ahmet6141/Drone-controller/config/px4/README.md

# PX4 v1.17 parametreleri

Tüm adlar, tipler, aralıklar ve enum değerleri resmi PX4 v1.17 parametre referansına göre
doğrulanır (`python3 tools/validate_params.py`; referans: `tools/data/px4_v1.17_params.json`).

## Yükleme sırası
1. QGroundControl → **Airframe**: *Generic Quadcopter* (`SYS_AUTOSTART=4001`) → yeniden başlat.
2. **Actuators** ekranı: çıkış protokolü **DShot600**, motor sırası ve yönleri (motor testi ile).
3. Parameters → Tools → *Load from file* — sırayla:
   1. `base/10-airframe-dc7.params` — geometri, DShot/RPM, filtreler, hover itkisi
   2. `base/20-position-control.params` — konum/hız kazançları, sınırlar, iniş
   3. `base/30-failsafe.params` — RC/link kaybı, batarya, geofence, RTL
   4. `base/40-companion-io.params` — uXRCE-DDS (TELEM2), MAVLink (TELEM1), DroneCAN akış
   5. **Bir** profil: `profiles/outdoor-gnss.params` **veya** `profiles/indoor-vio.params`
4. Kalibrasyonlar: ivmeölçer, pusula (+ akım tabanlı kompanzasyon `CAL_MAG_COMP_TYP`), ESC,
   RC; IMU sıcaklık kalibrasyonu önerilir.
5. Ölçülen montaj ofsetlerini girin: `EKF2_IMU_POS_*`, `EKF2_GPS_POS_*`, `EKF2_OF_POS_*`,
   `EKF2_RNG_POS_*`, `EKF2_EV_POS_*` (ağırlık merkezine göre, metre).

## Seviye farkları
| Konu | Seviye A — Ekonomik (Raspberry Pi) | Seviye B — Pro (bu dosyalar) | Seviye C |
|---|---|---|---|
| FC | ARK FPV (ayrı, 30×30) | ARKV6X (ARK Jetson PAB V3 yuvasında) | ARKV6X (PAB) |
| Çoklu IMU | tek IMU | `EKF2_MULTI_IMU=3`, `SENS_IMU_MODE=0` ekleyin | aynı |
| Companion bağlantısı | Pi 5 UART0 (TELEM2, DDS) + UART3 (TELEM1, MAVLink) | PAB V3 iç UART veya Ethernet (`UXRCE_DDS_CFG=1000`) | aynı |
| Akış/lazer | MicoAir MTF-01 (UART, MAVLink): `UAVCAN_SUB_FLOW/RNG` gerekmez, akış için bir MAVLink örneği (`MAV_1_CONFIG`) | H-Flow (DroneCAN) | ARK Flow MR (DroneCAN) |
| GNSS | M10 (`EKF2_GPS_CTRL=7`) | F9P RTK | X20 RTK |
| İç mekân profili | VIO yok → `indoor-vio` yerine `EKF2_EV_CTRL=0`, `EKF2_HGT_REF=0` (baro) | `indoor-vio` | `indoor-vio` |
| Hover itkisi | `MPC_THR_HOVER` ≈ 0.17 | 0.20 | 0.20 |
| Gimbal | Pi'den STorM32 (UART) — PX4'e bağlı değil (`MNT_MODE_IN=-1`) | Jetson'dan (USB-UART) | aynı |

## Seviye A seri port planı (ARK FPV)

ARK FPV'de dört çift yönlü UART vardır (GPS1, RC, TELEM1, TELEM2). TELEM3 ve TELEM4 **yalnızca veri alır**
(TX pini dışarı çıkmaz). Kaynak: PX4 v1.17 kart tanımı (`boards/ark/fpv/default.px4board`) ve ArduPilot ARK FPV
sayfası.

| PX4 portu | Soket (UART) | Bağlı | Parametre |
|---|---|---|---|
| GPS1 | GPS (USART1) + I2C | M10 GNSS + pusula | `GPS_1_CONFIG=201` |
| RC | RC (USART6) | ELRS XR4 (CRSF) | `RC_CRSF_PRT_CFG=300` |
| TELEM1 | TELEM (UART7, akış kontrollü) | Pi 5 UART3 — MAVLink | `MAV_0_CONFIG=101` |
| TELEM2 | HD VTX (UART5) | Pi 5 UART0 — uXRCE-DDS | `UXRCE_DDS_CFG=102` |
| TELEM4 | ESC soketindeki telemetri pini (UART4, yalnız RX) | MTF-01 (yalnızca gönderir). ESC'nin telemetri teli bağlanmaz; RPM çift yönlü DShot'tan gelir | `MAV_1_CONFIG=104`, `SER_TEL4_BAUD=115200` |
| TELEM3 | HD VTX soketindeki SBUS pini (USART2, yalnız RX) | boş | — |
| CAN1 | CAN | Remote ID (DroneCAN: Holybro Remote ID veya Cube ID) | `UAVCAN_ENABLE=2` |
| Motor 1–4 | ESC | Tekko32 F4 (AM32) | DShot600, `DSHOT_BIDIR_EN=1` |

Gimbal kontrolcüsü (STorM32), 8×8 ToF ve kameralar Pi'ye bağlanır; FC'den port istemez.

## Remote ID
`base/30-failsafe.params` içinde `COM_ARM_ODID=1`: Ar-Ge aşamasında Remote ID modülü yoksa yalnızca
uyarı verir. Operasyonda `2` (modülsüz kalkış yok) yapılır. PX4 belgesindeki modüller: Holybro Remote
ID ve Cube ID (seri veya CAN), BlueMark Db201/Db202mav (seri). TELEM2 DDS'e ayrıldığından seri modül
başka bir porta (`MAV_2_CONFIG`) bağlanır. **Seviye A'da (ARK FPV) boş çift yönlü seri port kalmaz** (yukarıdaki
plan): modül CAN'e bağlanır (DroneCAN, `UAVCAN_ENABLE=2`) (`config/sensors/catalog.yaml`).

## Sürüm notları (PX4 v1.18'e geçerken)
v1.18.0-rc1 (10.09.2026) kararlı değildir. v1.18'de değişecekler (kaynak: PX4 v1.18 sürüm notları):
- `DSHOT_BIDIR_EN`, `MOT_POLE_COUNT` → çıkış başına protokol ve `DSHOT_MOT_POL1..12`
- `COM_RC_OVERRIDE` / `COM_RC_STICK_OV` → `MAN_OVERRIDE_SPD`
- `EKF2_GPS_POS_*` / `EKF2_GPS_DELAY` → alıcı başına parametreler
- Yeni: `EKF2_SENS_EN`, Vision Target Estimator (`VTE_*`)

Geçişte `tools/data/` altına v1.18 referansı eklenip dosyalar yeniden doğrulanmalıdır.
