ahmet6141/Drone-controller/docs/02-donanim-analizi.md

# 02 — Donanım Analizi ve Seçim

Durum tarihi: **2 Ekim 2026**. Fiyatlar yaklaşık (USD) ve değişkendir; NVIDIA Temmuz 2026'da
Jetson fiyatlarını %101'e varan oranda artırdı. Seviyelerin tam bileşen listeleri ve kütle/güç
değerleri [`config/hardware/`](../config/hardware/) altındadır; bütçe tablosu
`tools/budget_calc.py` ile bu dosyalardan üretilir.

## 1. Özet: üç donanım seviyesi

| Bileşen | **Seviye A — Ekonomik (Raspberry Pi)** | Seviye B — Pro (Jetson) | Seviye C — Üst Seviye |
|---|---|---|---|
| Gövde | GEPRC MOZ7 V2 (336 mm) + tam koruma/ağ + avuç tutamağı | ← aynı | ← aynı |
| Motor / pervane | EMAX ECO II 2807 1300KV / HQ 7×4×3 | T-Motor F90 2806.5 1300KV / HQ 7×4×3 | ← B |
| ESC | Tekko32 F4 50A (AM32) | Tekko32 F4 Metal 65A (AM32) | ARK 4IN1 50/75 A |
| Batarya | 6S1P Molicel P50B (5 Ah, 451 g) | ← aynı | ← aynı (dayanım: 6S2P) |
| Uçuş kontrolcüsü | ARK FPV (H743, endüstriyel IMU + ısıtıcı) | ARKV6X (3 IMU, PAB yuvasında) | ← B |
| Companion | **Raspberry Pi 5 8GB + AI HAT+ 2 (Hailo-10H)** | Jetson Orin NX 16GB + ARK Jetson PAB V3 | Orin NX 16GB (MAXN SUPER) + PAB V3 |
| Gimbal | **Kendi tasarımımız 2 eksen** (STorM32) — docs/10 | ← aynı | ← aynı |
| Gimbal kamerası | **Pi Camera Module 3** (66°) | IMX219 (Pi Camera Module 2 / eşdeğeri) | ← B |
| Aşağı kamera / ToF | **Camera Module 3 Wide** / VL53L8CX 8×8 | OV9281 global shutter / VL53L8CX | ← B |
| Baş üstü ToF | VL53L1X | VL53L1X | VL53L1X |
| Stereo (VIO + engel) | — | OAK-D Lite | OAK-D Pro W (150°) |
| Akış + lazer | MicoAir MTF-01 (akış + 8 m lazer, UART) | Holybro H-Flow (DroneCAN) | ARK Flow MR (DroneCAN) |
| GNSS / pusula | Holybro M10 | H-RTK F9P Ultralight + RM3100 | ARK X20 RTK + ARK MAG |
| RC | TX15 + XR4 (ELRS 4.1) | TX16S MK3 + XR4 | ← B |
| Video/veri linki | WFB-ng (açık kaynak) | SIYI HM30 | Doodle Labs mini-OEM (mesh) |
| Uçuş yığını | PX4 v1.17 | PX4 v1.17 | PX4 v1.17 |

Kameralar artık hazır gimbal kamera (SIYI A8 mini) yerine **Raspberry Pi kameraları + kendi
tasarımımız gimbal** (ayrıntılar ve gerekçeler: [10](10-kamera-gimbal-ve-sensorler.md)). Pi
kameralarıyla en uyumlu ve en ucuz yol Raspberry Pi 5'tir; Jetson'da NVIDIA'nın belgelediği Pi
kamerası IMX219'dur ve 22 pin FFC girişli taşıyıcı (ARK Jetson PAB V3) gerekir.
**Önerilen başlangıç: Seviye A.**

## 2. Ağırlık, güç ve uçuş süresi bütçesi

`python3 tools/budget_calc.py --all --markdown` çıktısı (F90 itki verisi, log-log enterpolasyon,
koruma/gövde kaybı %10, kullanılabilir enerji %85, yük altında gerilim %90):

| Metrik | tier-a-ekonomik | tier-b-pro | tier-c-ust |
|---|---:|---:|---:|
| AUW (g) | 1456 | 1683 | 1659 |
| Batarya (g) | 451 | 451 | 451 |
| Maks itki (g) | 8500 | 8500 | 8500 |
| T/W (motor) | 5.84 | 5.05 | 5.12 |
| T/W (batarya sınırlı) | 2.77 | 2.37 | 2.40 |
| Hover itkisi/motor (g) | 364 | 421 | 415 |
| Hover verimi (g/W) | 5.76 | 5.42 | 5.45 |
| Hover gazı (MPC_THR_HOVER) | 0.17 | 0.20 | 0.20 |
| Hover gücü (W) | 275 | 354 | 355 |
| Hover akımı (A) | 12.7 | 16.4 | 16.4 |
| Hover süresi (dk) | 20.1 | 15.6 | 15.5 |
| Karma uçuş (dk) | 17.0 | 13.2 | 13.2 |
| Ek yük payı (g) | 379 | 132 | 149 |
| THR_MDL_FAC (tahmini) | 0.53 | 0.53 | 0.53 |
| Maliyet: hava aracı (USD, ≈) | 1,488 | 4,906 | 6,720 |
| Maliyet: yer ekipmanı (USD, ≈) | 240 | 200 | 1,505 |
| Limit kontrolleri | ✅ | ✅ | ✅ |

- **Korumanın bedeli**: koruma ve ağ olmadan Seviye A 1346 g / 23,8 dk, Seviye B 1573 g / 18,1 dk
  → koruma ≈ 2,5–3,5 dk.
- **Dayanım seçeneği** (Seviye C, 6S2P P50B, 902 g): AUW 2110 g, hover **23,0 dk**, batarya
  sınırlı T/W 2,83. Ağırlık nedeniyle bu yapılandırmada avuca iniş yalnızca işaretli pedle önerilir.
- Seviye B'nin maliyeti, Pi kameraları için gereken 22 pin FFC'li taşıyıcı (ARK Jetson PAB V3 +
  ARKV6X) nedeniyle arttı; daha ucuz alternatif Holybro Pixhawk Jetson Baseboard + Pixhawk 6X
  (≈ $535 daha ucuz, ≈ 43 g daha ağır).
- T/W (motor) ≈ 5 → bol kontrol otoritesi; asıl sınır bataryanın sürekli akımıdır (60 A).
- Maliyetler yaklaşık, vergi/kargo hariç; Jetson (Temmuz 2026) ve Raspberry Pi (Şubat 2026) fiyat
  artışları sonrası.

## 3. Gövde (frame)

| Gövde | Dingil / kol | Kütle | Stack | Fiyat | Not |
|---|---|---|---|---|---|
| **GEPRC MOZ7 V2** | 336 mm / 6 mm | 270 g | 30,5 / 25,5 / 20 | ~$110 | 8 inç pervane alır → 7 inç etrafında koruma halkasına radyal yer kalır. **Tüm seviyelerde seçildi** |
| iFlight Chimera7 Pro V2 | 327 mm / 6 mm | 175 g (TPU hariç) | 21 mm yükseklik | €137 | Bazı satıcılarda tükendi; yeni Chimera7 O4 355 g |
| TBS Source One V5 7 DC | 320 mm / 6 mm | ~145 g | 30,5 / 20 | $45 | Deadcat, açık kaynak; stok sorunu |
| Foxeer MEGA 7 DC | 305 mm / 5,5 mm | 221 g | 30,5 (+ arka) | — | Deadcat |
| iFlight CineLR 7 (hazır referans) | 334 mm, H | 777 g kuru; 8 Ah Li-ion ile 1628 g | — | $740 | 800 g önerilen yük, ~25 dk hover iddiası |

- Hiçbir FPV 7 inç gövde Jetson için tasarlanmamış → **özel üst plaka** (karbon/PA12-CF) gerekli.
- **Gerçek-X (true-X)** seçildi: simetrik tam koruma, yönetilebilir ağırlık merkezi; gimbal ön
  burunda alçakta (Camera Module 3: 66° yatay FOV). `cad/layout.py` görüş kontrolüne göre pitch
  −90°…+15° arası korumalar/pervaneler kadraja girmez → yazılım sınırı +15°. Deadcat temiz görüş
  sağlar ama asimetriktir ve korumalanması zordur.

## 4. İtki

### 4.1 Motorlar (6S, 7 inç)
| Motor | KV | Kütle | Azami | Fiyat | Not |
|---|---|---|---|---|---|
| **T-Motor F90 2806.5** | 1300 | 46,6 g | 2361 g @ 45 A (HQ 7×4×3) | $30 | Ölçülmüş itki verisi var; bazı satıcılarda üretimden kalktı |
| EMAX ECO II 2807 | 1300 | 47,6 g | 2640 g (6S) | ~$22 | Ekonomik seçim |
| EMAX ECO III 2807 | 1300 | 49,6 g | 1390 W, 55 A | — | F90 alternatifi |
| Axisflying C287 2807.5 | 1350 | 47 g | 2303 g, 48,6 A | $29 | F90 alternatifi |
| iFlight XING2 2809 | 1250 | 60,7 g | 1145 W, 50 A | $40 | 7,5 inç / ağır yük |
| T-Motor 2807 (2026) | 1250 | 52,6 g | 2178 g @ 44 A (7,5 inç) | — | Yeni liste |

### 4.2 Ölçülmüş itki verisi (bütçe hesabının temeli)
T-Motor F90 1300KV + HQProp 7×4×3, 24,2 V (güç = V×I, ESC girişi):

| Gaz | İtki | Akım | Güç | g/W |
|---|---|---|---|---|
| %30 | 353 g | 2,14 A | 52 W | **6,80** |
| %50 | 948 g | 8,83 A | 213 W | 4,45 |
| %100 | 2361 g | 45,1 A | 1059 W | 2,23 |

İki kanatlı GF 7040 %30'da 320 g / 43 W (**7,39 g/W**) ile hover'da daha verimlidir; HQ 7×4×3
daha fazla kontrol otoritesi verir. Ara noktalar log-log (güç yasası) enterpolasyonla hesaplanır.
Seviye A'da ECO II için de bu eğri **vekil** olarak kullanılmıştır; itki standında doğrulanacak.

### 4.3 ESC
| ESC | Sürekli / tepe | Hücre | Firmware | Telemetri | Kütle | Fiyat | Seviye |
|---|---|---|---|---|---|---|---|
| Holybro Tekko32 F4 50A | 50 / 60 A | 4–6S | AM32 | Bidirectional DShot, ESC telemetrisi, akım sensörü | 13,8 g | $63 | A |
| **Holybro Tekko32 F4 Metal 65A** | 65 / 75 A | 4–6S | AM32 | aynı | 15,8 g | $95 | **B** |
| ARK 4IN1 | 50 / 75 A | 3–8S | ARK32 (açık kaynak) | DShot300/600 + bidir, KISS seri telemetri | 14,5 g | $218,50 | C |
| T-Motor F55A Pro III (AM32) | 55 / 65 A | 3–8S | AM32 | telemetri | 17,8 g | $150 | — |

Firmware durumu: **BLHeli_32 Haziran 2024'te sona erdi**; **AM32** aktif (v2.20–2.21, Tem–Eyl 2026:
fren modları, DroneCAN parametre kaydı); Bluejay'in son kararlı sürümü v0.21.0 (Temmuz 2024).
→ AM32 seçildi; avuca iniş için "durunca fren" açık. DroneCAN ESC bu boyutta gereksiz:
bidirectional DShot notch filtresi için en düşük gecikmeli RPM geri bildirimini verir.

## 5. Batarya

| Hücre | Kapasite | Sürekli akım | Kütle | Not |
|---|---|---|---|---|
| Molicel P45B | 4,5 Ah | 45 A | ≤ 70 g | |
| **Molicel P50B** | 5,0 Ah | 60 A | 71 g | **Seçildi (6S1P ≈ 451 g)** |
| Molicel P60B (06/2025) | 6,0 Ah | "90 A" (basın bülteni) | — | Gelecek yükseltme adayı |
| Samsung 50S | 5,0 Ah | 25 A | ≤ 72 g | Akım sınırı düşük |
| Amprius SA112 | 6,5 Ah | 13 A | 72 g | 6S1P için akım yetersiz |

- 6S1P P50B: 108 Wh nominal, hover akımı ≈ 14–17 A (hesap) → hücrenin 60 A sınırına göre rahat.
- Yedek LiPo (ör. 6S 2000 mAh, 339 g) ≈ yarı uçuş süresi; yalnızca agresif test uçuşları için.
- Uçuş kontrolcüsünde batarya akımı **45–60 A** ile sınırlanır (dört motor tam gazda ≈ 180 A çekebilir).

## 6. Companion bilgisayar

### 6.1 Platformlar
| Platform | YZ (seyrek INT8) | RAM | Güç | Fiyat (1k adet) | Değerlendirme |
|---|---|---|---|---|---|
| **Raspberry Pi 5 8GB + AI HAT+ 2** | Hailo-10H: 40 TOPS (INT4) | 8 GB + 8 GB (HAT) | ≈ 10 W (tahmini) | $175 + $200 | **Seviye A**. Pi kameraları yerel; donanım video kodlayıcı yok; 0–70 °C; üretim ≥ 2036 |
| Raspberry Pi Zero 2 W (+ AI Camera) | Hızlandırıcı yok: CPU'da YOLO11n ≈ 0,3 FPS (NCNN, 640). AI Camera (IMX500, çip üstü) ile YOLO11n ≈ 17 FPS | 512 MB | ≈ 2–3 W (tahmini) | $15 + $70 | **Elendi.** Tek kamera girişi (tasarım iki kamera ister), PCIe yok (AI HAT takılamaz), 2 UART, tek USB. AI Camera'da aynı anda tek model çalışır; el iskeleti, SOT ve ReID CPU'ya kalır. Tek kameralı küçük demolar ve video vericisi (donanım H.264) için uygun |
| Jetson Orin Nano 8GB (Super) | 67 TOPS | 8 GB | 7–25 W + MAXN SUPER | $399 (önce $299) | Geliştirme kiti / alternatif. DLA yok, **donanım video kodlayıcı yok** (NVENC) |
| Jetson Orin NX 8GB | 117 TOPS | 8 GB | 10–40 W | $649 | — |
| **Jetson Orin NX 16GB** | 157 TOPS | 16 GB | 10–40 W + MAXN SUPER | $999 (önce $599) | **Seviye B/C**. Donanım H.265 kodlama; algı + VIO + küçük VLM birlikte sığar |
| Jetson T4000 / T5000 (Thor) | 1200 / 2070 FP4 TFLOPS | 64 / 128 GB | 40–130 W | $2999+ | 100×87 mm, güç → 7 inç için uygun değil |
| Jetson T2000 (duyuru 15.07.2026) | 400 FP4 TFLOPS | 16 GB | ~40 W | — | **Q1 2027**; ~50×87 mm, yeni taşıyıcı gerekir → gelecek yükseltme yolu |
| ModalAI VOXL 2 Mini | 15 TOPS | 8 GB | 0,5–8 W | $1350 | 11 g, PX4 + VIO dahili; Ubuntu 18.04, TFLite; YOLO çoğu zaman CPU'ya düşüyor |
| ModalAI VOXL 3 (QCS6490) | 12 TOPS | 8 GB | 0,1–6 W | — | 16 g, 2S–6S doğrudan; belgeli ama mağaza sayfası yok |
| Luxonis OAK 4 D / S | 48 TOPS | 8 GB | 10–25 W | $849 / $749 | 674 / 325 g → çok ağır |

### 6.2 Taşıyıcı kartlar (Orin Nano / NX)
| Kart | Kütle | Giriş | Öne çıkan | Fiyat |
|---|---|---|---|---|
| Auvidea JNX120X (01/2026) | 47,2 g | 12–24 V (6S tam şarjda 25,2 V → 12 V BEC) | 5 portlu GbE switch (3 harici), 3 UART, CAN, PAB yuvası; kamera girişi **micro-coax** → Pi kameraları doğrudan takılamaz | €349 |
| **ARK Jetson PAB V3** (06/2026) | 66 g | 5 V, ≥ 4 A (çok girişli) | **2× 22 pin FFC kamera** (Pi kameraları), PAB yuvası (ARKV6X), Ethernet switch | $800 → **Seviye B/C** |
| Connect Tech Hadron-DM | 56 g | 9–60 V (6S doğrudan) | −25…+85 °C | — |
| WeAct N006 (06/2026) | 57,8 g | 16–28 V (6S) | Yalnızca Orin NX; 0–40 °C | $110 |
| Holybro Pixhawk Jetson Baseboard | 85 g (+Jetson 110, +soğutucu 175 g) | 7–21 V | Pixhawk 6X ile birleşik | $396 |

Orin modülü ≈ 25–28 g, soğutucu ≈ 50–65 g (taşıyıcı tablolarından türetilmiştir).

### 6.3 Yazılım yığını (Ekim 2026)
| Bileşen | Sürüm | Not |
|---|---|---|
| **JetPack 7.2.1** (11.08.2026) | Ubuntu 24.04, CUDA 13.2.2, TensorRT 10.16.2, DeepStream 9.1 | 7.2 (02.06.2026) ile **Orin desteği geldi** — seçildi |
| JetPack 6.2.3 (12.08.2026) | Ubuntu 22.04, TensorRT 10.3 | NMS'siz YOLO26 INT8 motoru derlenemiyor → yalnızca yedek |
| ROS 2 **Jazzy** | LTS, ömür sonu 05/2029 | JetPack 7.2 ile eşleşir. **Not**: PX4 v1.17 belgesi resmi platform olarak Humble/Ubuntu 22.04'ü önerir; PX4 main (v1.18) belgesi Jazzy/24.04'ü önerir → Jazzy seçildi, sorun çıkarsa Humble Docker kapsayıcısı yedek |
| ROS 2 Lyrical (22.05.2026) | Ana platform Ubuntu 26.04 | Isaac ROS 5.0 ile geldi; Faz 5'te değerlendirilecek |
| **Isaac ROS 4.6** (18.08.2026) | Orin + JetPack 7.2 + Jazzy | Seçildi (cuVSLAM, NITROS) |
| Isaac ROS 5.0 (21.09.2026) | ROS 2 Lyrical | Sonraki yükseltme |
| Micro XRCE-DDS Agent | v2.4.3 | PX4 v1.17 belgesinin kurduğu sürüm (v3.x uyumsuz) |

> **DLA riski**: TensorRT belgeleri DLA desteğinin 10.7'de bittiğini belirtiyor; Orin'de
> JetPack 7.2 ile DLA'nın çalışıp çalışmadığı doğrulanmadı. Bütçe hesabında DLA TOPS'u sayılmaz.

## 7. Uçuş kontrol yığını ve hassas hover sensörleri

### 7.1 Yığın: PX4 v1.17 (birincil) — ArduPilot 4.7.1 (yedek)
| Konu | **PX4 v1.17.0** (13.05.2026) | ArduPilot Copter 4.7.1 (31.08.2026) |
|---|---|---|
| ROS 2 özel modlar | `px4-ros2-interface-lib`: ROS 2'den kaydedilen **gerçek uçuş modları**, failsafe entegrasyonu, yanıt vermezse yedek mod (hâlâ "deneysel") | Lua `register_custom_mode` + DDS `cmd_vel` (yalnızca guided tipi modlar, arm'lıyken) |
| Hover araçları | RPM notch, hover itki tahmincisi, autotune | Zengin notch seçenekleri, QuikTune → AutoTune, Filter/PID Review |
| Gimbal (kendi tasarımımız, STorM32) | PX4'e bağlı değil → companion UART ile sürer | Yerel STorM32 sürücüsü (`MNT1_TYPE`=4 MAVLink / 5 seri) |
| Takip | Follow-Me yalnızca `FOLLOW_TARGET`, `FLW_TGT_HT` ≥ 8 m, görüntü yok → **özel mod şart** | Follow modu, görüntü yok |
| Lisans | **BSD-3** (kapalı ürün dostu) | GPLv3 (dağıtılan firmware kaynağı açılır; companion kodu kapalı kalabilir) |
| Not | v1.18.0-rc1 (10.09.2026) kararlı değil; v1.18'de bazı adlar değişiyor | 4.7'de birçok parametre SI birime geçti ve yeniden adlandırıldı |

Karar: **PX4 v1.17** birincil; FC'ler her iki yığını da çalıştırabilen kartlardan seçildi.

### 7.2 Uçuş kontrolcüleri
| FC | MCU | IMU | Baro | Yığın | Montaj | Kütle | Fiyat | Not |
|---|---|---|---|---|---|---|---|---|
| **ARK FPV** | H743 | IIM-42653 (endüstriyel) + 1 W ısıtıcı | BMP390 | PX4 (varsayılan), AP 4.7 | 30,5 | 7,5 g | $195 | 1 CAN, 9 PWM (1–4 çift yönlü DShot), 12 V/2 A BEC, 5,5–54 V; 4 çift yönlü UART + 2 yalnız RX → Remote ID CAN'de ([port planı](../config/px4/README.md)) → **A** |
| **ARKV6X** | H743 | 2× ICM-42688-P + IIM-42652, ısıtıcı | BMP390 | PX4, AP | PAB modül | 5 g | $400 | PAB taşıyıcıda (ARK Jetson PAB V3) → **B, C** |
| Pixhawk 6C Mini | H743 + IO | ICM-42688-P + BMI088 (ısıtmalı, izoleli) | MS5611 | PX4, AP | 54×39 | 42,4 g | $131 | 2 CAN; A alternatifi |
| Pixhawk 6X Rev8 | H753 + IO | 3× ICM-45686 (ısıtmalı, izoleli) | ICP20100 + BMP388 | PX4, AP | modül | 31,3 g + 26,5 g taban | $269 / $389 | Ethernet (DDS) — C alternatifi |
| Matek H743-SLIM V4 | H743 | 2× ICM42688P | DPS368 | AP birinci sınıf; PX4 yalnızca derleme hedefi | 30,5 | 7 g | £85 | ArduPilot yolu |
| Holybro Kakute H7 v2 | H743 | BMI270 | BMP280 | PX4, AP | 30,5 | 8 g | $52 | PX4'te bidirectional DShot **yok** → elendi |
| ModalAI VOXL 2 Mini | QRB5165 | 2× ICM-42688-P | ICP-10100 | PX4 (üretici), AP | 30,5 | 11 g | $1350 | Jetson'ın yerini alan alternatif mimari |

### 7.3 Optik akış ve mesafe sensörleri
| Modül | Özellik | Arayüz | Kütle | Fiyat | Seviye |
|---|---|---|---|---|---|
| MicoAir MTF-01 | Akış (> 8 cm) + ToF 8 m, 2 cm ölü bölge, 100 Hz | UART (MAVLink/MSP) | 4,5 g | doğrulanmadı | A |
| **Holybro H-Flow** | PAA3905E1 + AFBR-S50LV85D + ICM-42688-P | DroneCAN | 15,2 g (çıplak 3,5 g) | $145 | **B** |
| **ARK Flow MR** | PAA3905 + IR LED, AFBR-S50LX85D (50 m, 2°) + IIM-42653 | DroneCAN | 5 g | $350 | C |
| Benewake TFmini-S | 0,1–12 m, 70 klux | UART/I2C | 5 g | $73 | — |

TF-Luna (0,2 m) ve TFmini-S (0,1 m) kör bölgeleri avuca inişin son santimleri için uygun değil →
son yaklaşma tutamaktaki kendi ToF sensörümüzle (VL53L8CX / VL53L1X) yapılır.

### 7.4 GNSS ve pusula
| Modül | Özellik | Kütle | Fiyat | Seviye |
|---|---|---|---|---|
| Holybro M10 | u-blox M10 + IST8310 | 32 g | $44 | A |
| ARK SAM GPS | SAM-M10Q + IIS2MDC | 11 g | $75 | — |
| **Holybro H-RTK F9P Ultralight** | ZED-F9P RTK | < 25 g | $279 | **B** |
| **ARK X20 RTK** | ZED-X20P, L1/L2/L5/E6, 25 Hz, RTK/PPP-RTK | 13 g (antenle 43,5 g) | $695–780 | C |
| Holybro H-RTK UM982 | Çift antenli yön (heading) | 40,3 g (antensiz) | $250 | ≥ 30 cm anten aralığı → 7 inçte sınırda |
| ARK G5 | Septentrio mosaic-G5 | 13 / 43,5 g | $745–835 | — |
| Pusula | Holybro DroneCAN RM3100 ($66) · ARK MAG RM3100 (3 g, $175) | | | B · C |

GNSS, pusula ve akış/lidar **DroneCAN** üzerinde (tek veri yolu yeterli); UART'lar Jetson
(uXRCE-DDS + MAVLink) ve RC alıcısı için ayrılır.

## 8. Kameralar ve mesafe sensörleri

### 8.1 Gimbal ve gimbal kamerası
| Seçenek | Özellik | Kütle | Fiyat | Not |
|---|---|---|---|---|
| **Kendi gimbalımız (2 eksen) + Pi Camera Module 3** | 66° yatay, 12 MP, PDAF; pitch + roll fırçasız, yaw gövdeyle | ≈ 89 g | ≈ $120 | **Seçildi (A)**; Jetson'da IMX219 ile (B/C) — tasarım: [10 §3](10-kamera-gimbal-ve-sensorler.md) |
| SIYI A8 mini (hazır) | 3 eksen; 4K/2K/1080p @ 25 fps; 81° yatay; Ethernet RTSP + SDK | 95 g | $257 | Hazır alternatif: 4K SD kayıt ve optik kalite daha iyi, ama RTSP gecikmesi ve maliyet |
| XF Z-1 Mini | 3 eksen; 4K30 akış, 1080p kayıt | 69 g | €395 | Hazır, hafif alternatif |
| Tek eksen servo + EIS | Yalnızca tilt | ≈ 25 g | ≈ $15 | İlk prototip uçuşları için |

### 8.2 Aşağı kamera (avuç)
| Kamera | Özellik | Not |
|---|---|---|
| **Raspberry Pi Camera Module 3 Wide** | 102° yatay, 720p120, 4 g | **Seviye A** (Pi 5) |
| **Arducam OV9281** | **Global shutter**, 1280×800, mono | **Seviye B/C** (Jetson sürücülü) |
| Raspberry Pi Global Shutter (IMX296) | 60 fps, global, 34 g + C/CS lens | Bulanıklık yok ama tutamak için ağır |
| IMX219-160° | Rolling shutter, renkli | Ucuz alternatif |

### 8.3 ToF (avuç mesafesi + baş üstü boşluk)
| Sensör | Bölge | Menzil | FOV | Not |
|---|---|---|---|---|
| VL53L1X | Tek | ~4 m | ~27° | Yukarı bakan boşluk sensörü; PX4 yerel sürücü |
| VL53L7CX | 8×8 | 3,5 m | 90° D (60°×60°) | Geniş açı |
| **VL53L8CX** | 8×8 / 4×4 | 4 m | 65° D (45°×45°) | 5 klux'ta 2,8 m; I2C/SPI; Pololu kartı 0,7 g, $24,95 → **tüm seviyeler, aşağı** |
| VL53L9 (26.06.2026) | 54×42 | 5 cm–9 m | 54°×42° | 100 fps, MIPI; seri üretim 07/2026, kart erişimi doğrulanmadı → gelecek |

### 8.4 Stereo / derinlik (VIO + engel)
| Kamera | Derinlik FOV | Menzil | Kütle | Fiyat | Not |
|---|---|---|---|---|---|
| **OAK-D Lite** | 73° yatay | 0,4–8 m | 61 g | $269 | Global shutter stereo + IMU → **Seviye B** |
| **OAK-D Pro W** | 150° D | — | 91 g | $529 | Geniş açı + IR aydınlatma → **Seviye C** |
| Orbbec Gemini 336 | 90°×65° | 0,1–20 m | 99 g | $392 | IMU, IR geçiren filtre (dış mekân); B alternatifi |
| RealSense D435i | 87°×58° | 0,3–3 m | ~72 g | ~£434 | Cognex 22.09.2026'da satın alma anlaşması → **tedarik riski** |
| ZED X Mini | 110°×80° | 0,1–8 m | 150 g + GMSL2 kartı | $549 + $379 | Ağır |

## 9. Haberleşme

### 9.1 RC
- **ExpressLRS 4.1.0** (17.07.2026): Gemini/çift bant LR1121, otomatik anten çeşitliliği;
  MAVLink modu 3.5'ten beri var (RC linkinden yedek telemetri).
- Verici: RadioMaster TX16S MK3 ($200; dahili 2,4 GHz + 900 MHz Gemini) veya TX15 (~$140–182).
- Alıcı: RadioMaster XR4 (1,7 g, çift LR1121).
- Türkiye'de 900 MHz bandında **868 MHz (EU) düzenleme alanı** kullanılmalıdır (bkz. [08](08-guvenlik-ve-mevzuat.md)).

### 9.2 IP video + telemetri linki
| Link | Menzil | Gecikme | Hava ünitesi | Fiyat | Not |
|---|---|---|---|---|---|
| **SIYI HM30** | 20 km | 180–250 ms | 74 g | — | LAN girişi + UART telemetri; companion video akışının taşınması **doğrulanacak** → Seviye B |
| Herelink 1.1 | 20 km | ~110 ms | 68 g | — | v1.1'de Ethernet |
| **Doodle Labs mini-OEM** | 80+ km (üretici) | — | 25 g | $1305 | Şeffaf IP radyo, 80 Mbps, mesh → Seviye C |
| WFB-ng (companion + RTL8812AU/EU) | ~20 km (yönlü antenle) | düşük | ~20 g | düşük | Açık kaynak, çift yönlü MAVLink + IP tüneli; **BTK güç sınırları** → Seviye A |
| OpenIPC | — | 80–100 ms @ 60 fps | — | — | Kendi kamerası; YZ katmanı zor |

## 10. Uzaktan tanımlama (Remote ID)
SHT-İHA Md. 23(7) gereği zorunlu. PX4'ün Open Drone ID desteğiyle uyumlu bir yayın modülü
(MAVLink veya DroneCAN) BOM'a eklenmiştir (≈ 10 g). İHATTYS'in ağ tabanlı tanımlama arayüzü
yayımlandığında entegrasyon güncellenecektir.

## 11. Tedarik ve fiyat riskleri
| Risk | Etki | Önlem |
|---|---|---|
| Jetson fiyat artışı (07/2026) | Seviye B/C maliyeti | Geliştirme Seviye A (Raspberry Pi) ile; Jetson yalnızca B/C |
| Raspberry Pi bellek kaynaklı fiyat artışı (02/2026; 8GB +$30) | Seviye A maliyeti | 4GB Pi 5 de yeterli olabilir (ölçülecek) |
| Pi kameralarının Jetson desteği sınırlı (resmî: IMX219) | B/C kamera seçimi | B/C'de IMX219 + OV9281; 22 pin FFC'li taşıyıcı |
| T-Motor F90 bazı satıcılarda üretimden kalktı | Motor tedariki | ECO III 2807 / Axisflying C287 eşdeğerleri; itki standında doğrulama |
| RealSense'in Cognex'e satışı | Yol haritası belirsiz | OAK-D / Orbbec tercih edildi |
| VOXL 3 mağazada yok | — | Yalnızca alternatif mimari olarak not edildi |
| Jetson T2000 Q1 2027 | — | Gelecek yükseltme; yeni taşıyıcı gerekir |

## 12. Kaynaklar (seçme)
- Jetson: https://developer.nvidia.com/embedded/jetpack/downloads · https://developer.nvidia.com/embedded/faq · https://www.cnx-software.com/2026/07/16/nvidia-jetson-t2000-and-t3000-modules-for-edge-ai-and-robotics-applications/
- Isaac ROS: https://nvidia-isaac-ros.github.io/releases/index.html · PX4 ROS 2: https://docs.px4.io/main/en/ros2/user_guide
- Taşıyıcılar: https://auvidea.eu/product/jnx120x-drone-carrier-board/ · https://arkelectron.com/product/ark-jetson-pab-v3/ · https://connecttech.com/ftp/pdf/NGX024_Hadron_DM.pdf · https://www.cnx-software.com/2026/06/30/weact-n006-a-compact-nvidia-jetson-orin-nx-carrier-board-designed-for-robots-and-uavs/
- Gövde/motor: https://rotorvillage.ca/geprc-moz7-v2-frame-kit/ · https://www.ligpower.com/product/f90-fpv-motor.html · https://shop.iflight.com/CineLR-7-6S-HD-Pro2265
- Batarya: https://akkuteile.de/en/lithium-ionen-battery/size-21700/molicel/molicel-inr21700-p50b-5000mah-60a-3-6-3-7v-li-ion-battery_100638_3507 · https://amprius.com/documents/Amprius_Product_Catalog.pdf
- Kameralar: https://res.siyi.biz/oss/other/2026/06/15/A8_mini_User_Manual_v1_10_563cde30.pdf · https://docs.arducam.com/Nvidia-Jetson-Camera/Jetvariety-Camera/OV9281/ · https://www.pololu.com/product/3419 · https://checkout.luxonis.com/products/oak-d-lite-1 · https://www.orbbec.com/products/stereo-vision-camera/gemini-336/
- Uçuş yığını: https://docs.px4.io/main/en/releases/1.17.html · https://docs.px4.io/main/en/ros2/px4_ros2_control_interface.html · https://github.com/ArduPilot/ardupilot/blob/master/ArduCopter/ReleaseNotes.txt · https://ardupilot.org/copter/docs/parameters-Copter-stable-V4.7.1.html
- FC/ESC/sensör: https://arkelectron.com/product/ark-fpv-flight-controller/ · https://arkelectron.com/product/arkv6x/ · https://holybro.com/products/tekko32-f4-metal-4in1-65a-esc-65a · https://arkelectron.com/product/ark-4in1-esc/ · https://github.com/am32-firmware/AM32/releases · https://holybro.com/products/h-flow · https://arkelectron.com/product/ark-flow-mr/ · https://arkelectron.com/product/ark-x20-rtk-gps/ · https://holybro.com/products/h-rtk-f9p-ultralight
- Linkler: https://github.com/ExpressLRS/ExpressLRS/releases · https://www.siyi.biz/en/product/image-digital-link/hm30/spec/ · https://docs.px4.io/main/en/companion_computer/video_streaming_wfb_ng_wifi
- RealSense/Cognex: https://www.sec.gov/Archives/edgar/data/0000851205/000085120526000071/exhibit991-pressrelease.htm
- Zero 2 W ve AI Camera: https://www.raspberrypi.com/products/raspberry-pi-zero-2-w/ · https://www.raspberrypi.com/documentation/accessories/ai-camera.html · https://docs.ultralytics.com/integrations/sony-imx500/ · https://mjrovai.github.io/EdgeML_Made_Ease_ebook/raspi/object_detection/cv_yolo.html
- ARK FPV portları ve Remote ID: https://docs.px4.io/v1.17/en/flight_controller/ark_fpv · https://ardupilot.org/copter/docs/common-ark-fpv.html · https://github.com/PX4/PX4-Autopilot/blob/v1.17.0/boards/ark/fpv/default.px4board · https://docs.px4.io/v1.17/en/peripherals/remote_id
