ahmet6141/Drone-controller/docs/04-sistem-mimarisi.md

# 04 — Sistem Mimarisi

## 1. Tasarım ilkeleri

1. **"YZ önerir, uçuş kontrolcüsü karar verir."** Motorlara yalnızca uçuş kontrolcüsü (FC, PX4)
   komut verir. Companion bilgisayar (Raspberry Pi 5 veya Jetson) yalnızca *setpoint* (hız/konum/yaw) üretir; PX4'ün
   failsafe'leri, iniş algılayıcısı ve RC önceliği hiçbir durumda devre dışı bırakılmaz.
2. **RC her zaman kazanır.** Mod anahtarı ve kill switch, companion'dan bağımsız olarak çalışır.
3. **Katmanlı güvenlik.** Her riskli davranış (avuca iniş, takip) en az iki bağımsız sensörle
   doğrulanır ve kendi iptal (abort) mantığına sahiptir.
4. **Gerçek zamanlılık ayrımı.** Sert gerçek zamanlı işler (kestirim, stabilizasyon, motor) FC'de;
   yumuşak gerçek zamanlı işler (algı, davranış, 10–50 Hz) companion'da.
5. **Simülasyon önce.** Her davranış önce PX4 SITL + Gazebo'da, sonra pervanesiz tezgâhta,
   sonra bağlı (tether) uçuşta test edilir.

## 2. Katmanlar

```mermaid
flowchart TB
  subgraph G["Yer katmanı"]
    QGC["QGroundControl<br/>telemetri, mod, parametre, video"]
    UI["Hedef seçim arayüzü<br/>(tıkla-takip et)"]
    TX["RC verici (ELRS)<br/>mod anahtarı + kill switch"]
  end
  subgraph C["Otonomi ve algı katmanı — Companion (Raspberry Pi 5 veya Jetson, ROS 2)"]
    PER["Algı<br/>tespit, takip, jest, avuç"]
    NAV["VIO / görsel odometri"]
    BEH["Davranış yöneticisi<br/>(durum makinesi)"]
    MODES["Özel PX4 modları<br/>Avuca İniş, Hedef Takip"]
    SAFE["Güvenlik izleyici"]
  end
  subgraph F["Uçuş kontrol katmanı — FC (PX4)"]
    EKF["EKF2 kestirimci"]
    CTRL["Konum/hız/tutum/oran kontrolcüleri"]
    FS["Failsafe + iniş algılayıcı"]
    OUT["Motor çıkışı (bidirectional DShot)"]
  end
  TX -- "CRSF" --> F
  QGC <-- "MAVLink (IP link)" --> F
  UI <-- "IP link" --> C
  C <-- "uXRCE-DDS (ROS 2)" --> F
  PER --> BEH --> MODES --> F
  NAV --> EKF
  SAFE --> BEH
```

## 3. Donanım blok diyagramı

```mermaid
flowchart LR
  BAT["6S batarya"] --> PM["Güç modülü<br/>(V/I ölçüm)"]
  PM --> ESC["4'ü 1 arada ESC<br/>AM32, bidirectional DShot"]
  PM --> B12["BEC 12 V / 5 A"]
  PM --> B5["BEC 5 V / 3 A (FC)"]
  ESC --> MOT["4× motor + 7 inç pervane<br/>(tam koruma)"]
  B5 --> FC["Uçuş kontrolcüsü<br/>STM32H7, 2–3 IMU, baro"]
  FC -- "DShot600 + RPM telemetri" --> ESC
  RX["ELRS alıcı"] -- "CRSF" --> FC
  GNSS["GNSS (+RTK) + pusula"] -- "CAN / UART" --> FC
  FLOW["Optik akış + lidar"] -- "CAN / UART" --> FC
  B12 --> JET["Companion<br/>A: Raspberry Pi 5 + AI HAT+ 2<br/>B/C: Jetson Orin NX + PAB V3"]
  FC <-- "UART-1: uXRCE-DDS (ROS 2)" --> JET
  FC <-- "UART-2: MAVLink" --> JET
  FCAM["Gimbal kamerası (Pi)<br/>A: Camera Module 3 · B/C: IMX219"] -- "MIPI CSI-2 (FFC)" --> JET
  DCAM["Aşağı kamera (avuç)<br/>A: CM3 Wide · B/C: OV9281 GS"] -- "MIPI CSI-2 (FFC)" --> JET
  GIMC["Kendi gimbalımız<br/>2 eksen, STorM32"] -- "UART" --> JET
  FCAM -.- GIMC
  TOF["ToF 8×8 (VL53L8CX)<br/>+ VL53L1X (yukarı)"] -- "SPI / I2C" --> JET
  VIO["Stereo / VIO kamera<br/>(yalnızca B/C)"] -- "USB3" --> JET
  JET -- "Ethernet / USB" --> AIR["IP veri/video linki<br/>hava ünitesi"]
  B12 --> GIMC
  B12 --> AIR
  AIR -. "RF" .- GND["Yer ünitesi + GCS"]
  RX -. "RF 2,4 GHz / 900 MHz" .- TXR["RC verici"]
```

Notlar:
- FC'de Ethernet varsa (ör. Pixhawk 6X ailesi) uXRCE-DDS ve MAVLink tek Ethernet kablosu
  üzerinden UDP ile taşınabilir; 30×30 FC'lerde iki UART kullanılır.
- ELRS alıcısı "MAVLink" modunda çalıştırılırsa RC linki üzerinden **yedek telemetri** de alınır.
- Companion ve FC farklı BEC'lerden beslenir; companion'ın ani akım çekişi FC'yi resetlememelidir.
- İki Pi kamerası da doğrudan companion'ın MIPI girişlerine bağlıdır (Pi 5'in iki 4 şeritli girişi;
  Jetson'da 22 pin FFC girişli ARK Jetson PAB V3). Gimbal yalnızca kamerayı taşır; komutları companion
  UART üzerinden STorM32 kontrolcüsüne gönderir (docs/10 §3).

### 3.1 Arayüz tablosu

| Bağlantı | Fiziksel | Protokol | Hız / Frekans | Not |
|---|---|---|---|---|
| FC ↔ companion (ROS 2) | UART (TELEM2) | uXRCE-DDS | 921 600 baud (PX4 varsayılanı; gerekirse 3 000 000) | RTS/CTS akış kontrolü önerilir |
| FC ↔ companion (GCS köprüsü) | UART (TELEM1) | MAVLink 2 | 921 600 baud | `mavlink-router` → UDP → link |
| FC → ESC | 4 sinyal + GND | Bidirectional DShot600 | — | RPM → dinamik notch filtresi |
| RX → FC | UART | CRSF | 420 000 baud | RC failsafe |
| GNSS/pusula → FC | CAN veya UART+I2C | DroneCAN / UBX | 5–20 Hz | Pusula motor/ESC kablolarından uzak |
| Optik akış → FC | CAN veya UART | DroneCAN / MAVLink | 50–100 Hz | Lidar aynı modülde |
| Gimbal kamerası → companion | MIPI CSI-2 (FFC) | libcamera (Pi) / Argus (Jetson) | 1080p30 | RTSP yok → düşük gecikme |
| Gimbal kontrolcüsü ↔ companion | UART | STorM32 seri protokolü | 115 200 baud, 30–50 Hz | Açı komutu + açı geri bildirimi |
| Aşağı kamera → companion | MIPI CSI-2 (FFC) | libcamera / Argus | A: 720p120 · B/C: 60 FPS (global shutter) | Avuç tespiti |
| ToF → companion | SPI (VL53L8CX) + I2C (VL53L1X) | ST ULD | 15 Hz (8×8) / 60 Hz (4×4) | Aynı I2C adresi (0x29) → L8CX SPI'da |
| Link ↔ companion | Ethernet / USB | UDP MAVLink, RTP video, ROS 2 (Zenoh köprüsü) | — | A: WFB-ng (USB), B: SIYI HM30, C: Doodle Labs |

## 4. Yazılım mimarisi

### 4.1 ROS 2 düğüm grafiği

```mermaid
flowchart TB
  subgraph PX4["PX4 (FC)"]
    EKF2["EKF2"]
    MC["Kontrolcüler"]
    FSD["Failsafe / iniş algılayıcı"]
  end
  AG["Micro XRCE-DDS Agent"]
  PX4 <--> AG
  subgraph ROS2["ROS 2 — companion (Pi 5 / Jetson)"]
    CF["front_camera<br/>CSI: libcamera / Argus"]
    CD["down_camera<br/>CSI → Argus"]
    TN["tof_node"]
    DET["detector<br/>TensorRT"]
    MOTN["mot_tracker<br/>BoT-SORT + ReID"]
    SOTN["sot_tracker"]
    GES["gesture_node<br/>el tespiti + 21 nokta + sınıflandırıcı"]
    PALM["palm_localizer<br/>aşağı kamera + ToF"]
    VION["vio_node"]
    TE["target_estimator<br/>3B Kalman"]
    GC["gimbal_controller<br/>STorM32 UART"]
    BM["behavior_manager<br/>durum makinesi"]
    MP["mode_palm_land<br/>px4-ros2 özel mod"]
    MF["mode_follow_target<br/>px4-ros2 özel mod"]
    SM["safety_monitor"]
    REC["recorder<br/>MCAP + video"]
  end
  CF --> DET --> MOTN --> TE
  CF --> SOTN --> TE
  CF --> GES --> BM
  CD --> PALM
  TN --> PALM --> MP
  TE --> GC
  TE --> MF
  BM --> MP
  BM --> MF
  VION -- "vehicle_visual_odometry" --> AG
  MP <--> AG
  MF <--> AG
  SM <--> AG
  SM --> BM
```

### 4.2 Planlanan ROS 2 paket yapısı (Faz 1'de oluşturulacak)

| Paket | Dil | Sorumluluk |
|---|---|---|
| `dc7_interfaces` | msg | `GestureEvent`, `PalmTarget`, `TrackedTarget`, `TargetState`, `BehaviorState` |
| `dc7_bringup` | launch/yaml | Seviyeye göre launch dosyaları, `config/` altındaki parametrelerin yüklenmesi |
| `dc7_perception` | C++/Python | Kamera girişi, TensorRT tespit, MOT, SOT |
| `dc7_gesture` | C++/Python | El tespiti, landmark, jest sınıflandırma, zamansal filtre |
| `dc7_palm_landing` | C++ | Avuç konumlandırma + **Avuca İniş** PX4 özel modu |
| `dc7_follow` | C++ | Hedef durum kestirimi + **Hedef Takip** PX4 özel modu |
| `dc7_gimbal` | C++ | STorM32 seri sürücüsü, piksel hatası → gimbal açı/hız kontrolü, EIS |
| `dc7_behavior` | C++ | Davranış yöneticisi (durum makinesi / BehaviorTree.CPP) |
| `dc7_safety` | C++ | Güvenlik izleyici, watchdog, kişi mesafe kısıtları |
| `dc7_vio` | launch | VIO paketinin PX4 `VehicleOdometry` formatına bağlanması |

### 4.3 Konu (topic) isimlendirmesi

| Konu | Tip | Hz |
|---|---|---|
| `/dc7/cam/front/image` | `sensor_msgs/Image` (GPU'da NITROS) | 30 |
| `/dc7/cam/down/image` | `sensor_msgs/Image` | 60 |
| `/dc7/tof/down` | `sensor_msgs/PointCloud2` (8×8) | 15–30 |
| `/dc7/perception/detections` | `vision_msgs/Detection2DArray` | 30 |
| `/dc7/perception/tracks` | `dc7_interfaces/TrackedTargetArray` | 30 |
| `/dc7/perception/target` | `dc7_interfaces/TargetState` (3B konum/hız, kovaryans) | 30 |
| `/dc7/gesture/events` | `dc7_interfaces/GestureEvent` | olay |
| `/dc7/palm/target` | `dc7_interfaces/PalmTarget` (gövde çerçevesinde xyz, güven) | 30 |
| `/dc7/behavior/state` | `dc7_interfaces/BehaviorState` | 10 |
| `/fmu/out/vehicle_odometry`, `/fmu/out/vehicle_status` | `px4_msgs` | 50–100 |
| `/fmu/in/vehicle_visual_odometry` | `px4_msgs/VehicleOdometry` | 30 |

> PX4 v1.16 ile gelen mesaj sürümlemesi nedeniyle bazı PX4 konularının adı `_v1` gibi sürüm eki
> alabilir; `px4_msgs` sürümü FC firmware sürümüyle **aynı** tutulmalıdır.

## 5. Görev dağılımı

| İşlev | FC (PX4) | Companion (Pi 5 / Jetson) | Yer |
|---|---|---|---|
| Durum kestirimi | EKF2: IMU, GNSS, baro, akış, lidar, VIO | VIO odometrisini üretir | — |
| Stabilizasyon / hover | ✔ (Position modu) | — | — |
| Hedef takip | Setpoint takibi, sınırlar | Hedef kestirimi + Hedef Takip modu | Hedef seçimi |
| Avuca iniş | Setpoint takibi, iniş algılayıcı (yedek) | Avuç konumu, Avuca İniş modu, temas algılama | İzleme |
| Failsafe | **Nihai otorite** | Erken uyarı, iptal önerisi | RTL/Land komutu |
| Kill switch | ✔ (RC kanalı) | — | — |

### 5.1 Neden özel PX4 modları?

PX4'ün ROS 2 arayüz kütüphanesi (`px4-ros2-interface-lib`) ile ROS 2'de yazılan modlar FC'ye
**gerçek uçuş modu** olarak kaydedilir:
- QGroundControl ve RC mod anahtarında normal mod gibi görünür.
- PX4 failsafe'leri bu modlarda da geçerlidir; companion çökerse PX4 bunu algılar ve failsafe
  uygular (klasik Offboard moduna göre çok daha güvenli).
- Pilot herhangi bir anda Position moduna geçerek kontrolü geri alır.

ArduPilot alternatifinde aynı davranış GUIDED modu + Lua betikleri + companion MAVLink komutları
ile kurulur (bkz. [`config/ardupilot`](../config/ardupilot/)).

## 6. Davranış durum makinesi

```mermaid
stateDiagram-v2
    [*] --> DISARMED
    DISARMED --> ARMED: arm (RC/GCS) + ön uçuş kontrolleri OK
    ARMED --> TAKEOFF: kalkış komutu
    TAKEOFF --> HOVER: hedef irtifaya ulaşıldı
    HOVER --> FOLLOW: hedef seçildi (GCS tıklama / V jesti)
    FOLLOW --> SEARCH: hedef kayıp > 1 s
    SEARCH --> FOLLOW: ReID ile yeniden yakalandı
    SEARCH --> HOVER: zaman aşımı (10 s)
    FOLLOW --> HOVER: yumruk jesti / GCS dur
    HOVER --> PALM_READY: açık avuç ≥ 1 s (ön kamera)
    PALM_READY --> PALM_ALIGN: avuç aşağı kamerada + ToF geçerli
    PALM_ALIGN --> PALM_DESCEND: avuç merkezde ≥ 0,5 s
    PALM_DESCEND --> CONTACT: ToF ≤ temas eşiği ve dikey hız ≈ 0
    CONTACT --> DISARMED: motorlar durduruldu
    PALM_READY --> HOVER: zaman aşımı (15 s) / yumruk
    PALM_ALIGN --> PALM_ABORT: avuç kayıp / hata > sınır
    PALM_DESCEND --> PALM_ABORT: avuç kayıp / hata > sınır
    PALM_ABORT --> HOVER: güvenli yüksekliğe çıkıldı
    HOVER --> LAND: iniş komutu
    LAND --> DISARMED
```

Her durumdan PX4 failsafe'ine (RC kaybı, batarya, geofence, companion kaybı) geçiş vardır; bu
geçişlerin sahibi PX4'tür ve davranış yöneticisi yalnızca durumunu `HOVER`/`DISARMED`'a eşitler.

## 7. Gecikme bütçesi (hedef: 30 FPS)

| Aşama | Raspberry Pi 5 + Hailo (A) | Jetson Orin NX (B/C) |
|---|---|---|
| Pozlama + okuma (CSI) | 8–16 ms | 8–16 ms |
| ISP / ön işleme | 2–4 ms (PiSP + CPU) | 1–2 ms (GPU / VPI) |
| Çıkarım | YOLO26n, Hailo: ≈ 5–10 ms (Pi 5'te PCIe x1 sınırlı) | YOLO26s, TensorRT: ≈ 5–7 ms |
| Takip / landmark | 4–10 ms (CPU + Hailo) | 2–8 ms |
| Davranış + kontrol | < 2 ms | < 2 ms |
| DDS → PX4 | 2–5 ms | 2–5 ms |
| **Toplam (kamera → setpoint)** | **≈ 25–45 ms** | **≈ 20–40 ms** |

Sonuçlar:
- Gimbal kamerası artık RTSP yerine **CSI** ile bağlı → önceki tasarımdaki 40–90 ms'lik kodlama/ağ/çözme
  gecikmesi ortadan kalktı; avuca iniş ve takip aynı düşük gecikmeli yolu kullanır.
- Takip kontrolcüsü kalan gecikmeyi hedef durum kestiriminde (Kalman tahmini) telafi eder.

## 8. Yer istasyonu ve video

- **QGroundControl 5.x**: telemetri, parametre, özel modların seçimi, video.
- **YZ katmanlı video**: companion tespit kutularını görüntüye işler ve kodlayıp RTP/UDP ile gönderir:
  Orin NX'te donanım (NVENC, H.265); **Raspberry Pi 5 ve Orin Nano'da donanım kodlayıcı yoktur**
  → yazılım kodlaması, 720p önerilir. Alternatif: düşük çözünürlüklü video + kutular metaveri olarak.
- **Tıkla-takip et**: Companion, MAVLink kamera protokolü v2'nin izleme komutlarını
  (`MAV_CMD_CAMERA_TRACK_RECTANGLE` / `MAV_CMD_CAMERA_TRACK_POINT` / `MAV_CMD_CAMERA_STOP_TRACKING`,
  durum: `CAMERA_TRACKING_IMAGE_STATUS`) destekleyen bir "MAVLink kamera" bileşeni sunar ve SOT
  izleyiciyi başlatır. Kullanılan QGroundControl sürümünün bu komutları video penceresinden
  gönderip göndermediği Faz 1'de doğrulanacaktır; desteklemiyorsa companion üzerinde barındırılan
  basit bir web arayüzü (video + tıklama) kullanılır.

## 9. Kayıt ve gözlemlenebilirlik

- PX4 ulog (SD kart); ayar uçuşlarında yüksek frekanslı profil.
- ROS 2 bag (**MCAP**): algı çıktıları, durum, setpoint'ler, seyreltilmiş görüntüler.
- Gimbal kamerası kaydı companion'da (1080p30; Pi 5'te yazılım kodlama). Hazır gimbal kameralardaki
  4K SD kart kaydı yoktur — bilinçli maliyet tercihi (docs/10 §2.3).
- Analiz: PX4 Flight Review / PlotJuggler / Foxglove.

## 10. Dağıtım (deployment)

- **Raspberry Pi 5 (Seviye A)**: Raspberry Pi OS (kamera + Hailo yerel) + ROS 2 Jazzy Docker
  kapsayıcısında; modeller Hailo `.hef` biçiminde.
- **Jetson (Seviye B/C)**: JetPack 7.2.1 + Docker; modeller TensorRT motoru (`.engine`) olarak
  **hedef cihazda** derlenir; güç kipi açılışta sabitlenir (`nvpmodel`, `jetson_clocks`).
- Her iki platformda servisler `systemd` ile açılışta başlar, model dosyaları sürüm etiketlenir,
  sıcaklık izlenir (bkz. [`config/companion`](../config/companion/)).
