ahmet6141/Drone-controller/ucav250/out/structures.md

# YK-250 HANÇER — yapı hesapları: emniyet payı tablosu

Üreten: `python3 -m ucav250.analysis.structures` (el hesapları, `analysis/structlib.py`); yöntem ve açıklamalar: `docs/04_yapi_hesaplari.md`. Uygulanan değer LİMİT yük/gerilme/birim şekil değiştirme (yalnız nihai durumlarda nihai), izin verilen değer NİHAİ tasarım değeridir; **MS = izin verilen / (uygulanan × toplam katsayı) − 1**.

- Satır sayısı: 325 (303 emniyet payı, 22 gereksinim / bilgi satırı)
- En küçük MS: **0,000** (W-CAP-09); negatif MS: 0
- Arayüz kontrolleri (yerleşim ↔ yapı boyutları): 18/18 uygun

## Katsayılar

| Katsayı | Değer | Kaynak |
|---|---|---|
| Emniyet katsayısı (FoS) | 1,5 | CS-LUAS.303, STANAG 4703 UL2.3 |
| Bağlantı (fitting) katsayısı | 1,15 | CS-LUAS.625 |
| Mafsallı / dönen bağlantı ezilme katsayısı | 2 | STANAG 4703 UL2.4 |
| Sık sökülüp takılan bağlantı katsayısı | 1,5 | STANAG 4703 UL2.4 |
| Kompozit özel katsayısı (B-tabanı ETW ile) | 1,2 | AMC LUAS.619 |
| Tek yük yollu kompozit A-tabanı tahmini | 0,85 × B-tabanı | CS-LUAS.613(b) |
| Menteşe ezilmesi toplam | 6,67 | CS-LUAS.657 |
| İtme-çekme bağlantısı toplam | 3,33 | CS-LUAS.693 |
| Birleştirme kuralı | FoS × en büyük özel katsayı | CS-LUAS.619 |
| Hasar toleransı sınırları (nihai yükte) | 3000 µε bası (> 2 mm), 2600 µε bası (sandviç / ≤ 2 mm), 5000 µε çekme, 5200 µε kesme | STANAG 4703 UL13.1.2 |

## Emniyet payı tablosu

Yük durumu kodları (YD-xx) tablonun altında açıklanmıştır. Birimler: N, N m, MPa, N/mm (kesme akışı / doğrusal yük), µε; 'yük çarpanı' satırlarında uygulanan = 1 (katsayılı yük) ve izin verilen = kritik yük çarpanıdır.

### Kanat

| No | Eleman / kontrol | Yük durumu | Uygulanan | İzin verilen | Birim | Katsayılar | MS | Referans |
|---|---|---|---|---|---|---|---|---|
| DT-COND | STANAG UL13.1.2 hasar toleransı birim şekil değiştirme sınırlarının uygulanabilirliği: matrise duyarlı özelliklerin ETW kaybı RTD'nin % 50'sinin altında | YD-01 | 0,472 | 0,5 | fraction | - | gereksinim | largest: PW S_0.2; UD Xc 37 % (b_basis); PW Xc (warp) 31 % (mean); PW Yc (fill) 36 % (mean); PW S_0.2 47 % (b_basis); condition < 0,50 met -> UL13.1.2 strain limits used (fix round 2, VS2-11) |
| W-CAP-01 | ana kiriş başlığı y 0,00-0,05 m (59 kat x 40 mm, belirleyici y 0,00): kaplama yüzü bası birim şekil değiştirmesi (sandviç, hasar toleransı) | YD-02 | 1717,5 | 2600,0 | µε | FoS 1,5 | 0,009 | STANAG 4703 UL13.1.2 (2600 µε sandviç kaplamalar) |
| W-CAP-02 | ana kiriş başlığı y 0,05-0,10 m (56 kat x 40 mm, belirleyici y 0,05): kaplama yüzü bası birim şekil değiştirmesi (sandviç, hasar toleransı) | YD-02 | 1718,2 | 2600,0 | µε | FoS 1,5 | 0,009 | STANAG 4703 UL13.1.2 (2600 µε sandviç kaplamalar) |
| W-CAP-03 | ana kiriş başlığı y 0,10-0,15 m (53 kat x 40 mm, belirleyici y 0,10): kaplama yüzü bası birim şekil değiştirmesi (sandviç, hasar toleransı) | YD-02 | 1721,7 | 2600,0 | µε | FoS 1,5 | 0,007 | STANAG 4703 UL13.1.2 (2600 µε sandviç kaplamalar) |
| W-CAP-04 | ana kiriş başlığı y 0,15-0,20 m (50 kat x 40 mm, belirleyici y 0,15): kaplama yüzü bası birim şekil değiştirmesi (sandviç, hasar toleransı) | YD-02 | 1728,6 | 2600,0 | µε | FoS 1,5 | 0,003 | STANAG 4703 UL13.1.2 (2600 µε sandviç kaplamalar) |
| W-CAP-05 | ana kiriş başlığı y 0,20-0,25 m (48 kat x 40 mm, belirleyici y 0,20): kaplama yüzü bası birim şekil değiştirmesi (sandviç, hasar toleransı) | YD-02 | 1716,3 | 2600,0 | µε | FoS 1,5 | 0,010 | STANAG 4703 UL13.1.2 (2600 µε sandviç kaplamalar) |
| W-CAP-06 | ana kiriş başlığı y 0,25-0,30 m (45 kat x 40 mm, belirleyici y 0,25): kaplama yüzü bası birim şekil değiştirmesi (sandviç, hasar toleransı) | YD-02 | 1729,3 | 2600,0 | µε | FoS 1,5 | 0,002 | STANAG 4703 UL13.1.2 (2600 µε sandviç kaplamalar) |
| W-CAP-07 | ana kiriş başlığı y 0,30-0,35 m (43 kat x 40 mm, belirleyici y 0,30): kaplama yüzü bası birim şekil değiştirmesi (sandviç, hasar toleransı) | YD-02 | 1721,2 | 2600,0 | µε | FoS 1,5 | 0,007 | STANAG 4703 UL13.1.2 (2600 µε sandviç kaplamalar) |
| W-CAP-08 | ana kiriş başlığı y 0,35-0,40 m (41 kat x 40 mm, belirleyici y 0,35): kaplama yüzü bası birim şekil değiştirmesi (sandviç, hasar toleransı) | YD-02 | 1714,9 | 2600,0 | µε | FoS 1,5 | 0,011 | STANAG 4703 UL13.1.2 (2600 µε sandviç kaplamalar) |
| W-CAP-09 | ana kiriş başlığı y 0,40-0,43 m (60 kat x 40 mm, belirleyici y 0,40, eldiven kutusu momenti = toplam - dil momenti): kaplama yüzü bası birim şekil değiştirmesi (sandviç, hasar toleransı) | YD-02 | 1732,6 | 2600,0 | µε | FoS 1,5 | 0,000 | STANAG 4703 UL13.1.2 (2600 µε sandviç kaplamalar) |
| W-CAP-10 | ana kiriş başlığı y 0,43-0,46 m (39 kat x 40 mm, belirleyici y 0,43, eldiven kutusu momenti = toplam - dil momenti): kaplama yüzü bası birim şekil değiştirmesi (sandviç, hasar toleransı) | YD-02 | 1716,3 | 2600,0 | µε | FoS 1,5 | 0,010 | STANAG 4703 UL13.1.2 (2600 µε sandviç kaplamalar) |
| W-CAP-11 | ana kiriş başlığı y 0,46-0,48 m (32 kat x 40 mm, belirleyici y 0,46, eldiven kutusu momenti = toplam - dil momenti): kaplama yüzü bası birim şekil değiştirmesi (sandviç, hasar toleransı) | YD-02 | 1701,0 | 2600,0 | µε | FoS 1,5 | 0,019 | STANAG 4703 UL13.1.2 (2600 µε sandviç kaplamalar) |
| W-CAP-12 | ana kiriş başlığı y 0,48-0,50 m (28 kat x 40 mm, belirleyici y 0,48, eldiven kutusu momenti = toplam - dil momenti): kaplama yüzü bası birim şekil değiştirmesi (sandviç, hasar toleransı) | YD-02 | 1698,1 | 2600,0 | µε | FoS 1,5 | 0,021 | STANAG 4703 UL13.1.2 (2600 µε sandviç kaplamalar) |
| W-CAP-13 | ana kiriş başlığı y 0,50-0,53 m (23 kat x 40 mm, belirleyici y 0,50, eldiven kutusu momenti = toplam - dil momenti): kaplama yüzü bası birim şekil değiştirmesi (sandviç, hasar toleransı) | YD-02 | 1732,3 | 2600,0 | µε | FoS 1,5 | 0,001 | STANAG 4703 UL13.1.2 (2600 µε sandviç kaplamalar) |
| W-CAP-14 | ana kiriş başlığı y 0,53-0,55 m (18 kat x 40 mm, belirleyici y 0,53, eldiven kutusu momenti = toplam - dil momenti): kaplama yüzü bası birim şekil değiştirmesi (sandviç, hasar toleransı) | YD-02 | 1704,4 | 2600,0 | µε | FoS 1,5 | 0,017 | STANAG 4703 UL13.1.2 (2600 µε sandviç kaplamalar) |
| W-CAP-15 | ana kiriş başlığı y 0,55-0,59 m (13 kat x 40 mm, belirleyici y 0,55, eldiven kutusu momenti = toplam - dil momenti): kaplama yüzü bası birim şekil değiştirmesi (sandviç, hasar toleransı) | YD-02 | 1658,3 | 2600,0 | µε | FoS 1,5 | 0,045 | STANAG 4703 UL13.1.2 (2600 µε sandviç kaplamalar) |
| W-CAP-16 | ana kiriş başlığı y 0,59-0,62 m (10 kat x 40 mm, belirleyici y 0,59, eldiven kutusu momenti = toplam - dil momenti): kaplama yüzü bası birim şekil değiştirmesi (sandviç, hasar toleransı) | YD-02 | 1123,5 | 2600,0 | µε | FoS 1,5 | 0,543 | STANAG 4703 UL13.1.2 (2600 µε sandviç kaplamalar) |
| W-CAP-17 | ana kiriş başlığı y 0,62-0,70 m (10 kat x 40 mm, belirleyici y 0,63, eldiven kutusu momenti = toplam - dil momenti): kaplama yüzü bası birim şekil değiştirmesi (sandviç, hasar toleransı) | YD-02 | 413,4 | 2600,0 | µε | FoS 1,5 | 3,193 | STANAG 4703 UL13.1.2 (2600 µε sandviç kaplamalar) |
| W-CAP-18 | ana kiriş başlığı y 0,70-0,75 m (36 kat x 30 mm, belirleyici y 0,70): kaplama yüzü bası birim şekil değiştirmesi (sandviç, hasar toleransı) | YD-02 | 1722,1 | 2600,0 | µε | FoS 1,5 | 0,007 | STANAG 4703 UL13.1.2 (2600 µε sandviç kaplamalar) |
| W-CAP-19 | ana kiriş başlığı y 0,75-0,80 m (36 kat x 30 mm, belirleyici y 0,75): kaplama yüzü bası birim şekil değiştirmesi (sandviç, hasar toleransı) | YD-02 | 1703,6 | 2600,0 | µε | FoS 1,5 | 0,017 | STANAG 4703 UL13.1.2 (2600 µε sandviç kaplamalar) |
| W-CAP-20 | ana kiriş başlığı y 0,80-0,85 m (35 kat x 30 mm, belirleyici y 0,80): kaplama yüzü bası birim şekil değiştirmesi (sandviç, hasar toleransı) | YD-02 | 1710,9 | 2600,0 | µε | FoS 1,5 | 0,013 | STANAG 4703 UL13.1.2 (2600 µε sandviç kaplamalar) |
| W-CAP-21 | ana kiriş başlığı y 0,85-0,90 m (34 kat x 30 mm, belirleyici y 0,85): kaplama yüzü bası birim şekil değiştirmesi (sandviç, hasar toleransı) | YD-02 | 1709,4 | 2600,0 | µε | FoS 1,5 | 0,014 | STANAG 4703 UL13.1.2 (2600 µε sandviç kaplamalar) |
| W-CAP-22 | ana kiriş başlığı y 0,90-0,95 m (33 kat x 30 mm, belirleyici y 0,90): kaplama yüzü bası birim şekil değiştirmesi (sandviç, hasar toleransı) | YD-02 | 1706,9 | 2600,0 | µε | FoS 1,5 | 0,016 | STANAG 4703 UL13.1.2 (2600 µε sandviç kaplamalar) |
| W-CAP-23 | ana kiriş başlığı y 0,95-1,00 m (32 kat x 30 mm, belirleyici y 0,95): kaplama yüzü bası birim şekil değiştirmesi (sandviç, hasar toleransı) | YD-02 | 1705,9 | 2600,0 | µε | FoS 1,5 | 0,016 | STANAG 4703 UL13.1.2 (2600 µε sandviç kaplamalar) |
| W-CAP-24 | ana kiriş başlığı y 1,00-1,05 m (31 kat x 30 mm, belirleyici y 1,00): kaplama yüzü bası birim şekil değiştirmesi (sandviç, hasar toleransı) | YD-02 | 1699,7 | 2600,0 | µε | FoS 1,5 | 0,020 | STANAG 4703 UL13.1.2 (2600 µε sandviç kaplamalar) |
| W-CAP-25 | ana kiriş başlığı y 1,05-1,10 m (29 kat x 30 mm, belirleyici y 1,05): kaplama yüzü bası birim şekil değiştirmesi (sandviç, hasar toleransı) | YD-02 | 1726,7 | 2600,0 | µε | FoS 1,5 | 0,004 | STANAG 4703 UL13.1.2 (2600 µε sandviç kaplamalar) |
| W-CAP-26 | ana kiriş başlığı y 1,10-1,15 m (28 kat x 30 mm, belirleyici y 1,10): kaplama yüzü bası birim şekil değiştirmesi (sandviç, hasar toleransı) | YD-02 | 1710,6 | 2600,0 | µε | FoS 1,5 | 0,013 | STANAG 4703 UL13.1.2 (2600 µε sandviç kaplamalar) |
| W-CAP-27 | ana kiriş başlığı y 1,15-1,20 m (27 kat x 30 mm, belirleyici y 1,15): kaplama yüzü bası birim şekil değiştirmesi (sandviç, hasar toleransı) | YD-02 | 1694,0 | 2600,0 | µε | FoS 1,5 | 0,023 | STANAG 4703 UL13.1.2 (2600 µε sandviç kaplamalar) |
| W-CAP-28 | ana kiriş başlığı y 1,20-1,25 m (25 kat x 30 mm, belirleyici y 1,20): kaplama yüzü bası birim şekil değiştirmesi (sandviç, hasar toleransı) | YD-02 | 1722,9 | 2600,0 | µε | FoS 1,5 | 0,006 | STANAG 4703 UL13.1.2 (2600 µε sandviç kaplamalar) |
| W-CAP-29 | ana kiriş başlığı y 1,25-1,30 m (24 kat x 30 mm, belirleyici y 1,25): kaplama yüzü bası birim şekil değiştirmesi (sandviç, hasar toleransı) | YD-02 | 1705,0 | 2600,0 | µε | FoS 1,5 | 0,017 | STANAG 4703 UL13.1.2 (2600 µε sandviç kaplamalar) |
| W-CAP-30 | ana kiriş başlığı y 1,30-1,35 m (23 kat x 30 mm, belirleyici y 1,30): kaplama yüzü bası birim şekil değiştirmesi (sandviç, hasar toleransı) | YD-02 | 1714,7 | 2600,0 | µε | FoS 1,5 | 0,011 | STANAG 4703 UL13.1.2 (2600 µε sandviç kaplamalar) |
| W-CAP-31 | ana kiriş başlığı y 1,35-1,40 m (22 kat x 30 mm, belirleyici y 1,35): kaplama yüzü bası birim şekil değiştirmesi (sandviç, hasar toleransı) | YD-02 | 1729,7 | 2600,0 | µε | FoS 1,5 | 0,002 | STANAG 4703 UL13.1.2 (2600 µε sandviç kaplamalar) |
| W-CAP-32 | ana kiriş başlığı y 1,40-1,45 m (22 kat x 30 mm, belirleyici y 1,40): kaplama yüzü bası birim şekil değiştirmesi (sandviç, hasar toleransı) | YD-02 | 1683,5 | 2600,0 | µε | FoS 1,5 | 0,030 | STANAG 4703 UL13.1.2 (2600 µε sandviç kaplamalar) |
| W-CAP-33 | ana kiriş başlığı y 1,45-1,50 m (21 kat x 30 mm, belirleyici y 1,45): kaplama yüzü bası birim şekil değiştirmesi (sandviç, hasar toleransı) | YD-02 | 1688,6 | 2600,0 | µε | FoS 1,5 | 0,026 | STANAG 4703 UL13.1.2 (2600 µε sandviç kaplamalar) |
| W-CAP-34 | ana kiriş başlığı y 1,50-1,55 m (20 kat x 30 mm, belirleyici y 1,50): kaplama yüzü bası birim şekil değiştirmesi (sandviç, hasar toleransı) | YD-02 | 1691,3 | 2600,0 | µε | FoS 1,5 | 0,025 | STANAG 4703 UL13.1.2 (2600 µε sandviç kaplamalar) |
| W-CAP-35 | ana kiriş başlığı y 1,55-1,60 m (19 kat x 30 mm, belirleyici y 1,55): kaplama yüzü bası birim şekil değiştirmesi (sandviç, hasar toleransı) | YD-02 | 1686,0 | 2600,0 | µε | FoS 1,5 | 0,028 | STANAG 4703 UL13.1.2 (2600 µε sandviç kaplamalar) |
| W-CAP-36 | ana kiriş başlığı y 1,60-1,65 m (18 kat x 30 mm, belirleyici y 1,60): kaplama yüzü bası birim şekil değiştirmesi (sandviç, hasar toleransı) | YD-02 | 1674,9 | 2600,0 | µε | FoS 1,5 | 0,035 | STANAG 4703 UL13.1.2 (2600 µε sandviç kaplamalar) |
| W-CAP-37 | ana kiriş başlığı y 1,65-1,70 m (16 kat x 30 mm, belirleyici y 1,65): kaplama yüzü bası birim şekil değiştirmesi (sandviç, hasar toleransı) | YD-02 | 1726,1 | 2600,0 | µε | FoS 1,5 | 0,004 | STANAG 4703 UL13.1.2 (2600 µε sandviç kaplamalar) |
| W-CAP-38 | ana kiriş başlığı y 1,70-1,75 m (15 kat x 30 mm, belirleyici y 1,70): kaplama yüzü bası birim şekil değiştirmesi (sandviç, hasar toleransı) | YD-02 | 1717,4 | 2600,0 | µε | FoS 1,5 | 0,009 | STANAG 4703 UL13.1.2 (2600 µε sandviç kaplamalar) |
| W-CAP-39 | ana kiriş başlığı y 1,75-1,80 m (14 kat x 30 mm, belirleyici y 1,75): kaplama yüzü bası birim şekil değiştirmesi (sandviç, hasar toleransı) | YD-02 | 1708,9 | 2600,0 | µε | FoS 1,5 | 0,014 | STANAG 4703 UL13.1.2 (2600 µε sandviç kaplamalar) |
| W-CAP-40 | ana kiriş başlığı y 1,80-1,85 m (13 kat x 30 mm, belirleyici y 1,80): kaplama yüzü bası birim şekil değiştirmesi (sandviç, hasar toleransı) | YD-02 | 1700,5 | 2600,0 | µε | FoS 1,5 | 0,019 | STANAG 4703 UL13.1.2 (2600 µε sandviç kaplamalar) |
| W-CAP-41 | ana kiriş başlığı y 1,85-1,90 m (12 kat x 30 mm, belirleyici y 1,85): kaplama yüzü bası birim şekil değiştirmesi (sandviç, hasar toleransı) | YD-02 | 1707,3 | 2600,0 | µε | FoS 1,5 | 0,015 | STANAG 4703 UL13.1.2 (2600 µε sandviç kaplamalar) |
| W-CAP-42 | ana kiriş başlığı y 1,90-1,95 m (12 kat x 30 mm, belirleyici y 1,90): kaplama yüzü bası birim şekil değiştirmesi (sandviç, hasar toleransı) | YD-02 | 1661,5 | 2600,0 | µε | FoS 1,5 | 0,043 | STANAG 4703 UL13.1.2 (2600 µε sandviç kaplamalar) |
| W-CAP-43 | ana kiriş başlığı y 1,95-2,00 m (11 kat x 30 mm, belirleyici y 1,95): kaplama yüzü bası birim şekil değiştirmesi (sandviç, hasar toleransı) | YD-02 | 1686,6 | 2600,0 | µε | FoS 1,5 | 0,028 | STANAG 4703 UL13.1.2 (2600 µε sandviç kaplamalar) |
| W-CAP-44 | ana kiriş başlığı y 2,00-2,05 m (10 kat x 30 mm, belirleyici y 2,00): kaplama yüzü bası birim şekil değiştirmesi (sandviç, hasar toleransı) | YD-02 | 1709,4 | 2600,0 | µε | FoS 1,5 | 0,014 | STANAG 4703 UL13.1.2 (2600 µε sandviç kaplamalar) |
| W-CAP-45 | ana kiriş başlığı y 2,05-2,10 m (10 kat x 30 mm, belirleyici y 2,05): kaplama yüzü bası birim şekil değiştirmesi (sandviç, hasar toleransı) | YD-02 | 1633,6 | 2600,0 | µε | FoS 1,5 | 0,061 | STANAG 4703 UL13.1.2 (2600 µε sandviç kaplamalar) |
| W-CAP-46 | ana kiriş başlığı y 2,10-2,20 m (10 kat x 30 mm, belirleyici y 2,10): kaplama yüzü bası birim şekil değiştirmesi (sandviç, hasar toleransı) | YD-02 | 1550,0 | 2600,0 | µε | FoS 1,5 | 0,118 | STANAG 4703 UL13.1.2 (2600 µε sandviç kaplamalar) |
| W-CAP-47 | ana kiriş başlığı y 2,20-3,60 m (10 kat x 30 mm, belirleyici y 2,20): kaplama yüzü bası birim şekil değiştirmesi (sandviç, hasar toleransı) | YD-02 | 1377,2 | 2600,0 | µε | FoS 1,5 | 0,259 | STANAG 4703 UL13.1.2 (2600 µε sandviç kaplamalar) |
| W-ROLL | yuvarlanma durumu: daha yüklü tarafın kök eğilme momenti (n_A'da %100) / tasarım durumu | YD-03 | 3732,4 | 5371,3 | N m | - | gereksinim | karşılanıyor: tasarım durumu kök momenti 5371 N m (n 5,47); asimetri yuvarlanma ataletiyle dengelenir (orta kutunun ortasındaki moment iki tarafın ortalamasıdır) |
| W-SEC-CT-1 | kanat kesiti y 0,00 m: başlık bası birim şekil değiştirmesi (hasar toleransı, > 2 mm) | YD-02 | 1492,1 | 3000,0 | µε | FoS 1,5 | 0,340 | STANAG 4703 UL13.1.2 (3000 µε nihai yükte) |
| W-SEC-CT-2 | kanat kesiti y 0,00 m: başlık bası gerilmesi (A-tabanı tahmini 0,85 Fcu) | YD-02 | 190,4 | 656,0 | MPa | FoS 1,5 x kompozit 1,2 | 0,914 | CS-LUAS.613(b), AMC LUAS.619; malzeme Fcu B-tabanı ETW |
| W-SEC-CT-3 | kanat kesiti y 0,00 m: başlık çekme birim şekil değiştirmesi (hasar toleransı) | YD-02 | 1492,1 | 5000,0 | µε | FoS 1,5 | 1,234 | STANAG 4703 UL13.1.2 |
| W-SEC-CT-4 | kanat kesiti y 0,00 m: başlık çekme gerilmesi (A-tabanı tahmini 0,85 Ftu) | YD-02 | 190,4 | 1323,2 | MPa | FoS 1,5 x kompozit 1,2 | 2,860 | CS-LUAS.613(b) |
| W-SEC-CT-5 | kanat kesiti y 0,00 m: kaplama yüzü bası birim şekil değiştirmesi (sandviç, hasar toleransı) | YD-02 | 1717,7 | 2600,0 | µε | FoS 1,5 | 0,009 | STANAG 4703 UL13.1.2 (2600 µε sandviç kaplamalar) |
| W-SEC-CT-6 | kanat kesiti y 0,00 m: kaplama dış yüzü delikli bası (OHC) gerilmesi | YD-02 | 75,78 | 175,4 | MPa | FoS 1,5 x kompozit 1,2 | 0,286 | materials.yaml design_values_for_code OHC (PW-QI ETW2 B-tabanı) |
| W-SEC-CT-7 | kanat kesiti y 0,00 m: kaplama dış yüzü buruşma | YD-02 | 75,78 | 151,5 | MPa | FoS 1,5 x kompozit 1,2 | 0,110 | Zenkert 1995: 0,5 (Ef Ec Gc)^(1/3), ROHACELL 51 WF minimum değerler |
| W-SEC-GLOVE-1 | kanat kesiti y 0,41 m: başlık bası birim şekil değiştirmesi (hasar toleransı, > 2 mm) | YD-02 | 1096,1 | 3000,0 | µε | FoS 1,5 | 0,825 | STANAG 4703 UL13.1.2 (3000 µε nihai yükte) |
| W-SEC-GLOVE-2 | kanat kesiti y 0,41 m: başlık bası gerilmesi (A-tabanı tahmini 0,85 Fcu) | YD-02 | 139,9 | 656,0 | MPa | FoS 1,5 x kompozit 1,2 | 1,605 | CS-LUAS.613(b), AMC LUAS.619; malzeme Fcu B-tabanı ETW |
| W-SEC-GLOVE-3 | kanat kesiti y 0,41 m: başlık çekme birim şekil değiştirmesi (hasar toleransı) | YD-02 | 1094,3 | 5000,0 | µε | FoS 1,5 | 2,046 | STANAG 4703 UL13.1.2 |
| W-SEC-GLOVE-4 | kanat kesiti y 0,41 m: başlık çekme gerilmesi (A-tabanı tahmini 0,85 Ftu) | YD-02 | 139,7 | 1323,2 | MPa | FoS 1,5 x kompozit 1,2 | 4,264 | CS-LUAS.613(b) |
| W-SEC-GLOVE-5 | kanat kesiti y 0,41 m: kaplama yüzü bası birim şekil değiştirmesi (sandviç, hasar toleransı) | YD-02 | 1502,8 | 2600,0 | µε | FoS 1,5 | 0,153 | STANAG 4703 UL13.1.2 (2600 µε sandviç kaplamalar) |
| W-SEC-GLOVE-6 | kanat kesiti y 0,41 m: kaplama dış yüzü delikli bası (OHC) gerilmesi | YD-02 | 52,33 | 175,4 | MPa | FoS 1,5 x kompozit 1,2 | 0,862 | materials.yaml design_values_for_code OHC (PW-QI ETW2 B-tabanı) |
| W-SEC-GLOVE-7 | kanat kesiti y 0,41 m: kaplama dış yüzü buruşma | YD-02 | 52,33 | 140,0 | MPa | FoS 1,5 x kompozit 1,2 | 0,486 | Zenkert 1995: 0,5 (Ef Ec Gc)^(1/3), ROHACELL 51 WF minimum değerler |
| W-SEC-OP-1 | kanat kesiti y 0,71 m: başlık bası birim şekil değiştirmesi (hasar toleransı, > 2 mm) | YD-02 | 1590,1 | 3000,0 | µε | FoS 1,5 | 0,258 | STANAG 4703 UL13.1.2 (3000 µε nihai yükte) |
| W-SEC-OP-2 | kanat kesiti y 0,71 m: başlık bası gerilmesi (A-tabanı tahmini 0,85 Fcu) | YD-02 | 202,9 | 656,0 | MPa | FoS 1,5 x kompozit 1,2 | 0,796 | CS-LUAS.613(b), AMC LUAS.619; malzeme Fcu B-tabanı ETW |
| W-SEC-OP-3 | kanat kesiti y 0,71 m: başlık çekme birim şekil değiştirmesi (hasar toleransı) | YD-02 | 1381,5 | 5000,0 | µε | FoS 1,5 | 1,413 | STANAG 4703 UL13.1.2 |
| W-SEC-OP-4 | kanat kesiti y 0,71 m: başlık çekme gerilmesi (A-tabanı tahmini 0,85 Ftu) | YD-02 | 176,3 | 1323,2 | MPa | FoS 1,5 x kompozit 1,2 | 3,169 | CS-LUAS.613(b) |
| W-SEC-OP-5 | kanat kesiti y 0,71 m: kaplama yüzü bası birim şekil değiştirmesi (sandviç, hasar toleransı) | YD-02 | 1718,0 | 2600,0 | µε | FoS 1,5 | 0,009 | STANAG 4703 UL13.1.2 (2600 µε sandviç kaplamalar) |
| W-SEC-OP-6 | kanat kesiti y 0,71 m: kaplama dış yüzü delikli bası (OHC) gerilmesi | YD-02 | 59,82 | 175,4 | MPa | FoS 1,5 x kompozit 1,2 | 0,629 | materials.yaml design_values_for_code OHC (PW-QI ETW2 B-tabanı) |
| W-SEC-OP-7 | kanat kesiti y 0,71 m: kaplama dış yüzü buruşma | YD-02 | 59,82 | 140,0 | MPa | FoS 1,5 x kompozit 1,2 | 0,300 | Zenkert 1995: 0,5 (Ef Ec Gc)^(1/3), ROHACELL 51 WF minimum değerler |
| W-WEB-01 | ana kiriş gövdesi y 0,70-0,85 m (6 kat ±45 PW, belirleyici y 0,70): gövde kesme burkulması (uzun levha, basit mesnet) | YD-04 | 30,82 | 63,56 | N/mm | FoS 1,5 x kompozit 1,2 | 0,146 | Kollár & Springer uzun levha kesme burkulması, CLT eğilme rijitliği |
| W-WEB-02 | ana kiriş gövdesi y 0,85-1,00 m (6 kat ±45 PW, belirleyici y 0,85): gövde kesme burkulması (uzun levha, basit mesnet) | YD-04 | 30,52 | 72,80 | N/mm | FoS 1,5 x kompozit 1,2 | 0,325 | Kollár & Springer uzun levha kesme burkulması, CLT eğilme rijitliği |
| W-WEB-03 | ana kiriş gövdesi y 1,00-1,15 m (6 kat ±45 PW, belirleyici y 1,00): gövde kesme burkulması (uzun levha, basit mesnet) | YD-04 | 29,89 | 79,34 | N/mm | FoS 1,5 x kompozit 1,2 | 0,475 | Kollár & Springer uzun levha kesme burkulması, CLT eğilme rijitliği |
| W-WEB-04 | ana kiriş gövdesi y 1,15-1,30 m (6 kat ±45 PW, belirleyici y 1,15): gövde kesme burkulması (uzun levha, basit mesnet) | YD-04 | 28,27 | 82,69 | N/mm | FoS 1,5 x kompozit 1,2 | 0,625 | Kollár & Springer uzun levha kesme burkulması, CLT eğilme rijitliği |
| W-WEB-05 | ana kiriş gövdesi y 1,30-1,45 m (5 kat ±45 PW, belirleyici y 1,30): gövde kesme burkulması (uzun levha, basit mesnet) | YD-04 | 26,60 | 50,39 | N/mm | FoS 1,5 x kompozit 1,2 | 0,052 | Kollár & Springer uzun levha kesme burkulması, CLT eğilme rijitliği |
| W-WEB-06 | ana kiriş gövdesi y 1,45-1,70 m (5 kat ±45 PW, belirleyici y 1,45): gövde kesme burkulması (uzun levha, basit mesnet) | YD-04 | 25,98 | 58,23 | N/mm | FoS 1,5 x kompozit 1,2 | 0,245 | Kollár & Springer uzun levha kesme burkulması, CLT eğilme rijitliği |
| W-WEB-07 | ana kiriş gövdesi y 1,70-1,95 m (5 kat ±45 PW, belirleyici y 1,70): gövde kesme burkulması (uzun levha, basit mesnet) | YD-04 | 22,95 | 64,45 | N/mm | FoS 1,5 x kompozit 1,2 | 0,560 | Kollár & Springer uzun levha kesme burkulması, CLT eğilme rijitliği |
| W-WEB-08 | ana kiriş gövdesi y 1,95-2,20 m (4 kat ±45 PW, belirleyici y 1,95): gövde kesme burkulması (uzun levha, basit mesnet) | YD-04 | 20,52 | 39,51 | N/mm | FoS 1,5 x kompozit 1,2 | 0,070 | Kollár & Springer uzun levha kesme burkulması, CLT eğilme rijitliği |
| W-WEB-09 | ana kiriş gövdesi y 2,20-2,45 m (4 kat ±45 PW, belirleyici y 2,20): gövde kesme burkulması (uzun levha, basit mesnet) | YD-04 | 18,59 | 48,20 | N/mm | FoS 1,5 x kompozit 1,2 | 0,440 | Kollár & Springer uzun levha kesme burkulması, CLT eğilme rijitliği |
| W-WEB-10 | ana kiriş gövdesi y 2,45-2,70 m (4 kat ±45 PW, belirleyici y 2,45): gövde kesme burkulması (uzun levha, basit mesnet) | YD-04 | 15,91 | 58,59 | N/mm | FoS 1,5 x kompozit 1,2 | 1,046 | Kollár & Springer uzun levha kesme burkulması, CLT eğilme rijitliği |
| W-WEB-11 | ana kiriş gövdesi y 2,70-2,95 m (3 kat ±45 PW, belirleyici y 2,70): gövde kesme burkulması (uzun levha, basit mesnet) | YD-04 | 13,42 | 34,05 | N/mm | FoS 1,5 x kompozit 1,2 | 0,409 | Kollár & Springer uzun levha kesme burkulması, CLT eğilme rijitliği |
| W-WEB-12 | ana kiriş gövdesi y 2,95-3,60 m (3 kat ±45 PW, belirleyici y 2,95): gövde kesme burkulması (uzun levha, basit mesnet) | YD-04 | 9,41 | 37,37 | N/mm | FoS 1,5 x kompozit 1,2 | 1,207 | Kollár & Springer uzun levha kesme burkulması, CLT eğilme rijitliği |
| W-RWEB | arka kiriş gövdesi dış panel (3 kat ±45, belirleyici y 0,71): gövde kesme burkulması (uzun levha, basit mesnet) | YD-04 | 9,03 | 33,25 | N/mm | FoS 1,5 x kompozit 1,2 | 1,045 | Kollár & Springer uzun levha kesme burkulması, CLT eğilme rijitliği |
| W-GLOVEWEB | iç pimin içinde eldiven ana kiriş gövdeleri (2 x 8 kat ±45 PW, çatal kulakları, başlık yüzleri arasında tam derinlik, SOB'da h 60 mm), kesme: gövde kesme birim şekil değiştirmesi (ince lamine, hasar toleransı) | YD-02 | 510,2 | 5200,0 | µε | FoS 1,5 | 5,795 | STANAG 4703 UL13.1.2 (5200 µε nihai yükte) |
| W-SKINBUCK-CT | orta kutu kapağı paneli 0,40 x 0,28 m (ct_box_cover 0,4/6/0,4 mm) burkulma, bası + kesme (belirleyici y 0,05) | YD-04 | 1 | 1,86 | yük çarpanı | FoS 1,5 x kompozit 1,2 | 0,031 | Rc + Rs^2 = 1; N_c 69 N/mm, N_s 70 N/mm (CLT D*, sandviç kesme düzeltmesi); Nx yüzeyin kesit birim şekil değiştirmesinden |
| W-SKINCRIMP-CT | orta kutu kapağı (ct_box_cover 0,4/6/0,4 mm): kesme kıvrılması (çekirdek kesme kararsızlığı) | YD-04 | 37,31 | 95,61 | N/mm | FoS 1,5 x kompozit 1,2 | 0,424 | Zenkert 1995: N = G_c d^2 / c (çekirdek minimum G); N = hypot(Nx, Nxy) |
| W-SKINBUCK-GLOVE-UP | eldiven üst kutu kaplaması paneli 0,15 x 0,26 m (wing_box_skin_upper 0,6/6/0,4 mm) burkulma, bası + kesme (belirleyici y 0,44) | YD-04 | 1 | 1,95 | yük çarpanı | FoS 1,5 x kompozit 1,2 | 0,081 | Rc + Rs^2 = 1; N_c 80 N/mm, N_s 91 N/mm (CLT D*, sandviç kesme düzeltmesi); Nx yüzeyin kesit birim şekil değiştirmesinden |
| W-SKINCRIMP-GLOVE-UP | eldiven üst kutu kaplaması (wing_box_skin_upper 0,6/6/0,4 mm): kesme kıvrılması (çekirdek kesme kararsızlığı) | YD-04 | 41,20 | 98,63 | N/mm | FoS 1,5 x kompozit 1,2 | 0,330 | Zenkert 1995: N = G_c d^2 / c (çekirdek minimum G); N = hypot(Nx, Nxy) |
| W-SKINBUCK-OP-UP-IN | dış panel üst kutu kaplaması y 0,70-2,20 paneli 0,35 x 0,25 m (wing_box_skin_upper 0,6/6/0,4 mm) burkulma, bası + kesme (belirleyici y 0,71) | YD-04 | 1 | 1,87 | yük çarpanı | FoS 1,5 x kompozit 1,2 | 0,039 | Rc + Rs^2 = 1; N_c 80 N/mm, N_s 81 N/mm (CLT D*, sandviç kesme düzeltmesi); Nx yüzeyin kesit birim şekil değiştirmesinden |
| W-SKINCRIMP-OP-UP-IN | dış panel üst kutu kaplaması y 0,70-2,20 (wing_box_skin_upper 0,6/6/0,4 mm): kesme kıvrılması (çekirdek kesme kararsızlığı) | YD-04 | 42,62 | 98,63 | N/mm | FoS 1,5 x kompozit 1,2 | 0,286 | Zenkert 1995: N = G_c d^2 / c (çekirdek minimum G); N = hypot(Nx, Nxy) |
| W-SKINBUCK-OP-UP-OUT | dış panel üst kutu kaplaması y 2,20-uç paneli 0,35 x 0,16 m (wing_skin_primary 0,6/5/0,4 mm) burkulma, bası + kesme (belirleyici y 2,20) | YD-04 | 1 | 2,18 | yük çarpanı | FoS 1,5 x kompozit 1,2 | 0,211 | Rc + Rs^2 = 1; N_c 75 N/mm, N_s 76 N/mm (CLT D*, sandviç kesme düzeltmesi); Nx yüzeyin kesit birim şekil değiştirmesinden |
| W-SKINCRIMP-OP-UP-OUT | dış panel üst kutu kaplaması y 2,20-uç (wing_skin_primary 0,6/5/0,4 mm): kesme kıvrılması (çekirdek kesme kararsızlığı) | YD-04 | 34,27 | 84,75 | N/mm | FoS 1,5 x kompozit 1,2 | 0,374 | Zenkert 1995: N = G_c d^2 / c (çekirdek minimum G); N = hypot(Nx, Nxy) |
| W-SKINBUCK-GLOVE-LO | eldiven alt kutu kaplaması (negatif durum) paneli 0,15 x 0,26 m (wing_skin_primary 0,6/5/0,4 mm) burkulma, bası + kesme (belirleyici y 0,44) | YD-04 | 1 | 2,46 | yük çarpanı | FoS 1,5 x kompozit 1,2 | 0,366 | Rc + Rs^2 = 1; N_c 66 N/mm, N_s 77 N/mm (CLT D*, sandviç kesme düzeltmesi); Nx yüzeyin kesit birim şekil değiştirmesinden |
| W-SKINCRIMP-GLOVE-LO | eldiven alt kutu kaplaması (negatif durum) (wing_skin_primary 0,6/5/0,4 mm): kesme kıvrılması (çekirdek kesme kararsızlığı) | YD-04 | 26,97 | 84,75 | N/mm | FoS 1,5 x kompozit 1,2 | 0,746 | Zenkert 1995: N = G_c d^2 / c (çekirdek minimum G); N = hypot(Nx, Nxy) |
| W-SKINBUCK-OP-LO | dış panel alt kutu kaplaması (negatif durum) paneli 0,35 x 0,25 m (wing_skin_primary 0,6/5/0,4 mm) burkulma, bası + kesme (belirleyici y 0,71) | YD-04 | 1 | 2,4 | yük çarpanı | FoS 1,5 x kompozit 1,2 | 0,331 | Rc + Rs^2 = 1; N_c 66 N/mm, N_s 67 N/mm (CLT D*, sandviç kesme düzeltmesi); Nx yüzeyin kesit birim şekil değiştirmesinden |
| W-SKINCRIMP-OP-LO | dış panel alt kutu kaplaması (negatif durum) (wing_skin_primary 0,6/5/0,4 mm): kesme kıvrılması (çekirdek kesme kararsızlığı) | YD-04 | 27,48 | 84,75 | N/mm | FoS 1,5 x kompozit 1,2 | 0,713 | Zenkert 1995: N = G_c d^2 / c (çekirdek minimum G); N = hypot(Nx, Nxy) |
| W-RIBCRUSH | kanat kaburgası gövdesi (rib_panel sandviç) ezilme yükü, kolon burkulması (y 0,91, aralık 0,35 m) | YD-02 | 1,83 | 81,88 | N/mm | FoS 1,5 x kompozit 1,2 | 23,862 | Niu ch. 9 / Brazier: w = s kappa^2 sum(E A |z|) / b; kesme düzeltmeli geniş kolon (Euler) |
| W-SOB-KINK-RIB | SOB başlık rampası: gövde yanı kaburgasında kırılma kuvveti 12 katlı dolu banda (2,4 x 40 mm) | YD-07 | 77,02 | 175,4 | MPa | FoS 1,5 x kompozit 1,2 | 0,265 | QI OHC ETW as the in-plane compression limit of the land (as J-TRANS-RIB) - fix round 3, VS3-01 |
| W-SOB-KINK-PRONG | SOB başlık rampası: iç pim istasyonunda kırılma kuvveti iki kulak burç takviyesine (2 x 10 mm, 30 mm boyunca) | YD-07 | 9,14 | 175,4 | MPa | FoS 1,5 x kompozit 1,2 | 9,659 | QI OHC ETW - fix round 3, VS3-01 |
| W-SOB-KINK-ILSS | SOB başlık rampası: büyük kırılma kuvvetinin başlık-gövde / bant ara yüzey kesmesi (başlık genişliği x 30 mm) | YD-07 | 6,18 | 38,27 | MPa | FoS 1,5 x kompozit 1,2 | 2,439 | ILSS ETW B-tabanı (NCAMP PW) - fix round 3, VS3-01 |
| W-SOB-OFFSET | SOB kaburgası gövdesi (rib_panel sandviç + 30 mm kenar bantlarında yüz başına 1 kat ±45): eldiven kaplaması / kutu kapağı kaçıklık çiftinin plaka eğilmesi (kaçıklık 7,4 mm, kaplama yayılı yükü kaburgadaki kesit birim şekil değiştirmesinden) | YD-08 | 316,6 | 697,1 | N m/m | FoS 1,5 x kompozit 1,2 | 0,223 | m = N e per unit chord; M_allow = OHC (QI ETW) x t_face x face distance - fix round 3, VS3-01 |
| W-SKINBUCK-LERX-UP | eldiven LERX üst kaplaması (pozitif durum) paneli 0,15 x 0,14 m (wing_skin_primary 0,6/5/0,4 mm) burkulma, bası + kesme (belirleyici y 0,555) | YD-09 | 1 | 1,99 | yük çarpanı | FoS 1,5 x kompozit 1,2 | 0,105 | Rc + Rs^2 = 1; N_c 77 N/mm, N_s 78 N/mm (CLT D*, sandviç kesme düzeltmesi); Nx 38,6 N/mm from the plane-section strain - fix round 3, VS3-04 |
| W-SKINCRIMP-LERX-UP | eldiven LERX üst kaplaması (pozitif durum) (wing_skin_primary 0,6/5/0,4 mm): kesme kıvrılması | YD-09 | 42,50 | 84,75 | N/mm | FoS 1,5 x kompozit 1,2 | 0,108 | Zenkert 1995: N = G_c d^2 / c; N = hypot(Nx, Nxy) - fix round 3, VS3-04 |
| W-SKINDT-LERX-UP | eldiven LERX üst kaplaması (pozitif durum): yüz bası birim şekil değiştirmesi (hasar toleransı, sandviç), LERX yüzeyinin en derin noktası (belirleyici y 0,502) | YD-09 | 1712,6 | 2600,0 | µε | FoS 1,5 | 0,012 | STANAG 4703 UL13.1.2 (2600 µε sandviç kaplamalar) - fix round 3, VS3-04 |
| W-SKINBUCK-LERX-LO | eldiven LERX alt kaplaması (negatif durum) paneli 0,15 x 0,51 m (wing_skin_primary 0,6/5/0,4 mm) burkulma, bası + kesme (belirleyici y 0,405) | YD-09 | 1 | 2,17 | yük çarpanı | FoS 1,5 x kompozit 1,2 | 0,204 | Rc + Rs^2 = 1; N_c 56 N/mm, N_s 77 N/mm (CLT D*, sandviç kesme düzeltmesi); Nx 25,6 N/mm from the plane-section strain - fix round 3, VS3-04 |
| W-SKINCRIMP-LERX-LO | eldiven LERX alt kaplaması (negatif durum) (wing_skin_primary 0,6/5/0,4 mm): kesme kıvrılması | YD-09 | 26,64 | 84,75 | N/mm | FoS 1,5 x kompozit 1,2 | 0,768 | Zenkert 1995: N = G_c d^2 / c; N = hypot(Nx, Nxy) - fix round 3, VS3-04 |
| W-SKINDT-LERX-LO | eldiven LERX alt kaplaması (negatif durum): yüz bası birim şekil değiştirmesi (hasar toleransı, sandviç), LERX yüzeyinin en derin noktası (belirleyici y 0,437) | YD-09 | 1069,4 | 2600,0 | µε | FoS 1,5 | 0,621 | STANAG 4703 UL13.1.2 (2600 µε sandviç kaplamalar) - fix round 3, VS3-04 |

### Kanat dış panel birleşimi (y 0,70)

| No | Eleman / kontrol | Yük durumu | Uygulanan | İzin verilen | Birim | Katsayılar | MS | Referans |
|---|---|---|---|---|---|---|---|---|
| J-PIN-SHEAR | ana pim Ø16 Ti-6Al-4V (dış pim; düşey çift, burulma çifti ve F_y/2 bileşkesi), çift kesme | YD-05 | 21559 | 241210 | N | FoS 1,5 x sık sökme 1,5 | 3,973 | Fsu Ti-6Al-4V tavlanmış (çubuk için sac değerleri, tahmin); STANAG UL2.4 sık sökme 1,5 |
| J-PIN-BEND | ana pim eğilmesi (Melcon-Hoblit kolu, plastik kazanç yok) | YD-05 | 340,4 | 923,9 | MPa | FoS 1,5 x sık sökme 1,5 | 0,206 | M = P/2 (t_prong 10/2 + gap 0,2 + t_tongue 30/4 mm); Ftu |
| J-PIN-BUSH | ana pimin 4130 kulak burçlarında ezilmesi (2 x 10 mm) | YD-05 | 21559 | 441280 | N | FoS 1,5 x ezilme 2 | 5,823 | MMPDS 4130 Fbru (bush backed by the laminate); ezilme katsayısı 2,0 |
| J-TONGUE-BUSH | dil göbeği: burç dış çapı 22 x 30 mm, [±45/0/90] blokta ezilme | YD-05 | 32,67 | 175,4 | MPa | FoS 1,5 x ezilme 2 | 0,790 | QI open-hole compression ETW B-tabanı as a conservative bearing limit (bore e/D below the 3 of the QI bearing value; element test required); ezilme katsayısı 2,0 |
| J-PRONG-BUSH | çatal kulak takviyeleri (10 mm): burç dış çapı 22 x 10 mm ezilmesi, iki kulak | YD-05 | 49,00 | 175,4 | MPa | FoS 1,5 x ezilme 2 | 0,193 | QI OHC ETW as the bearing limit (as J-TONGUE-BUSH) |
| J-TONGUE-FLANGE-TT | dil UD başlığı: göbek bloğu altında kalınlık yönünde bası (30 x 50 mm) | YD-05 | 14,37 | 90,67 | MPa | FoS 1,5 x sık sökme 1,5 | 1,804 | UD transverse compression F2cu (B-tabanı ETW); sık sökme 1,5 |
| J-TONGUE-FLANGE-DT | dış pimde dil UD başlığı 30 x 10 mm (M = R_iç d, + F_y/2 eksenel), bası birim şekil değiştirmesi | YD-05 | 1780,2 | 3000,0 | µε | FoS 1,5 | 0,123 | STANAG 4703 UL13.1.2 (3000 µε nihai yükte); boss block not credited |
| J-TONGUE-FLANGE | dış pimde dil UD başlığı, bası gerilmesi (tek yük yolu) | YD-05 | 227,2 | 656,0 | MPa | FoS 1,5 x kompozit 1,2 | 0,604 | A-basis estimate 0,85 Fcu (CS-LUAS.613(b)); composite factor 1,2 |
| J-TONGUE-TAPER | pimler arasında dil UD başlığı kat düşürme 10 -> 3 mm: inceltme istasyonlarında bası birim şekil değiştirmesi (en kötü istasyon dış pimden x/s = 0,00, başlık 10,0 mm) | YD-05 | 1780,2 | 3000,0 | µε | FoS 1,5 | 0,123 | M(y) linear from the outer pin to zero at the inner pin (tongue_moment) + F_y/2 axial; STANAG 4703 UL13.1.2 - fix round 2 (kütle closure) |
| J-TONGUE-TAPER-DROP | dil başlığı kat düşürme eğimi (kiriş boyunca kalınlık değişimi / uzunluk), 1:20 kuralı | YD-06 | 0,0381 | 0,05 | - | geometric rule | 0,313 | materials.yaml processes.composite_moulding taper_slope_main_load_direction (1:20 minimum) |
| J-TONGUE-WEB | pimler arasında dil ±45 gövdesi (25 kat), kesme R_iç: gövde kesme birim şekil değiştirmesi (ince lamine, hasar toleransı) | YD-05 | 3027,1 | 5200,0 | µε | FoS 1,5 | 0,145 | STANAG 4703 UL13.1.2 (5200 µε nihai yükte) |
| J-PRONG-WEB | pimler arasında çatal kulakları (eldiven ana kiriş gövdeleri, 2 x 8 kat ±45, başlık yüzleri arasında tam derinlik), kesme R_dış: gövde kesme birim şekil değiştirmesi (ince lamine, hasar toleransı) | YD-05 | 2748,5 | 5200,0 | µε | FoS 1,5 | 0,261 | STANAG 4703 UL13.1.2 (5200 µε nihai yükte) |
| J-TRANS-WEB | başlık rampası (başlık başına 14,3 mm basamak, 100 mm boyunca, 8,1°): dış uçta kırılma kuvveti 25 katlı dil gövdesine, 30 mm üzerinde gövde ezilmesi | YD-05 | 34,94 | 175,4 | MPa | FoS 1,5 x kompozit 1,2 | 1,789 | F_k = F_cap sin(theta); QI OHC ETW as the in-plane compression limit of the web - fix round 2, VS2-04 |
| J-TRANS-ILSS | başlık rampası: kırılma kuvvetinin başlık-gövde ara yüzey kesmesi (başlık genişliği x 30 mm) | YD-05 | 10,43 | 38,27 | MPa | FoS 1,5 x kompozit 1,2 | 1,038 | ILSS ETW B-tabanı (NCAMP PW) - fix round 2, VS2-04 |
| J-TRANS-RIB | başlık rampası: birleşim kaburgasında kırılma kuvveti 20 katlı dolu banda (4,0 x 30 mm) | YD-05 | 77,99 | 175,4 | MPa | FoS 1,5 x kompozit 1,2 | 0,250 | QI OHC ETW - fix round 2, VS2-04 |
| J-TRANS-CAP | başlık rampası: azalan moment kolu boyunca başlık birim şekil değiştirmesi (başlıklar dil hattına kaydırılmış, takviyeli alan; kaplamalar kesitte) | YD-05 | 1407,7 | 3000,0 | µε | FoS 1,5 | 0,421 | plane sections, ramp start / middle / end; damage-tolerance strain - fix round 2, VS2-04 |
| J-TRANS-SKIN | başlık rampası: azalan başlık kolu ile kaplama birim şekil değiştirmesi (kök bölmesi kaplama takviyesi dış yüze +1 kat 0/90, 120 mm) | YD-05 | 1712,4 | 2600,0 | µε | FoS 1,5 | 0,012 | plane sections; sandwich damage-tolerance strain - fix round 2, VS2-04 |
| J-REAR-PIN-SHEAR | arka pim Ø8 Ti-6Al-4V, çift kesme (C ve F_y) | YD-05 | 2410,9 | 60302 | N | FoS 1,5 x sık sökme 1,5 | 10,117 | Ti Fsu; sık sökme 1,5 |
| J-REAR-PIN-BEND | arka pim eğilmesi (Melcon-Hoblit) | YD-05 | 98,32 | 923,9 | MPa | FoS 1,5 x sık sökme 1,5 | 3,176 | Ftu |
| J-REAR-LUG | arka kiriş kulağı 7075 (t 8, w 32, e/D 2,0): eksenel F_y + enine C, eğik etkileşim | YD-05 | 1 | 7,66 | yük çarpanı | FoS 1,5 x sık sökme 1,5 (çarpan içinde) | 6,664 | structlib.lug_axial (Bruhn D1, net section / shear-bearing K_br F_tu D t - fix round 2, VS2-09: F_tu, not F_bru); transverse allowable 0,6 x axial (conservative Bruhn trend); (Ra^1.6 + Rtr^1.6) = 1 |
| J-REAR-BR | arka pim ezilmesi: kulak 8 mm ve yuva levhaları 2 x 4 mm (7075, e/D 2) | YD-05 | 2410,9 | 63983 | N | FoS 1,5 x ezilme 2 | 7,846 | MMPDS Fbru e/D 2; ezilme katsayısı 2,0 |
| J-REAR-PLATE | yuva levhası 4 mm, düşey burulma çifti altında eğilme (kulak yüzü teması, kol 16 mm) | YD-05 | 66,86 | 461,9 | MPa | FoS 1,5 x sık sökme 1,5 | 2,071 | elastic plate strip, Fty |
| J-REAR-BOLTS-RIB | yuva bağlantısı - birleşim kaburgası: 2 x M4 Ti, tek kesme (C, F_T) | YD-05 | 327,2 | 7537,8 | N | FoS 1,5 x bağlantı 1,15 | 12,354 | Ti Fsu gövde (shank) kesitinde |
| J-REAR-BR-RIB | yuva bağlantısı cıvataları M4: birleşim kaburgası bandında ezilme (3,2 mm) | YD-05 | 327,2 | 5341,9 | N | FoS 1,5 x kompozit 1,2 | 8,069 | QI ezilme ETW (pad >= 40 % +-45, e/D >= 3) |
| J-REAR-BOLTS-WEB | yuva bağlantısı - arka kiriş gövdesi: 2 x M5 Ti, tek kesme (F_y, F_T) | YD-05 | 1187,3 | 11778 | N | FoS 1,5 x bağlantı 1,15 | 4,751 | Ti Fsu gövde (shank) kesitinde |
| J-REAR-BR-WEB | yuva bağlantısı cıvataları M5: arka kiriş gövde takviyesinde ezilme (16 kat, 3,2 mm) | YD-05 | 1187,3 | 6677,3 | N | FoS 1,5 x kompozit 1,2 | 2,125 | QI ezilme ETW |
| J-REAR-LUGFIT | arka kulak bağlantısı - dış panel arka kirişi: 4 x M5 Ti, gövde takviyesinde ezilme (3,2 mm) | YD-05 | 609,3 | 6677,3 | N | FoS 1,5 x kompozit 1,2 | 5,089 | QI ezilme ETW; resultant of C, F_y, F_T shared equally |

### Orta kanat kutusu

| No | Eleman / kontrol | Yük durumu | Uygulanan | İzin verilen | Birim | Katsayılar | MS | Referans |
|---|---|---|---|---|---|---|---|---|
| CT-WEB-MS | orta kutu gövdesi = FS-MS çerçevesi (rib_panel + yüz başına 1 kat ±45), yüz kesmesi ilk katman hasarı | YD-10 | 45,47 | 186,0 | N/mm | FoS 1,5 x kompozit 1,2 | 1,273 | CLT, kat izin verilen değerleri B-tabanı ETW |
| CT-WEBDT-MS | orta kutu gövdesi FS-MS: yüz kesme birim şekil değiştirmesi (hasar toleransı) | YD-10 | 1820,8 | 5200,0 | µε | FoS 1,5 | 0,904 | STANAG UL13.1.2 5200 µε |
| CT-WEBCRIMP-MS | orta kutu gövdesi FS-MS: kesme kıvrılması | YD-10 | 45,47 | 101,7 | N/mm | FoS 1,5 x kompozit 1,2 | 0,243 | N = G_c d^2 / c |
| CT-WEB-RS | orta kutu gövdesi = FS-RS çerçevesi (rib_panel + yüz başına 0 kat ±45), yüz kesmesi ilk katman hasarı | YD-10 | 7,56 | 97,04 | N/mm | FoS 1,5 x kompozit 1,2 | 6,132 | CLT, kat izin verilen değerleri B-tabanı ETW |
| CT-WEBDT-RS | orta kutu gövdesi FS-RS: yüz kesme birim şekil değiştirmesi (hasar toleransı) | YD-10 | 581,6 | 5200,0 | µε | FoS 1,5 | 4,961 | STANAG UL13.1.2 5200 µε |
| CT-WEBCRIMP-RS | orta kutu gövdesi FS-RS: kesme kıvrılması | YD-10 | 7,56 | 95,61 | N/mm | FoS 1,5 x kompozit 1,2 | 6,026 | N = G_c d^2 / c |
| CT-ATT-BR-MS | kutu - FS-MS çerçevesi bağlantısı taraf başına 4 x M6 Ti: çerçeve kenar bandında ezilme (3,2 mm dolu lamine) | YD-11 | 725,4 | 8012,8 | N | FoS 1,5 x kompozit 1,2 | 5,137 | QI ezilme (%2 öteleme) ETW (materials.yaml design_values_for_code) |
| CT-ATT-SH-MS | kutu - FS-MS cıvataları M6 Ti, tek kesme | YD-11 | 725,4 | 16960 | N | FoS 1,5 x bağlantı 1,15 | 12,555 | Ti-6Al-4V Fsu |
| CT-ATT-BR-RS | kutu - FS-RS çerçevesi bağlantısı taraf başına 4 x M6 Ti: çerçeve kenar bandında ezilme (3,2 mm dolu lamine) | YD-11 | 348,5 | 8012,8 | N | FoS 1,5 x kompozit 1,2 | 11,774 | QI ezilme (%2 öteleme) ETW (materials.yaml design_values_for_code) |
| CT-ATT-SH-RS | kutu - FS-RS cıvataları M6 Ti, tek kesme | YD-11 | 348,5 | 16960 | N | FoS 1,5 x bağlantı 1,15 | 27,214 | Ti-6Al-4V Fsu |
| CT-KINK | y = 0 orta kırık bağlantısı (7075): ana başlık başına veter yönü kırılma kuvveti | YD-12 | 17475 | – | N | - | gereksinim | F = 2 F_cap sin(kink); kırık bağlantısıyla sandviç kapaklara ve FS-MS gövdesine aktarılır (detay tasarım) |
| CT-KINK-COVER | kutu kapaklarının orta kırığı: kapak başına veter yönü kırılma kuvveti | YD-12 | 2881,0 | – | N | - | gereksinim | F = 2 N_cover w sin(kink), N_cover 36,9 N/mm over w 280 mm; added to CT-KINK-RIB / -BR / -RIBWEB (fix round 3, VS3-03) |
| CT-KINK-BOLTS | kırık bağlantısı kulağı - orta hat kaburgası: 5 x M6 Ti, tek kesme | YD-13 | 3495,0 | 16960 | N | FoS 1,5 x bağlantı 1,15 | 1,813 | Ti-6Al-4V Fsu - fix round 2, VS2-03 |
| CT-KINK-BR | kırık bağlantısı cıvataları: orta hat kaburgasının 16 katlı dolu bandında ezilme (3,2 mm) | YD-13 | 4071,2 | 8012,8 | N | FoS 1,5 x kompozit 1,2 | 0,093 | QI ezilme ETW; cover kink share added (conservative: it enters along the cover flanges) |
| CT-KINK-RIB | orta hat kaburgası dolu bandı: kırılma kuvvetinin bağlantı boyunca (100 mm) düzlem içi kesmesi, ilk katman hasarı | YD-13 | 203,6 | 388,2 | N/mm | FoS 1,5 x kompozit 1,2 | 0,059 | CLT (50 % +-45 land); cap + cover kink force over the fitting length |
| CT-KINK-RIBWEB | orta hat kaburgası gövdesi (rib_panel sandviç + yüz başına 1 kat ±45, uzunluk 280 mm): kırık çiftinin düzlem içi kesmesi, yüz ilk katman hasarı | YD-13 | 72,65 | 186,0 | N/mm | FoS 1,5 x kompozit 1,2 | 0,423 | q = F / L (couple of the upper and lower kink forces between the spar frames, end reactions F h / L); CLT, two faces share - fix round 3, VS3-03 |
| CT-KINK-PLATE | kırık bağlantısı levhası 40 x 2 mm 7075: kırılma kuvveti çekme / bası | YD-13 | 218,4 | 461,9 | MPa | FoS 1,5 x bağlantı 1,15 | 0,226 | Fty |

### Kuyruk

| No | Eleman / kontrol | Yük durumu | Uygulanan | İzin verilen | Birim | Katsayılar | MS | Referans |
|---|---|---|---|---|---|---|---|---|
| T-SPINDLE | stabilatör mili 25 x 1,2 mm (ti_6al_4v_annealed_sheet), dış yatakta eğilme + burulma (von Mises) | YD-14 | 365,3 | 923,9 | MPa | FoS 1,5 x bağlantı 1,15 | 0,466 | M 177 N m, T 66,9 N m; MMPDS Ftu |
| T-SPINDLE-SPL | mil kama kesiti (duvardan 0,5 mm diş derinliği), yalnız burulma (kamada eğilme: T-SPINDLE-SPL-MT) | YD-14 | 115,4 | 599,8 | MPa | FoS 1,5 x sık sökme 1,5 | 1,311 | Fsu; sık sökme 1,5 (stabilatör taşıma için sökülür) |
| T-BRG-IN | mil iç yatağı 61805-ZZ (düğüm göbeği): gerekli statik yük sayısı C0 (nihai radyal yük) | YD-14 | 1516,1 | – | N | - | gereksinim | tedarik gereksinimi: C0 >= bu değer (katalog değeri araştırma verisinde yok) |
| T-BRG-OUT | mil dış yatağı 61805-ZZ: gerekli statik yük sayısı C0 (nihai radyal yük) | YD-14 | 2242,2 | – | N | - | gereksinim | tedarik gereksinimi: C0 >= bu değer |
| T-NODE-STUB-BOLTS | kök parçası arka kiriş kök bağlantısı - dış yanak: 4 x M6 Ti-6Al-4V (y ekseni), kök momentinden çekme + R_dış kesmesi, etkileşim (en yüklü cıvata) | YD-15 | 1 | 7,9 | yük çarpanı | FoS 1,5 x bağlantı 1,15 (çarpan içinde) | 6,903 | elastik cıvata grubu (tension about the pattern centroid, contact not credited); Ti-6Al-4V (spec Ftu, sheet A-basis as bar estimate): çekme Rm A_s, kesme 0,6 Rm A_s; R_s^2 + R_t^2 = 1 |
| T-NODE-STUB-BR | kök parçası cıvataları M6: 7 mm 7075 yanakta ezilme | YD-15 | 373,7 | 41989 | N | FoS 1,5 x bağlantı 1,15 | 64,136 | MMPDS Fbru (e/D >= 2) |
| T-NODE-CHEEK | düğüm dış yanağı 7 x 86 mm: kök parçası kök momentinden burulma (açık kesit b t^3/3) + R_dış düzlem içi eğilmesi, von Mises | YD-15 | 185,5 | 530,9 | MPa | FoS 1,5 x bağlantı 1,15 | 0,659 | arm of R_out to the base 60 mm; MMPDS Ftu |
| T-NODE-INBOARD | düğüm iç kolu (gövde 3 x 42 mm, tabandan 60 mm konsol) iç yatak yükü altında, eğilme | YD-15 | 68,53 | 530,9 | MPa | FoS 1,5 x bağlantı 1,15 | 3,491 | MMPDS Ftu |
| T-NODE-BOSS | iç yatak göbeği halkası (dış Ø42 / delik Ø37 mm, duvar 2,5 x 30 mm), yatak yükü altında halka eğilmesi | YD-15 | 203,3 | 530,9 | MPa | FoS 1,5 x bağlantı 1,15 | 0,514 | thin ring under diametral load M = P R / pi (Roark table 9,2 case 1, conservative: the arm web support not credited); MMPDS Ftu |
| T-NODE-BASE-BOLTS | düğüm taban flanşı - yangın perdesi katmanı: 7 x M5 Ti-6Al-4V (x ekseni), kesme + çekme etkileşimi (en yüklü cıvata) | YD-16 | 1 | 3,66 | yük çarpanı | FoS 1,5 x bağlantı 1,15 (çarpan içinde) | 2,662 | elastik cıvata grubu (structlib.bolt_group_inplane / bolt_group_tension); Ti-6Al-4V (spec Ftu) |
| T-NODE-FW-BR | düğüm taban cıvataları M5: yangın perdesi bandında ezilme (3,2 mm dolu lamine) | YD-16 | 1233,1 | 6677,3 | N | FoS 1,5 x kompozit 1,2 | 2,008 | QI ezilme ETW; stainless spacer tubes not credited |
| T-NODE-FW-CORE | düğüm tabanı altında yangın perdesi sandviçi: taban momentinin düzlem dışı cıvata çekmesi, destek levhası çevresinin çekme yarısında çekirdek kesmesi | YD-16 | 0,459 | 1 | MPa | FoS 1,5 x kompozit 1,2 | 0,210 | tension half-perimeter 198 mm, d 6,4 mm; ROHACELL 71 WF core insert (structures.sizing.firewall.core_insert) |
| T-CROSSBOLT | stabilatör tespit çapraz cıvatası M6 Ti-6Al-4V (çift kesme), menteşe ekseni ataleti 12 g | YD-17 | 202,9 | 22284 | N | FoS 1,5 x sık sökme 1,5 | 47,810 | Ti-6Al-4V (spec Ftu), 0,6 Rm A_s |
| T-SOCKET-BR | stabilatör kök yuvası (7075 kovan) mil üzerinde ezilme, 0,10 m geçme | YD-14 | 4,2 | 999,7 | MPa | FoS 1,5 x ezilme 2 | 78,256 | doğrusal ezilme basıncı p = 6 M/(d L^2) + V/(d L); ezilme katsayısı 2,0 |
| T-SOCKET-TUBE | stabilatör kök yuvası kovanı 29 x 2,0 mm 7075, kökte eğilme | YD-14 | 155,9 | 530,9 | MPa | FoS 1,5 x sık sökme 1,5 | 0,513 | M 167 N m; MMPDS Ftu; sık sökme 1,5 |
| T-SOCKET-OD | kovanın stabilatör kök kaburgası / kiriş laminesi üzerinde ezilmesi (geçme uçları) | YD-14 | 3,62 | 175,4 | MPa | FoS 1,5 x ezilme 2 | 15,130 | p = 6 M/(D L^2) + V/(D L); QI OHC ETW as the bearing limit; ezilme katsayısı 2,0 |
| T-SPINDLE-SPL-MT | kama kökünde mil (mil ucundan 20 mm, 0,5 mm dişlerle incelmiş duvar): eğilme (yuva moment dağılımı) + burulma, von Mises | YD-14 | 208,6 | 923,9 | MPa | FoS 1,5 x sık sökme 1,5 | 0,968 | M_spline = 6 M_s / L^2 (l^2/2 - l^3/(3L)) = 17,4 N m (linear socket pressure, M_s 167 N m at the mouth); fix round 2, VS2-08 |
| T-SPLINE | 25 mm evolvent kama dişleri (0,9 d'de kesme, dişlerin yarısı etkin) | YD-14 | 1,68 | 599,8 | MPa | FoS 1,5 x sık sökme 1,5 | > 100 | basitleştirilmiş kama kesmesi; Fsu |
| T-STABSPAR | stabilatör panel kirişi başlığı (12 kat x 25 mm UD) yuva ucunda, bası birim şekil değiştirmesi | YD-14 | 382,2 | 3000,0 | µε | FoS 1,5 | 4,233 | derinlik 62 mm x/c 0,51; STANAG UL13.1.2 |
| T-STABSKIN | stabilatör kaplaması (tail_skin 0,6/4/0,4 mm) yuva ucunda: açıklık yönü basısında kesme kıvrılması | YD-14 | 19,89 | 70,93 | N/mm | FoS 1,5 x kompozit 1,2 | 0,981 | Zenkert 1995: N = G_c d^2 / c |
| T-FINSPAR | dikey ön kiriş başlığı (12 kat x 25 mm UD) kök bağlantısında, bası birim şekil değiştirmesi | YD-18 | 337,5 | 3000,0 | µε | FoS 1,5 | 4,926 | STANAG UL13.1.2 |
| T-FINSKIN | dikey kaplaması (tail_skin 0,6/4/0,4 mm) kökte: eğilme basısında kesme kıvrılması | YD-18 | 16,92 | 70,93 | N/mm | FoS 1,5 x kompozit 1,2 | 1,328 | Zenkert 1995: N = G_c d^2 / c |
| T-FINROOT-FRONT | dikey ön kiriş kök bağlantısı YK250-CH-096: 2 x M6 Ti-6Al-4V çift kesme (başlık cıvataları 45 mm aralık) | YD-18 | 2930,1 | 22284 | N | FoS 1,5 x bağlantı 1,15 | 3,409 | Ti-6Al-4V (spec Ftu), 0,6 Rm A_s |
| T-FINROOT-BR-FRONT | dikey ön kiriş kök bağlantısı: 7075 köşebent kulak ezilmesi (t 5 mm) | YD-18 | 2930,1 | 29992 | N | FoS 1,5 x bağlantı 1,15 | 4,934 | MMPDS Fbru |
| T-FINFIT-FR-FRONT | dikey bağlantısı YK250-CH-096 - FS3480: 2 x M6, çerçeve kenar bandında ezilme (3,2 mm, en küçük cıvata) | YD-18 | 2930,1 | 8012,8 | N | FoS 1,5 x kompozit 1,2 | 0,519 | QI ezilme ETW |
| T-FINROOT-REAR | dikey arka kiriş kök bağlantısı YK250-CH-086: 2 x M6 Ti-6Al-4V çift kesme (başlık cıvataları 45 mm aralık) | YD-18 | 1968,3 | 22284 | N | FoS 1,5 x bağlantı 1,15 | 5,563 | Ti-6Al-4V (spec Ftu), 0,6 Rm A_s |
| T-FINROOT-BR-REAR | dikey arka kiriş kök bağlantısı: 7075 köşebent kulak ezilmesi (t 5 mm) | YD-18 | 1968,3 | 29992 | N | FoS 1,5 x bağlantı 1,15 | 7,833 | MMPDS Fbru |
| T-FINFIT-FR-REAR | dikey bağlantısı YK250-CH-086 - FS3670: 2 x M5 + 2 x M8, çerçeve kenar bandında ezilme (3,2 mm, en küçük cıvata) | YD-18 | 984,2 | 6677,3 | N | FoS 1,5 x kompozit 1,2 | 2,769 | QI ezilme ETW |
| T-VENTRAL-BOLT | ventral kök bağlantıları: en yüklü kulak cıvatası M6 Ti-6Al-4V çift kesme | YD-19 | 3098,9 | 22284 | N | FoS 1,5 x bağlantı 1,15 | 3,169 | elastik cıvata grubu (omurga hattında 3 kulak); Ti-6Al-4V (spec Ftu), 0,6 Rm A_s |
| T-VENTRAL-LUG | ventral kök kulağı ezilmesi (7075, t 6 mm) | YD-19 | 3098,9 | 35991 | N | FoS 1,5 x bağlantı 1,15 | 5,733 | MMPDS Fbru |
| T-AFTKEEL | arka omurga kirişi M-AFTKEEL (talaşlı 7075-T651 U 24 x 40 x 2,5) FS3738 gerisinde konsol, eğilme | YD-19 | 273,5 | 461,9 | MPa | FoS 1,5 | 0,126 | M = en arka ventral kulak yükü x FS3738'e kol; Fty (akma üstünde yerel flanş buruşması hesaba katılmadı) |
| T-NODE-TEMP | silindir kafası bölgesinde stabilatör düğümü F-SPINDLE-NODE (7075-T651): düğüm tasarım sıcaklığında metal satırlarının gerektirdiği dayanım oranı | YD-14 | 0,661 | – | F_tu(T) / F_tu(RT) | - | gereksinim | belirleyici T-NODE-BOSS (MS 0,51 at room temperature): the 7075 strength at the node temperature must stay >= this fraction of RT; MMPDS elevated-temperature curves are not in the research data and the node temperature is not known (61805-ZZ bearing, stainless baffle between heads and node, layout.heat_protection): open item - measure in the engine run (fix round 2, PK2-09) |

### Kumanda yüzeyleri

| No | Eleman / kontrol | Yük durumu | Uygulanan | İzin verilen | Birim | Katsayılar | MS | Referans |
|---|---|---|---|---|---|---|---|---|
| C-HINGE-AILERON | kanatçık menteşesi: Ø4 paslanmaz pim, 3 mm 7075 dirsek kulağında ezilme (6,67 toplam) | YD-20 | 241,5 | 12907 | N | 6,67 toplam | 7,014 | CS-LUAS.657 menteşe ezilme katsayısı 6,67; MMPDS Fbru |
| C-HPIN-AILERON | kanatçık menteşe pimi Ø4 (304), çift kesme | YD-20 | 241,5 | 8664,3 | N | FoS 1,5 x bağlantı 1,15 | 19,801 | MMPDS 304 Fsu |
| C-HLINE-AILERON | kanatçık menteşe ekseni dayanağı (eksenel ataleti tek menteşe taşır), dirsek kulağı ezilmesi | YD-21 | 53,48 | 12907 | N | 6,67 toplam | 35,184 | CS-LUAS.657 |
| C-RODEND-AILERON | kanatçık itme çubuğu ucu cıvatası M3 Ti-6Al-4V boynuzda (t 3 mm 7075), ezilme (3,33 toplam) | YD-22 | 540,9 | 9680,4 | N | 3,33 toplam | 4,375 | CS-LUAS.693 itme-çekme bağlantı katsayısı 3,33 |
| C-PUSHROD-AILERON | kanatçık itme çubuğu 7075 boru 6 x 1 mm, L 160 mm, kolon | YD-22 | 540,9 | 1397,7 | N | FoS 1,5 | 0,723 | Johnson-Euler (Euler), mafsallı uçlar |
| C-ACTMOUNT-AILERON | kanatçık eyleyici bağlantısı: servo çerçevesinde 4 x M4 gömülü burç (2,0 mm dolu lamine), burç başına yüz ezilmesi (moment payı 1,5) | YD-22 | 202,8 | 7512,0 | N | FoS 1,5 x kompozit 1,2 | 19,575 | burç flanşı çapında (9 mm) QI ezilme |
| C-GGUST-AILERON | kanatçık yer rüzgârı menteşe momenti / eyleyici anma torku x en küçük bağlantı oranı (enerjili tutma) | YD-23 | 1,32 | 5,4 | N m | limit / anma (işlevsel) | 3,091 | CS-VLA 415; pay sağlanırsa rüzgâr kilidi gerekmez |
| C-HINGE-FLAP | flap menteşesi: Ø4 paslanmaz pim, 3 mm 7075 dirsek kulağında ezilme (6,67 toplam) | YD-24 | 307,0 | 12907 | N | 6,67 toplam | 5,304 | CS-LUAS.657 menteşe ezilme katsayısı 6,67; MMPDS Fbru |
| C-HPIN-FLAP | flap menteşe pimi Ø4 (304), çift kesme | YD-24 | 307,0 | 8664,3 | N | FoS 1,5 x bağlantı 1,15 | 15,363 | MMPDS 304 Fsu |
| C-HLINE-FLAP | flap menteşe ekseni dayanağı (eksenel ataleti tek menteşe taşır), dirsek kulağı ezilmesi | YD-21 | 78,94 | 12907 | N | 6,67 toplam | 23,514 | CS-LUAS.657 |
| C-RODEND-FLAP | flap itme çubuğu ucu cıvatası M3 Ti-6Al-4V boynuzda (t 3 mm 7075), ezilme (3,33 toplam) | YD-25 | 1395,7 | 9680,4 | N | 3,33 toplam | 1,083 | CS-LUAS.693 itme-çekme bağlantı katsayısı 3,33 |
| C-PUSHROD-FLAP | flap itme çubuğu 7075 boru 6 x 1 mm, L 100 mm, kolon | YD-25 | 1395,7 | 3578,2 | N | FoS 1,5 | 0,709 | Johnson-Euler (Euler), mafsallı uçlar |
| C-ACTMOUNT-FLAP | flap eyleyici bağlantısı: servo çerçevesinde 4 x M4 gömülü burç (2,0 mm dolu lamine), burç başına yüz ezilmesi (moment payı 1,5) | YD-25 | 523,4 | 7512,0 | N | FoS 1,5 x kompozit 1,2 | 6,974 | burç flanşı çapında (9 mm) QI ezilme |
| C-GGUST-FLAP | flap yer rüzgârı menteşe momenti / eyleyici anma torku x en küçük bağlantı oranı (enerjili tutma) | YD-23 | 3,18 | 16,00 | N m | limit / anma (işlevsel) | 4,024 | CS-VLA 415; pay sağlanırsa rüzgâr kilidi gerekmez |
| C-HINGE-RUDDER | dümen menteşesi: Ø4 paslanmaz pim, 3 mm 7075 dirsek kulağında ezilme (6,67 toplam) | YD-26 | 206,8 | 12907 | N | 6,67 toplam | 8,359 | CS-LUAS.657 menteşe ezilme katsayısı 6,67; MMPDS Fbru |
| C-HPIN-RUDDER | dümen menteşe pimi Ø4 (304), çift kesme | YD-26 | 206,8 | 8664,3 | N | FoS 1,5 x bağlantı 1,15 | 23,291 | MMPDS 304 Fsu |
| C-HLINE-RUDDER | dümen menteşe ekseni dayanağı (eksenel ataleti tek menteşe taşır), dirsek kulağı ezilmesi | YD-27 | 101,5 | 12907 | N | 6,67 toplam | 18,063 | CS-LUAS.657 |
| C-RODEND-RUDDER | dümen itme çubuğu ucu cıvatası M3 Ti-6Al-4V boynuzda (t 3 mm 7075), ezilme (3,33 toplam) | YD-28 | 758,9 | 9680,4 | N | 3,33 toplam | 2,831 | CS-LUAS.693 itme-çekme bağlantı katsayısı 3,33 |
| C-PUSHROD-RUDDER | dümen itme çubuğu 7075 boru 6 x 1 mm, L 80 mm, kolon | YD-28 | 758,9 | 4975,8 | N | FoS 1,5 | 3,371 | Johnson-Euler (Johnson), mafsallı uçlar |
| C-ACTMOUNT-RUDDER | dümen eyleyici bağlantısı: servo çerçevesinde 4 x M4 gömülü burç (2,0 mm dolu lamine), burç başına yüz ezilmesi (moment payı 1,5) | YD-28 | 284,6 | 7512,0 | N | FoS 1,5 x kompozit 1,2 | 13,664 | burç flanşı çapında (9 mm) QI ezilme |
| C-GGUST-RUDDER | dümen yer rüzgârı menteşe momenti / eyleyici anma torku x en küçük bağlantı oranı (enerjili tutma) | YD-23 | 2,41 | 5,4 | N m | limit / anma (işlevsel) | 1,241 | CS-VLA 415; pay sağlanırsa rüzgâr kilidi gerekmez |

### İniş takımı

| No | Eleman / kontrol | Yük durumu | Uygulanan | İzin verilen | Birim | Katsayılar | MS | Referans |
|---|---|---|---|---|---|---|---|---|
| G-LAND-ROT | iki noktalı düz iniş: AM'nin gerisindeki ana takım tepkisinden yunuslama ivmesi (I_yy 113 kg m2, aerodinamik sönüm yok) ve x 3,80'de (motor bölgesi) düşey yük katsayısı | YD-29 | 9,26 | – | - | - | gereksinim | applied in the engine-mount landing case (E-*); the research target n <= 4,0 needs a ~0,2 m stroke (not met with 80 mm + tyre: design n_j / n are the computed values) |
| G-MLEG | ana bacak dış silindiri 42 x 3,5 mm 7075, mafsal çatalında eğilme + eksenel (belirleyici: level_spring_back) | YD-30 | 179,1 | 537,8 | MPa | FoS 1,5 | 1,002 | elastik, Ftu (çubuk için 7075-T6 sac değerleri, tahmin) |
| G-TRUN-BR | mafsal yatak kulağı (7075, Ø20, t 12 mm, e/D 1,09 < 2: kulak istisnası), kesme-ezilme (belirleyici: level_spring_back) | YD-30 | 7778,6 | 67658 | N | FoS 1,5 x ezilme 2 | 1,899 | Bruhn D1.5 lug shear-bearing at the actual e/D: P = K_br F_tu D t, K_br 0,53 (structlib.lug_axial, conservative fit); ezilme katsayısı 2,0 (dönen bağlantı) - fix round 1, S1-09 |
| G-TRUN-NET | mafsal kulağı net kesiti (w 49 mm, D 20 mm) | YD-30 | 7778,6 | 169766 | N | FoS 1,5 x bağlantı 1,15 | 11,652 | Bruhn D1: K_t 0,92 F_tu (w - D) t |
| G-TRUN-PIN | mafsal muylusu Ø20 (4130), tek kesme | YD-30 | 7778,6 | 123465 | N | FoS 1,5 x bağlantı 1,15 | 8,201 | MMPDS 4130 Fsu |
| G-TRUN-AXLE-BEND | mafsal muylusu Ø20 eğilmesi: yatak yükü, çatal kolu yüzünden burç merkezine 13 mm kol (konsol), elastik | YD-30 | 128,8 | 655,0 | MPa | FoS 1,5 x bağlantı 1,15 | 1,949 | M = R_b arm, sigma = 32 M / (pi d^3); MMPDS 4130 Ftu (no plastic bending credit) - fix round 2, PK2-04 stub-axle scheme |
| G-TRUN-SO | mafsal kulağı kesme yırtılması (e 21,8 mm) | YD-30 | 7778,6 | 100607 | N | FoS 1,5 x bağlantı 1,15 | 6,498 | Bruhn D1: 2 t (e - D/2 cos 40) Fsu at the actual edge distance |
| G-DOWNLOCK | ana takım aşağı kilit cıvatası Ø14 (4130), toplama ekseninden r 25 mm, tek kesme (belirleyici: level_max_vertical) | YD-30 | 11151 | 60498 | N | FoS 1,5 x bağlantı 1,15 | 2,145 | mafsal ekseni etrafında moment / kilit yarıçapı |
| G-DOWNLOCK-BEND | ana takım aşağı kilit cıvatası Ø14 eğilmesi, tek kesme (kulak deliğinden ankastre: boşluk 1,0 mm + 11,5 mm kavramanın yarısı), elastik (belirleyici: level_max_vertical) | YD-30 | 279,4 | 655,0 | MPa | FoS 1,5 x bağlantı 1,15 | 0,359 | M = P (gap + engagement / 2), structlib.pin_bending_stress, Ftu (no plastic factor) - gear detail round GD-03 |
| G-FIT-BOLTS | mafsal bağlantısı cıvata grubu (5 x M6 12.9 y ekseni takım kirişine, 4 x M6 12.9 z ekseni kuyu tavanına): esnek cıvatalar üzerinde rijit bağlantı, mafsalda kuvvet + üç moment, kesme / çekme etkileşimi (belirleyici: level_spring_back, bolt B5) | YD-30 | 1 | 3,57 | yük çarpanı | FoS 1,5 x bağlantı 1,15 (çarpan içinde) | 1,071 | structlib.bolt_group_6dof (equal bolt stiffness, estimate); ISO 898-1 12.9; R_s^2 + R_t^2 = 1 - fix round 2, VS2-02 (was: |F| / 10 x 1,5 bearing only) |
| G-FIT-BR | mafsal bağlantısı cıvataları: en yüklü cıvatanın 16 katlı dolu bantta ezilmesi (t 3,2 mm) (belirleyici: level_spring_back, bolt B5) | YD-30 | 2387,6 | 8012,8 | N | FoS 1,5 x kompozit 1,2 | 0,864 | QI ezilme ETW (6-DOF bolt shear) |
| G-FIT-PULL-BEAM | takım kirişi ankrajları: ankraj flanşının (OD 14) 16 katlı banttan sıyrılması, en yüklü cıvata (belirleyici: side_inboard) | YD-30 | 1127,5 | 5403,5 | N | FoS 1,5 x kompozit 1,2 | 1,662 | punching shear pi D t ILSS ETW B-tabanı (estimate until test) |
| G-FIT-PULL-ROOF | kuyu tavanı kubbe somun plakaları: somun plakası tabanının (20 mm) 16 katlı tavan bandından sıyrılması, en yüklü cıvata (belirleyici: level_spring_back) | YD-30 | 1426,0 | 9828,4 | N | FoS 1,5 x kompozit 1,2 | 2,829 | punching shear (square base perimeter) x t x ILSS ETW B-tabanı (estimate until test) |
| G-BEAM-CAP | ana takım kirişi UD başlıkları (12 kat x 20 mm) bacak hizasında eğilme (çentik derinliği 67 mm), düşey yük + sürükleme çifti M_y, bası birim şekil değiştirmesi (belirleyici: level_spring_back) | YD-30 | 1957,3 | 3000,0 | µε | FoS 1,5 | 0,022 | kuyu duvarı ile FS-GEAR arasında basit mesnetli; the lower cap runs up round the notch (fix round 2, VS2-02 / PK2-03) |
| G-BEAM-WEB | ana takım kirişi sandviç duvarı (rib_panel) bağlantı yanında yüz kesmesi (tam derinlik 91 mm), düşey yük + sürükleme çifti, ilk katman hasarı (belirleyici: level_spring_back) | YD-30 | 42,91 | 97,04 | N/mm | FoS 1,5 x kompozit 1,2 | 0,257 | CLT |
| G-BEAM-NOTCH | bacak çentiğinde takım kirişi: kesme F-TRUNNION'ın çentiği köprüleyen 7075 flanşında (43 x 8 mm; çentikli kompozit duvar sayılmadı) (belirleyici: level_spring_back) | YD-30 | 16,20 | 296,5 | MPa | FoS 1,5 x bağlantı 1,15 | 9,608 | parabolic shear 1,5 V / (h t), Fsu - fix round 2, PK2-03 / VS2-02 |
| G-BEAM-END | takım kirişi uç bağlantıları: uç başına 3 x M5 Ti, sürükleme çifti M_y / L dahil uç tepkisinin kesmesi (belirleyici: level_spring_back) | YD-30 | 1244,3 | 11778 | N | FoS 1,5 x bağlantı 1,15 | 4,487 | Ti Fsu, single shear |
| G-BEAM-TORSION | bacak yuvarlanma momenti M_x ve sürükleme çifti F-TRUNNION cıvatalarından: kuyu tavanı ve alt kaplama kenarları arasında takım kirişi duvarı (rib_panel), cıvata kuvvetleri altında levha eğilmesi (6 serbestlik), yüz ilk katman hasarı (belirleyici: side_inboard) | YD-30 | 30,57 | 98,85 | N/mm | FoS 1,5 x kompozit 1,2 | 0,797 | simply supported strip, effective width = bolt-pattern length + 30 mm; face force = m / d; CLT - fix round 2, VS2-02 (defined M_x path: beam wall and well roof as plates, their edges on the roof / skin / keel-web diaphragms) |
| G-ROOF-TORSION | bacak yuvarlanma momenti M_x ve sürükleme çifti F-TRUNNION cıvatalarından: takım kirişi ile omurga perdesi arasında kuyu tavanı (yakıt bölmesi tabanı + bağlantı altında yüz başına 1 kat 0/90), cıvata kuvvetleri altında levha eğilmesi (6 serbestlik), yüz ilk katman hasarı (belirleyici: side_inboard) | YD-30 | 125,9 | 282,7 | N/mm | FoS 1,5 x kompozit 1,2 | 0,248 | simply supported strip, effective width = bolt-pattern length + 30 mm; face force = m / d; CLT - fix round 2, VS2-02 (defined M_x path: beam wall and well roof as plates, their edges on the roof / skin / keel-web diaphragms) |
| G-NLEG | burun bacağı 36 x 3,0 mm 7075, mafsal çatalında eğilme + eksenel (belirleyici: three_point_spin_up) | YD-31 | 83,73 | 537,8 | MPa | FoS 1,5 | 3,282 | elastik, Ftu |
| G-NPIVOT-BR | burun mafsal blokları (7075, 2 x 6 mm, flanşlı burç dış çapı 22, e/D 0,91): burcun bloklarda kesme-ezilmesi (belirleyici: three_point_level) | YD-31 | 1371,8 | 51374 | N | FoS 1,5 x ezilme 2 | 11,483 | Bruhn D1.5 lug at the actual e/D (K_br 0,37, F_tu); ezilme katsayısı 2,0 |
| G-NPIVOT-PIN | burun mafsal muyluları 2 x Ø16 (4130, dolu, flanşlı), her biri tek kesme | YD-31 | 1371,8 | 158035 | N | FoS 1,5 x bağlantı 1,15 | 65,784 | MMPDS 4130 Fsu; the pivot load shared by the two axles |
| G-NPIVOT-AXLE-BEND | burun mafsal muylusu Ø16 eğilmesi: mafsal yükünün yarısı, çatal kolu yüzünden burç merkezine 9 mm kol (konsol), elastik | YD-31 | 15,35 | 655,0 | MPa | FoS 1,5 x bağlantı 1,15 | 23,735 | M = (P/2) arm, sigma = 32 M / (pi d^3); MMPDS 4130 Ftu (no plastic bending credit) - fix round 2, PK2-04 stub-axle scheme |
| G-TOW-NLEG | çekme yükü altında burun bacağı (çatal dingili; belirleyici: +30 deg from the aft drag axis) | YD-32 | 60,61 | 537,8 | MPa | FoS 1,5 | 4,915 | elastik, Ftu - fix round 2, VS2-12 |
| G-TOW-PIVOT | çekme yükü altında burun mafsal blokları (burçların kesme-ezilmesi) | YD-32 | 441,0 | 51374 | N | FoS 1,5 x ezilme 2 | 37,831 | Bruhn D1.5 lug (as G-NPIVOT-BR); ezilme katsayısı 2,0 |
| G-NPIVOT-WALL | burun mafsal bloğu - omurga duvarı: taraf başına 4 x M6 Ti, CFRP bantta ezilme (t 3,2 mm) | YD-31 | 257,2 | 8012,8 | N | FoS 1,5 x kompozit 1,2 | 16,307 | en yüklü cıvata 1,5 x ortalama; QI ezilme ETW |
| G-NLOCK | burun aşağı kilidi (keel duvarlarına ölü nokta bağlantısı): mafsal ekseni etrafında limit moment | YD-31 | 192,6 | – | N m | - | gereksinim | belirleyici three_point_spin_up; kilit bağlantısı (takım ünitesi) bu moment x 1,5 x 1,15 için boyutlandırılır |
| G-KEELWALL | omurga duvarı (rib_panel) burun mafsalı ile FS0600 arasında kesme, yüz ilk katman hasarı | YD-31 | 2,72 | 97,04 | N/mm | FoS 1,5 x kompozit 1,2 | 18,837 | CLT |
| G-EMA-MAIN | ana takım toplama EMA'sı: mafsal ekseninde gerekli çıkış torku (n 2'de ağırlık momenti x 1,25; sürükleme eksene paralel) | YD-33 | 14,03 | – | N m | - | gereksinim | takım ünitesi EMA gereksinimi (CS-LUAS.395 benzeri) |
| G-EMA-NOSE | burun takımı toplama EMA'sı: mafsal ekseninde gerekli çıkış torku (1,25 x (n 2'de ağırlık momenti + teker/bacak sürüklemesi x bacak boyu, akışa karşı açılma)) | YD-33 | 25,71 | – | N m | - | gereksinim | takım ünitesi EMA gereksinimi |
| G-DOOR-HINGE | ana iç kapak menteşeleri (3 x Ø4 pim, 3 mm 7075 kulak), ezilme | YD-34 | 62,55 | 12907 | N | FoS 1,5 x ezilme 2 | 67,785 | ezilme katsayısı 2,0 (dönen bağlantı) |
| G-DOOR-LOCK | ana iç kapak: kapalı konumda tutma momenti (gereksinim: ölü nokta bağlantısı veya kapak kilidi; DA 22 anma torku 1,8 N m için bağlantı oranı >= değer / 1,8) | YD-34 | 17,64 | – | N m | - | gereksinim | nihai tutma momenti; kapalı kapağı tutmak için eyleyiciye güvenilmez |
| G-DOOR-DRIVE | ana iç kapak tahriki Volz DA 30 (EQ-DOORACT, yalnız iç kapak; düzeltme turu 3 PK3-07, entegrasyon turu IR-02): |Cp| 1,0 basınç üst sınırında 95 derecelik kapak işi / DA 30 anma torku 8,0 N m x krank hareketi 131 derece = 18,3 J (DA 22: 4,1 J) | YD-35 | 9,34 | 18,29 | J | FoS 1,5 (işlevsel) | 0,306 | components.yaml volz_da30 anma torku (continuous duty at rated speed); the closed door is held by the over-centre lock (G-DOOR-LOCK) |
| G-TDOOR-LINK | ana mafsal kapağı (kendi mikro dişli motoru, krank + biyel, kapalıyken ölü nokta ötesi; GD-07): kapak menteşe momenti (V_LO'da hava yükü + ağırlık, limit) | YD-35 | 0,257 | – | N m | - | gereksinim | requirement for the gearmotor (estimate class ~0,3 N m output, docs/detail/gear.md) |
| G-NDOOR-DRIVE | burun kapağı tahriki: iki kapak için tek Volz DA 22 (EQ-NDOORACT, kol NDOOR-LINKAGE), gerekli tork / anma torku | YD-36 | 0,632 | 1,8 | N m | FoS 1,5 (işlevsel) | 0,898 | components.yaml volz_da22_28v anma torku; the closed doors are held by the over-centre lock, not by the actuator |
| G-UPLOCK | ana yukarı kilit bağlantısı F-UPLOCK: kuyu tavanının dökme insertlerine 4 x M5 (dökme r 12 mm, çekirdek 5,6 mm), insert sökülmesi (en yüklü, kanca kaçıklığı) | YD-58 | 165,2 | 422,2 | N | FoS 1,5 x kompozit 1,2 | 0,420 | structlib.insert_pullout P = 2 pi b_p c tau_c (core minimum shear, no test correction) |

### Motor bağlantısı

| No | Eleman / kontrol | Yük durumu | Uygulanan | İzin verilen | Birim | Katsayılar | MS | Referans |
|---|---|---|---|---|---|---|---|---|
| E-STRUT_C | motor bağlantı çubuğu 12,7 x 0,89 mm 4130, kolon (Johnson-Euler, K 1) | YD-37 | 1 | 1,95 | yük çarpanı | katsayılı yükte çarpan | 0,951 | doğrudan rijitlik yöntemiyle uzay kafes (structlib.truss3d); MMPDS 4130 N, kaynak yakını Ftu 80 ksi (AC 43.13-1B); crankcase bolts ISO 898-1 12.9, firewall-foot bolts Ti-6Al-4V (spec Ftu); yükler zaten x FoS (limit durumlar) ve x 1,15 (cıvatalar) |
| E-STRUT_T | motor bağlantı çubuğu, kaynak yakını Ftu ile çekme | YD-37 | 1 | 2,13 | yük çarpanı | katsayılı yükte çarpan | 1,132 | doğrudan rijitlik yöntemiyle uzay kafes (structlib.truss3d); MMPDS 4130 N, kaynak yakını Ftu 80 ksi (AC 43.13-1B); crankcase bolts ISO 898-1 12.9, firewall-foot bolts Ti-6Al-4V (spec Ftu); yükler zaten x FoS (limit durumlar) ve x 1,15 (cıvatalar) |
| E-RING_C | sönümleyici halkası 15,9 x 0,89 mm 4130, kolon + yerel eğilme | YD-37 | 1 | 2,99 | yük çarpanı | katsayılı yükte çarpan | 1,994 | doğrudan rijitlik yöntemiyle uzay kafes (structlib.truss3d); MMPDS 4130 N, kaynak yakını Ftu 80 ksi (AC 43.13-1B); crankcase bolts ISO 898-1 12.9, firewall-foot bolts Ti-6Al-4V (spec Ftu); yükler zaten x FoS (limit durumlar) ve x 1,15 (cıvatalar) |
| E-RING_T | sönümleyici halkası, çekme (kaynak yakını Ftu) | YD-37 | 1 | 3,48 | yük çarpanı | katsayılı yükte çarpan | 2,478 | doğrudan rijitlik yöntemiyle uzay kafes (structlib.truss3d); MMPDS 4130 N, kaynak yakını Ftu 80 ksi (AC 43.13-1B); crankcase bolts ISO 898-1 12.9, firewall-foot bolts Ti-6Al-4V (spec Ftu); yükler zaten x FoS (limit durumlar) ve x 1,15 (cıvatalar) |
| E-BOLT | sönümleyicilerdeki karter cıvataları M8 12.9, kesme + çekme etkileşimi (x 1,15 bağlantı) | YD-37 | 1 | 15,54 | yük çarpanı | katsayılı yükte çarpan | 14,542 | doğrudan rijitlik yöntemiyle uzay kafes (structlib.truss3d); MMPDS 4130 N, kaynak yakını Ftu 80 ksi (AC 43.13-1B); crankcase bolts ISO 898-1 12.9, firewall-foot bolts Ti-6Al-4V (spec Ftu); yükler zaten x FoS (limit durumlar) ve x 1,15 (cıvatalar) |
| E-FOOT | yangın perdesi ayakları, her biri 2 x M8 Ti-6Al-4V, kesme + çekme etkileşimi (x 1,15 bağlantı) | YD-37 | 1 | 4,96 | yük çarpanı | katsayılı yükte çarpan | 3,959 | doğrudan rijitlik yöntemiyle uzay kafes (structlib.truss3d); MMPDS 4130 N, kaynak yakını Ftu 80 ksi (AC 43.13-1B); crankcase bolts ISO 898-1 12.9, firewall-foot bolts Ti-6Al-4V (spec Ftu); yükler zaten x FoS (limit durumlar) ve x 1,15 (cıvatalar) |
| E-ISOLATOR | elastomer sönümleyici: gerekli nihai yük kapasitesi (sönümleyici başına en büyük bileşke; emniyet tamponu tutmalı) | YD-37 | 1769,3 | – | N | - | gereksinim | tedarik gereksinimi (Limbach sönümleyici verisi yayımlanmamış) |
| E-FOOT-BR | yangın perdesi ayakları: 2 x M8, yangın perdesi bandında ezilme (3,2 mm dolu lamine), düzlem içi ayak tepkisi | YD-38 | 3519,8 | 10684 | N | yalnız nihai x kompozit 1,2 | 1,529 | QI ezilme ETW; stainless spacer tubes not credited |

### Paraşüt

| No | Eleman / kontrol | Yük durumu | Uygulanan | İzin verilen | Birim | Katsayılar | MS | Referans |
|---|---|---|---|---|---|---|---|---|
| P-SHACKLE | kilit pimi Ø8 (Ti-6Al-4V), çift kesme | YD-39 | 13100 | 60302 | N | yalnız nihai x bağlantı 1,15 | 3,003 | Fsu of the pin material |
| P-SHACKLE-BEND | kilit pimi Ø8 eğilmesi (Melcon-Hoblit: kulaklar 6 mm, kayış makarası 5 mm, boşluklar 0,5 mm), elastik | YD-39 | 619,0 | 923,9 | MPa | yalnız nihai x bağlantı 1,15 | 0,298 | M = P/2 (t_o/2 + g + t_i/4) (structlib.pin_bending_moment), elastic stress against Ftu (no plastic bending factor credited) - fix round 2, VS2-01 |
| P-SPOOL-BR | kayış makarası (OD 12, 5 mm) pim üzerinde ezilme | YD-39 | 13100 | 55160 | N | yalnız nihai x ezilme 2 | 1,105 | Fbru; ezilme katsayısı 2,0 (rotating) |
| P-LUG-BR | U-kulak kulakları 2 x 6 mm 7075 ezilme (dönen kilit, e/D 1,94) | YD-39 | 13100 | 92976 | N | yalnız nihai x ezilme 2 | 2,549 | MMPDS Fbru at e/D 2 x (e/D)/2 below e/D 2 (linear reduction, conservative); ezilme katsayısı 2,0 |
| P-LUG | U-kulak (w 31, e 15,5 = 1,94 D, 2 x 6 mm) net kesit / kesme-ezilme | YD-39 | 13100 | 65938 | N | yalnız nihai x bağlantı 1,15 | 3,377 | structlib.lug_axial (Bruhn D1 eğilimi; shear-bearing K_br F_tu D t - fix round 2, VS2-09: F_tu, not F_bru) |
| P-FRAME-BOLTS | bağlantı - çerçeve: 2 x M5 12.9 (x ekseni), y/z bileşeninin tek kesmesi | YD-39 | 6550,0 | 10394 | N | yalnız nihai x bağlantı 1,15 | 0,380 | ISO 898-1 12.9, 0,6 Rm A_s |
| P-FRAME-BR | 2 çerçeve cıvatası altında çerçeve bandı ezilmesi (dolu lamine 32 kat, 6,4 mm) | YD-39 | 6550,0 | 13355 | N | yalnız nihai x kompozit 1,2 | 0,699 | QI ezilme ETW |
| P-FRAME | FS1810 / FS-RS çerçeve gövdesi (rib_panel): y/z bileşeninin çerçevenin iki yanına kesmesi, yüz ilk katman hasarı | YD-39 | 43,67 | 97,04 | N/mm | yalnız nihai x kompozit 1,2 | 0,852 | gövde derinliği 0,15 m kenar uzun kirişlerine kadar; CLT |
| P-SPINE-BOLTS | bağlantı - omurga tabanı: 4 x M4 12.9 (z ekseni): x bileşeni kesmesi + bağlantı momentinin çekmesi (pim çerçeve yüzünden 26 mm, tabandan 8 mm; topuk çerçeve yüzünde), etkileşim | YD-40 | 1 | 1,91 | yük çarpanı | yalnız nihai x bağlantı 1,15 (çarpan içinde) | 0,909 | ISO 898-1 12.9; R_s^2 + R_t^2 = 1 (fix round 2, VS2-01: Fz x arm now included) |
| P-SPINE-PULL | taban cıvatalarının omurga takviyesinden sıyrılması (16 kat, 3,2 mm): dört taban cıvatasının altındaki 48 x 40 mm pul levhası çevresinde zımbalama kesmesi | YD-40 | 10112 | 21623 | N | yalnız nihai x kompozit 1,2 | 0,782 | ILSS ETW B-tabanı (NCAMP PW) as the through-thickness shear estimate until a pull-through test exists - fix round 2, VS2-01 |
| P-SPINE-BR | omurga taban takviyesi (16 kat, 3,2 mm) 4 taban cıvatası altında ezilme | YD-41 | 2836,2 | 5341,9 | N | yalnız nihai x kompozit 1,2 | 0,570 | QI ezilme ETW (pad >= 40 % +-45, edge 16 mm = 3,2 D) |
| P-SPINE-AX | omurga kanalı M-SPINE (44 x 24 x 0,8 mm, flanşlar 60 mm): tam x bileşeninin eksenel gerilmesi | YD-41 | 66,89 | 175,4 | MPa | yalnız nihai x kompozit 1,2 | 1,185 | QI open-hole compression ETW (screw holes along the flanges) |
| P-SPINE-COL | çerçeveler arasında kolon olarak omurga kanalı (L 0,379 m, mafsallı, kaplama desteği sayılmadı) | YD-41 | 11345 | 49281 | N | yalnız nihai x kompozit 1,2 | 2,620 | Euler, QI modulus |
| P-SPINE-LOCAL | omurga kanalı duvarları (24 mm, iki kenar mesnetli) eksenel gerilme altında yerel burkulma | YD-41 | 66,89 | 174,2 | MPa | yalnız nihai x kompozit 1,2 | 1,170 | SS plate k = 4 (Bruhn C5), QI modulus |
| P-SPINE-SCREWS | omurga flanşları - P-MB-UPPER: 30 x M4 Ti-6Al-4V (25 mm aralık, FS1810 - FS-FUEL), x bileşeninin kesmesi (yuvarlak baş 0,8 x sınıf) | YD-41 | 378,2 | 2950,1 | N | yalnız nihai x bağlantı 1,15 | 5,784 | Ti-6Al-4V screws credited at ISO 3506-1 A2-70 (conservative) |
| P-SPINE-SCREW-BR | omurga flanşı vidaları M4: kaplamanın 1,6 mm dolu kenar bandında ezilme | YD-41 | 378,2 | 2662,1 | N | yalnız nihai x kompozit 1,2 | 4,866 | QI ezilme ETW |
| P-SPINE-SKIN | görev bölmesi üst kaplaması P-MB-UPPER (shell_secondary): net x bileşeninin omurga flanşlarından kenar uzun kirişlerine kesme akışı, yüz ilk katman hasarı | YD-41 | 14,96 | 97,04 | N/mm | yalnız nihai x kompozit 1,2 | 4,407 | CLT |

### Yakıt bölmeleri

| No | Eleman / kontrol | Yük durumu | Uygulanan | İzin verilen | Birim | Katsayılar | MS | Referans |
|---|---|---|---|---|---|---|---|---|
| F-FACE-008 | FS-FUEL perdesi (rib_panel 0,4/6/0,4 mm), açıklık 0,212 m: yüz ilk katman hasarı | YD-42 | 18,43 | 98,85 | N/mm | nihai x kompozit 1,2 | 3,470 | sandviç şerit p b^2/8; CLT B-tabanı ETW |
| F-DT-008 | FS-FUEL perdesi: yüz birim şekil değiştirmesi (sandviç, hasar toleransı) | YD-42 | 1040,9 | 2600,0 | µε | nihai | 1,498 | STANAG UL13.1.2 |
| F-CORE-008 | FS-FUEL perdesi: çekirdek kesmesi (core_rohacell_51wf) | YD-42 | 0,348 | 0,5 | MPa | nihai x kompozit 1,2 | 0,198 | tau = (p b / 2) / d; ROHACELL minimum değerler |
| F-FACE-029 | ön yakıt hücresi tabanı M-FWDDECK yük rayları arasında (rib_panel 0,4/6/0,4 mm), açıklık 0,200 m: yüz ilk katman hasarı | YD-42 | 16,40 | 98,85 | N/mm | nihai x kompozit 1,2 | 4,022 | sandviç şerit p b^2/8; CLT B-tabanı ETW |
| F-DT-029 | ön yakıt hücresi tabanı M-FWDDECK yük rayları arasında: yüz birim şekil değiştirmesi (sandviç, hasar toleransı) | YD-42 | 926,4 | 2600,0 | µε | nihai | 1,806 | STANAG UL13.1.2 |
| F-CORE-029 | ön yakıt hücresi tabanı M-FWDDECK yük rayları arasında: çekirdek kesmesi (core_rohacell_51wf) | YD-42 | 0,328 | 0,5 | MPa | nihai x kompozit 1,2 | 0,270 | tau = (p b / 2) / d; ROHACELL minimum değerler |
| F-FACE-030 | arka hücre tabanı / kuyu tavanı M-WELLROOF (fuel_floor_wellroof 0,6/5,6/0,6 mm), açıklık 0,369 m: yüz ilk katman hasarı | YD-42 | 57,63 | 190,7 | N/mm | nihai x kompozit 1,2 | 1,757 | sandviç şerit p b^2/8; CLT B-tabanı ETW |
| F-DT-030 | arka hücre tabanı / kuyu tavanı M-WELLROOF: yüz birim şekil değiştirmesi (sandviç, hasar toleransı) | YD-42 | 1844,6 | 2600,0 | µε | nihai | 0,410 | STANAG UL13.1.2 |
| F-CORE-030 | arka hücre tabanı / kuyu tavanı M-WELLROOF: çekirdek kesmesi (core_rohacell_71wf) | YD-42 | 0,625 | 1 | MPa | nihai x kompozit 1,2 | 0,334 | tau = (p b / 2) / d; ROHACELL minimum değerler |
| F-PAYRAIL | faydalı yük rayı (6061-T6 T 20 x 20 x 2,5) ön güverte takviyesi olarak, eğilme | YD-42 | 113,6 | 289,6 | MPa | nihai x bağlantı 1,15 | 1,216 | basit mesnetli, açıklık 0,298 m; MMPDS 6061-T6 Ftu |
| F-WELLWEB | kuyu omurga gövdesi M-WELLKEEL (iki gövdeden her biri, dolu PW 1,0 mm, 120 mm yükseklik) kuyu tavanı tepkisiyle eğilme | YD-42 | 10,04 | 175,4 | MPa | nihai x kompozit 1,2 | 13,565 | kiriş, açıklık 0,223 m (kuyu ön duvarından FS-GEAR'e); OHC (menteşe dirseği delikleri) |
| F-WELLWEB-BUCK | kuyu omurga gövdesi: düzlem içi eğilmede levha burkulması (k 23,9, basit mesnet) | YD-42 | 10,04 | 65,06 | MPa | nihai x kompozit 1,2 | 4,402 | Bruhn C5 / Timoshenko: k_b = 23,9 saf eğilmede; QI modülü (materials.yaml) |

### Taret asansörü ve kapakları

| No | Eleman / kontrol | Yük durumu | Uygulanan | İzin verilen | Birim | Katsayılar | MS | Referans |
|---|---|---|---|---|---|---|---|---|
| TU-SCREW | bilyalı vida d 8 x 2 ve somun: gerekli statik eksenel yük sayısı (nihai) | YD-43 | 580,2 | – | N | - | gereksinim | tedarik gereksinimi (katalog değeri araştırma verisinde yok) |
| TU-RAIL | minyatür profil raylar (her birinde 2 taşıyıcı): taşıyıcı başına gerekli statik yük sayısı (ileri + yan, nihai) | YD-43 | 257,0 | – | N | - | gereksinim | tedarik gereksinimi |
| TU-ROOF | tavan yatak bloğu: 4 x M4 Ti-6Al-4V geçme cıvata, 2 mm 7075 karşı plaka, çekme (asılı yük) | YD-43 | 126,1 | 6146,0 | N | yalnız nihai x bağlantı 1,15 | 41,369 | Ti-6Al-4V screws credited at ISO 3506-1 A2-70 Rm A_s (conservative, mass/CG closure round) |
| TU-RAILSCR | ray ucu vidaları ray ucu başına 4 x M3 Ti-6Al-4V (2 ray, 2 uç), kesme | YD-43 | 27,94 | 2112,6 | N | yalnız nihai x bağlantı 1,15 | 64,761 | 0,6 Rm A_s |
| TU-DOORDRIVE | kayar bölme kapağı tahriki: emme altında kapağı yürütme pinyon torku (ray sürtünmesi mu 0,3 tahmin, pinyon r 10 mm) / DA 22 anma torku | YD-44 | 0,133 | 1,8 | N m | FoS 1,5 (işlevsel) | 8,014 | components.yaml volz_da22_28v anma torku |
| TU-DOORRAIL | kayar kapak ray dudağı (6061-T6 ray, 2 ray x 0,12 m), emmede kapak tutma, 1 mm dudak kesmesi | YD-45 | 44,38 | 44678 | N | FoS 1,5 x bağlantı 1,15 | > 100 | 6061-T6 Fsu (ray dudağı, tahmini geometri) |
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
