ahmet6141/Drone-controller/ucav250/docs/03_yerlesim_ve_yapi_konsepti.md

# YK-250 HANÇER — Yerleşim ve yapı konsepti (faz 3, yerleşim evresi ve düzeltme turları 1–3)

**Tarih:** 10 Ekim 2026 · **Durum:** `spec.yaml → layout` ve `spec.yaml → assembly` bölümleri ayrıntılı tasarımın arayüz tanımıdır. Bağımsız doğrulamaların yerleşim bulguları düzeltildi: VPK-01 … VPK-14 (§14), PK2-01 … PK2-13 (§15) ve PK3-01 … PK3-11 (§16). `python3 -m ucav250.analysis.layout_check --check` 99 kontrolün 99'unu geçiyor; `python3 -m ucav250.analysis.sizing --check` 62 gereksinimin 62'sini karşılanmış ve 1231 türetilmiş değerin hepsini tolerans içinde buluyor (R-56
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
