ahmet6141/Drone-controller/cad/v2/out/render/rear.jpg

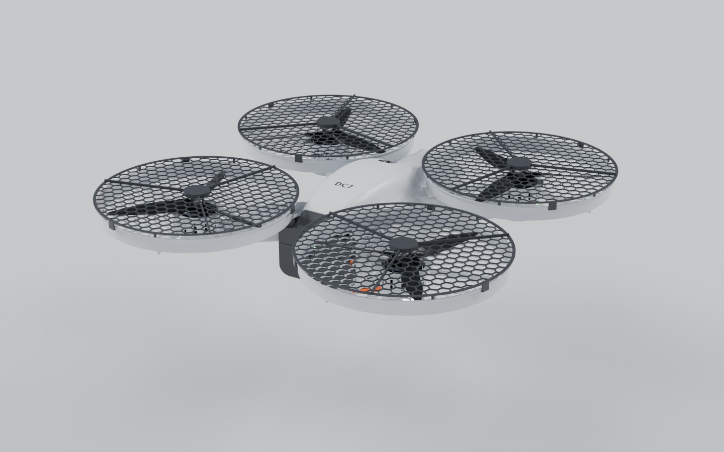
cad/v2/out/render/rear.jpg
