ahmet6141/Drone-controller/ucav250/data/concepts/endurance/constraint.png

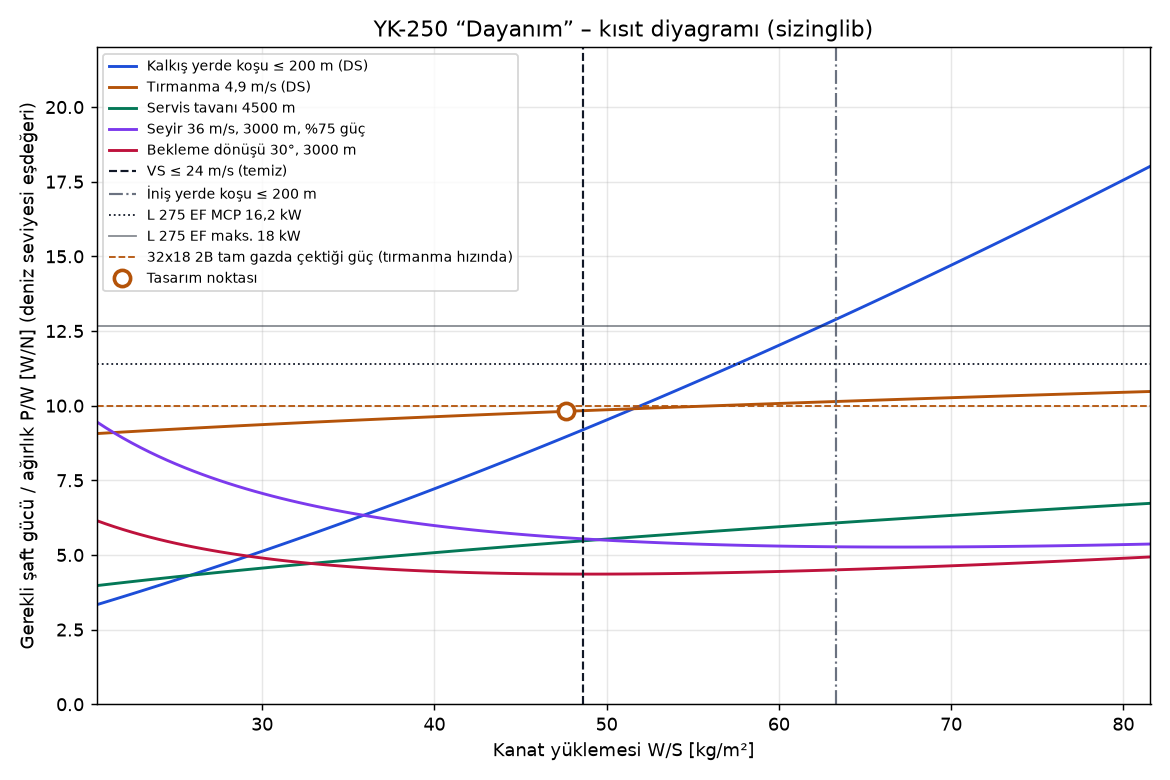
ucav250/data/concepts/endurance/constraint.png
