ahmet6141/Drone-controller/ucav250/data/concepts/endurance/sketch.png

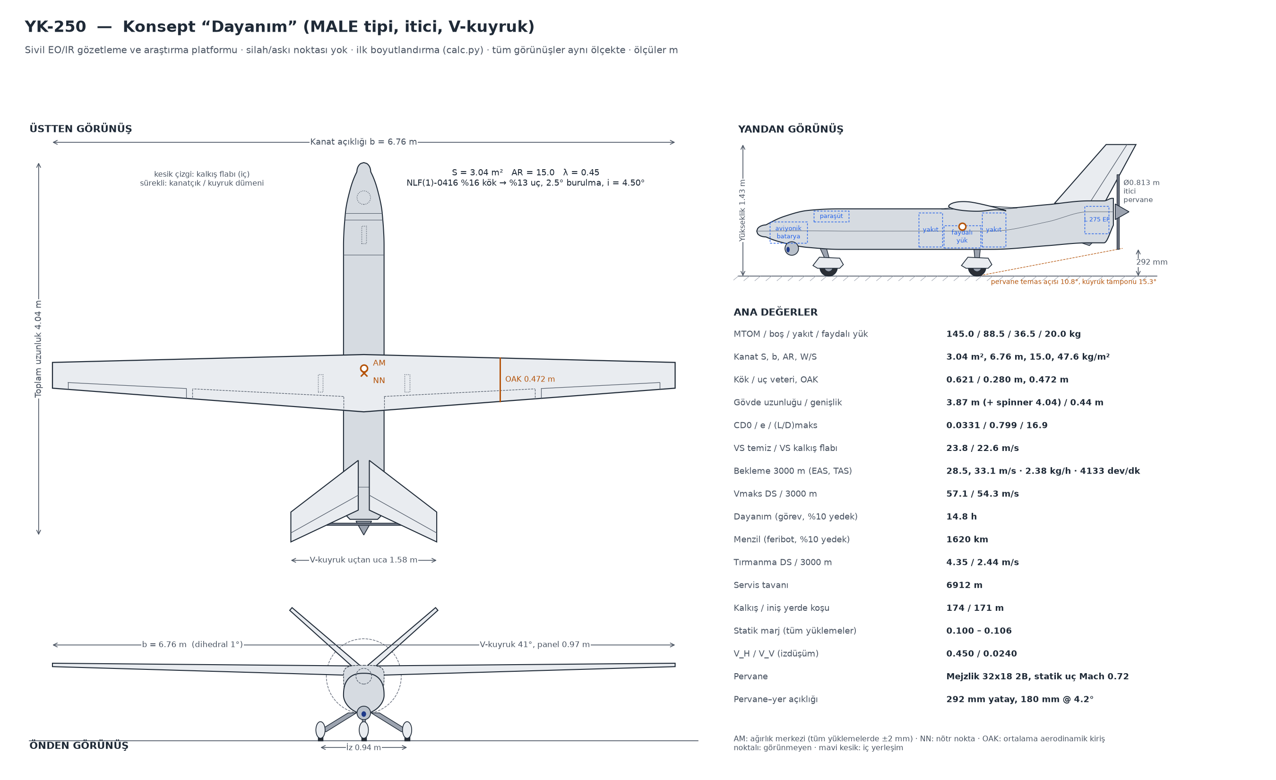
ucav250/data/concepts/endurance/sketch.png
