ahmet6141/Drone-controller/ucav250/data/concepts/identity/constraint.png

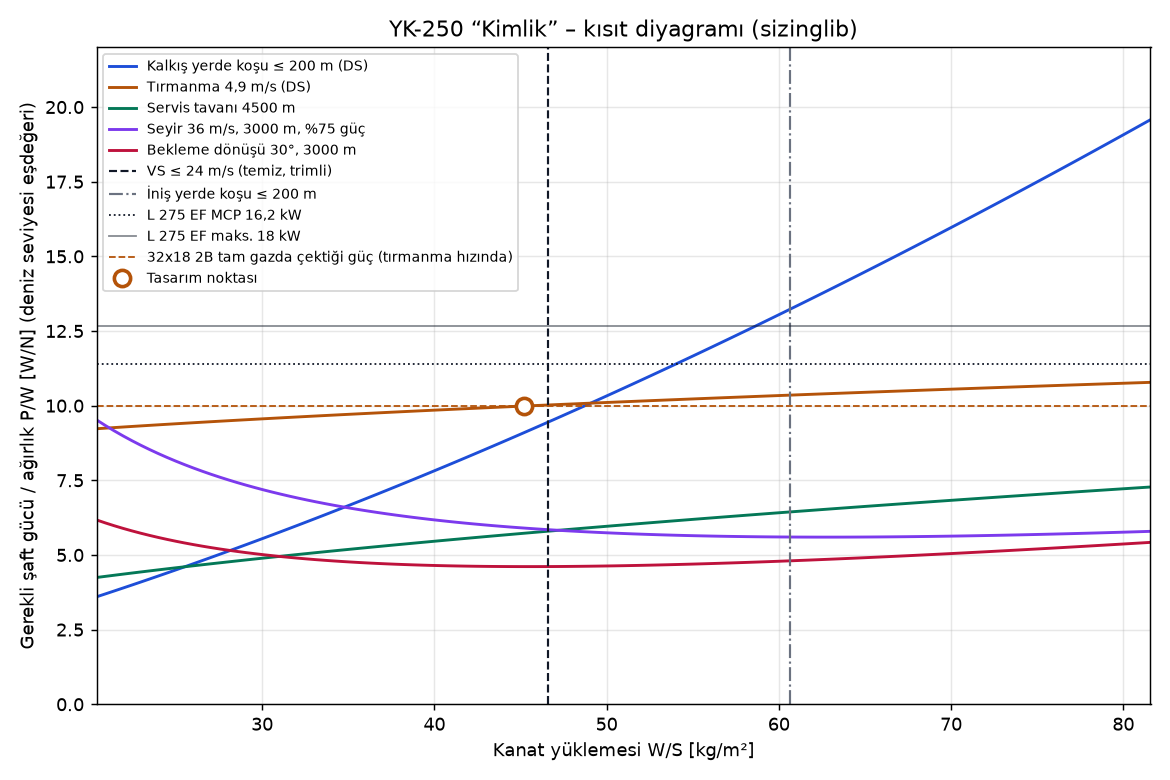
ucav250/data/concepts/identity/constraint.png
