ahmet6141/Drone-controller/ucav250/data/concepts/identity/sketch.png

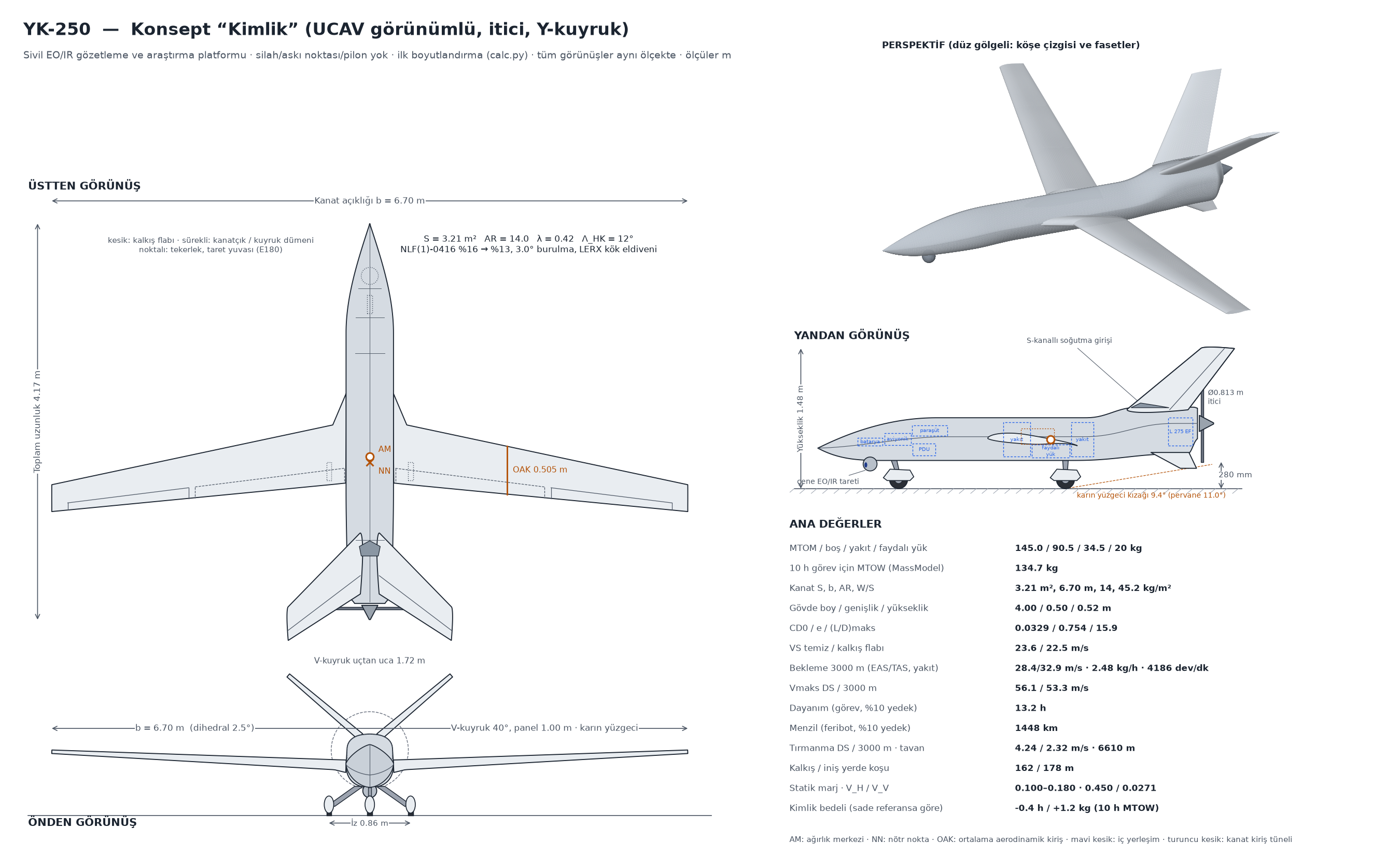
ucav250/data/concepts/identity/sketch.png
