ahmet6141/Drone-controller/ucav250/data/concepts/production/constraint.png

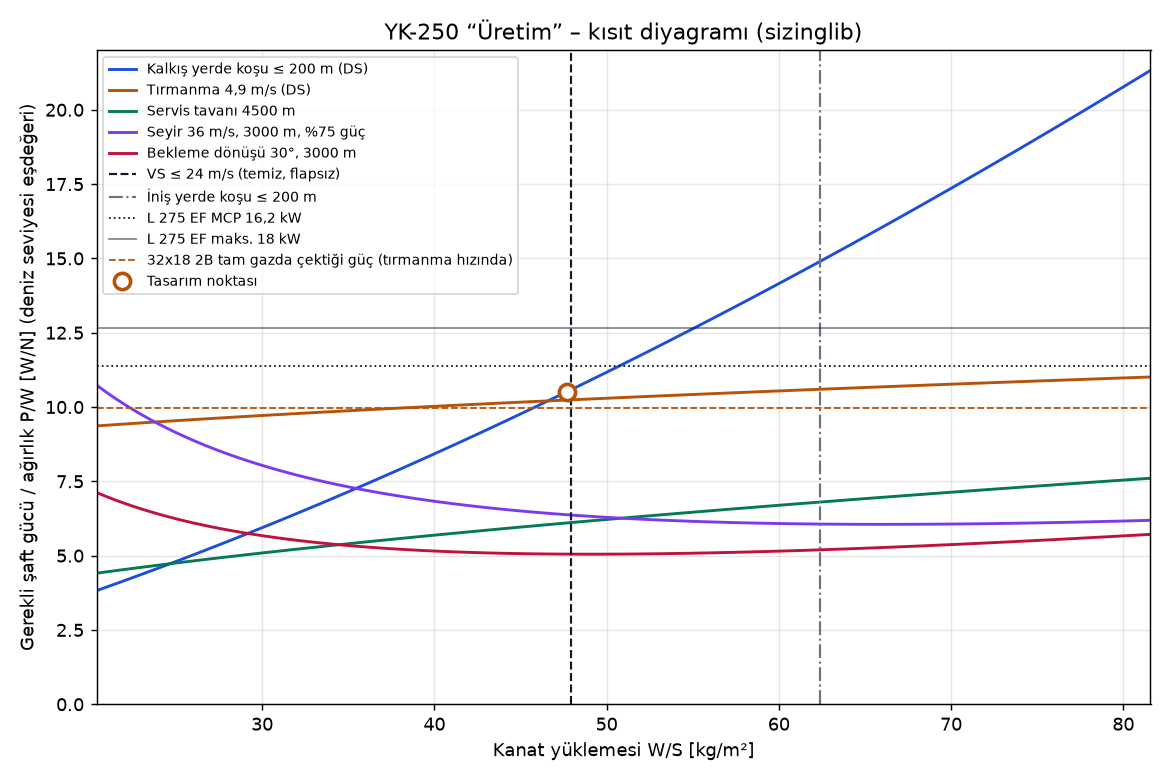
ucav250/data/concepts/production/constraint.png
