ahmet6141/Drone-controller/ucav250/data/concepts/production/sketch.png

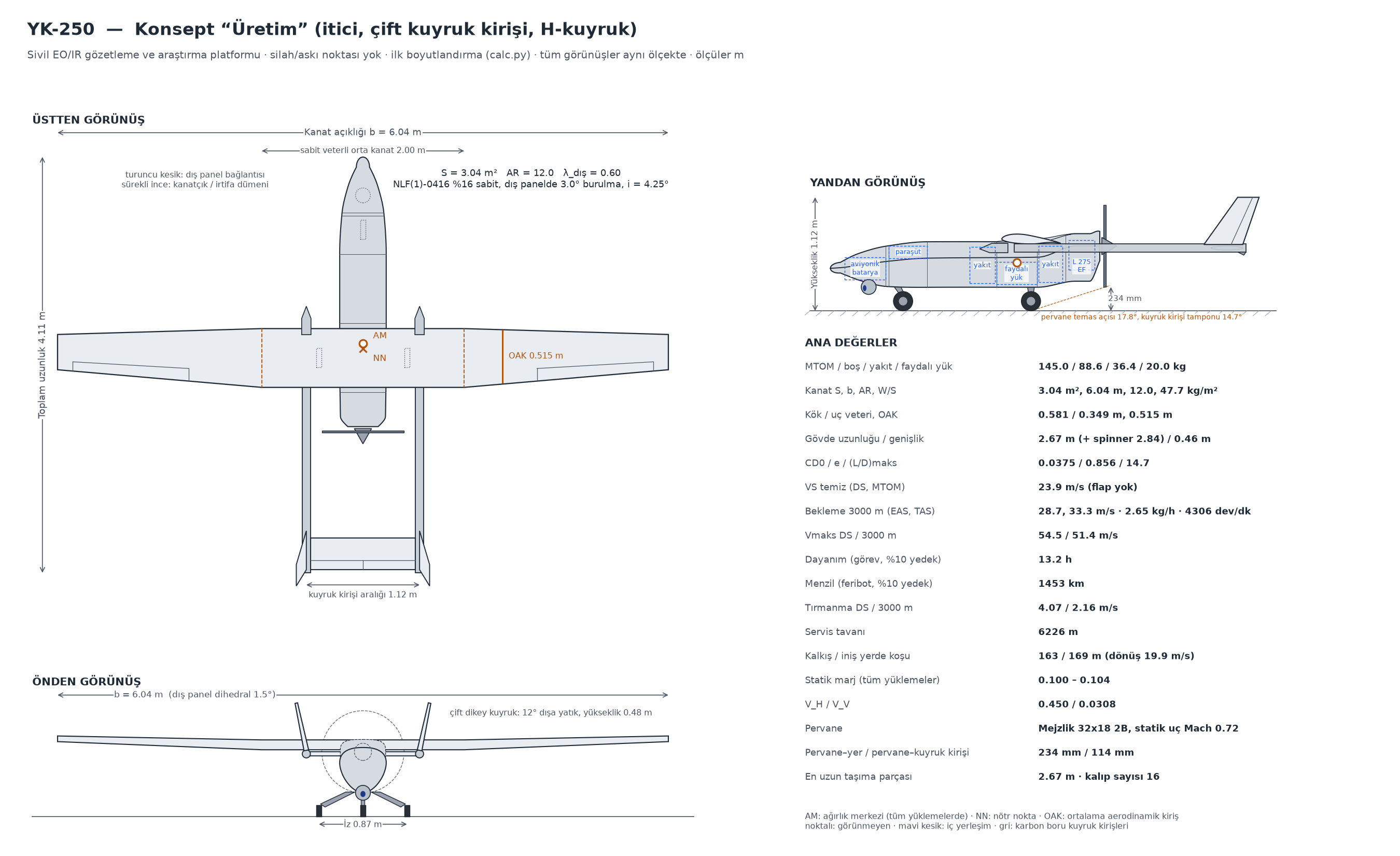
ucav250/data/concepts/production/sketch.png
