ahmet6141/Drone-controller/ucav250/docs/fig/yk250_front.png

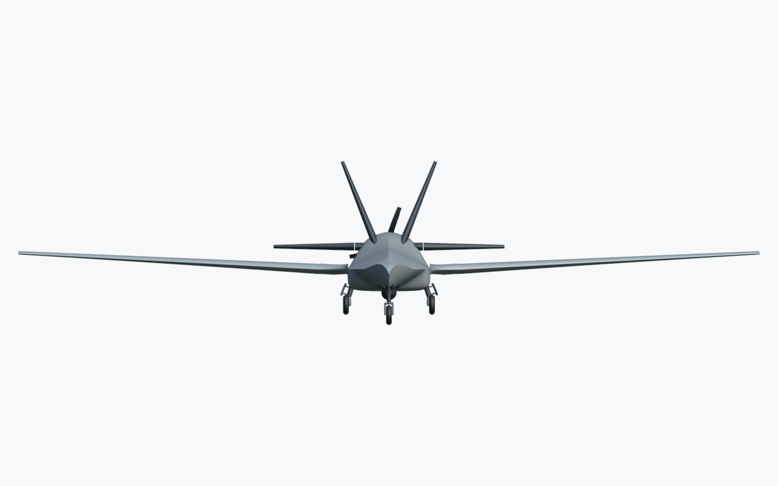
ucav250/docs/fig/yk250_front.png
