ahmet6141/Drone-controller/ucav250/docs/fig/yk250_top.png

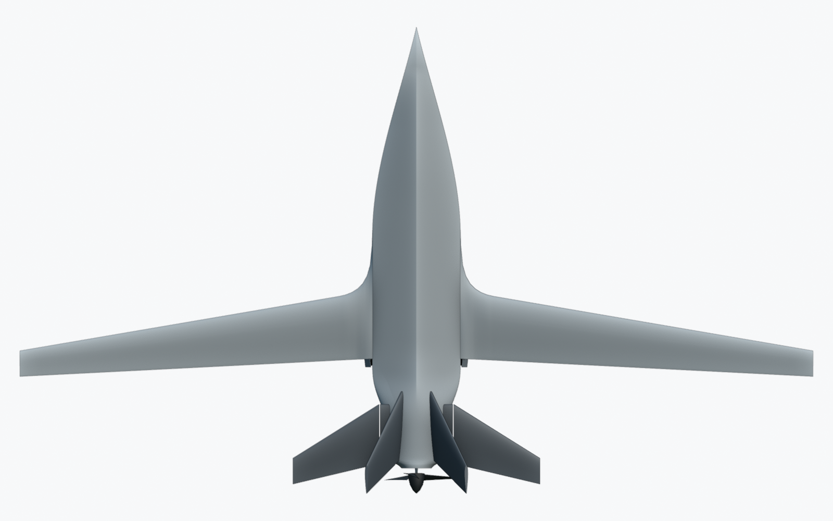
ucav250/docs/fig/yk250_top.png
