ahmet6141/Drone-controller/ucav/out/render/yk38_rear34_taktik.jpg

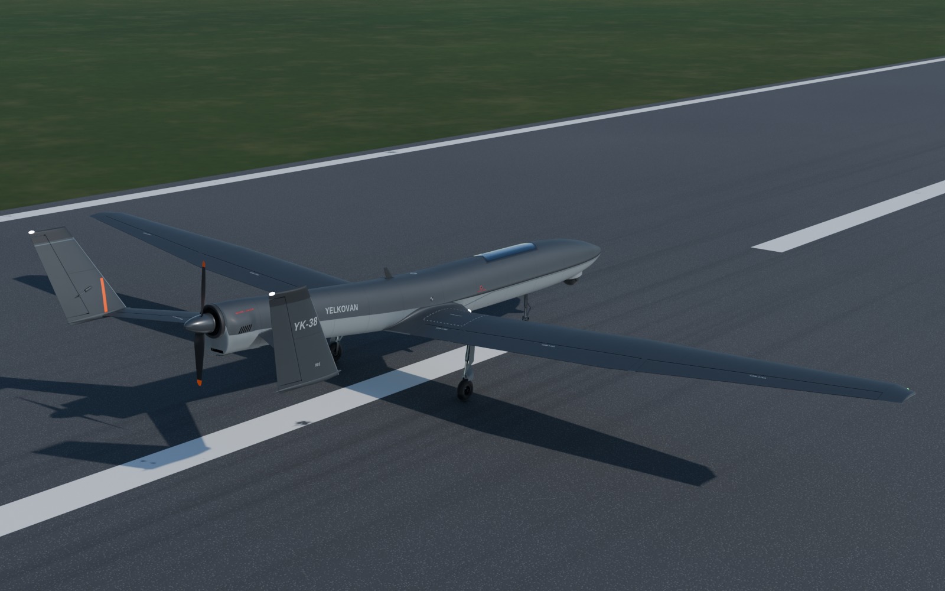
ucav/out/render/yk38_rear34_taktik.jpg
