ahmet6141/Drone-controller/ucav/out/render/yk38_side_studyo.jpg

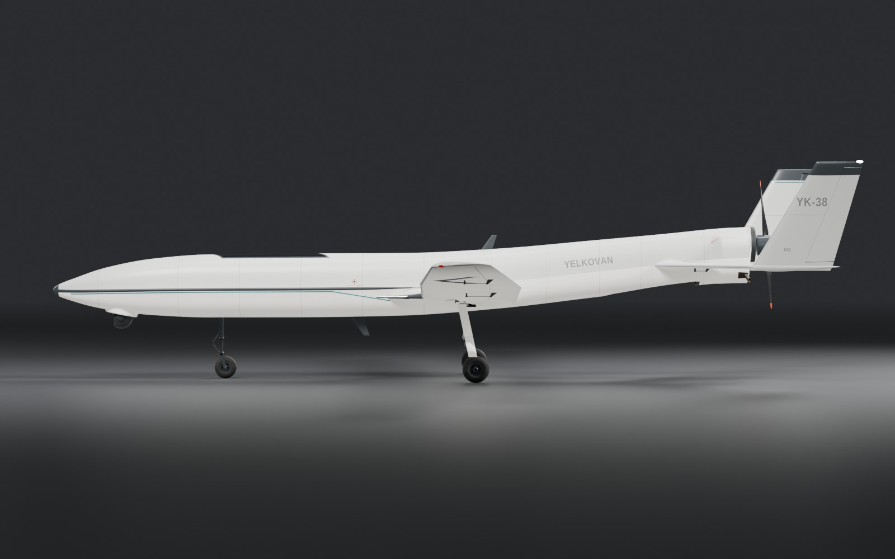
ucav/out/render/yk38_side_studyo.jpg
