ahmet6141/Drone-controller/ucav/out/render/yk38_side_taktik.jpg

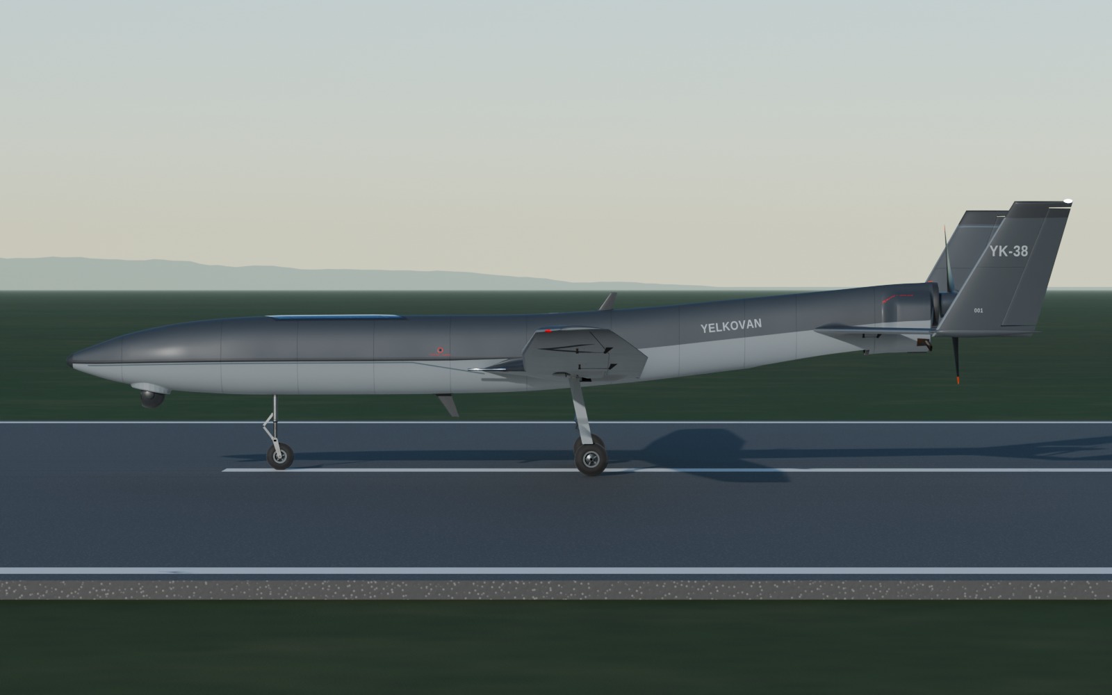
ucav/out/render/yk38_side_taktik.jpg
