ahmet6141/Drone-controller/cad/out/preview_parts.png

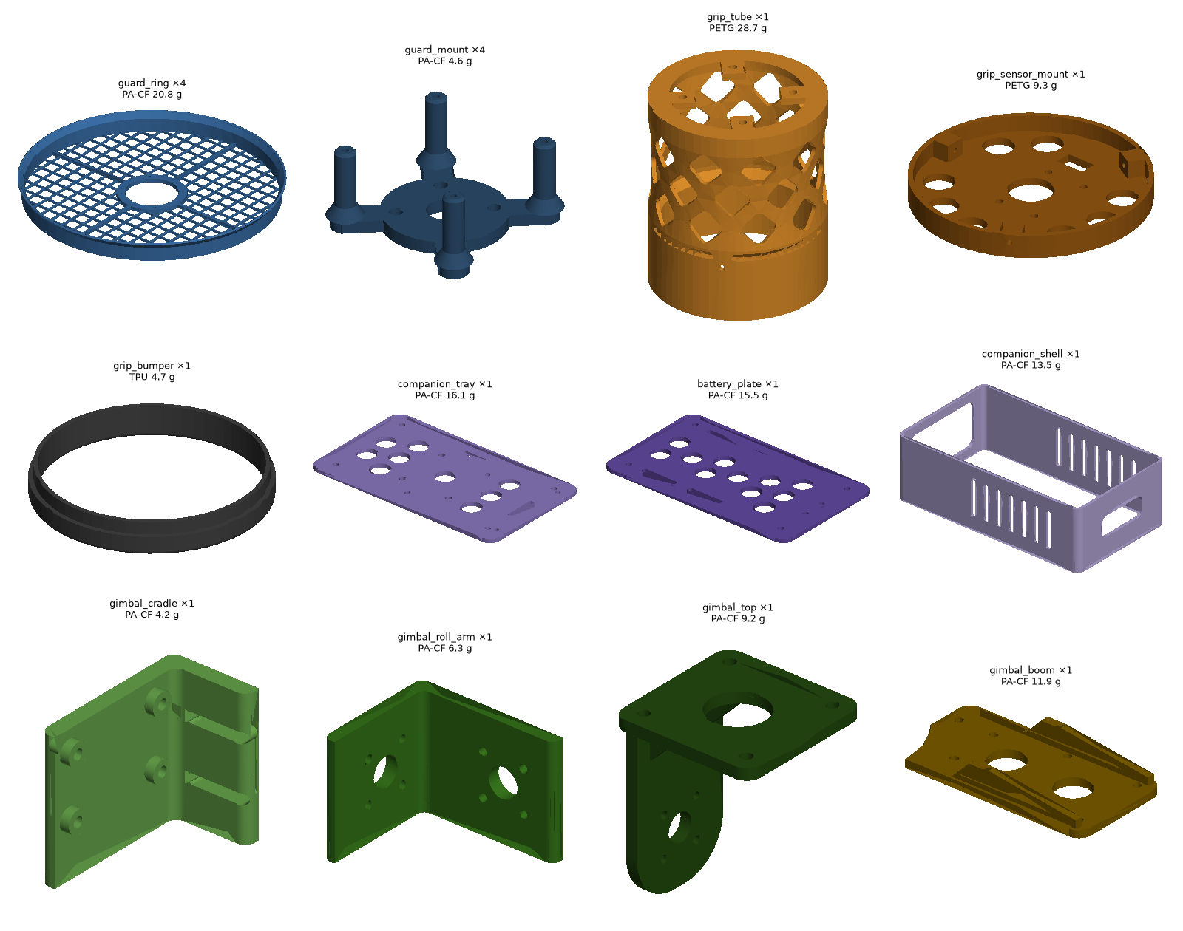
cad/out/preview_parts.png
