ahmet6141/Drone-controller/cad/out/stl/grip_tube.stl

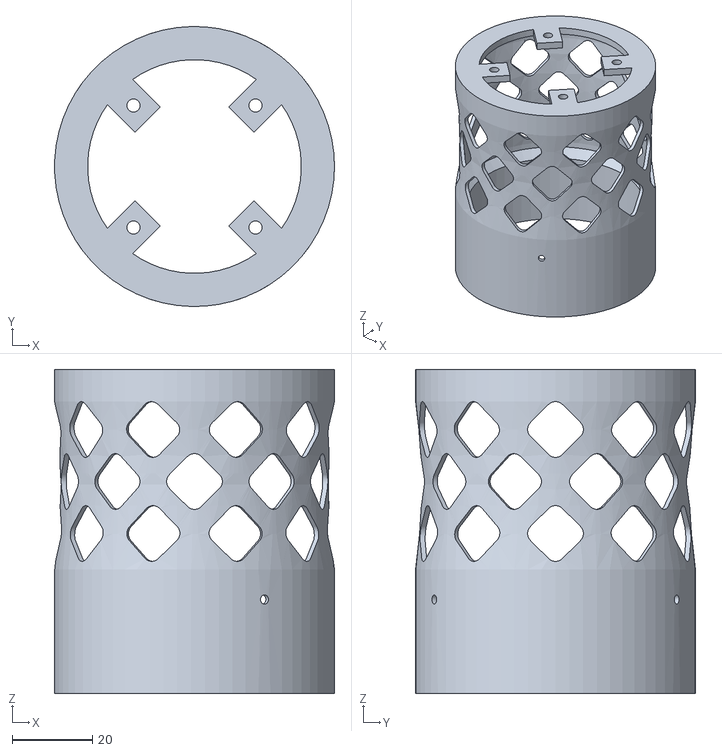
[picture p51: CAD file, 2026-10-02]
cad/out/stl/grip_tube.stl
70.0 x 70.0 x 81.0
