ahmet6141/Drone-controller/cad/v2/out/stl/top_shell.stl

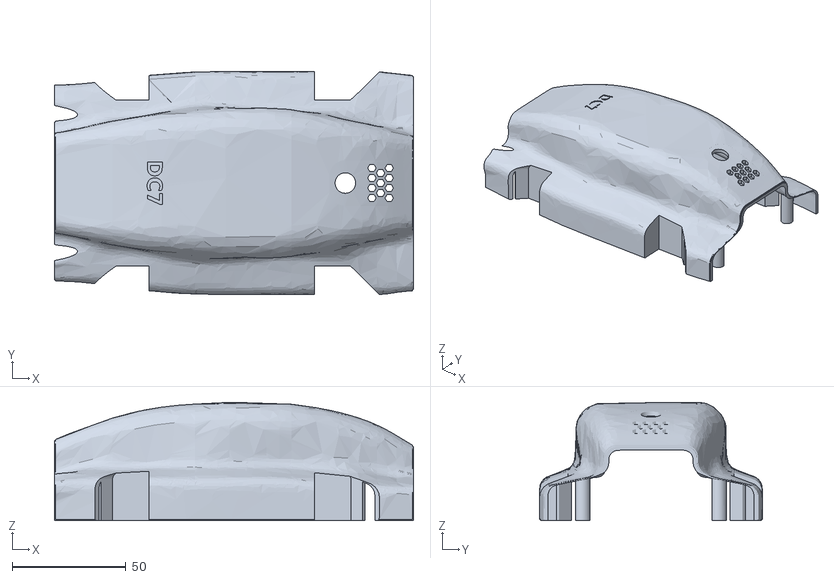
[picture p52: CAD file, 2026-10-03]
cad/v2/out/stl/top_shell.stl
158.0 x 98.1 x 52.0
