ahmet6141/Drone-controller/ucav/out/stl/wing_frame_aft.stl

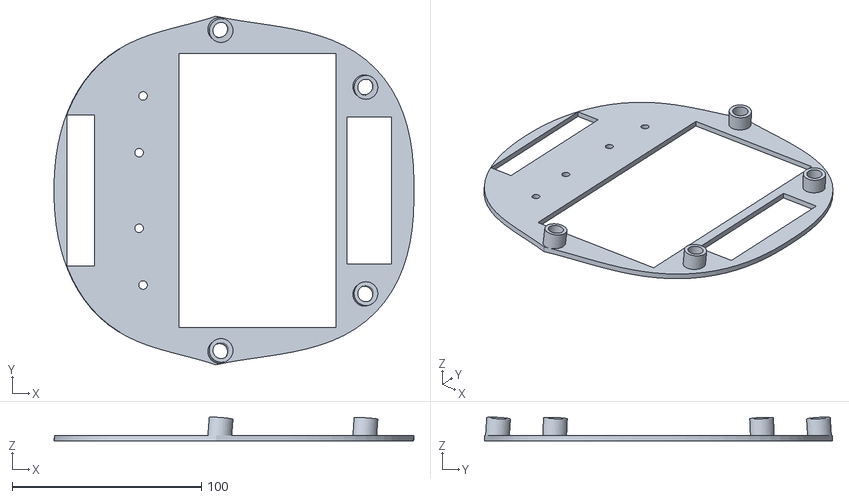
[picture p53: CAD file, 2026-10-04]
ucav/out/stl/wing_frame_aft.stl
190.4 x 184.3 x 12.6
