ahmet6141/Drone-controller/cad/out/stl/gimbal_top.stl

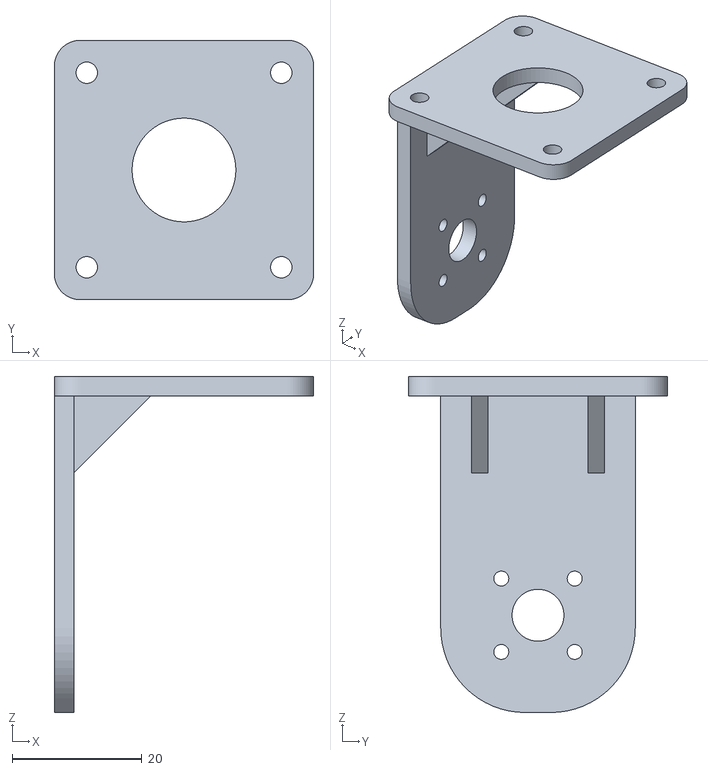
[picture p54: CAD file, 2026-10-02]
cad/out/stl/gimbal_top.stl
40.0 x 40.0 x 51.8
