ahmet6141/Drone-controller/cad/v2/out/stl/battery_shell.stl

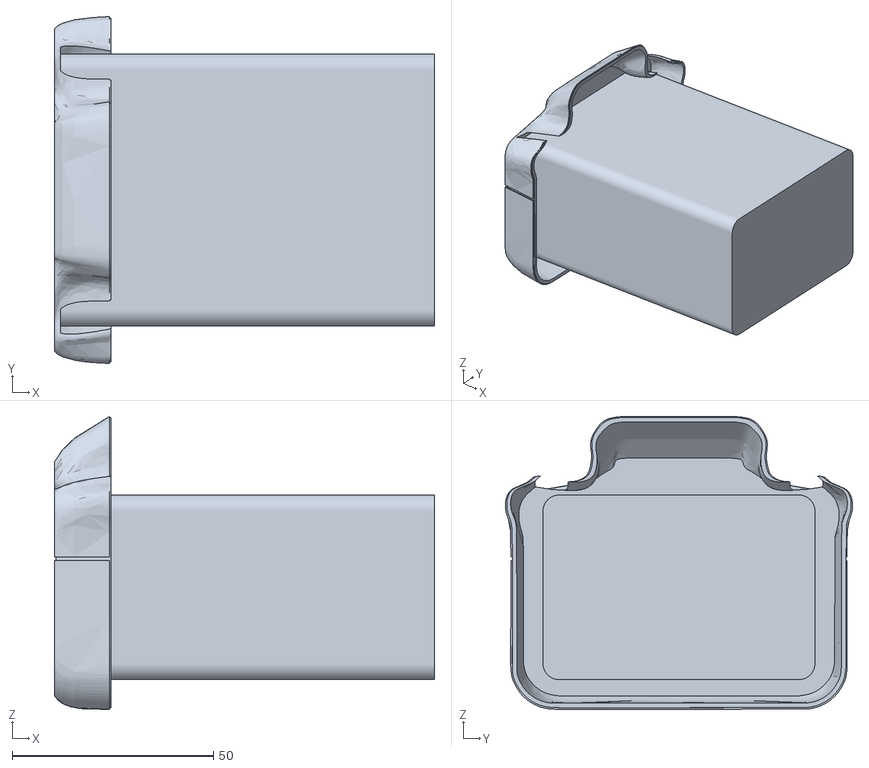
[picture p55: CAD file, 2026-10-03]
cad/v2/out/stl/battery_shell.stl
94.3 x 86.1 x 72.7
