ahmet6141/Drone-controller/ucav/out/stl/gear_blister.stl

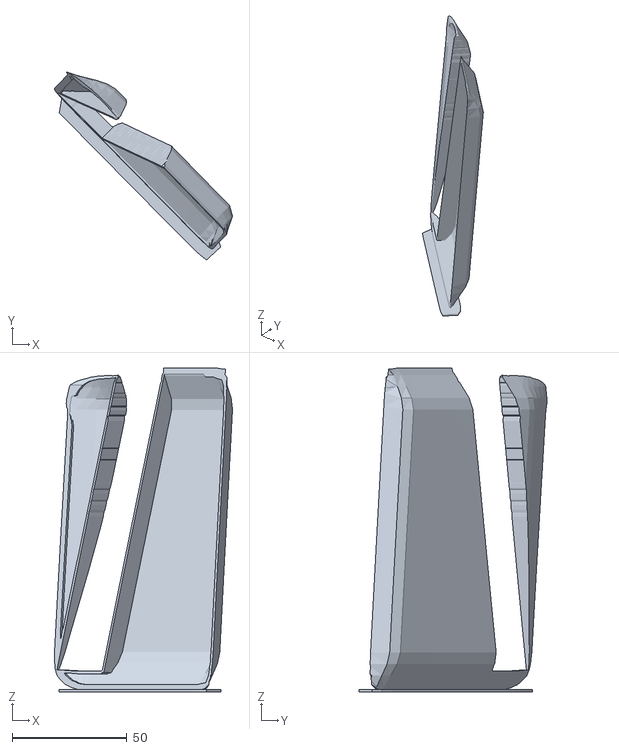
[picture p56: CAD file, 2026-10-04]
ucav/out/stl/gear_blister.stl
77.5 x 81.8 x 141.1
