ahmet6141/Drone-controller/cad/out/stl/gimbal_cradle.stl

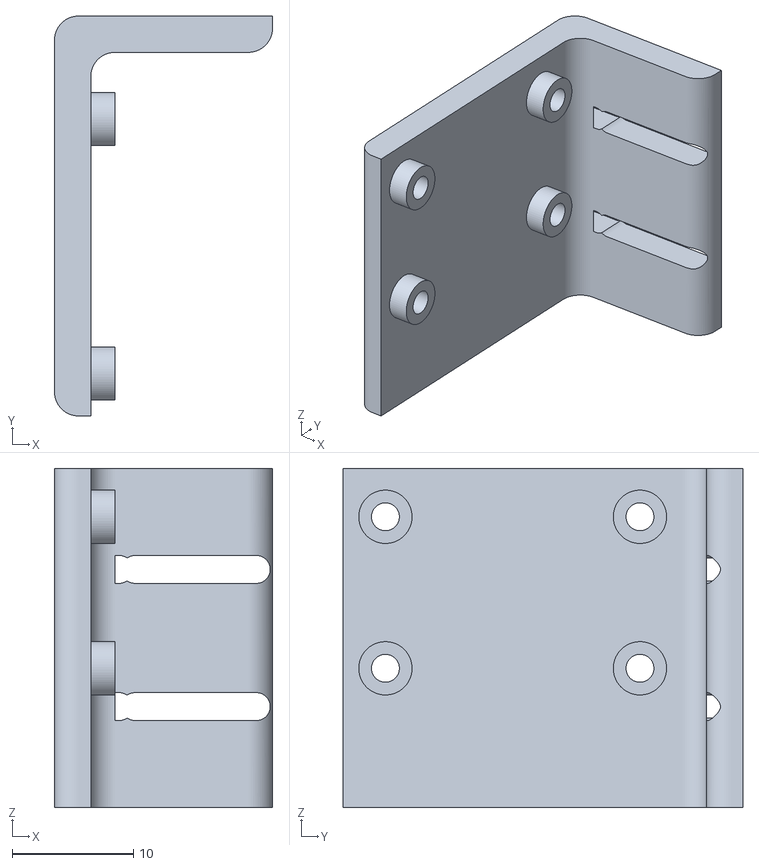
[picture p57: CAD file, 2026-10-02]
cad/out/stl/gimbal_cradle.stl
18.0 x 33.0 x 28.0
