ahmet6141/Drone-controller/cad/v2/out/stl/pod.stl

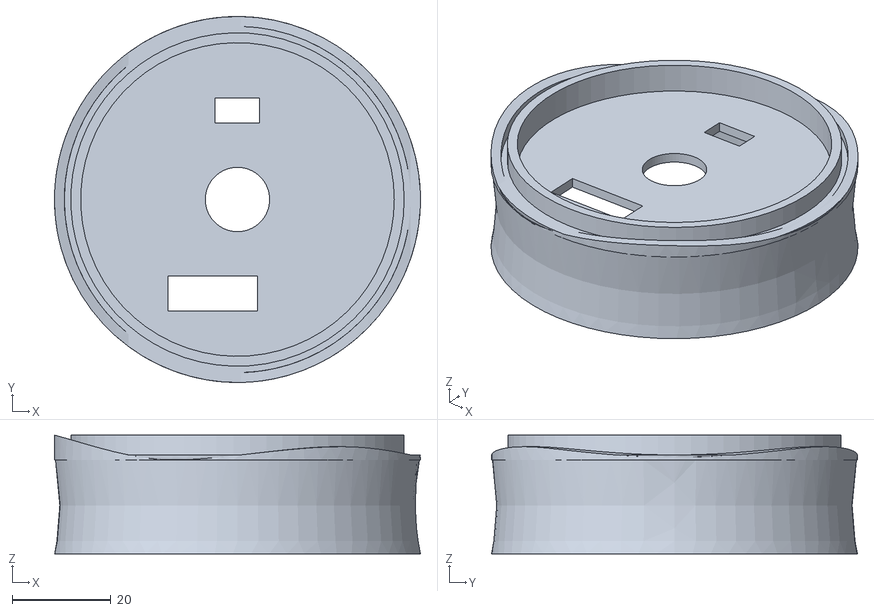
[picture p58: CAD file, 2026-10-03]
cad/v2/out/stl/pod.stl
74.0 x 74.0 x 24.0
