ahmet6141/Drone-controller/ucav/out/stl/elevator_1.stl

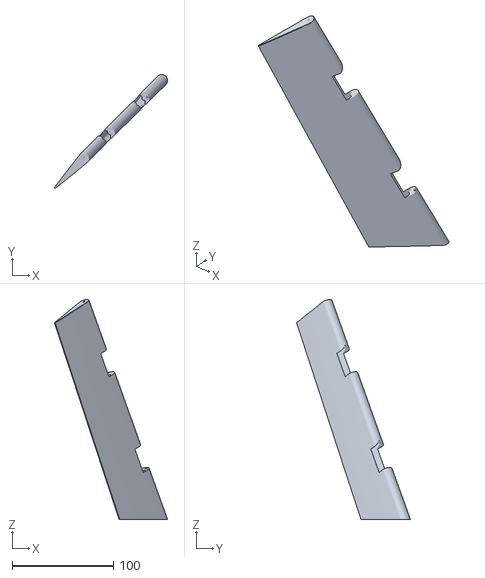
[picture p59: CAD file, 2026-10-04]
ucav/out/stl/elevator_1.stl
111.7 x 112.4 x 217.0
