ahmet6141/Drone-controller/cad/out/stl/companion_shell.stl

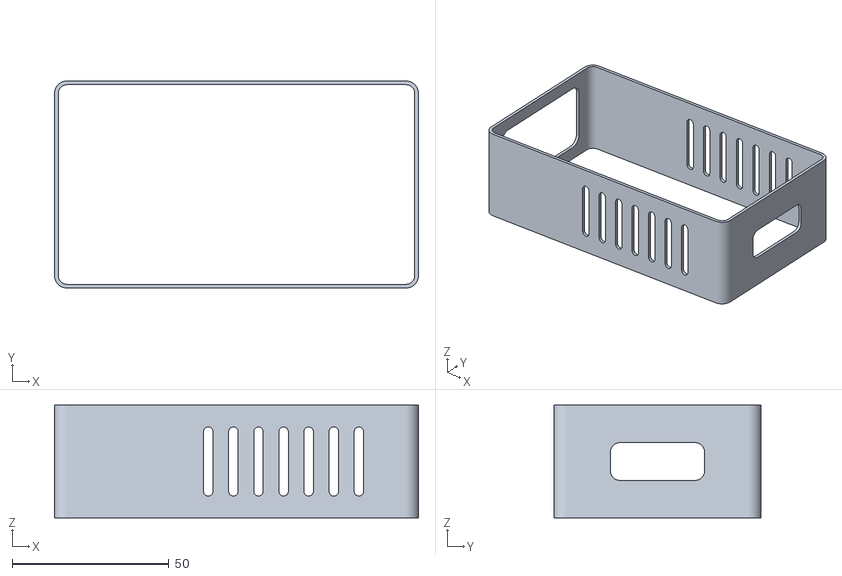
[picture p60: CAD file, 2026-10-02]
cad/out/stl/companion_shell.stl
116.0 x 66.0 x 36.0
