ahmet6141/Drone-controller/cad/v2/out/stl/bottom_tub.stl

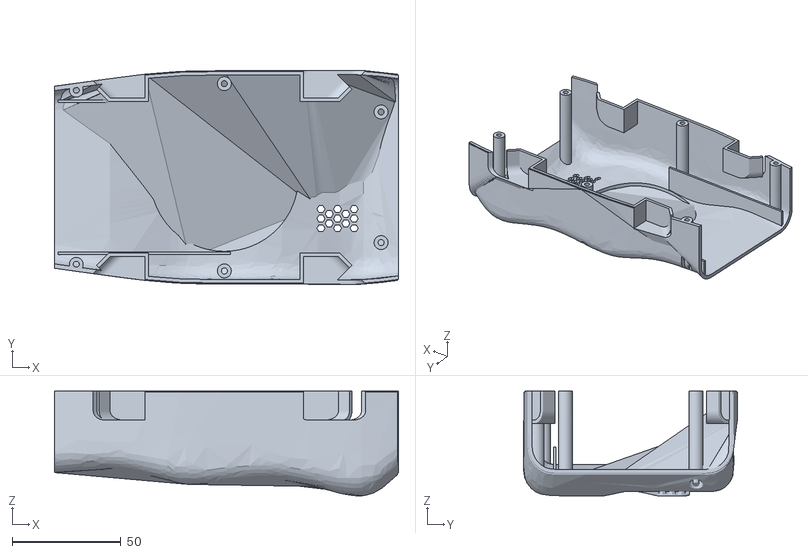
[picture p61: CAD file, 2026-10-03]
cad/v2/out/stl/bottom_tub.stl
158.0 x 98.5 x 48.1
