ahmet6141/Drone-controller/ucav/out/stl/longeron_joint_shoulder.stl

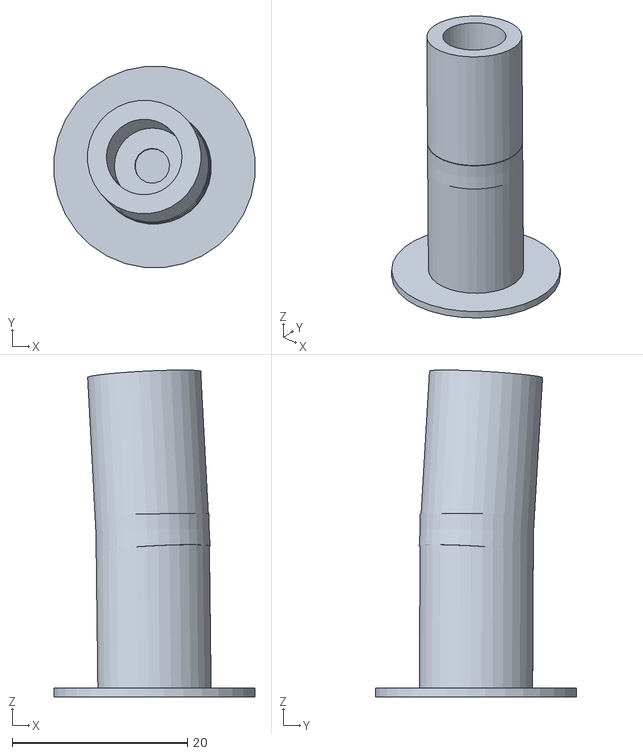
[picture p62: CAD file, 2026-10-04]
ucav/out/stl/longeron_joint_shoulder.stl
22.9 x 22.9 x 37.3
