ahmet6141/Drone-controller/cad/out/stl/gimbal_boom.stl

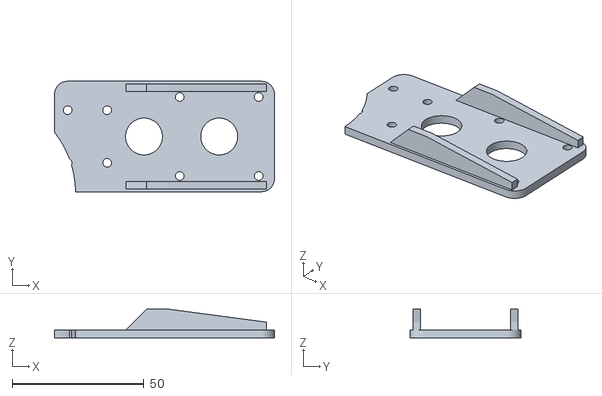
[picture p63: CAD file, 2026-10-02]
cad/out/stl/gimbal_boom.stl
83.6 x 42.0 x 11.0
