ahmet6141/Drone-controller/cad/v2/out/stl/nose_cover.stl

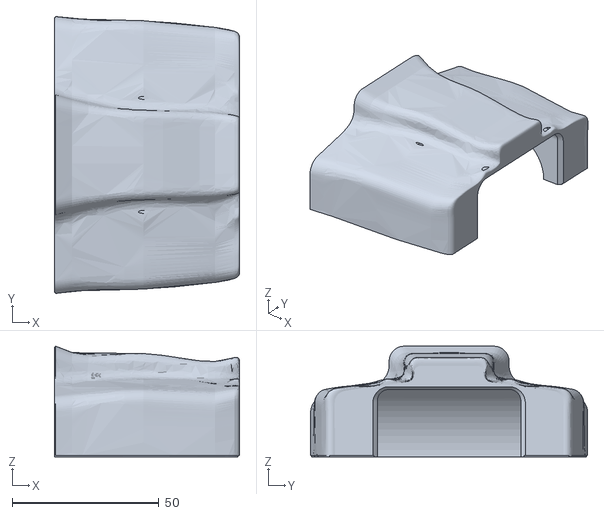
[picture p64: CAD file, 2026-10-03]
cad/v2/out/stl/nose_cover.stl
63.1 x 94.5 x 37.8
