ahmet6141/Drone-controller/ucav/out/stl/turret_collar.stl

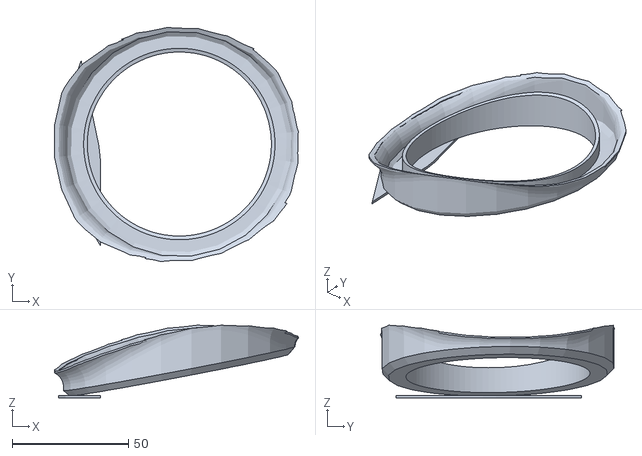
[picture p65: CAD file, 2026-10-04]
ucav/out/stl/turret_collar.stl
104.8 x 100.5 x 31.2
