ahmet6141/Drone-controller/cad/out/stl/guard_ring.stl

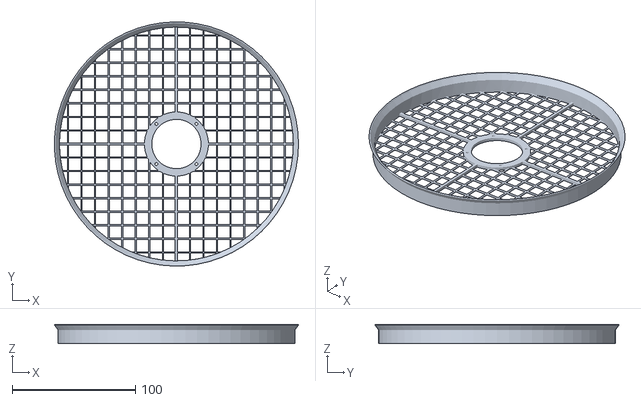
[picture p66: CAD file, 2026-10-02]
cad/out/stl/guard_ring.stl
198.1 x 198.1 x 15.6
