ahmet6141/Drone-controller/cad/v2/out/stl/nose_chin.stl

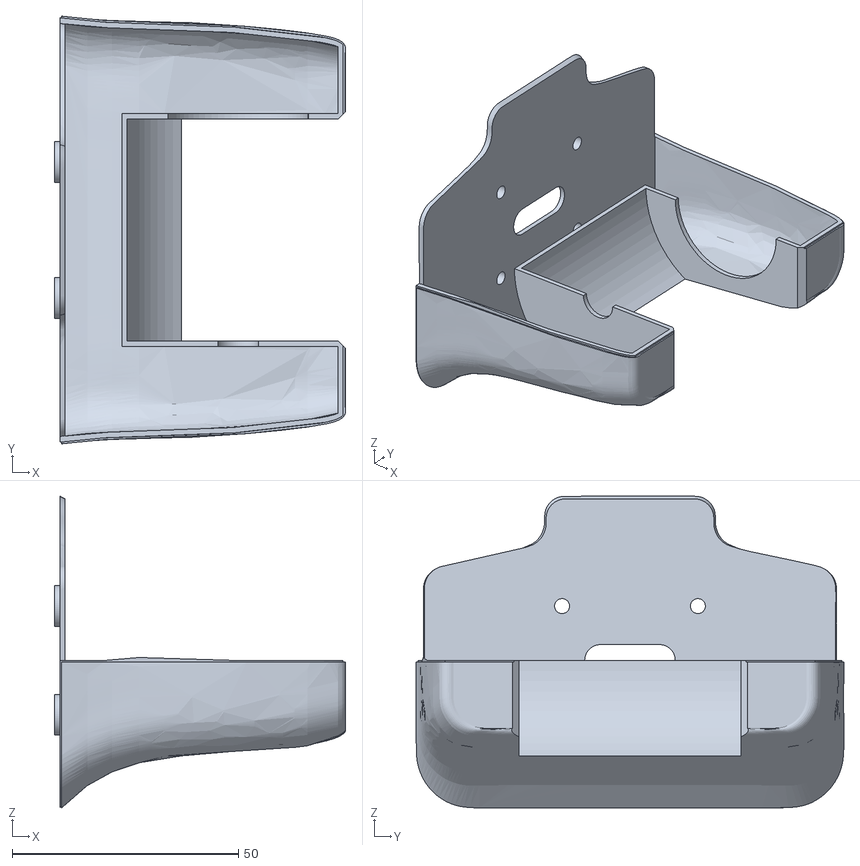
[picture p67: CAD file, 2026-10-03]
cad/v2/out/stl/nose_chin.stl
64.3 x 94.5 x 68.9
