ahmet6141/Drone-controller/ucav/out/stl/fus_ring_9.stl

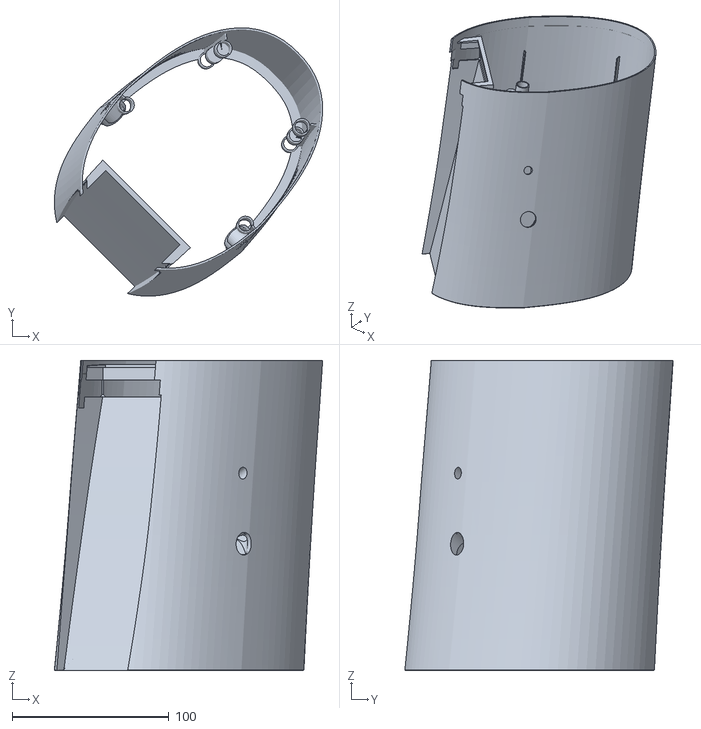
[picture p68: CAD file, 2026-10-04]
ucav/out/stl/fus_ring_9.stl
170.9 x 170.9 x 197.5
