ahmet6141/Drone-controller/cad/out/stl/grip_bumper.stl

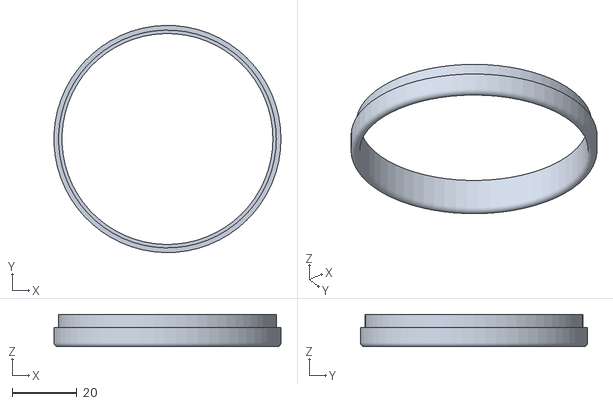
[picture p69: CAD file, 2026-10-02]
cad/out/stl/grip_bumper.stl
70.0 x 70.0 x 10.0
