ahmet6141/Drone-controller/cad/v2/out/stl/camera_housing.stl

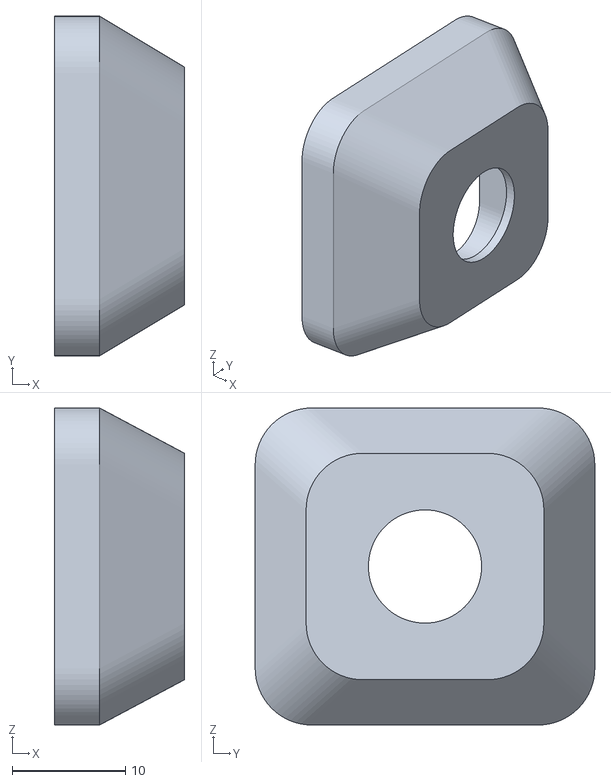
[picture p70: CAD file, 2026-10-03]
cad/v2/out/stl/camera_housing.stl
11.5 x 30.0 x 28.0
