ahmet6141/Drone-controller/ucav/out/stl/fus_ring_4.stl

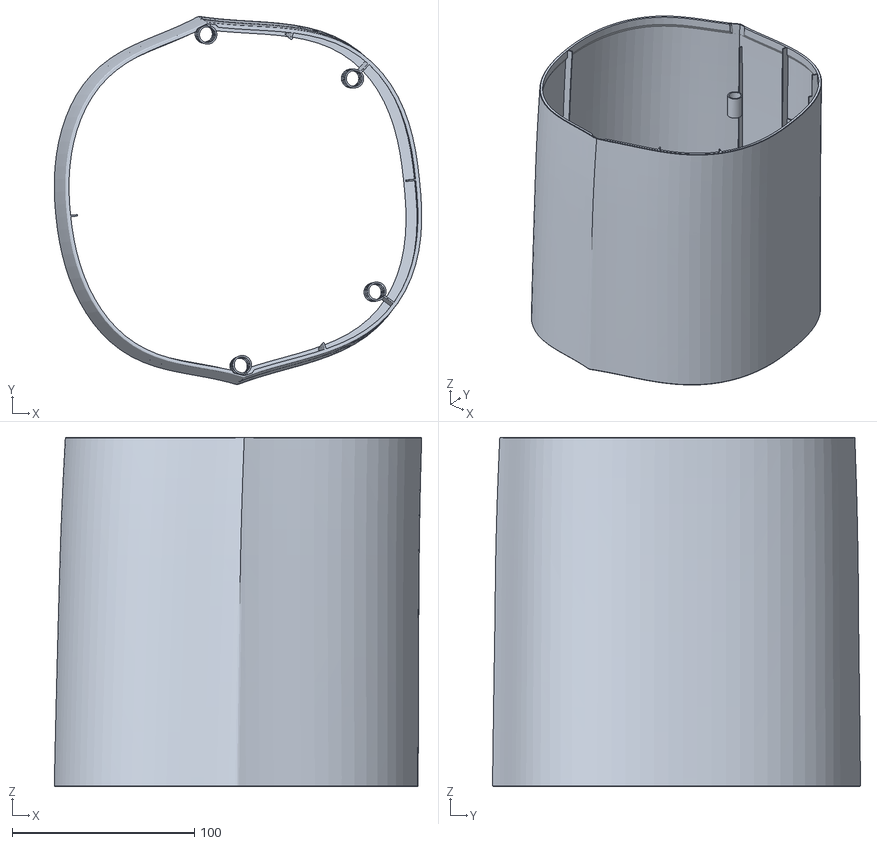
[picture p71: CAD file, 2026-10-04]
ucav/out/stl/fus_ring_4.stl
201.7 x 202.0 x 191.7
