ahmet6141/Drone-controller/cad/out/stl/guard_mount.stl

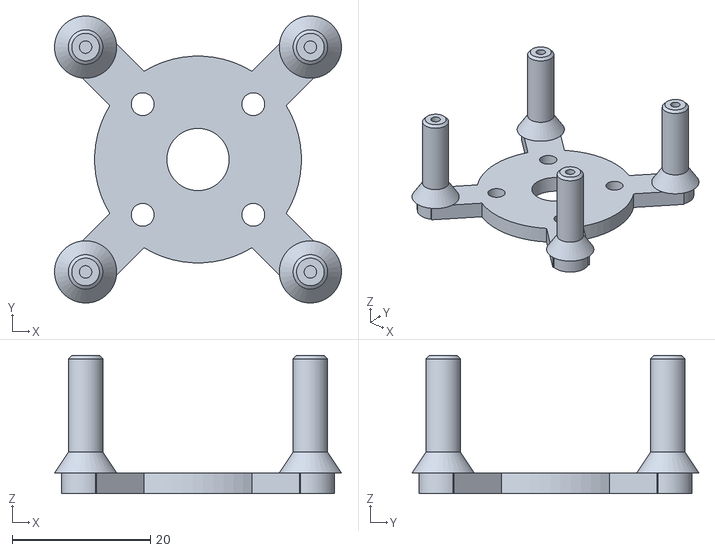
[picture p72: CAD file, 2026-10-02]
cad/out/stl/guard_mount.stl
41.5 x 41.5 x 20.0
