ahmet6141/Drone-controller/cad/v2/out/stl/gimbal_cradle.stl

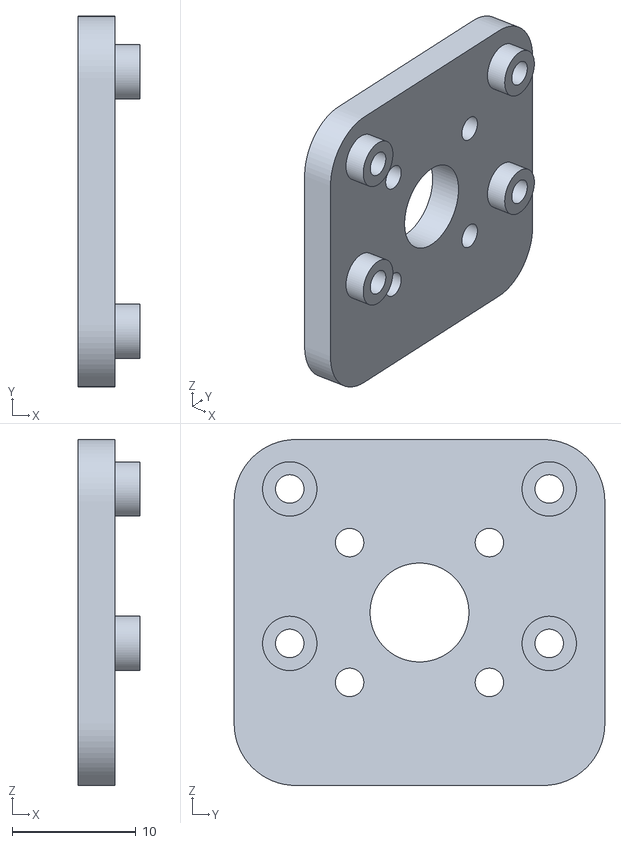
[picture p73: CAD file, 2026-10-03]
cad/v2/out/stl/gimbal_cradle.stl
5.00 x 30.0 x 28.0
