ahmet6141/Drone-controller/ucav/out/stl/wing_panel_5.stl

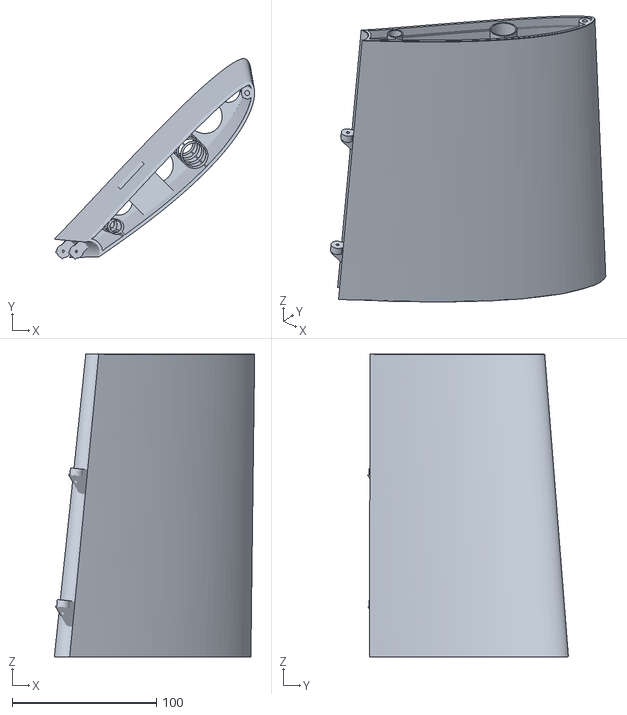
[picture p74: CAD file, 2026-10-04]
ucav/out/stl/wing_panel_5.stl
138.9 x 139.2 x 210.0
