ahmet6141/Drone-controller/cad/out/stl/gimbal_roll_arm.stl

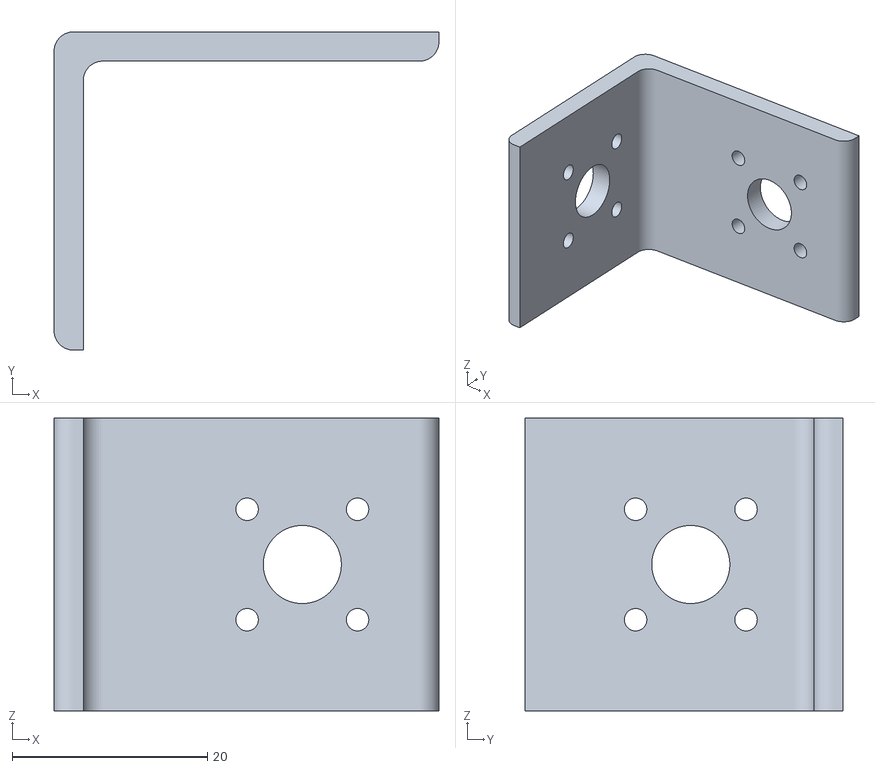
[picture p75: CAD file, 2026-10-02]
cad/out/stl/gimbal_roll_arm.stl
39.4 x 32.6 x 30.0
