ahmet6141/Drone-controller/cad/v2/out/stl/gimbal_bracket.stl

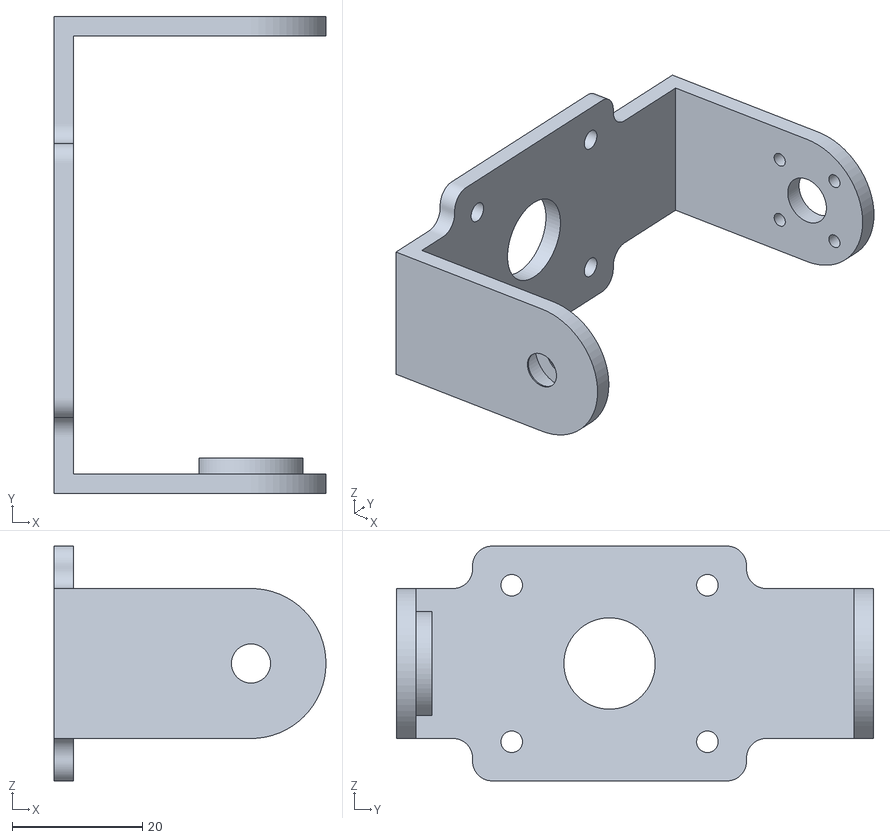
[picture p76: CAD file, 2026-10-03]
cad/v2/out/stl/gimbal_bracket.stl
41.7 x 73.2 x 36.0
