ahmet6141/Drone-controller/ucav/out/stl/intake.stl

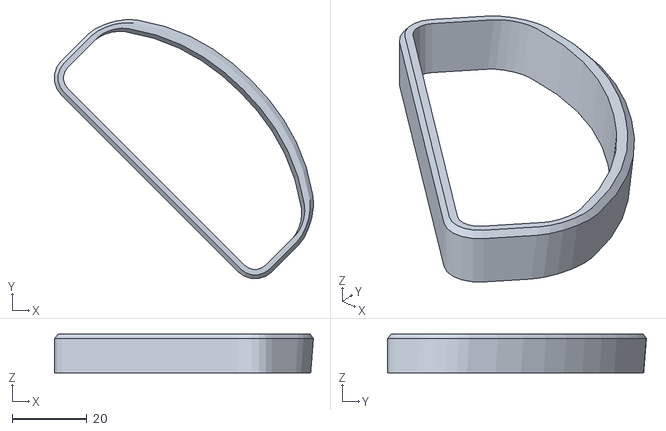
[picture p77: CAD file, 2026-10-04]
ucav/out/stl/intake.stl
69.5 x 69.5 x 10.4
