ahmet6141/Drone-controller/cad/out/stl/battery_plate.stl

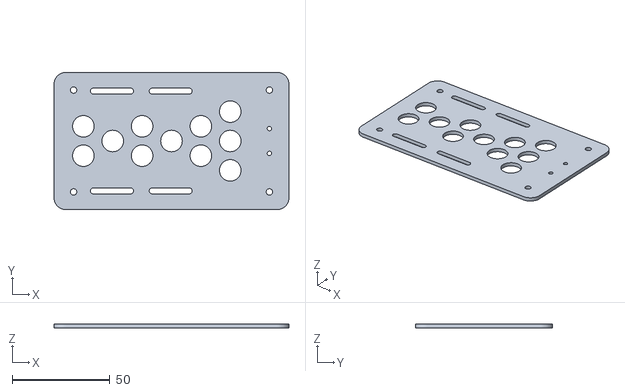
[picture p78: CAD file, 2026-10-02]
cad/out/stl/battery_plate.stl
120.0 x 70.0 x 2.00
