ahmet6141/Drone-controller/cad/v2/out/stl/gimbal_frame.stl

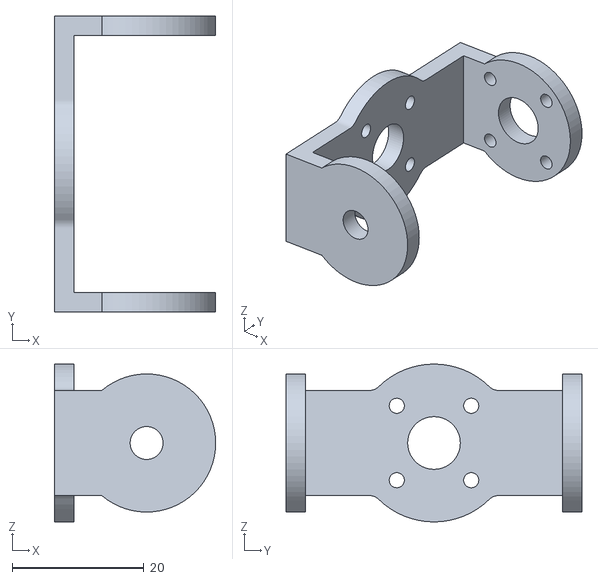
[picture p79: CAD file, 2026-10-03]
cad/v2/out/stl/gimbal_frame.stl
24.5 x 45.0 x 24.0
