ahmet6141/Drone-controller/ucav/out/stl/root_block_2.stl

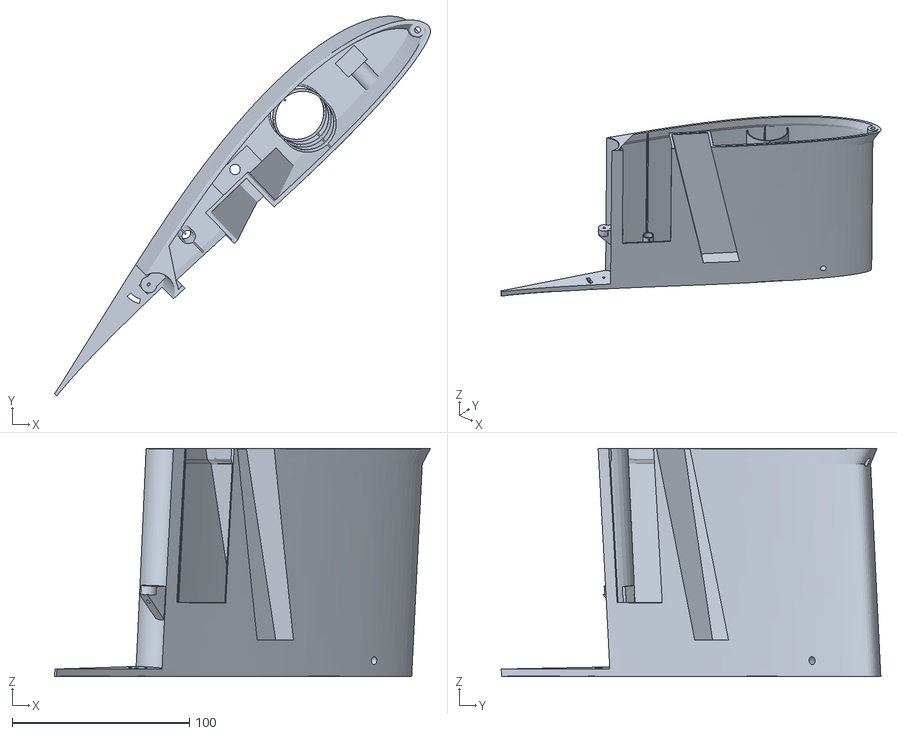
[picture p80: CAD file, 2026-10-04]
ucav/out/stl/root_block_2.stl
212.3 x 214.4 x 128.8
