ahmet6141/Drone-controller/cad/out/stl/grip_sensor_mount.stl

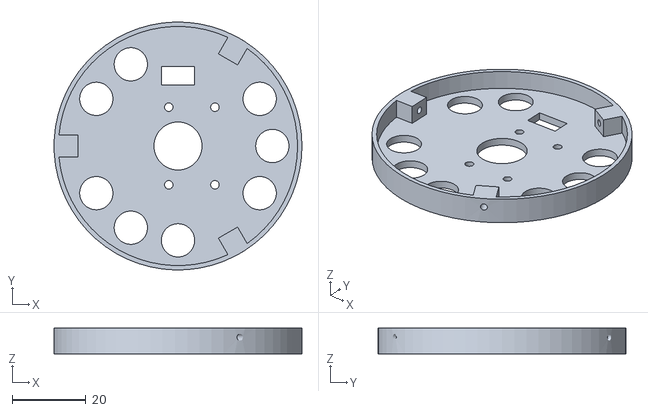
[picture p81: CAD file, 2026-10-02]
cad/out/stl/grip_sensor_mount.stl
67.1 x 67.1 x 7.00
