ahmet6141/Drone-controller/cad/v2/out/stl/top_grille.stl

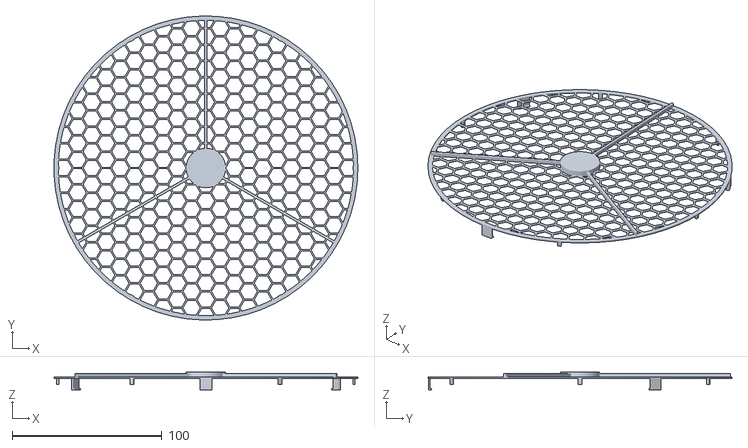
[picture p82: CAD file, 2026-10-03]
cad/v2/out/stl/top_grille.stl
203.1 x 203.1 x 11.9
