ahmet6141/Drone-controller/ucav/out/stl/fus_nose_flange.stl

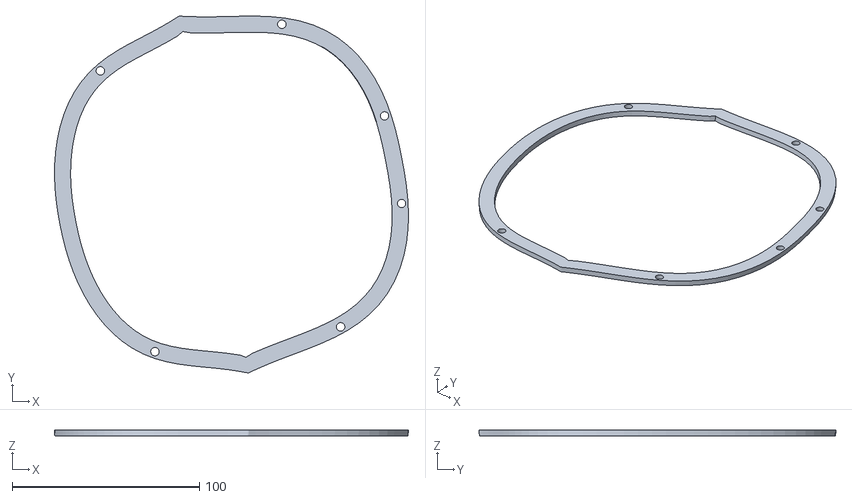
[picture p83: CAD file, 2026-10-04]
ucav/out/stl/fus_nose_flange.stl
189.1 x 190.6 x 3.00
