ahmet6141/Drone-controller/cad/v2/out/stl/pod_tip.stl

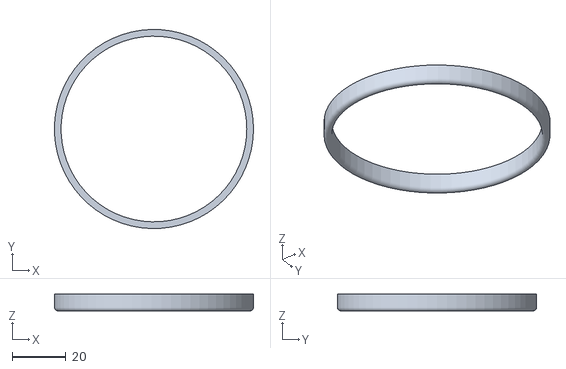
[picture p84: CAD file, 2026-10-03]
cad/v2/out/stl/pod_tip.stl
74.0 x 74.0 x 6.20
