ahmet6141/Drone-controller/cad/v2/out/stl/arm_duct.stl

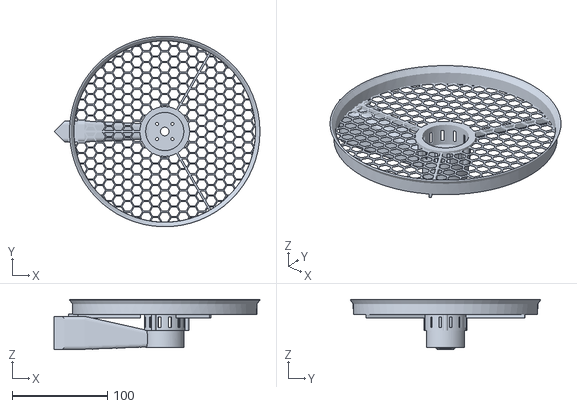
[picture p85: CAD file, 2026-10-03]
cad/v2/out/stl/arm_duct.stl
215.8 x 199.5 x 52.8
