ahmet6141/Drone-controller/ucav/out/stl/flapout_1.stl

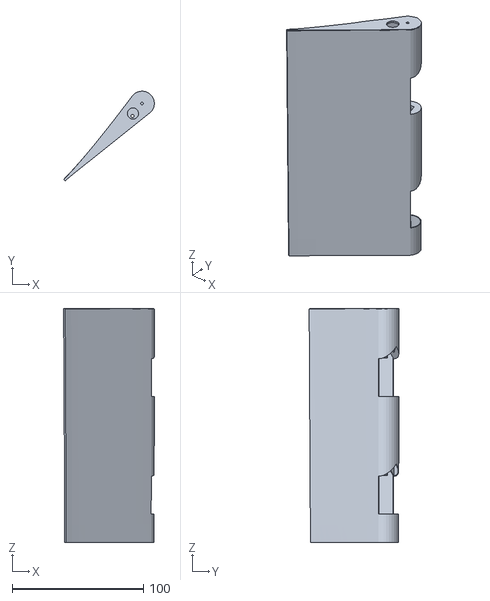
[picture p86: CAD file, 2026-10-04]
ucav/out/stl/flapout_1.stl
69.2 x 68.3 x 178.2
