ahmet6141/Drone-controller/cad/v2/out/stl/sensor_window.stl

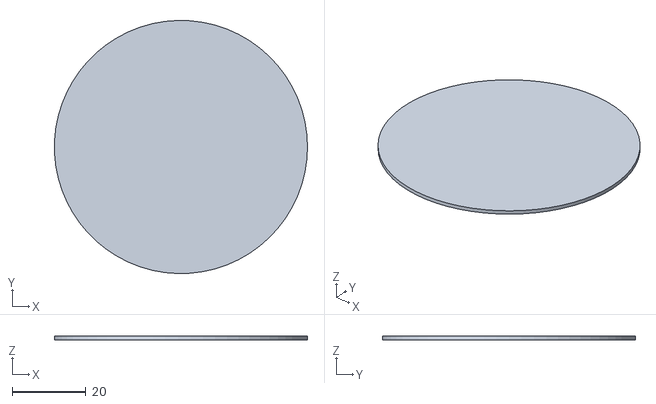
[picture p87: CAD file, 2026-10-03]
cad/v2/out/stl/sensor_window.stl
68.8 x 68.8 x 1.00
