ahmet6141/Drone-controller/ucav/out/stl/fus_ring_6.stl

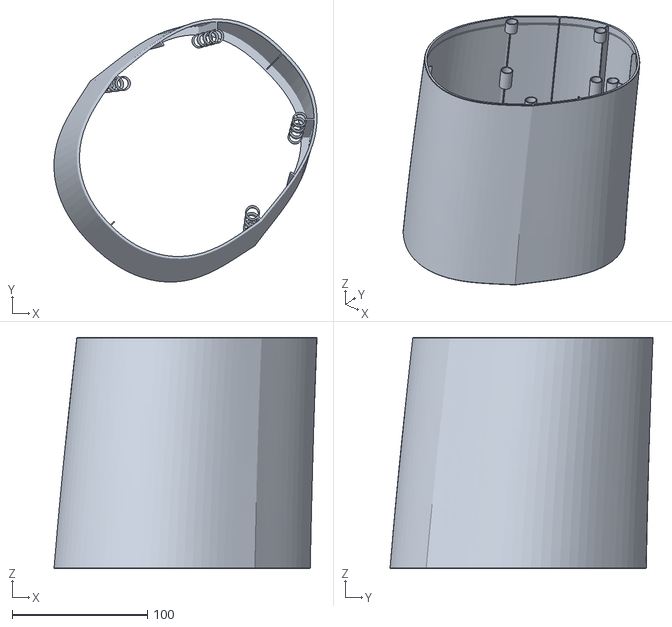
[picture p88: CAD file, 2026-10-04]
ucav/out/stl/fus_ring_6.stl
194.3 x 194.3 x 171.0
