ahmet6141/Drone-controller/ucav/out/stl/fus_ring_5.stl

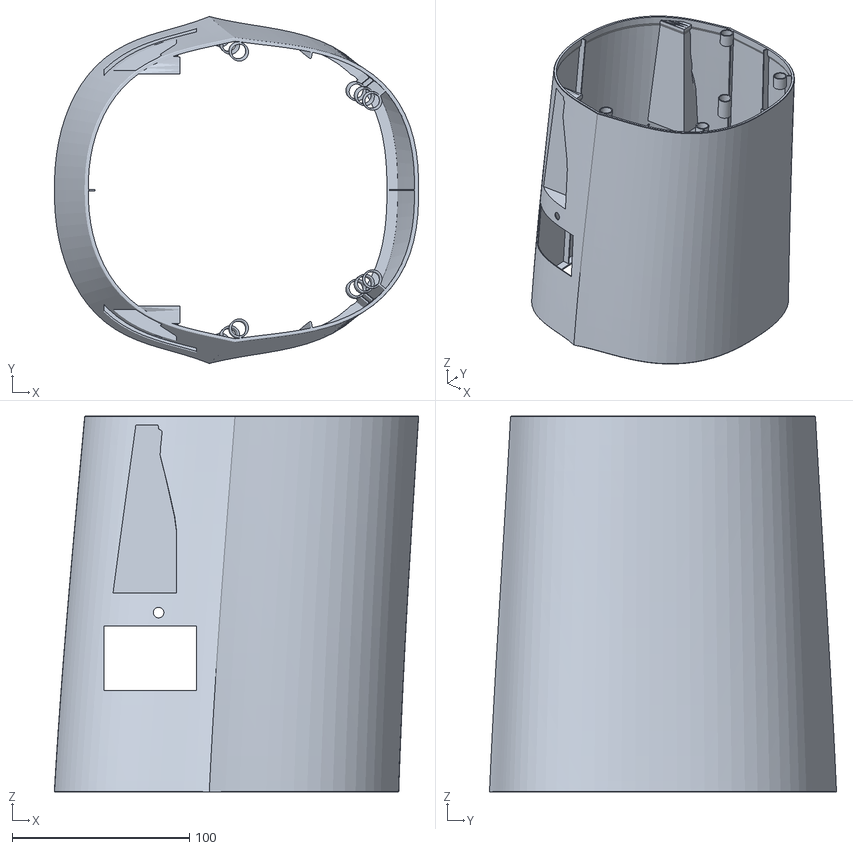
[picture p89: CAD file, 2026-10-04]
ucav/out/stl/fus_ring_5.stl
205.7 x 196.0 x 212.3
