ahmet6141/Drone-controller/ucav/out/stl/root_block_1.stl

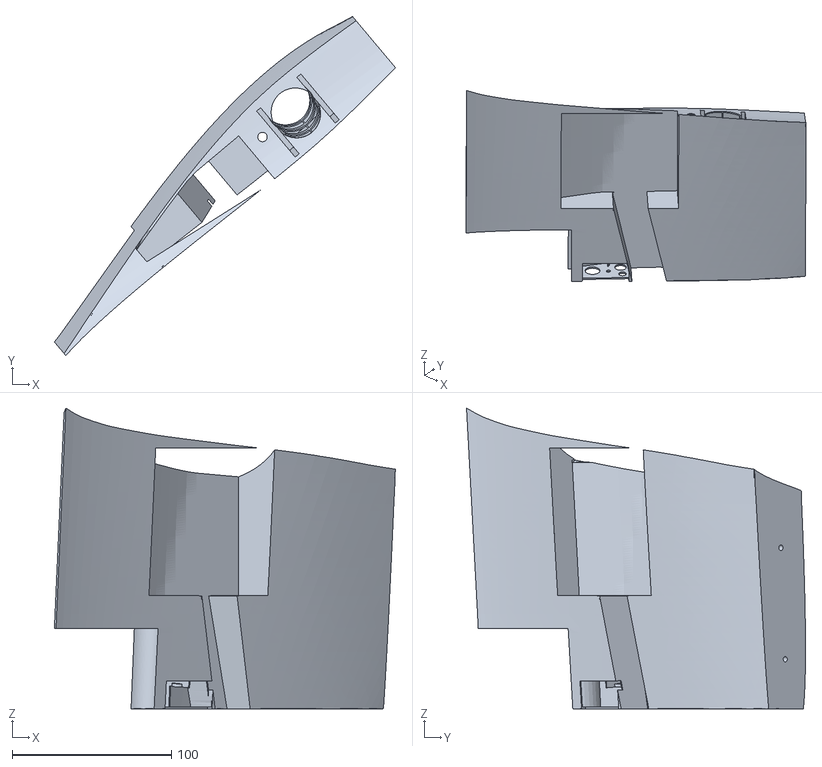
[picture p90: CAD file, 2026-10-04]
ucav/out/stl/root_block_1.stl
214.3 x 212.9 x 189.0
