ahmet6141/Drone-controller/ucav/out/stl/exhaust_ring.stl

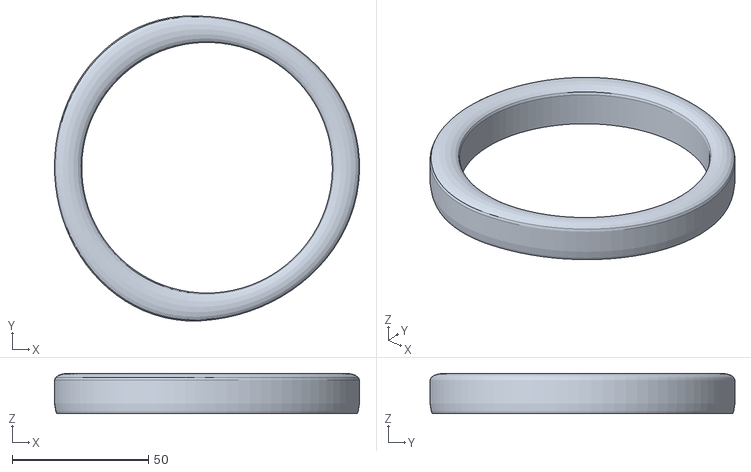
[picture p91: CAD file, 2026-10-04]
ucav/out/stl/exhaust_ring.stl
112.0 x 112.0 x 14.8
