ahmet6141/Drone-controller/ucav/out/stl/tolerance_coupon.stl

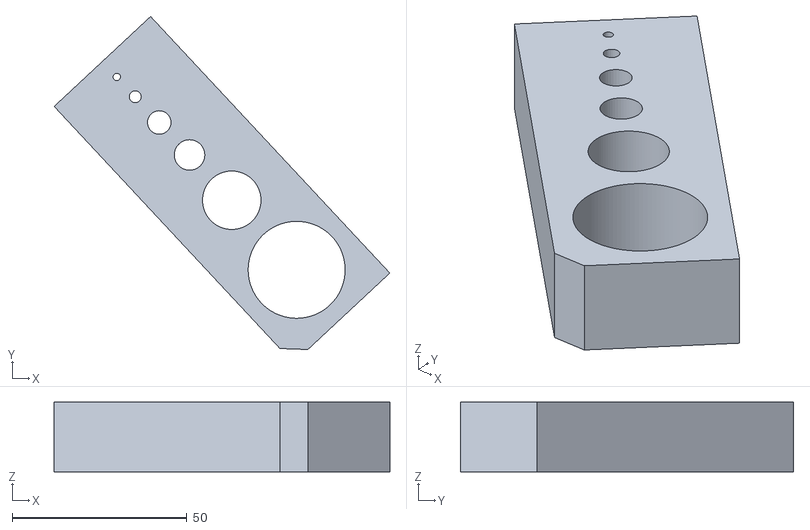
[picture p92: CAD file, 2026-10-04]
ucav/out/stl/tolerance_coupon.stl
96.0 x 95.2 x 20.0
