ahmet6141/Drone-controller/ucav/out/stl/flapout_2.stl

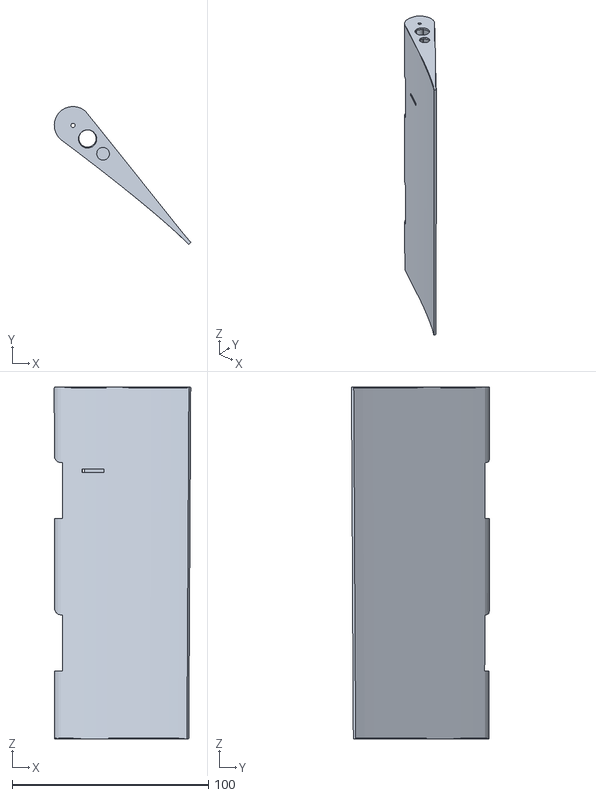
[picture p93: CAD file, 2026-10-04]
ucav/out/stl/flapout_2.stl
69.5 x 70.3 x 179.2
