ahmet6141/Drone-controller/ucav/out/stl/elevator_2a.stl

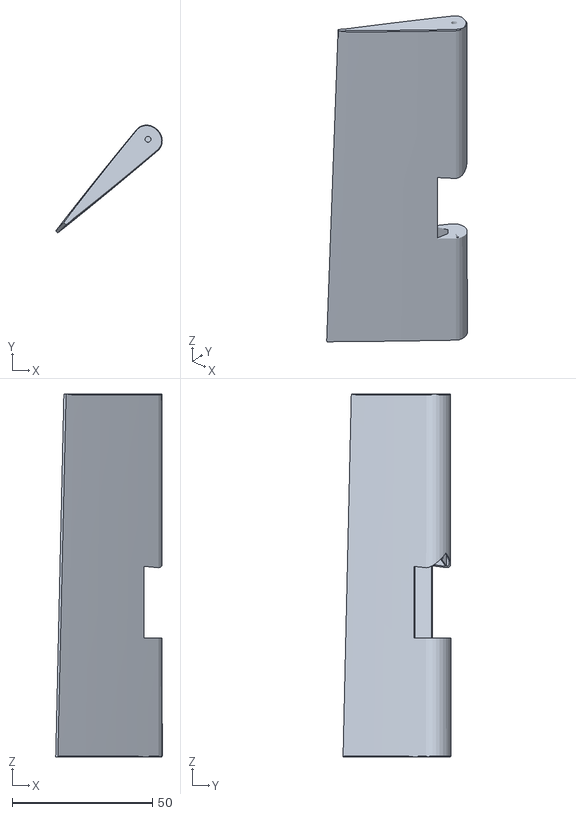
[picture p94: CAD file, 2026-10-04]
ucav/out/stl/elevator_2a.stl
38.0 x 38.5 x 129.4
