ahmet6141/Drone-controller/ucav/out/stl/cowl_cheek_R.stl

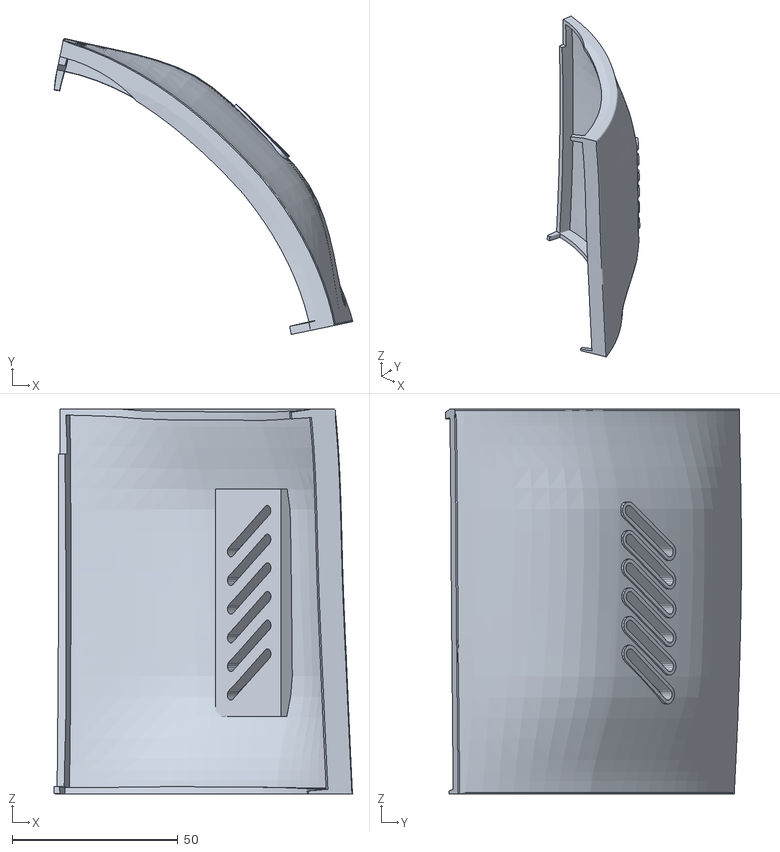
[picture p95: CAD file, 2026-10-04]
ucav/out/stl/cowl_cheek_R.stl
90.0 x 89.2 x 116.0
