ahmet6141/Drone-controller/ucav/out/stl/wing_panel_3.stl

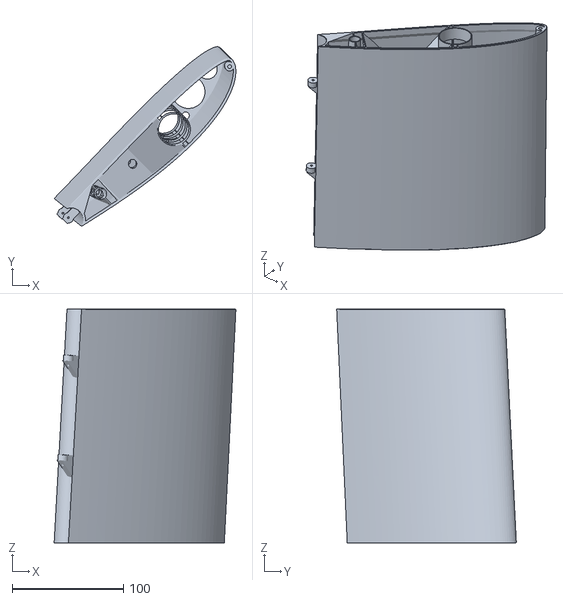
[picture p96: CAD file, 2026-10-04]
ucav/out/stl/wing_panel_3.stl
163.1 x 161.3 x 210.0
