ahmet6141/Drone-controller/ucav/out/stl/fus_ring_8.stl

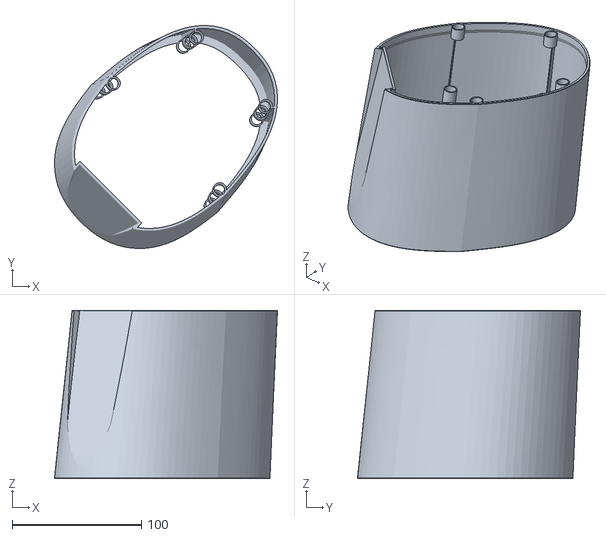
[picture p97: CAD file, 2026-10-04]
ucav/out/stl/fus_ring_8.stl
172.6 x 172.6 x 130.0
