ahmet6141/Drone-controller/ucav/out/stl/fus_nose_module.stl

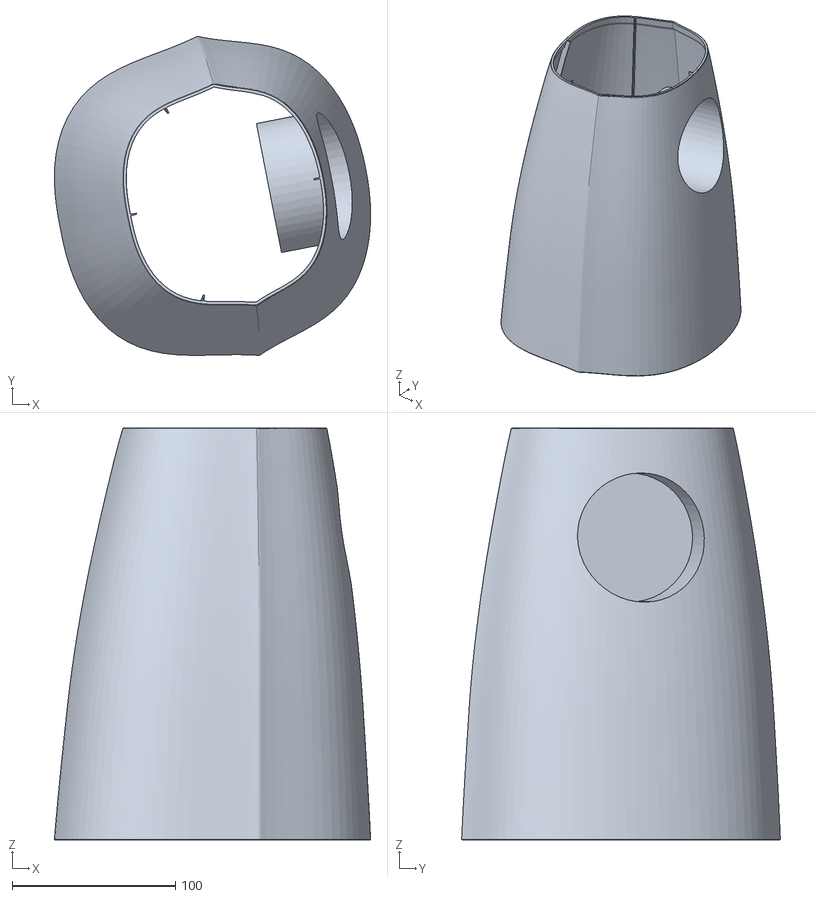
[picture p98: CAD file, 2026-10-04]
ucav/out/stl/fus_nose_module.stl
193.4 x 195.0 x 252.0
