ahmet6141/Drone-controller/ucav/out/stl/panel_lock_tab.stl

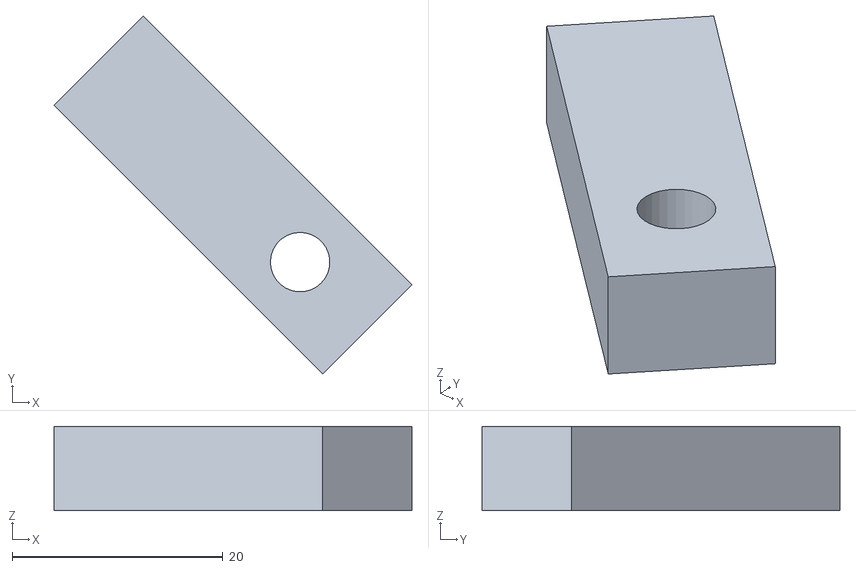
[picture p99: CAD file, 2026-10-04]
ucav/out/stl/panel_lock_tab.stl
33.9 x 33.9 x 8.00
