ahmet6141/Drone-controller/ucav/out/stl/aileron_4.stl

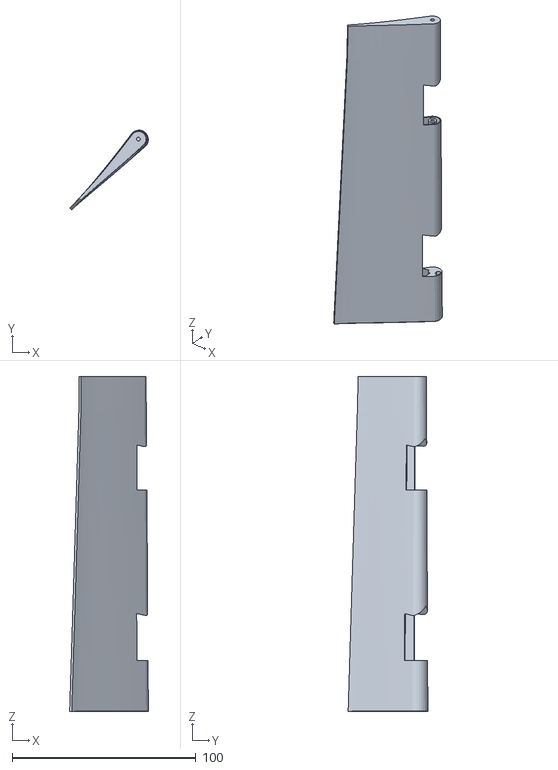
[picture p100: CAD file, 2026-10-04]
ucav/out/stl/aileron_4.stl
42.9 x 43.4 x 182.2
