ahmet6141/Drone-controller/ucav/out/stl/aileron_2.stl

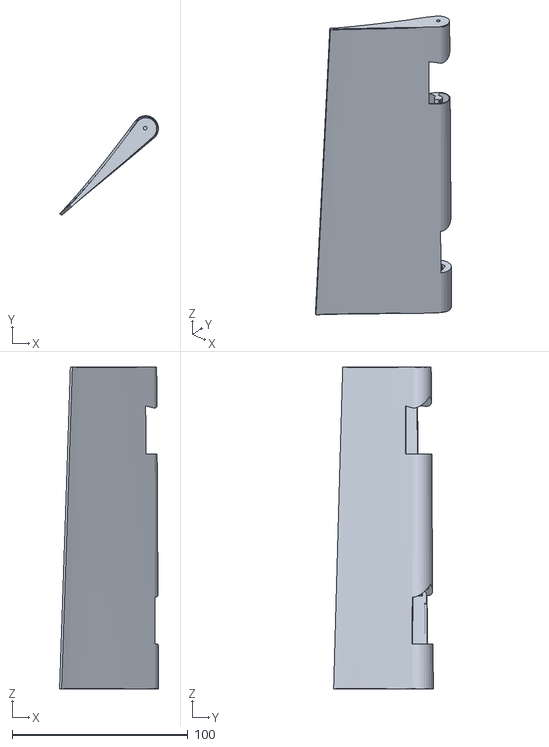
[picture p101: CAD file, 2026-10-04]
ucav/out/stl/aileron_2.stl
56.4 x 56.8 x 183.4
