ahmet6141/Drone-controller/ucav/out/stl/rudder_b.stl

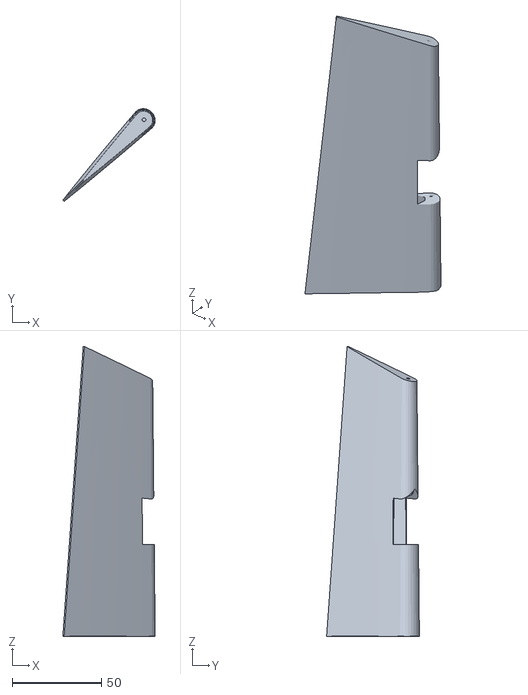
[picture p102: CAD file, 2026-10-04]
ucav/out/stl/rudder_b.stl
51.6 x 51.9 x 162.1
