ahmet6141/Drone-controller/ucav/out/stl/engine_ring.stl

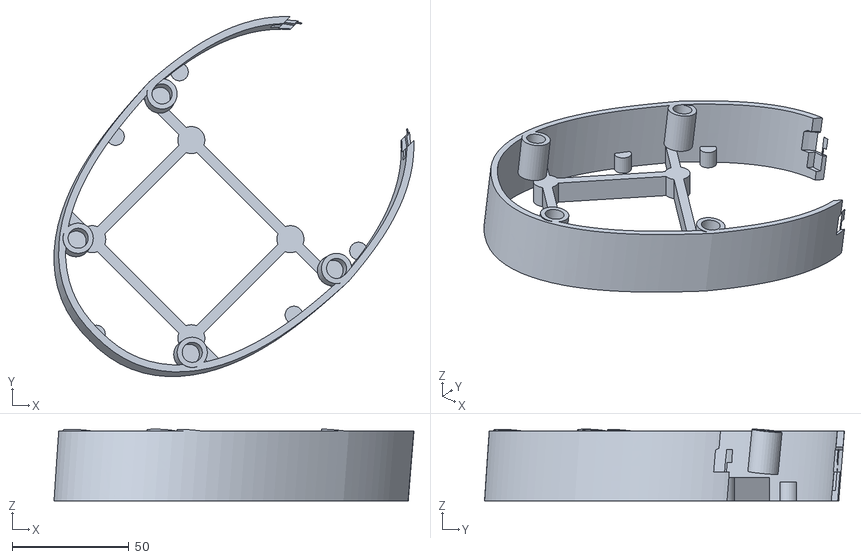
[picture p103: CAD file, 2026-10-04]
ucav/out/stl/engine_ring.stl
154.2 x 154.2 x 30.7
