ahmet6141/Drone-controller/ucav/out/stl/door_L_2.stl

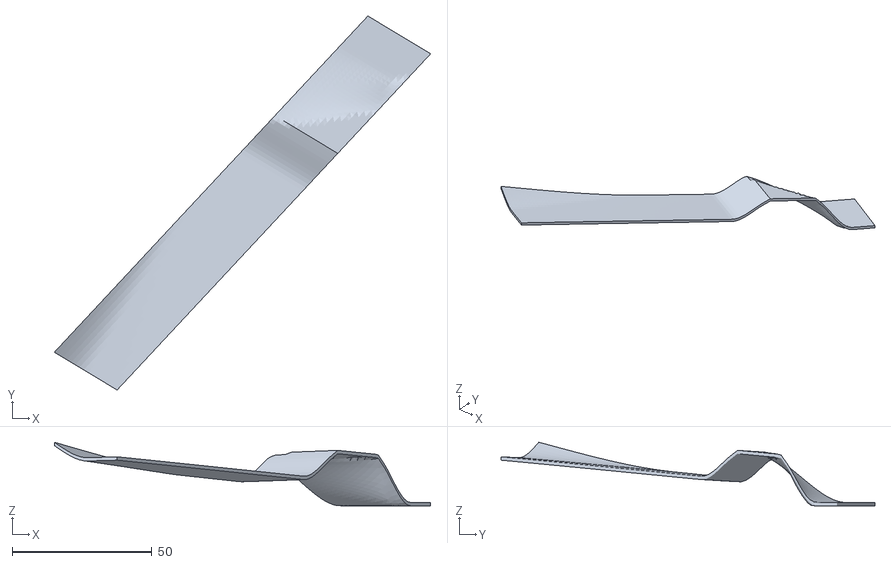
[picture p104: CAD file, 2026-10-04]
ucav/out/stl/door_L_2.stl
134.5 x 133.6 x 22.7
