ahmet6141/Drone-controller/ucav/out/stl/wing_panel_7.stl

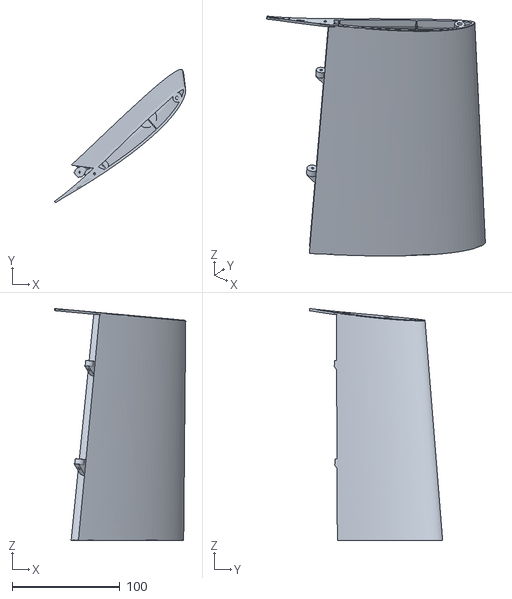
[picture p105: CAD file, 2026-10-04]
ucav/out/stl/wing_panel_7.stl
122.1 x 123.9 x 215.4
