ahmet6141/Drone-controller/ucav/out/stl/cowl_cheek_L.stl

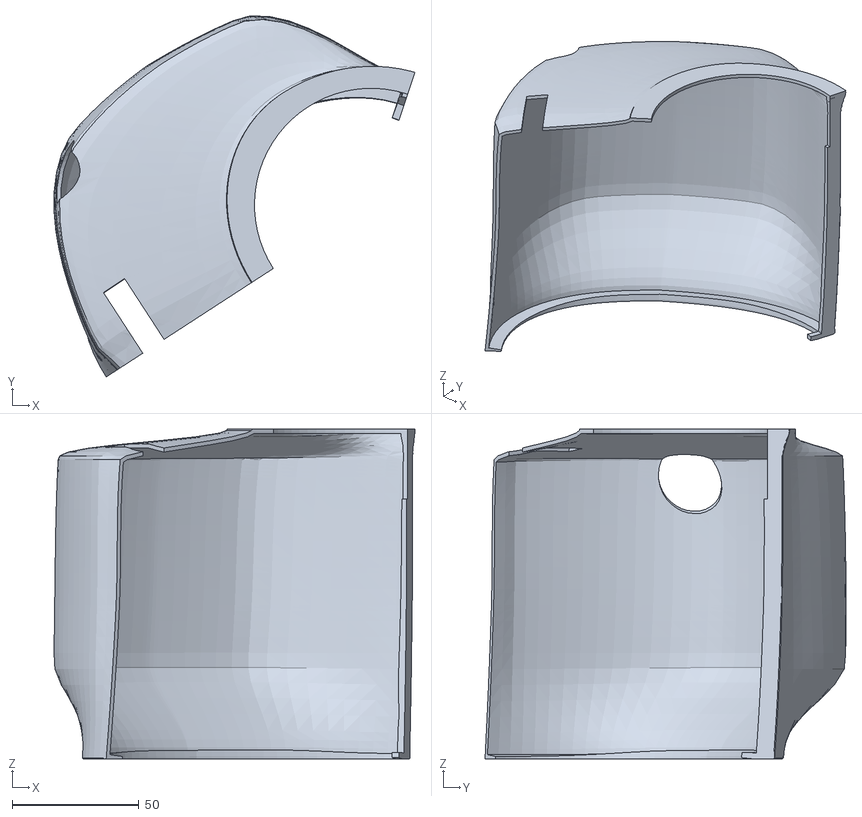
[picture p106: CAD file, 2026-10-04]
ucav/out/stl/cowl_cheek_L.stl
142.4 x 142.4 x 130.0
