ahmet6141/Drone-controller/ucav/out/stl/wing_tip.stl

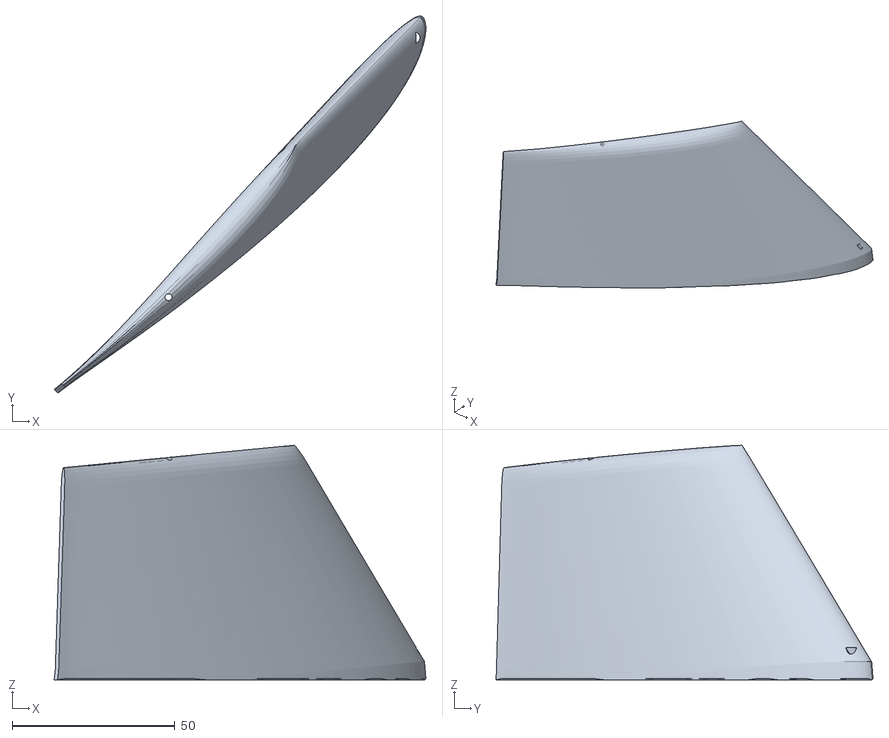
[picture p107: CAD file, 2026-10-04]
ucav/out/stl/wing_tip.stl
114.3 x 115.9 x 72.1
