ahmet6141/Drone-controller/ucav/out/stl/door_N_3.stl

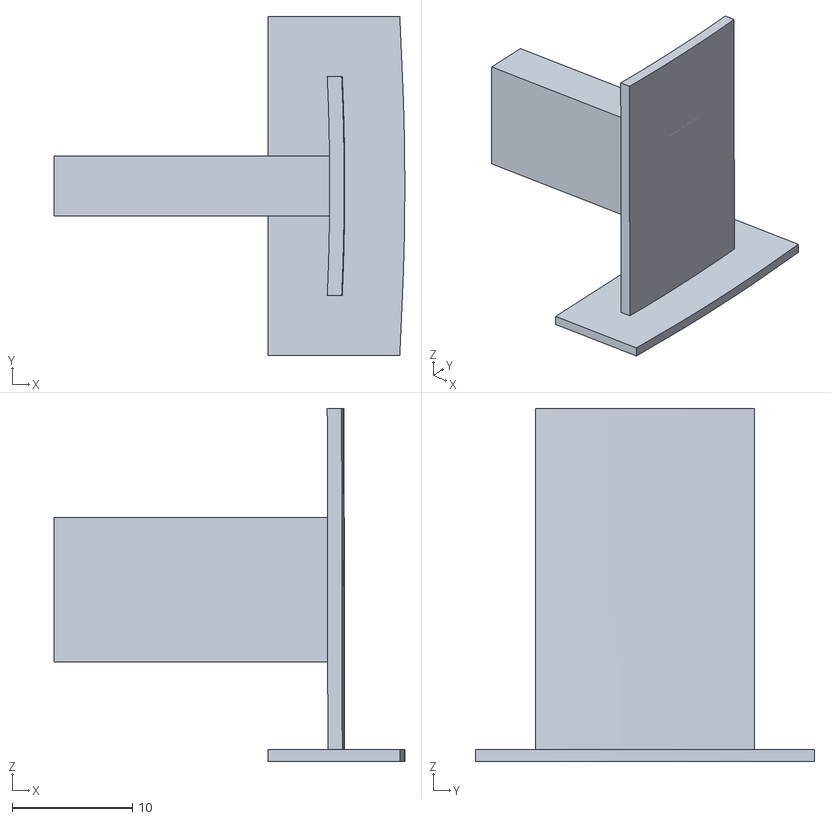
[picture p108: CAD file, 2026-10-04]
ucav/out/stl/door_N_3.stl
29.2 x 28.2 x 29.4
