ahmet6141/Drone-controller/ucav/out/stl/wing_panel_6.stl

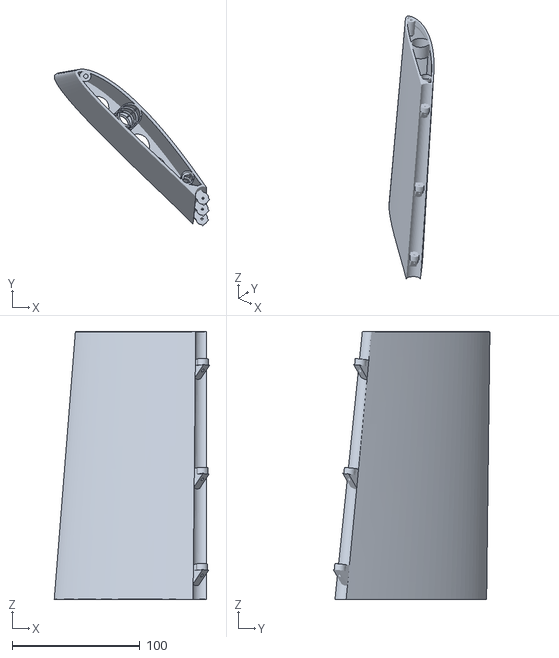
[picture p109: CAD file, 2026-10-04]
ucav/out/stl/wing_panel_6.stl
121.9 x 122.9 x 210.0
