ahmet6141/Drone-controller/ucav/out/stl/fin_2.stl

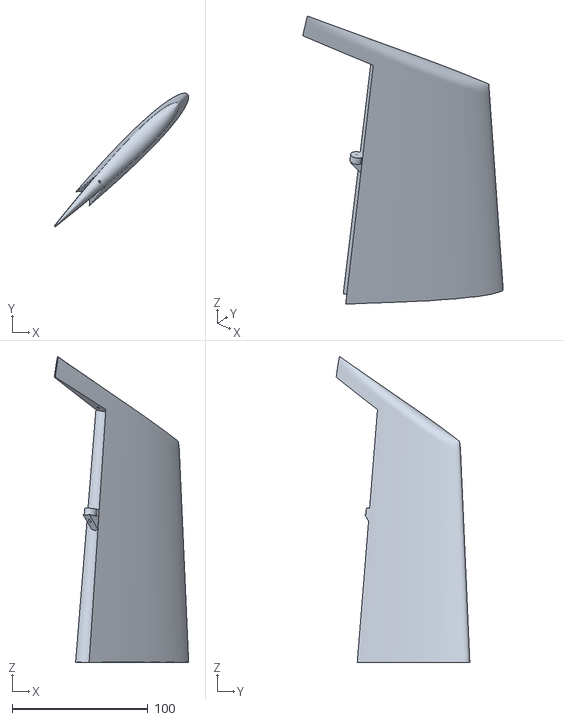
[picture p110: CAD file, 2026-10-04]
ucav/out/stl/fin_2.stl
99.2 x 98.6 x 225.7
