ahmet6141/Drone-controller/ucav/out/stl/hatch_buck_b.stl

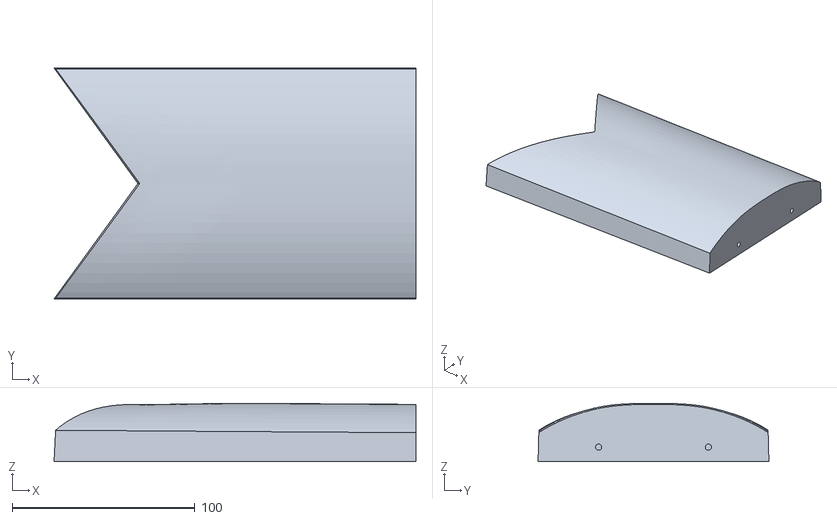
[picture p111: CAD file, 2026-10-04]
ucav/out/stl/hatch_buck_b.stl
197.9 x 126.2 x 32.0
