ahmet6141/Drone-controller/ucav/out/stl/fus_ring_1.stl

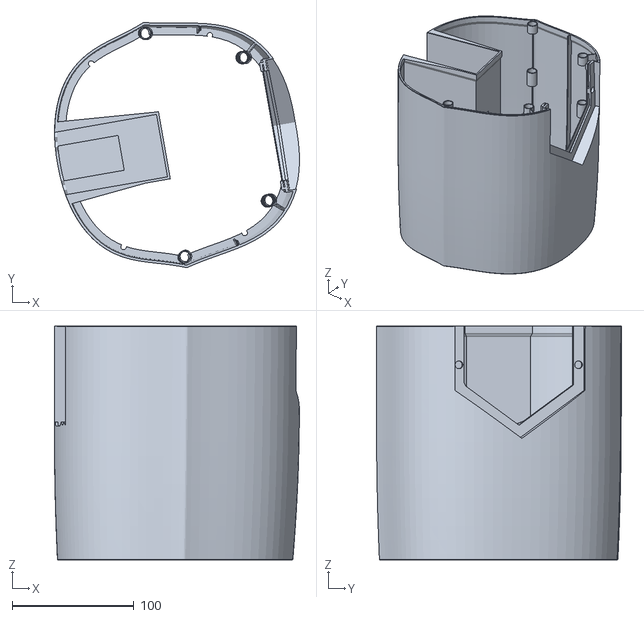
[picture p112: CAD file, 2026-10-04]
ucav/out/stl/fus_ring_1.stl
201.0 x 201.1 x 191.7
