ahmet6141/Drone-controller/ucav/out/stl/flapout_3.stl

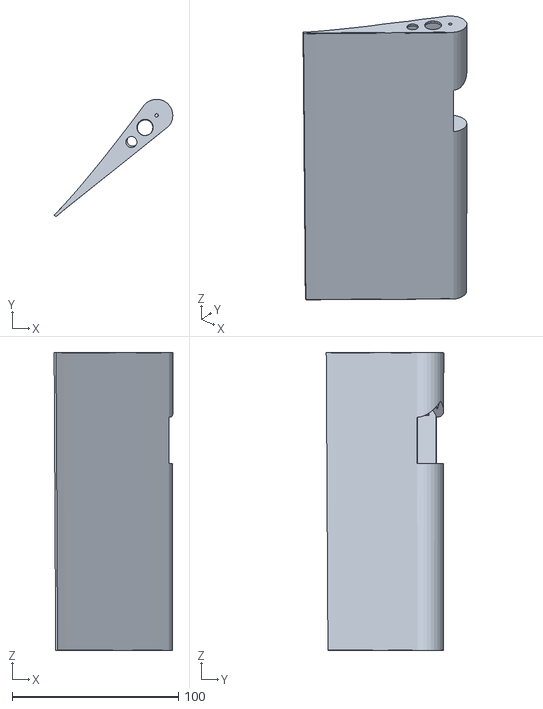
[picture p113: CAD file, 2026-10-04]
ucav/out/stl/flapout_3.stl
71.4 x 70.7 x 179.2
