ahmet6141/Drone-controller/ucav/out/stl/door_L_1.stl

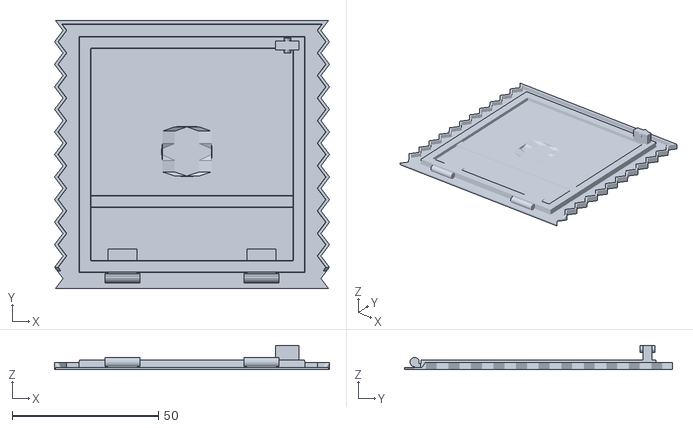
[picture p114: CAD file, 2026-10-04]
ucav/out/stl/door_L_1.stl
94.0 x 91.5 x 8.30
