ahmet6141/Drone-controller/ucav/out/stl/fus_ring_7.stl

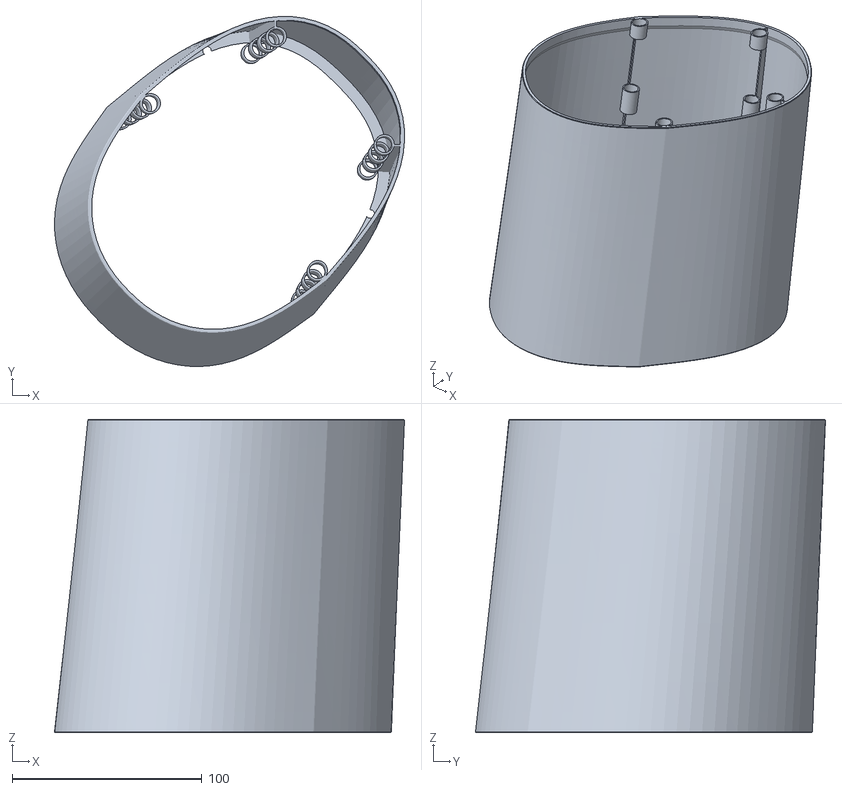
[picture p115: CAD file, 2026-10-04]
ucav/out/stl/fus_ring_7.stl
184.4 x 184.4 x 165.0
