ahmet6141/Drone-controller/ucav/out/stl/hatch_frame_b.stl

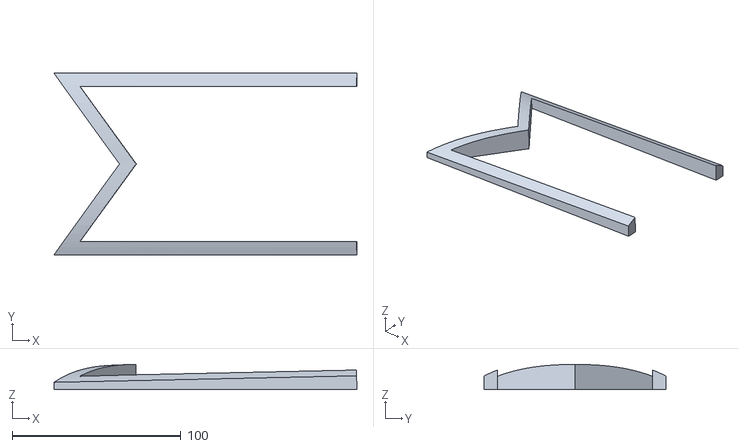
[picture p116: CAD file, 2026-10-04]
ucav/out/stl/hatch_frame_b.stl
179.6 x 107.6 x 15.1
