ahmet6141/Drone-controller/ucav/out/stl/fus_ring_3.stl

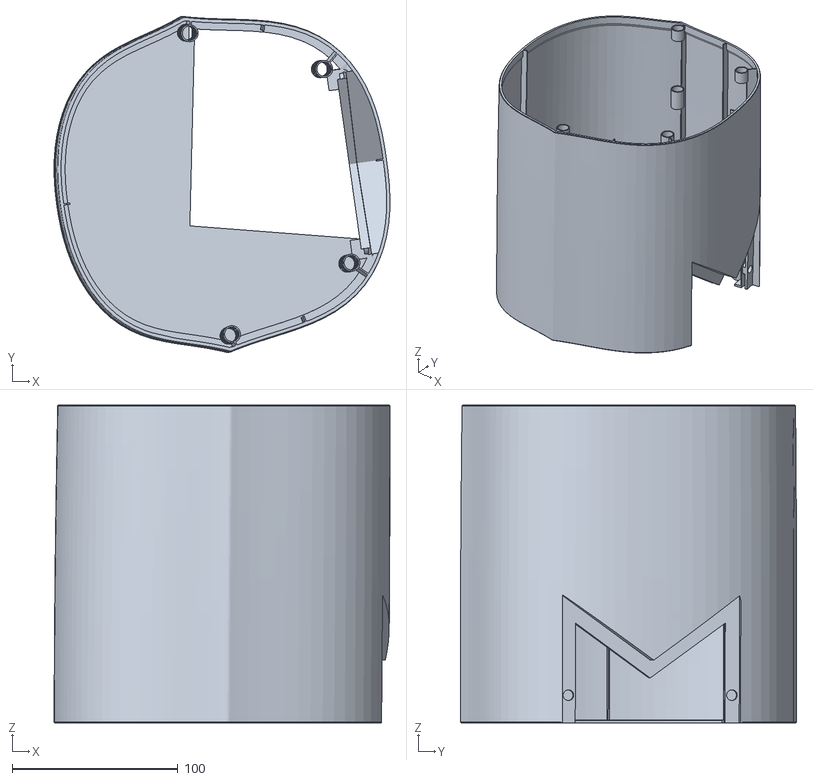
[picture p117: CAD file, 2026-10-04]
ucav/out/stl/fus_ring_3.stl
202.7 x 202.7 x 191.7
