ahmet6141/Drone-controller/ucav/out/stl/flapin.stl

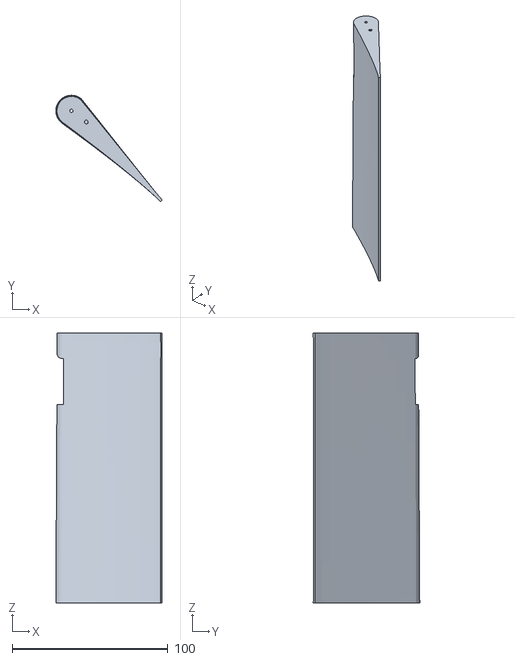
[picture p118: CAD file, 2026-10-04]
ucav/out/stl/flapin.stl
68.4 x 68.5 x 173.4
