ahmet6141/Drone-controller/ucav/out/stl/root_fairing.stl

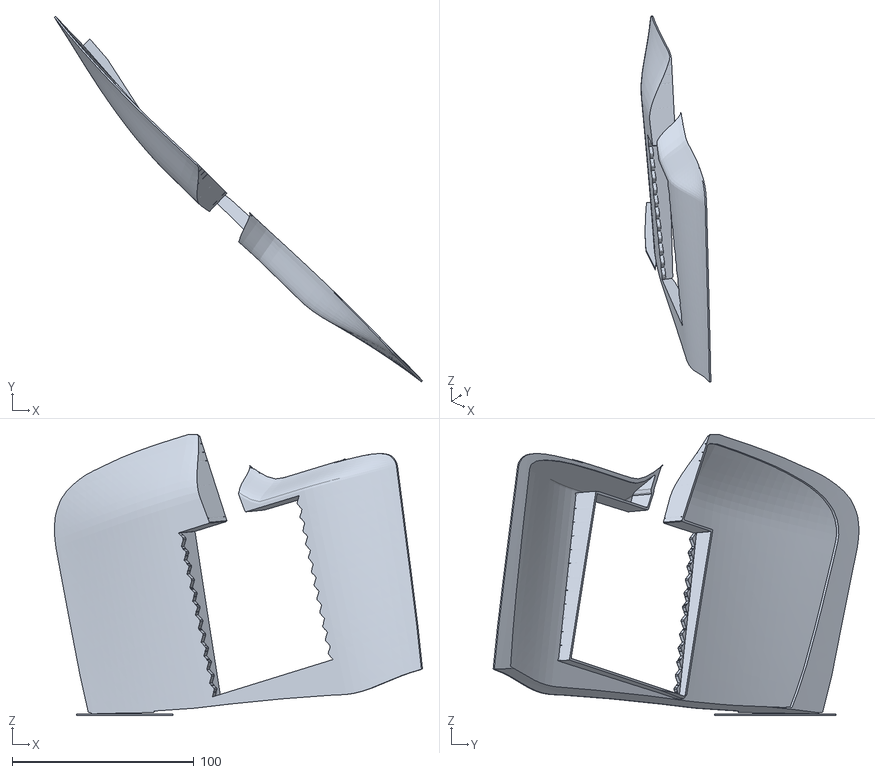
[picture p119: CAD file, 2026-10-04]
ucav/out/stl/root_fairing.stl
202.3 x 201.0 x 154.6
