ahmet6141/Drone-controller/ucav/out/stl/wing_panel_4.stl

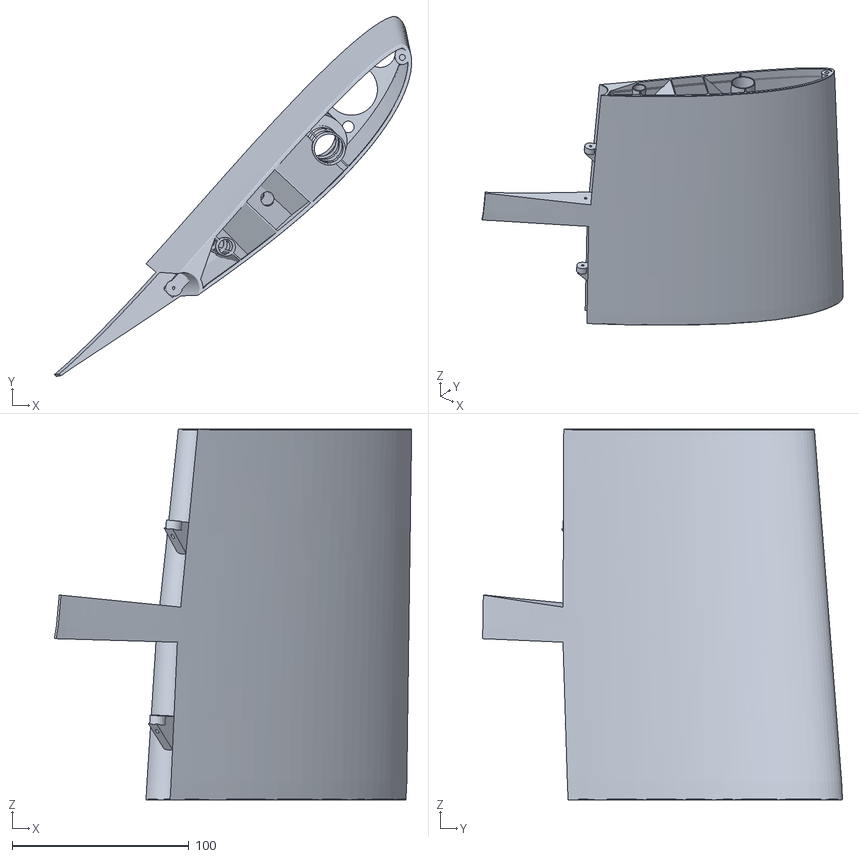
[picture p120: CAD file, 2026-10-04]
ucav/out/stl/wing_panel_4.stl
202.4 x 203.9 x 210.0
