ahmet6141/Drone-controller/ucav/out/stl/scuff_pad.stl

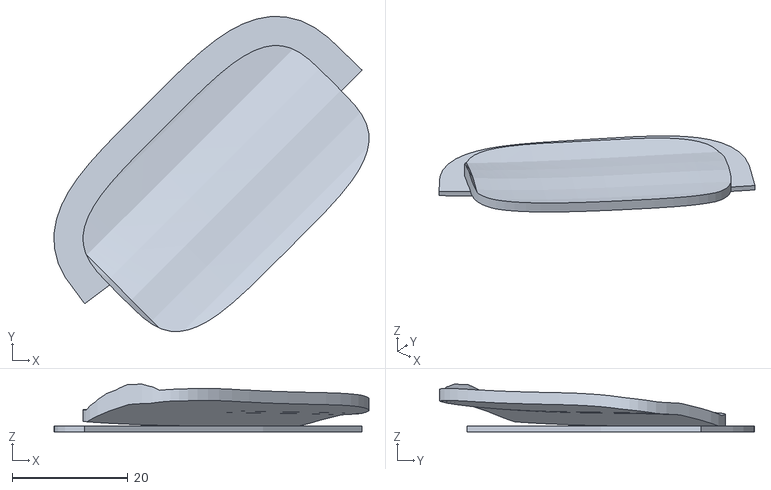
[picture p121: CAD file, 2026-10-04]
ucav/out/stl/scuff_pad.stl
54.3 x 54.3 x 8.21
