ahmet6141/Drone-controller/ucav/out/stl/wing_panel_1.stl

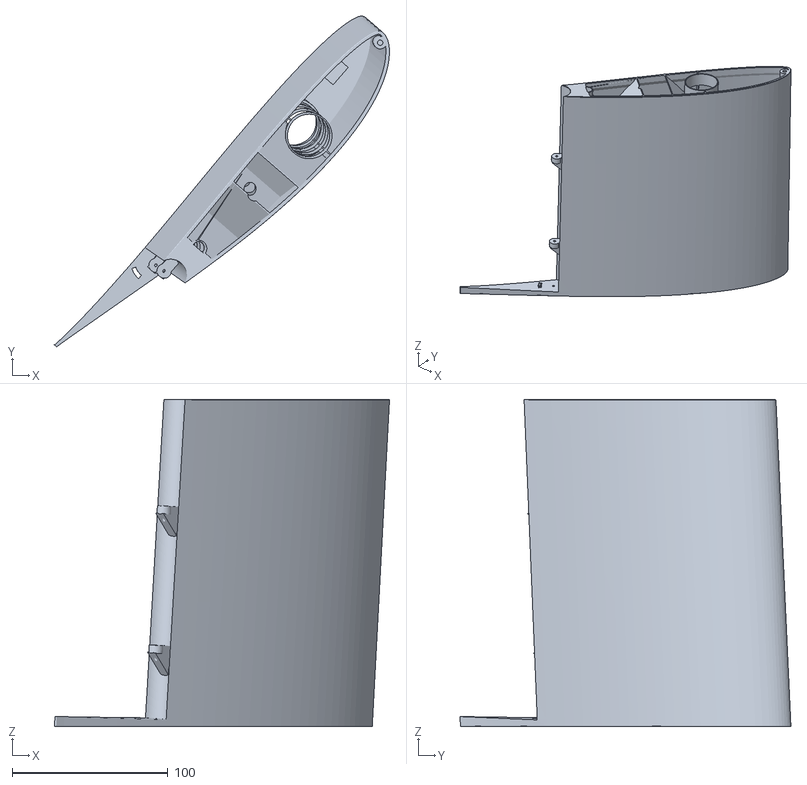
[picture p122: CAD file, 2026-10-04]
ucav/out/stl/wing_panel_1.stl
215.0 x 212.4 x 210.0
