ahmet6141/Drone-controller/ucav/out/stl/elevator_2b.stl

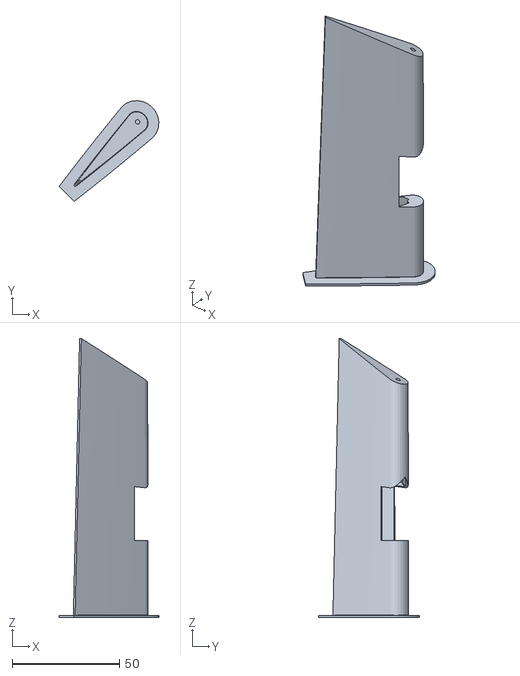
[picture p123: CAD file, 2026-10-04]
ucav/out/stl/elevator_2b.stl
46.6 x 47.1 x 130.3
