ahmet6141/Drone-controller/ucav/out/stl/stab_1.stl

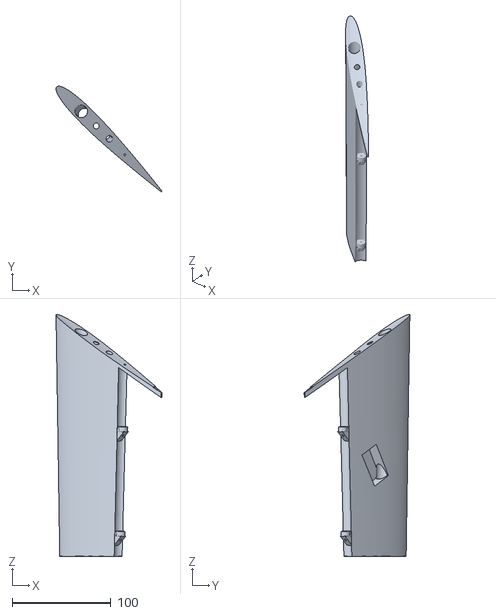
[picture p124: CAD file, 2026-10-04]
ucav/out/stl/stab_1.stl
107.2 x 106.9 x 244.8
