ahmet6141/Drone-controller/ucav/out/stl/door_N_1.stl

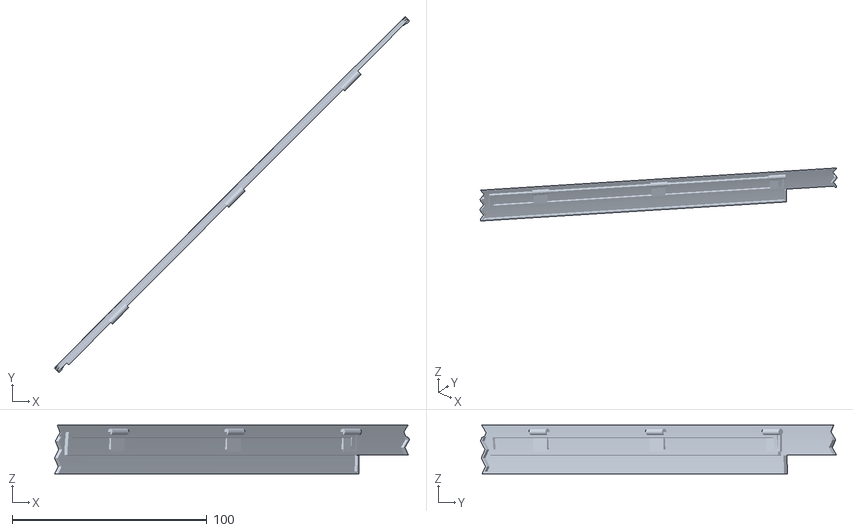
[picture p125: CAD file, 2026-10-04]
ucav/out/stl/door_N_1.stl
182.2 x 182.7 x 25.0
