ahmet6141/Drone-controller/ucav/out/stl/wing_frame_fwd.stl

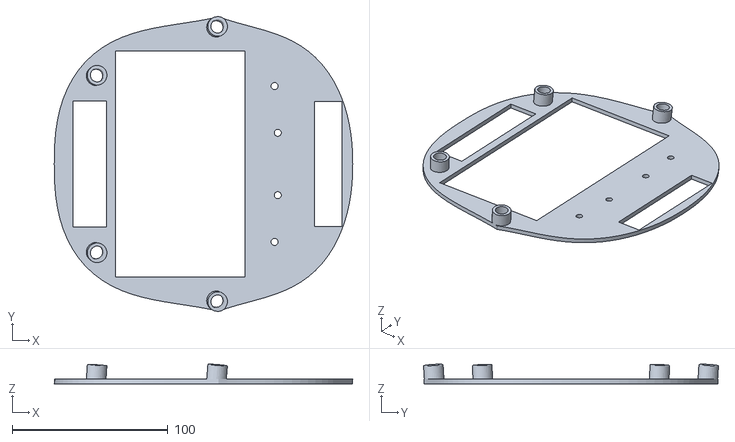
[picture p126: CAD file, 2026-10-04]
ucav/out/stl/wing_frame_fwd.stl
191.4 x 189.2 x 12.6
