ahmet6141/Drone-controller/ucav/out/stl/stab_2a.stl

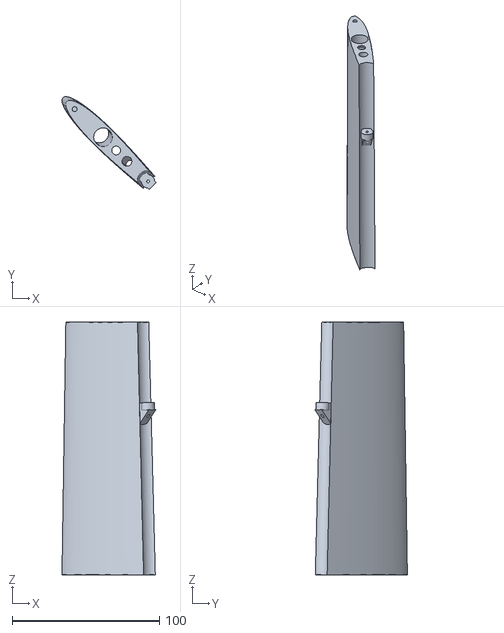
[picture p127: CAD file, 2026-10-04]
ucav/out/stl/stab_2a.stl
64.0 x 63.1 x 172.0
