ahmet6141/Drone-controller/ucav/out/stl/fin_1.stl

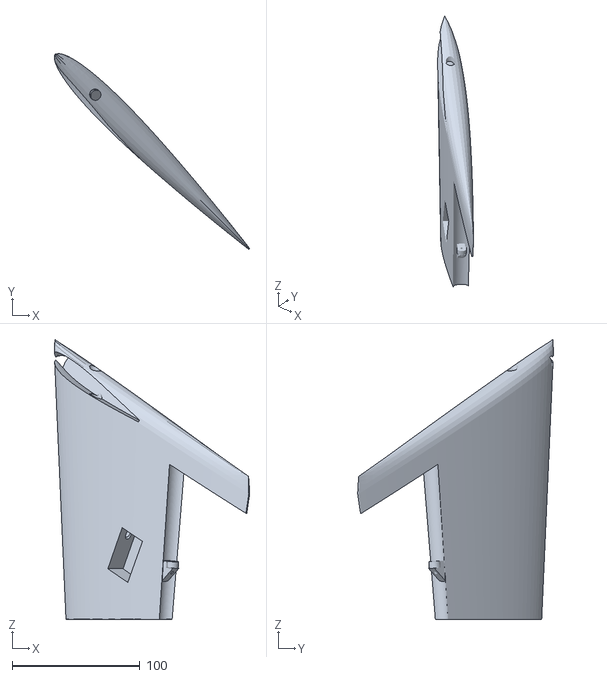
[picture p128: CAD file, 2026-10-04]
ucav/out/stl/fin_1.stl
153.1 x 153.4 x 219.5
