ahmet6141/Drone-controller/ucav/out/stl/rudder_a.stl

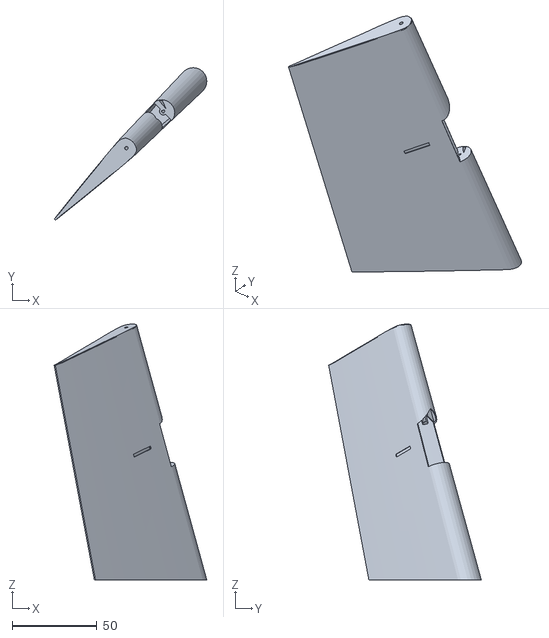
[picture p129: CAD file, 2026-10-04]
ucav/out/stl/rudder_a.stl
90.2 x 90.2 x 151.2
