ahmet6141/Drone-controller/ucav/out/stl/stab_2b.stl

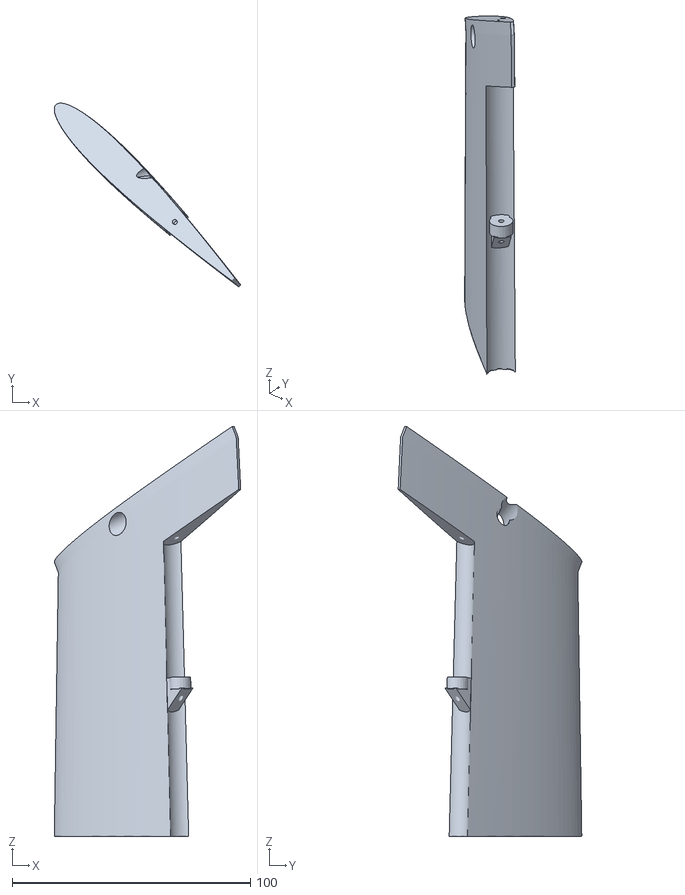
[picture p130: CAD file, 2026-10-04]
ucav/out/stl/stab_2b.stl
78.2 x 77.1 x 172.0
