ahmet6141/Drone-controller/ucav/out/stl/aileron_1.stl

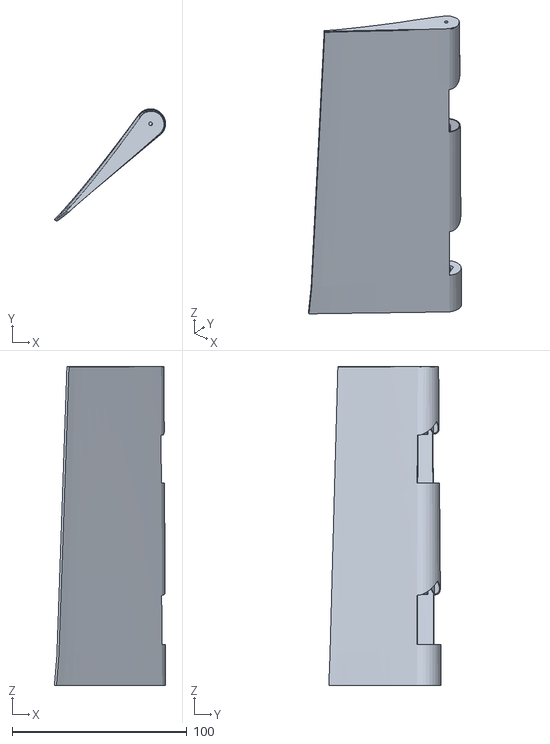
[picture p131: CAD file, 2026-10-04]
ucav/out/stl/aileron_1.stl
63.6 x 64.3 x 182.4
