ahmet6141/Drone-controller/ucav/out/stl/gear_mount_N.stl

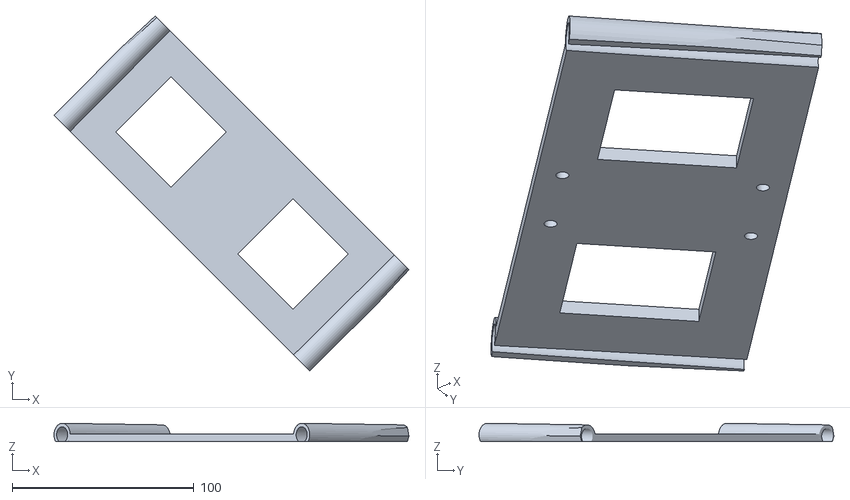
[picture p132: CAD file, 2026-10-04]
ucav/out/stl/gear_mount_N.stl
195.3 x 195.3 x 10.1
