ahmet6141/Drone-controller/ucav/out/stl/fus_nose_cone.stl

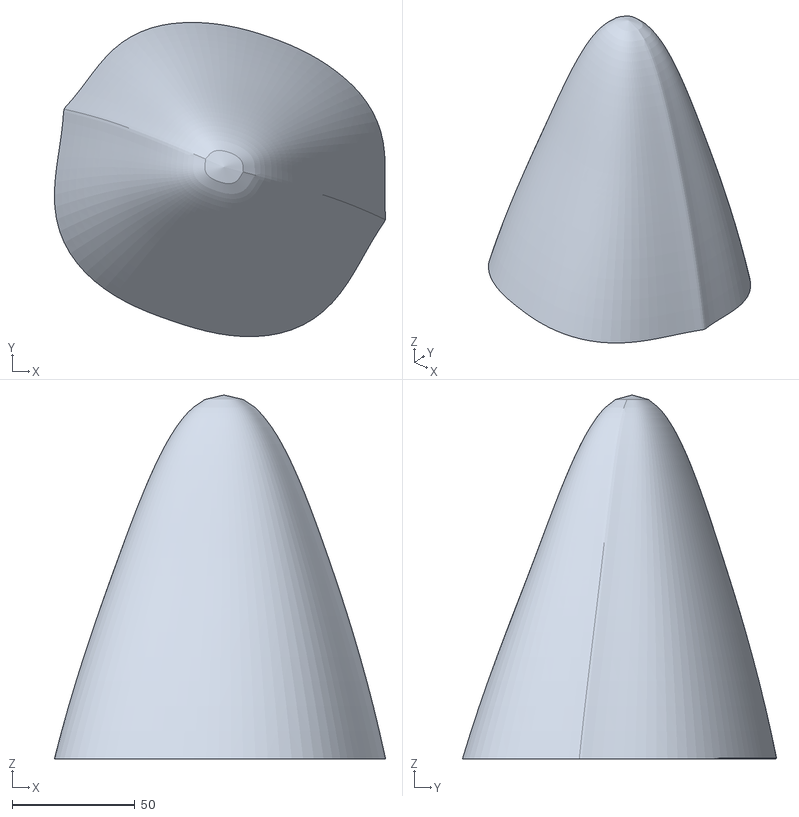
[picture p133: CAD file, 2026-10-04]
ucav/out/stl/fus_nose_cone.stl
134.7 x 127.7 x 148.0
