ahmet6141/Drone-controller/ucav/out/stl/gear_mount_L.stl

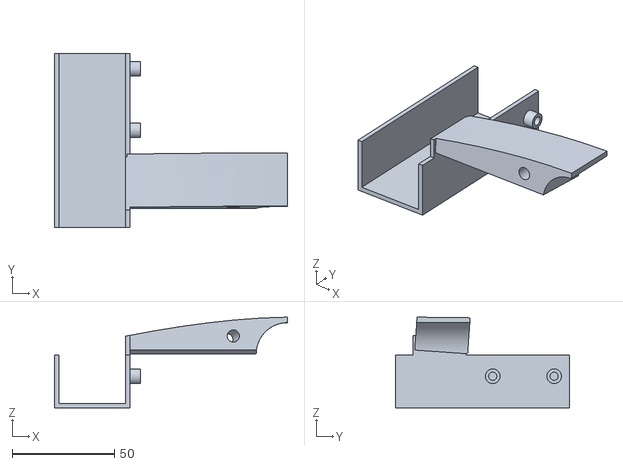
[picture p134: CAD file, 2026-10-04]
ucav/out/stl/gear_mount_L.stl
114.1 x 85.2 x 44.4
