ahmet6141/Drone-controller/ucav/out/stl/flapout_4.stl

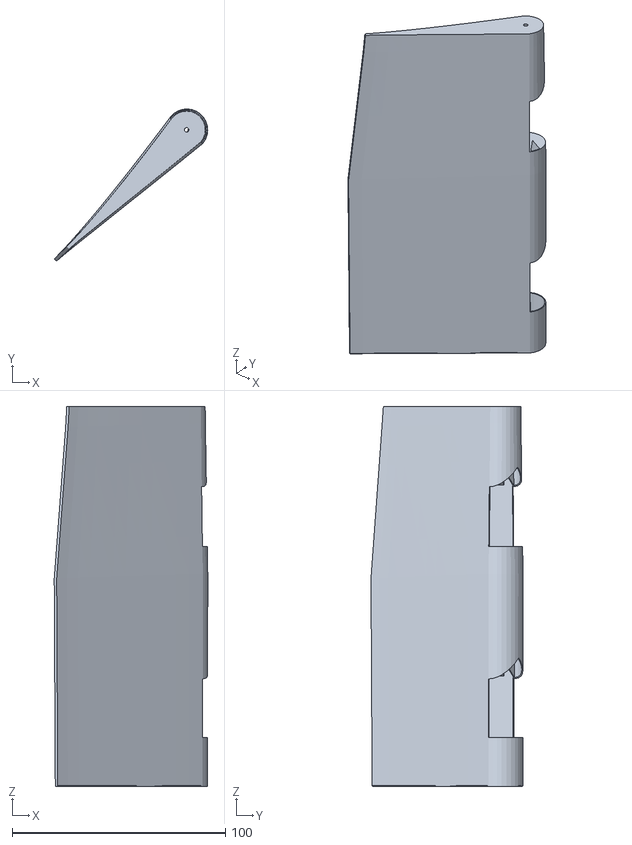
[picture p135: CAD file, 2026-10-04]
ucav/out/stl/flapout_4.stl
72.0 x 71.3 x 178.2
