ahmet6141/Drone-controller/ucav/out/stl/hatch_buck_a.stl

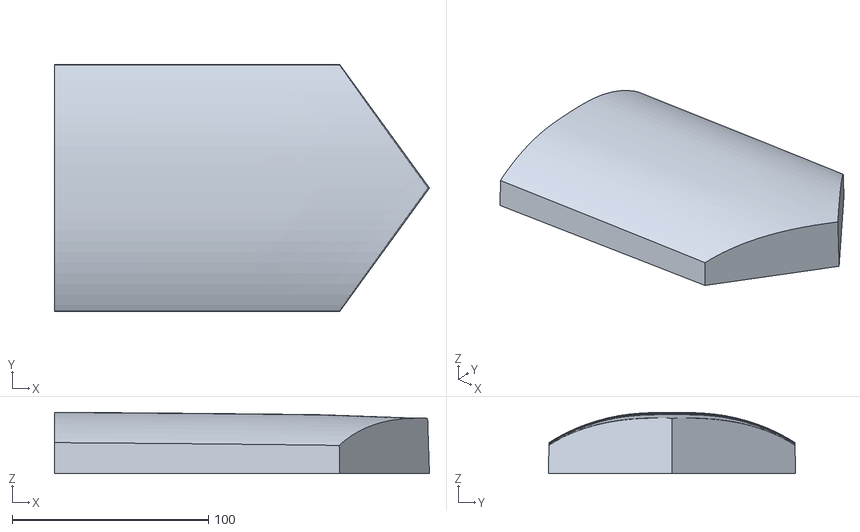
[picture p136: CAD file, 2026-10-04]
ucav/out/stl/hatch_buck_a.stl
191.2 x 126.2 x 31.4
