ahmet6141/Drone-controller/ucav/out/stl/hatch_frame_a.stl

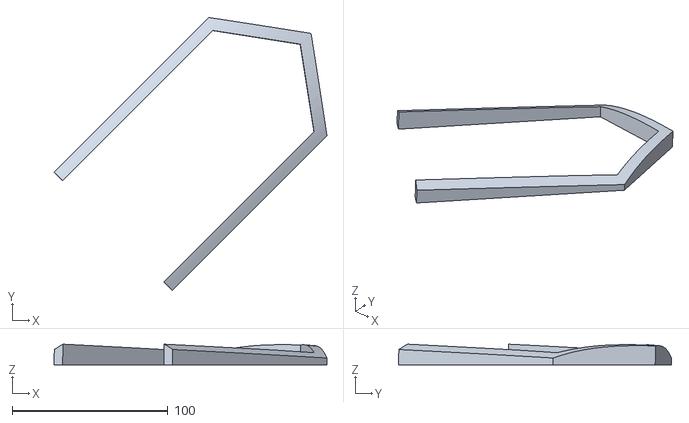
[picture p137: CAD file, 2026-10-04]
ucav/out/stl/hatch_frame_a.stl
175.5 x 175.5 x 13.3
