ahmet6141/Drone-controller/ucav/out/stl/aileron_3.stl

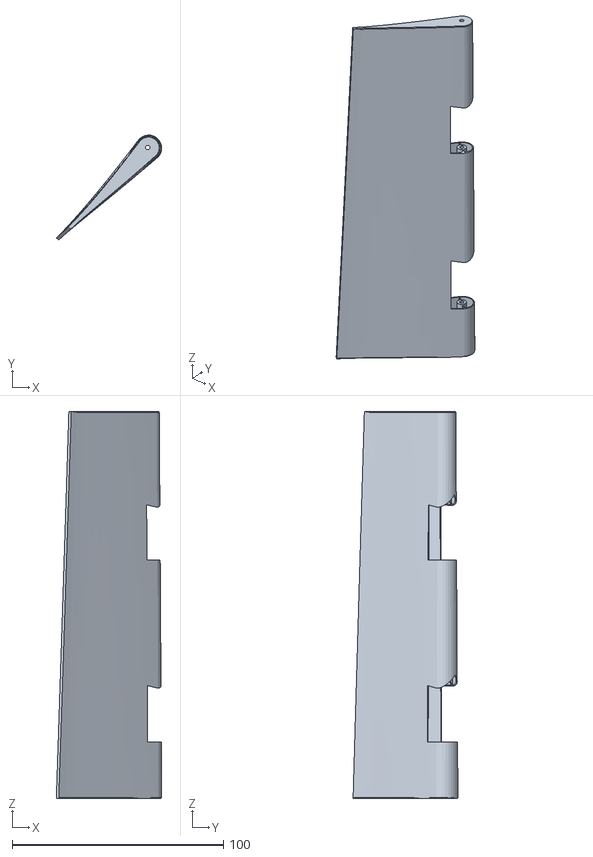
[picture p138: CAD file, 2026-10-04]
ucav/out/stl/aileron_3.stl
49.9 x 49.7 x 183.4
