ahmet6141/Drone-controller/ucav/out/stl/glove_strake.stl

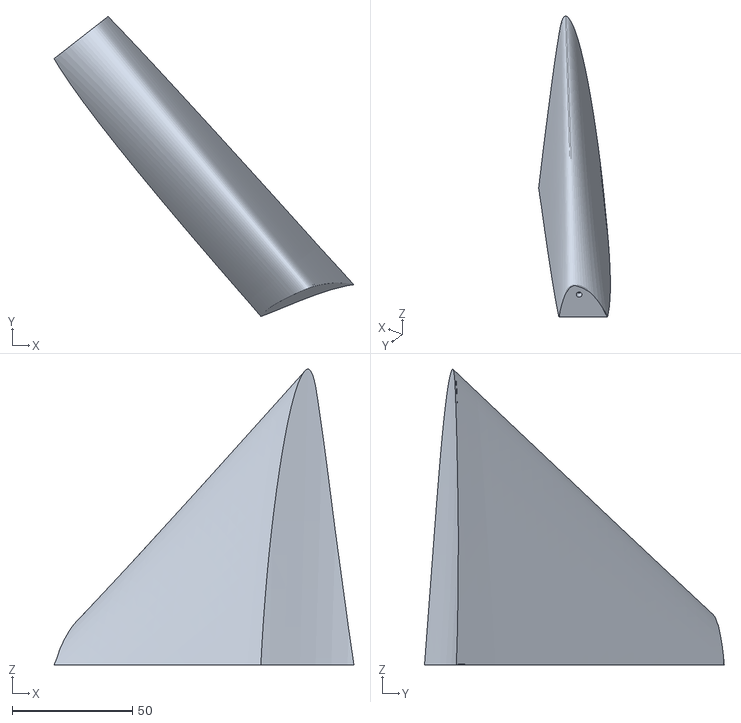
[picture p139: CAD file, 2026-10-04]
ucav/out/stl/glove_strake.stl
124.5 x 124.5 x 122.8
