ahmet6141/Drone-controller/ucav/out/stl/cowl_top.stl

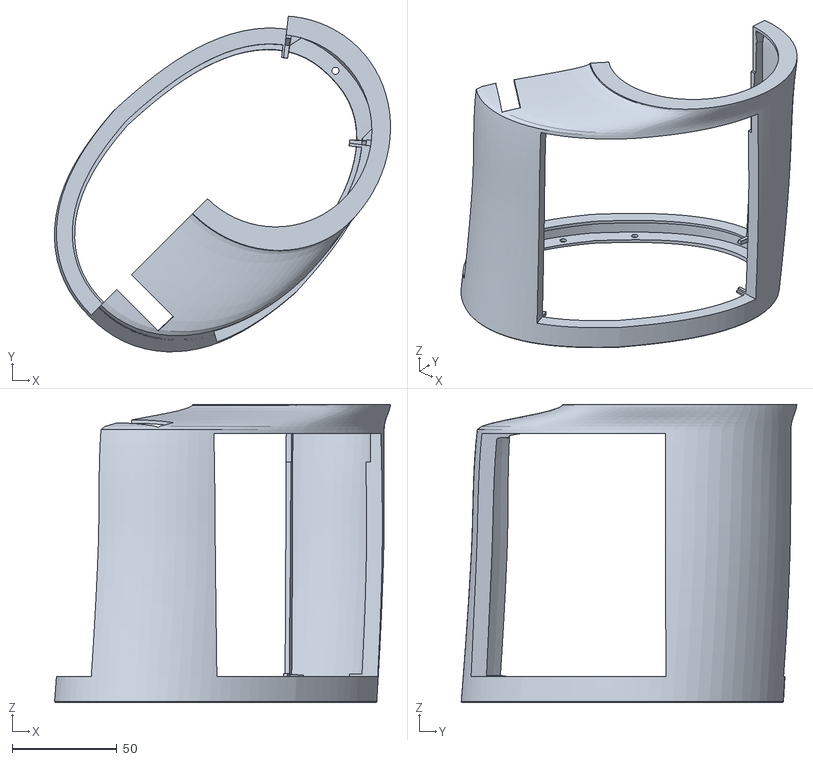
[picture p140: CAD file, 2026-10-04]
ucav/out/stl/cowl_top.stl
160.6 x 160.4 x 142.5
