ahmet6141/Drone-controller/(list of files, cad)

Other CAD files:
cad/out/stl/companion_tray.stl
ucav/out/stl/longeron_joint_chine.stl
ucav/out/stl/fus_ring_2.stl
ucav/out/stl/wing_panel_2.stl
