ahmet6141/Drone-controller/config/px4/base/30-failsafe.params

# DC7 — failsafe, batarya, geofence, RTL
# PX4 v1.17 (docs.px4.io/v1.17 parametre referansı ile doğrulandı: tools/validate_params.py)
# Yükleme: QGroundControl → Vehicle Setup → Parameters → Tools → Load from file.
# Sıra: base/10 → base/20 → base/30 → base/40 → profiles/<ortam>.params  (bkz. config/px4/README.md)
#
# Vehicle-Id	Component-Id	Name	Value	Type

#
# RC kaybı: 0.5 s. Harici (ROS 2) modlar dahil hiçbir mod RC kaybından muaf değil (COM_RCL_EXCEPT=0).
# Eylem (NAV_RCL_ACT) ortama göre profiles/ altında: dış mekân RTL, iç mekân Land.
1	1	COM_RC_LOSS_T	0.5	9
1	1	COM_RCL_EXCEPT	0	6
#
# Veri linki (GCS) kaybı: 10 s sonra, COM_FAIL_ACT_T kadar Hold, ardından RTL.
1	1	NAV_DLL_ACT	2	6
1	1	COM_DL_LOSS_T	10	6
1	1	COM_FAIL_ACT_T	5.0	9
#
# Pilot müdahalesi: otomatik ve offboard modlarda çubuk hareketi kontrolü pilota verir (bit 0+1).
# Offboard kaybı (yalnızca Offboard modu): 0.5 s → Position. Harici modlar kendi failsafe'ine sahiptir.
1	1	COM_RC_OVERRIDE	3	6
1	1	COM_OBL_RC_ACT	0	6
1	1	COM_OF_LOSS_T	0.5	9
1	1	COM_MODE_ARM_CHK	0	6
#
# Batarya: 6S1P Molicel P50B (Li-ion). Eşikler config/mission/safety.yaml ile aynı (test edilir).
# Kritikte RTL, acil durumda iniş. Li-ion için boş hücre gerilimi 3.2 V.
1	1	COM_LOW_BAT_ACT	3	6
1	1	BAT_LOW_THR	0.25	9
1	1	BAT_CRIT_THR	0.15	9
1	1	BAT_EMERGEN_THR	0.08	9
1	1	BAT_AVRG_CURRENT	17.0	9
1	1	BAT1_N_CELLS	6	6
1	1	BAT1_V_EMPTY	3.2	9
1	1	BAT1_V_CHARGED	4.15	9
1	1	BAT1_CAPACITY	5000.0	9
#
# Geofence: 300 m yatay / 120 m dikey, ihlalde RTL (safety.yaml ile aynı).
# SHT-İHA Md. 23(2): kayıt doğrulanana kadar 10 m / 20 m zarf → companion "kayıtsız" profili uygular.
1	1	GF_ACTION	3	6
1	1	GF_MAX_HOR_DIST	300.0	9
1	1	GF_MAX_VER_DIST	120.0	9
#
# RTL: en yakın güvenli noktaya (home veya rally point) doğrudan. SHT-İHA Md. 18(1) "kurtarma alanı"
# için meskûn mahal dışına rally point tanımlayın.
1	1	RTL_TYPE	0	6
1	1	RTL_RETURN_ALT	30.0	9
1	1	RTL_DESCEND_ALT	10.0	9
1	1	RTL_LAND_DELAY	0.0	9
#
# Disarm: inişten 0.5 s sonra (avuca inişte companion'ın zorlamalı disarm'ına YEDEK).
1	1	COM_DISARM_LAND	0.5	9
1	1	COM_DISARM_PRFLT	10.0	9
#
# Remote ID (SHT-İHA, docs/08): Ar-Ge aşamasında 1 = modül yoksa yalnızca uyarı; operasyonda 2 = modülsüz kalkış yok.
# Modül seri porttan (MAVLink, TELEM2 DDS için kullanıldığından başka port) veya DroneCAN ile bağlanır (config/sensors/catalog.yaml).
1	1	COM_ARM_ODID	1	6
