ahmet6141/Drone-controller/ucav250/design/hardware.py

"""Producer (runs LAST): turns every :class:`Fastener` record already in the registry into a hardware part with real
geometry — head, shank, washers and nut, or a nutplate / potted insert / quarter-turn receptacle on the far side.

Geometry contract (see ARCHITECTURE.md): the producer that created a Fastener must have cut a clearance hole
(``fastener_catalog.clearance``) through every joined part along the fastener axis, and must give ``grip`` (clamped
stack thickness) so the nut/nutplate lands on the far face. Heads and nuts then only TOUCH the outer faces; the shank
passes through the holes; nothing overlaps.

Each fastener becomes one Part ``YK250-HW-<fastener id>`` in group "hardware" (material ``fastener_steel`` /
``fastener_stainless`` / ``fastener_ti`` when spec.materials defines them, else the spec material of the same alloy
family so that the mass has a density: ``steel_4130_n``, ``ss_304_annealed``, ``ti_6al_4v_annealed_sheet``), parented
to the first joined part, at the fastener's assembly step.

Mass/CG closure round (hardware study HW-00): a fastener is made of two alloys. The screw (head, shank, head washer)
is of the designation's grade (``Part.material``); the far side (nut + nut washer, nutplate, potted insert) is of its
own alloy: the grade token of the nut designation if it has one, else a nutplate / potted insert / anchor is A-286
class stainless (materials.yaml: fasteners in CFRP are titanium, A286 or passivated stainless) and a nut is of the
screw's alloy family, except under a titanium screw, where it is an A-286 class stainless nut (no titanium nuts are
assumed); a quarter-turn receptacle is of the stud's alloy. ``Part.mass_fn`` = (screw envelope volume - thread-groove
volume at the pitch diameter, HW-07) x screw density + far-side volume x far-side density (geometry, no factor); the
part's notes name the far-side alloy.
"""
from __future__ import annotations

import math
import re

import numpy as np

from ..core.geom import Mesh, box, cylinder, difference, merge, revolve, union, unit
from ..core.parts import Fastener, Part, Registry
from . import fastener_catalog as C


def _base_dir(f: Fastener, a: np.ndarray) -> np.ndarray:
    """Long-axis direction of a nutplate / receptacle base: the producer's ``Fastener.orient`` projected into the plane
    normal to the axis, else the default (horizontal for a steep axis, along y for a near-vertical one)."""
    if f.orient is not None:
        o = np.asarray(f.orient, float)
        o = o - np.dot(o, a) * a
        if np.linalg.norm(o) > 1e-6:
            return unit(o)
    ref = np.array([0, 0, 1.0]) if abs(a[2]) < 0.9 else np.array([1.0, 0, 0])
    return unit(np.cross(a, ref))


def _prism_n(radius: float, p0, p1, n: int) -> Mesh:
    """n-sided prism (hex head/nut) between p0 and p1, circumradius ``radius``."""
    return cylinder(radius, p0, p1, n=n)


_PITCH = {2.5: 0.00045, 3: 0.0005, 4: 0.0007, 5: 0.0008, 6: 0.001, 8: 0.00125, 10: 0.0015, 12: 0.00175}  # ISO 261 coarse


def _thread_pitch(f: Fastener, size: int) -> float:
    return _PITCH.get(size, 0.15 * f.d)


def _thread_length(f: Fastener, size: int) -> float:
    """Threaded length of the shank (m): fully threaded button / hex screws, else the ISO 4762 / 4014 reference b."""
    u = f.spec.upper()
    if "7380" in u or "4017" in u:
        return f.length
    extra = 0.006 if "4014" in u else 0.012
    return min(f.length, 2.0 * f.d + extra)


def _bolt_elements(f: Fastener) -> tuple[Mesh, Mesh | None, float]:
    a = unit(f.axis)
    p = np.asarray(f.position, float)
    size = C.size_from_spec(f.spec) or max(3, int(round(f.d * 1000)))
    parts = []
    head_off = 0.0
    OV = 5e-5                                           # overlaps so unions fuse (touching solids stay separate)
    if f.washer_head and size in C.ISO7089:
        d1, d2, h = C.ISO7089[size]
        parts.append(revolve([(d1 / 2, 0), (d2 / 2, 0), (d2 / 2, h), (d1 / 2, h)], n=32, axis_origin=p - h * a,
                             axis=a))
        head_off = h - OV
    spec_u = f.spec.upper()
    if "7380" in spec_u and size in C.ISO7380:
        dk, k = C.ISO7380[size]
        prof = [(0.0, 0.0), (dk / 2, 0.0), (dk / 2 * 0.95, k * 0.35), (dk / 4, k), (0.0, k)]
        parts.append(revolve(prof, n=32, axis_origin=p - head_off * a, axis=-a))
    elif ("4017" in spec_u or "4014" in spec_u) and size in C.ISO4017:
        s, k = C.ISO4017[size]
        parts.append(_prism_n(s / math.sqrt(3), p - (head_off + k) * a, p - head_off * a, 6))
    else:                                               # ISO 4762 socket head (default)
        dk, k = C.ISO4762.get(size, (1.7 * f.d, f.d))
        parts.append(cylinder(dk / 2, p - (head_off + k) * a, p - head_off * a, n=32))
    # shank slightly undersized (0.98 d) so it never touches the clearance-hole wall numerically: the mesh is the thread's
    # envelope (crests at d, as the hole and contact checks see it). Mass/CG closure round (hardware study HW-07, geometry
    # fidelity, no factor): the screw's MASS takes the threaded length at the pitch diameter d2 = d - 0.6495 P (the
    # volume-equivalent section of an ISO metric thread) over the threaded length b (full length for ISO 7380 / ISO 4017,
    # fully threaded; else ISO 4762 / 4014 b = 2 d + 12 mm (2 d + 6 mm for ISO 4014), at most the shank length): the
    # thread-groove volume between the envelope and the d2 cylinder (same 20-gon section as the mesh) is returned as the
    # element's volume deduction
    parts.append(cylinder(0.49 * f.d, p - head_off * a - 1e-4 * a, p + f.length * a, n=20))
    b_thr = min(_thread_length(f, size), f.length)
    d2 = f.d - 0.6495 * _thread_pitch(f, size)
    ngon = 0.5 * 20 * math.sin(2.0 * math.pi / 20)          # area of a regular 20-gon / r^2
    groove = max(ngon * ((0.49 * f.d) ** 2 - (0.5 * d2) ** 2), 0.0) * b_thr
    head_group = union(parts)
    parts = []
    nut = f.nut.lower()
    if f.grip is not None and nut and not any(k in nut for k in ("nutplate", "insert", "anchor", "receptacle",
                                                                     "tapped")):
        q = p + f.grip * a
        if f.washer_nut and size in C.ISO7089:
            d1, d2, h = C.ISO7089[size]
            parts.append(revolve([(d1 / 2, 0), (d2 / 2, 0), (d2 / 2, h), (d1 / 2, h)], n=32, axis_origin=q, axis=a))
            q = q + (h - OV) * a
        s, m = C.ISO7040.get(size, (1.7 * f.d, f.d))
        hexp = cylinder(s / math.sqrt(3), q, q + m * a, n=6)
        parts.append(difference(hexp, [cylinder(0.5 * f.d, q - 1e-3 * a, q + (m + 1e-3) * a, n=24)]))
    elif f.grip is not None and "nutplate" in nut and size in C.NUTPLATE:
        L, W, H, _pitch = C.NUTPLATE[size]
        q = p + f.grip * a
        e1 = _base_dir(f, a)
        e2 = np.cross(a, e1)
        R = np.column_stack([e1, e2, a])
        base = box((L, W, 0.0008), center=q + 0.0004 * a, R=R)
        barrel = cylinder(W * 0.42, q + (0.0008 - 1e-4) * a, q + H * a, n=24)
        bore = cylinder(0.5 * f.d, q - 1e-3 * a, q + (H + 1e-3) * a, n=24)
        parts.append(difference(union([base, barrel]), [bore]))
    elif f.grip is not None and "insert" in nut and size in C.INSERT:
        fl, body, ln = C.INSERT[size]
        import re
        m_ln = re.search(r"L (\d+(?:\.\d+)?) mm", f.nut)      # shortened through-thickness insert (joints.bolt)
        if m_ln:
            ln = min(ln, float(m_ln.group(1)) * 1e-3)
        q = p + f.grip * a                              # panel face: flange flush there, body goes deeper (+axis)
        ins = union([cylinder(fl / 2, q, q + 0.001 * a, n=24), cylinder(body / 2, q + 0.0009 * a, q + ln * a, n=24)])
        parts.append(difference(ins, [cylinder(0.5 * f.d, q - 1e-3 * a, q + (ln + 1e-3) * a, n=24)]))
    if not parts:
        return head_group, None, groove
    return head_group, union(parts), groove


def _quarter_turn_elements(f: Fastener) -> tuple[Mesh, Mesh | None, float]:
    a = unit(f.axis)
    p = np.asarray(f.position, float)
    Q = C.QUARTER_TURN
    head = union([cylinder(Q["stud_head_d"] / 2, p - Q["stud_head_h"] * a, p, n=32),
                  cylinder(Q["stud_d"] / 2 * 0.98, p - 1e-4 * a, p + f.length * a, n=16)])
    parts = []
    if f.grip is not None:
        q = p + f.grip * a
        L, W, t = Q["rec_plate"]
        e1 = _base_dir(f, a)
        R = np.column_stack([e1, np.cross(a, e1), a])
        bd, bh = Q["rec_barrel"]
        rec = union([box((L, W, t), center=q + 0.5 * t * a, R=R), cylinder(bd / 2, q + (t - 1e-4) * a, q + bh * a, n=24)])
        parts.append(difference(rec, [cylinder(Q["stud_d"] / 2 + 2e-4, q - 1e-3 * a, q + (bh + 1e-3) * a, n=24)]))
    return head, (union(parts) if parts else None), 0.0


def fastener_elements(f: Fastener) -> tuple[Mesh, Mesh | None, float]:
    """(screw / stud / pin element, far-side element or None, thread-groove volume of the screw element in m^3: the
    screw's mass volume is its envelope mesh volume minus this) of a fastener."""
    if f.kind in ("camloc", "quarter_turn"):
        return _quarter_turn_elements(f)
    if f.kind in ("pin", "clevis_pin", "rivet"):
        a = unit(f.axis)
        p = np.asarray(f.position, float)
        return cylinder(0.49 * f.d, p - 1e-4 * a, p + f.length * a, n=20), None, 0.0
    return _bolt_elements(f)


def fastener_mesh(f: Fastener) -> Mesh:
    s, far, _ = fastener_elements(f)
    return s if far is None else merge([s, far])


class _FastenerGeom:
    """Lazy geometry of one hardware part: the merged mesh (Part.mesh_fn) and the two-alloy mass (Part.mass_fn) from
    the same element meshes (built once; only their volumes are kept after the mesh is handed over)."""

    def __init__(self, f: Fastener, mats: dict, mat_screw: str, mat_far: str):
        self.f, self.mats, self.keys = f, mats, (mat_screw, mat_far)
        self._el = None
        self._vol = None

    def _elements(self):
        if self._el is None:
            s, far, groove = fastener_elements(self.f)
            self._el = (s, far)
            self._vol = (s.volume() - groove, far.volume() if far is not None else 0.0)
        return self._el

    def mesh(self) -> Mesh:
        s, far = self._elements()
        self._el = None
        return s if far is None else merge([s, far])

    def mass(self) -> float:
        if self._vol is None:
            self._elements()
        rho = [float(self.mats[k]["density"]) for k in self.keys]     # looked up when the mass is asked for
        return self._vol[0] * rho[0] + self._vol[1] * rho[1]


# fastener material -> spec.materials key with a density (first present): dedicated fastener entries if the spec has
# them, else the spec material of the same alloy family (12.9 alloy steel ~ 4130 N density, A2/A4 ~ 304, Ti-6Al-4V)
_MAT_CANDIDATES = {"ti": ("fastener_ti", "ti_6al_4v_annealed_sheet"),
                   "stainless": ("fastener_stainless", "ss_304_annealed"),
                   "steel": ("fastener_steel", "steel_4130_n")}


_TI_RE = re.compile(r"(^|[-\s/(])Ti(-6Al-4V|-?6-4|\b)")          # titanium grade token (case-sensitive "Ti")
_SS_RE = re.compile(r"(^|[-\s/(])(A[24]-\d|A-?286\b)", re.IGNORECASE)  # stainless / A-286 superalloy


def fastener_material(designation: str, mats: dict) -> str:
    """spec.materials key for a fastener designation: the alloy is read from its grade token only ("Ti-6Al-4V",
    "A2-70" / "A4-80" / "A286"); any other text (e.g. "estimate", "captive") does not select a family."""
    if _TI_RE.search(designation):
        fam = "ti"
    elif _SS_RE.search(designation):
        fam = "stainless"
    else:
        fam = "steel"
    cands = _MAT_CANDIDATES[fam]
    return next((m for m in cands if m in mats), cands[0])


def _family(designation: str) -> str | None:
    if _TI_RE.search(designation):
        return "ti"
    if _SS_RE.search(designation):
        return "stainless"
    return None


def far_side_material(f: Fastener, mats: dict) -> str:
    """spec.materials key of the far-side element (module docstring)."""
    screw = _family(f.spec) or "steel"
    fam = _family(f.nut or "")
    if fam is None:
        nut = (f.nut or "").lower()
        if f.kind in ("camloc", "quarter_turn"):
            fam = screw
        elif any(k in nut for k in ("nutplate", "insert", "anchor")):
            fam = "stainless"
        else:
            fam = "steel" if screw == "steel" else "stainless"
    cands = _MAT_CANDIDATES[fam]
    return next((m for m in cands if m in mats), cands[0])


def register(reg: Registry, spec: dict) -> None:
    mats = spec.get("materials", {}) or {}
    for f in list(reg.fasteners()):
        pid = f"YK250-HW-{f.id}"
        if pid in reg.parts:
            raise ValueError(f"duplicate fastener id {f.id}")
        owner = reg.parts[f.joins[0]] if f.joins and f.joins[0] in reg.parts else None
        m_s, m_f = fastener_material(f.spec, mats), far_side_material(f, mats)
        geo = _FastenerGeom(f, mats, m_s, m_f)
        far_note = f"far side ({f.nut}): {m_f}" if f.nut and f.kind not in ("pin", "clevis_pin", "rivet") else ""
        reg.add(Part(id=pid, name=f.spec, name_tr=f.spec, group="hardware",
                     material=m_s, process="purchased", mesh_fn=geo.mesh, mass_fn=geo.mass, thickness=None,
                     purchased=True, vendor=f.spec + (f" + {f.nut}" if f.nut else ""),
                     side=owner.side if owner else "C",
                     joint=owner.joint if owner else None, parent=f.joins[0] if f.joins else None, step=f.step,
                     explode=tuple(np.asarray(owner.explode) if owner else (0.0, 0.0, 0.0)),
                     contacts=tuple(f.joins), notes="; ".join(x for x in (f.notes, far_note) if x)))
