ahmet6141/Drone-controller/ucav250/data/research/aero.yaml

# =====================================================================================================
# YK-250 (ucav250) - RESEARCH PHASE - AIRFOILS AND PROPELLER
# Civil surveillance / research UAV with a UCAV/MALE look, ~250 cc piston engine (Limbach L 275 EF class,
# 18-20 kW). Payload: EO/IR sensors and mission equipment only.
#
# Conventions
#   - SI units, explicit in key names (m, m2, kg, s, N, W, Pa, m/s, rpm, deg). Non-dimensional aerodynamic
#     coefficients (cl, cd, cm) are section values; cm is about the quarter chord, nose-up positive.
#   - Every number carries "source" (URL, via YAML alias to the sources list) and "tag":
#       manufacturer | datasheet | standard | paper | vendor | estimate
#     "paper" = technical report or journal paper (NASA/NACA reports, arXiv). "estimate" values carry a "basis".
#   - Everything between the "BEGIN/END GENERATED" markers at the end of this file is produced by
#     ucav250/data/research/aero_polars.py (NeuralFoil polars, section geometry, Mejzlik-table propeller
#     operating points). Re-run it with:  python3 ucav250/data/research/aero_polars.py --update-yaml
#     The hand-written sections quote numbers from that block; re-check them if the block is regenerated
#     with different settings.
#   - Reynolds keys: Re_0.8e6 = chord Reynolds number 0.8 x 10^6. "n9" = n_crit 9 (clean), "n5" = n_crit 5
#     (task-defined rough case), "trip" = transition fixed at 0.075c on both surfaces (insects/rain/erosion).
#   - Air properties: ISA (ISO 2533); dynamic viscosity from Sutherland's law (1.458e-6, 110.4 K).
# Accessed: 2026-10-05
# =====================================================================================================

meta:
  project: YK-250 (ucav250)
  topic: airfoils and propeller
  phase: research
  date: "2026-10-05"
  scope: >-
    Wing and tail airfoil selection for a MALE-style UAV wing at chord Reynolds numbers of about 0.5-2.5e6
    (chord 0.3-0.67 m, 25-45 m/s, sea level to 4500 m), and fixed-pitch propellers (26-34 in, 2 or 3 blades,
    pusher or tractor) for an 18-20 kW two-stroke at 4000-7500 rpm.
  related_files:
    - ucav250/data/research/engine.yaml        # L 275 EF WOT curve, propeller interface, earlier prop estimate
    - ucav250/data/research/comparables.yaml   # MTOW, wing area, span, AR, cruise speed nominals
    - ucav250/data/research/aero_polars.py     # script that produced the generated block
    - ucav250/data/airfoils/*.dat              # UIUC coordinates in Selig format
  files_written:
    dat_files: [naca4415.dat, n63415.dat, naca23015.dat, nlf416.dat, fx63137.dat, e1210.dat, sd7062.dat, ls417.dat,
                naca642415.dat, nlf0115.dat, nlf1015.dat, n0009sm.dat, naca0010.dat, n0012.dat, n63012a.dat]
    dat_format: >-
      Selig order (TE -> upper surface -> LE -> lower surface -> TE), first line = original UIUC title. Ordinates
      are the UIUC values unchanged; Lednicer files (nlf416, ls417, fx63137, e1210, n0012, n63415, n63012a) were
      re-ordered, and naca23015.dat was cleaned ("......" placeholders and the trailing "100.00 0.0000" line
      removed, bracketed TE ordinates "(0.0016)" kept as numbers).
    not_written: >-
      naca4412.dat and naca4418.dat (added candidates) were deliberately not written: the UIUC copies have only
      17 points per side, and any file named naca44xx.dat bypasses the exact analytic NACA generator in
      ucav250/design/oml.py (airfoil_coords uses the built-in generator only when no .dat file exists). They
      are analysed from analytic ordinates (aerosandbox).

# -----------------------------------------------------------------------------------------------------
# SOURCES (anchors u_<id> are reused as per-item "source" URLs below)
# -----------------------------------------------------------------------------------------------------
sources:
  - id: uiuc_db
    url: &u_uiuc_db "https://m-selig.ae.illinois.edu/ads/coord_database.html"
    title: UIUC Airfoil Coordinates Database (M. Selig) - index with file names and airfoil titles
    tag: paper
  - id: uiuc_coord
    url: &u_uiuc_coord "https://m-selig.ae.illinois.edu/ads/coord/"
    title: UIUC coordinate files (per-file URLs in airfoil_candidates[].uiuc_url)
    tag: paper
  - id: neuralfoil_code
    url: &u_nf_code "https://github.com/peterdsharpe/NeuralFoil"
    title: NeuralFoil 0.3.3 (MIT) - neural surrogate of XFoil-type viscous analysis; used with model_size 'large'
    tag: paper
  - id: neuralfoil_paper
    url: &u_nf_paper "https://arxiv.org/abs/2503.16323"
    title: Sharpe & Hansman (2025) NeuralFoil - an airfoil aerodynamics analysis tool using physics-informed machine learning, arXiv 2503.16323
    tag: paper
    notes: Trained on XFoil data; reproduces XFoil (mean relative drag error 0.37 % on simple cases), so it inherits XFoil's cl_max over-prediction.
  - id: tp1861
    url: &u_tp1861 "https://ntrs.nasa.gov/api/citations/19810015487/downloads/19810015487.pdf"
    title: Somers, D. M. (1981) Design and experimental results for a natural-laminar-flow airfoil for general aviation applications, NASA TP-1861 (NLF(1)-0416)
    tag: paper
  - id: r824
    url: &u_r824 "https://ntrs.nasa.gov/api/citations/19930090976/downloads/19930090976.pdf"
    title: Abbott, von Doenhoff & Stivers (1945) Summary of airfoil data, NACA Report 824
    tag: paper
  - id: tn3963
    url: &u_tn3963 "https://ntrs.nasa.gov/api/citations/19930084707/downloads/19930084707.pdf"
    title: Gault, D. E. (1957) A correlation of low-speed airfoil-section stalling characteristics with Reynolds number and airfoil geometry, NACA TN 3963
    tag: paper
  - id: tnd7428
    url: &u_tnd7428 "https://ntrs.nasa.gov/citations/19740003708"
    title: McGhee & Beasley (1973) Low-speed aerodynamic characteristics of a 17-percent-thick airfoil section designed for general aviation applications, NASA TN D-7428 (LS(1)-0417 / GA(W)-1)
    tag: paper
  - id: hale1015
    url: &u_hale1015 "https://ntrs.nasa.gov/citations/19890040369"
    title: Maughmer & Somers (1989) Design and experimental results for a high-altitude, long-endurance airfoil, J. Aircraft 26(2) (NLF(1)-1015)
    tag: paper
  - id: tp2256
    url: &u_tp2256 "https://ntrs.nasa.gov/citations/19840018592"
    title: Holmes, Obara & Yip (1984) Natural laminar flow experiments on modern airplane surfaces, NASA TP-2256
    tag: paper
  - id: iso2533
    url: &u_iso2533 "https://www.iso.org/standard/7472.html"
    title: ISO 2533:1975 Standard Atmosphere
    tag: standard
  - id: lim_ds_275ef
    url: &u_lim_ds_275ef "https://limflug.de/downloads/datasheets/L275-EF-datasheet-en.pdf"
    title: LIMBACH L275EF technical specification incl. WOT power/torque curve (values as read in engine.yaml)
    tag: datasheet
  - id: ust018_p66
    url: &u_ust018_p66 "https://www.ust-media.com/ust-magazine/UST018/66/"
    title: UST 018 Limbach L 275 EF dossier (regular flight 4000-6000 rpm; take-off just below 7000 rpm) - via engine.yaml
    tag: paper
  - id: engine_yaml
    url: &u_engine_yaml "ucav250/data/research/engine.yaml"
    title: YK-250 engine study - L 275 EF data, propeller interface, earlier propeller estimate and pusher notes
    tag: estimate
  - id: comparables
    url: &u_comparables "ucav250/data/research/comparables.yaml"
    title: YK-250 comparables study - recommended_ranges (MTOW 150 kg, S 3.0 m2, b 6.0 m, AR 12, W/S 50 kg/m2, cruise 30 m/s)
    tag: estimate
  - id: mz_pps
    url: &u_mz_pps "https://www.mejzlik.eu/propulsion-system-data"
    title: Mejzlik Propellers - Propulsion system data (engine + propeller sheets incl. Hirth 4103/4201/4202HF and Zanzottera 101HS/305HS gas engines)
    tag: manufacturer
    notes: >-
      Each sheet: prop name, diameter, pitch, mass, and thrust/torque/power versus rpm at 0-50 m/s. Sheet note:
      "combination of measurements of engine performance (RPM, torque), complemented with propeller data,
      simulated in Mejzlik's proprietary simulation software ... valid for 0 m ISA ... accuracy can diverge at
      tip speeds above Mach 0.7 ... structurally safe below Mach 1 tip speed."
  - id: mz_0161
    url: &u_mz_0161 "https://www.mejzlik.eu/files/0161-zanzottera-motor-305hs-mejzlik-32x18-2b.pdf"
    title: Mejzlik sheet 0161 - Zanzottera 305 HS (312 cc, 29.7 HP at 7000 rpm) + Mejzlik 32x18 2B (334 g, CW and CCW)
    tag: manufacturer
  - id: mz_0164
    url: &u_mz_0164 "https://www.mejzlik.eu/files/0164-zanzottera-motor-305hs-mejzlik-31x12-3b.pdf"
    title: Mejzlik sheet 0164 - Zanzottera 305 HS + Mejzlik 31x12 3B (412 g, CW and CCW)
    tag: manufacturer
  - id: mz_0117
    url: &u_mz_0117 "https://www.mejzlik.eu/files/0117-hirth-motor-4201-mejzlik-32x12-2b-evo-rev01.pdf"
    title: Mejzlik sheet 0117 - Hirth 4201 (183 cc, 11 kW at 6500 rpm) + Mejzlik 32x12 2B EVO (316 g)
    tag: manufacturer
  - id: mz_0159
    url: &u_mz_0159 "https://www.mejzlik.eu/files/0159-zanzottera-motor-305hs-mejzlik-34x12-2b.pdf"
    title: Mejzlik sheet 0159 - Zanzottera 305 HS + Mejzlik 34x12 2B (382 g)
    tag: manufacturer
  - id: mz_0096
    url: &u_mz_0096 "https://www.mejzlik.eu/files/0096-hirth-motor-4202f-mejzlik-32x12-rev01.pdf"
    title: Mejzlik sheet 0096 - Hirth 4202HF + 32x12 2B (excluded - see propellers.data_quality)
    tag: manufacturer
  - id: mz_0099
    url: &u_mz_0099 "https://www.mejzlik.eu/files/0099-hirth-motor-4202f-mejzlik-31x12-evo-lf-rev01.pdf"
    title: Mejzlik sheet 0099 - Hirth 4202HF + 31x12 EVO LF 2B (excluded - see propellers.data_quality)
    tag: manufacturer
  - id: mz_cwccw
    url: &u_mz_cwccw "https://www.mejzlik.eu/files/cw-ccwmanual.pdf"
    title: Mejzlik CW-CCW manual (rotation definition and engine/propeller pairing for puller and pusher)
    tag: manufacturer
  - id: da_mejzlik
    url: &u_da_mejzlik "https://www.desertaircraft.com/products/mejzlik-2-blade"
    title: Desert Aircraft - Mejzlik 2-blade carbon props (size list 15.5-34 in, label suffixes, US$ prices)
    tag: vendor
  - id: da200
    url: &u_da200 "https://www.desertaircraft.com/products/da-200"
    title: Desert Aircraft DA-200 (200 cc, 19 hp, 900-6700 rpm, bolt circle 34 mm, 6 x M5x55 prop bolts, recommended props)
    tag: manufacturer
  - id: falcon_chart
    url: &u_falcon_chart "https://www.falconpropellers.com/wp-content/uploads/2020/04/Falcon-Propeller-Test-Chart.pdf"
    title: Falcon Carbon Fiber Gas Propeller Test Chart (2-blade) - measured static rpm and thrust (kgf) on DA/DLE engines
    tag: manufacturer
  - id: falcon_bore
    url: &u_falcon_bore "https://www.falconpropellers.com/prop-chart/"
    title: Falcon prop chart page - bored centre-hole diameters (gas carbon 19-33 in - 10 mm)
    tag: manufacturer
  - id: menz_macgregor
    url: &u_menz "https://macgregor.co.uk/menz/men30012.htm"
    title: MacGregor (UK distributor) - Menz 'S' 30x12 beech-wood propeller (sizes up to 32 in; 10 mm hub above 20 in)
    tag: vendor
  - id: biela_lindinger
    url: &u_biela "https://lindinger.at/en/AIRPLANES/GAS-GLOW-POWERPLANTS/Propellers/BIELA-CARBON-PROPELLER-2-BLATT-32x18-Semi-Scale-Moki-215ccm/9784996"
    title: Lindinger - Biela carbon 2-blade 32x18 (approx. 475 g, 10 mm bore, 38.6 mm hub thickness, 8000 rpm limit)
    tag: vendor
  - id: helix
    url: &u_helix "https://helix-propeller.de/en/support"
    title: Helix-Propeller (Germany) - CFRP propellers for aircraft, gyrocopters, paramotors and eVTOL/multicopter; UAV props custom-made
    tag: manufacturer
  - id: skypower_mejzlik
    url: &u_sp_mz "https://insideunmannedsystems.com/sky-power-intensifies-uas-cooperation-with-mejzlik-propeller/"
    title: Sky Power intensifies UAS cooperation with Mejzlik Propeller (engine-matched UAS propellers; size, pitch, blades, mass, surface adapted)
    tag: paper

# -----------------------------------------------------------------------------------------------------
# DESIGN POINT (what the polars were evaluated for)
# -----------------------------------------------------------------------------------------------------
design_point:
  aircraft_nominals:
    mtow_kg: {value: 150.0, source: *u_comparables, tag: estimate, basis: comparables.yaml recommended_ranges.mtow_kg.nominal}
    wing_area_m2: {value: 3.0, source: *u_comparables, tag: estimate, basis: comparables.yaml recommended_ranges.wing_area_m2.nominal}
    span_m: {value: 6.0, source: *u_comparables, tag: estimate, basis: comparables.yaml recommended_ranges.span_m.nominal}
    taper_ratio_assumed: {value: 0.5, tag: estimate, source: *u_comparables, basis: "assumed for this study; gives root chord 0.667 m, tip chord 0.333 m, MAC ~0.52 m"}
  air_properties_ISA:
    source: *u_iso2533
    tag: standard
    sea_level: {density_kg_m3: 1.225, dynamic_viscosity_Pa_s: 1.789e-5, kinematic_viscosity_m2_s: 1.461e-5}
    altitude_3000_m: {density_kg_m3: 0.9091, dynamic_viscosity_Pa_s: 1.694e-5, kinematic_viscosity_m2_s: 1.863e-5}
    altitude_4500_m: {density_kg_m3: 0.7768, dynamic_viscosity_Pa_s: 1.645e-5, kinematic_viscosity_m2_s: 2.117e-5}
  chord_reynolds_number:
    tag: estimate
    source: *u_iso2533
    basis: Re = V c / nu with the ISA viscosities above
    sea_level:     {c0p30_V25: 0.51e6, c0p30_V36: 0.74e6, c0p30_V45: 0.92e6, c0p45_V30: 0.92e6, c0p45_V36: 1.11e6, c0p60_V30: 1.23e6, c0p60_V36: 1.48e6, c0p60_V45: 1.85e6}
    altitude_3000_m: {c0p30_V25: 0.40e6, c0p30_V36: 0.58e6, c0p45_V30: 0.72e6, c0p45_V36: 0.87e6, c0p60_V30: 0.97e6, c0p60_V45: 1.45e6}
    altitude_4500_m: {c0p30_V30: 0.43e6, c0p45_V36: 0.77e6, c0p60_V36: 1.02e6, c0p60_V45: 1.28e6}
    note: >-
      The task grid (Re 0.8, 1.5, 2.5e6) brackets the wing: root chords at fast cruise reach ~2e6, the mean chord
      sits at ~0.9-1.2e6 at sea level and 0.7-0.9e6 at 3000 m, and the tip falls to ~0.4-0.6e6 at altitude. Tails
      (chord ~0.25-0.35 m) run at 0.4-0.9e6, so Re 0.5e6 was added for the tail sections.
  aircraft_lift_coefficient:
    tag: estimate
    source: *u_comparables
    basis: CL = m g / (0.5 rho V^2 S), m = 150 kg, S = 3.0 m2
    sea_level: {V25: 1.28, V30: 0.89, V35: 0.65, V40: 0.50, V45: 0.40}
    altitude_3000_m: {V25: 1.73, V30: 1.20, V35: 0.88, V40: 0.67, V45: 0.53}
    altitude_4500_m: {V30: 1.40, V35: 1.03, V40: 0.79, V45: 0.62}
  section_cl_used_in_polars:
    cl_cruise: {value: 0.6, tag: estimate, source: *u_comparables, basis: "~36 m/s at sea level, or ~40 m/s at 3000 m"}
    cl_loiter: {value: 0.9, tag: estimate, source: *u_comparables, basis: "best-endurance ~30 m/s at sea level; at 3000-4500 m loiter cl is 1.1-1.4, so cd at cl 1.1 and 1.3 is also tabulated"}

# -----------------------------------------------------------------------------------------------------
# METHOD, VALIDATION AND CORRECTIONS
# -----------------------------------------------------------------------------------------------------
method:
  polars:
    tool: NeuralFoil 0.3.3, model_size large (xlarge spot-checked at Re 1.5e6), aerosandbox 4.2.8 Kulfan fit of the coordinates
    source: *u_nf_code
    tag: estimate
    sweep: "alpha -4..16 deg in 0.25 deg steps as tasked; extended to 22 deg only to locate cl_max (several sections stall above 16 deg)"
    cases:
      ncrit9: clean surface, low-turbulence air (free transition, e^N n_crit 9)
      ncrit5: task-defined rough/contaminated case (free transition, n_crit 5). Physically this models higher free-stream turbulence; it moves transition forward but does not trip the boundary layer
      tripped: transition fixed at x/c 0.075 on both surfaces - the trip station of NASA TP-1861 and close to NACA 'standard roughness' (0.08c, NACA Rep. 824). Used as the insect/rain/erosion case
    metrics_definitions:
      cl_max: peak cl in -4..22 deg (cl_max_within_alpha_m4_16deg also given)
      drag_bucket_cl_range: contiguous cl range around cd_min with cd <= 1.10 cd_min
      cm_c4_at_cl_cruise: cm about c/4 at cl 0.6 (pre-stall branch)
      endurance_cl15_over_cd_max: max of cl^1.5/cd (section endurance figure)
      post_stall_cl_ratio_at_alpha_clmax_plus3deg: cl(alpha_clmax + 3 deg) / cl_max (1 = flat top, < 0.85 = sharp drop)
      stall_type_gault: Gault (1957) correlation with the upper ordinate at x/c 0.0125 (>= 2.2 % c trailing-edge stall; 1.75-2.2 combined; 1.2-1.75 leading-edge; < 1.2 thin-airfoil), boundaries read from TN 3963 Fig. 1 for Re 1-3e6 (+/- 0.2 % c)
  validation_against_wind_tunnel:
    nlf416_cl_max_Re_3e6:
      experiment: {value: 1.69, source: *u_tp1861, tag: paper, note: "transition free and fixed (0.075c) gave no significant difference"}
      neuralfoil: {value: 1.80, tripped: 1.79, source: *u_nf_code, tag: estimate, basis: generated block validation_vs_wind_tunnel}
      ratio_experiment_over_neuralfoil: {value: 0.94, tag: estimate, source: *u_tp1861, basis: 1.69 / 1.80}
    nlf416_cm_c4_at_cl_0:
      experiment: {value: -0.09, source: *u_tp1861, tag: paper}
      neuralfoil: {value: -0.0995, tripped: -0.0945, source: *u_nf_code, tag: estimate}
    nlf416_alpha_zero_lift_deg:
      experiment: {value: -3.8, source: *u_tp1861, tag: paper}
      neuralfoil: {value: -4.04, tripped: -3.82, source: *u_nf_code, tag: estimate}
    ls417_l_over_d_at_cl_1p0_transition_fixed:
      experiment: {value: [65, 85], re_range: [2.0e6, 6.0e6], source: *u_tnd7428, tag: paper}
      neuralfoil_tripped: {value: [76.1, 94.2], re: [2.0e6, 6.0e6], source: *u_nf_code, tag: estimate}
      implied_cd_factor: {value: [1.17, 1.11], tag: estimate, source: *u_tnd7428, basis: NeuralFoil L/D divided by experimental L/D}
    ls417_cl_max:
      experiment: {value: "> 2.0", source: *u_tnd7428, tag: paper}
      neuralfoil_tripped: {value: [1.93, 2.14], re: [2.0e6, 6.0e6], source: *u_nf_code, tag: estimate}
  recommended_corrections_for_sizing:
    cl_max_factor: {value: 0.94, tag: estimate, source: *u_tp1861, basis: NLF(1)-0416 experiment / NeuralFoil at Re 3e6; apply to every NeuralFoil section cl_max before 3-D corrections}
    cd_factor_tripped: {value: 1.15, tag: estimate, source: *u_tnd7428, basis: LS(1)-0417 fixed-transition L/D at cl 1.0 is 11-17 % below NeuralFoil}
    cd_factor_clean: {value: 1.05, tag: estimate, source: *u_nf_paper, basis: "XFoil-type free-transition drag is usually a few percent low at these Re; no in-range experiment checked here"}
    design_rule: >-
      Size endurance and climb on the 'tripped' polars x 1.15 (a production composite wing will not keep a
      reliable laminar run after insect strikes, rain and LE erosion; NASA TP-2256 also reports rain-induced
      trim changes on NLF airplanes and recommends fixed-transition testing as standard). Treat the clean (n9)
      polars as upside only.
    source: *u_tp2256
    tag: estimate
  model_and_coordinate_checks:
    model_size_sensitivity:
      value: "xlarge vs large at Re 1.5e6 / n9, all 17 sections: cl_max within 0.015, cd_min within 1.6 %, cm within 0.003, (L/D)max within 3.2 %"
      source: *u_nf_code
      tag: estimate
    uiuc_naca4415_file_deviation:
      value: >-
        The UIUC naca4415.dat is NOT the exact NACA 4415: its upper surface lies 2.5e-3 c (x/c 0.0125) to
        4.2e-3 c (x/c 0.0025) below the NACA equations and its LE point is at y = 0.00075. NeuralFoil at Re 1.5e6
        (n9): UIUC file cl_max 1.656, cm(cl 0.6) -0.082; analytic NACA 4415 cl_max 1.714, cm -0.101. Use the
        analytic NACA 4415 for design (see generated coordinate_source_check).
      source: *u_uiuc_coord
      tag: estimate
    uiuc_naca0010_file:
      value: "17 points per side; NeuralFoil results identical to the analytic NACA 0010 (cl_max 1.428 vs 1.429), but the LE between x/c 0 and 0.0125 is unresolved for lofting"
      source: *u_uiuc_coord
      tag: estimate
    uiuc_n0012_file: {value: "matches the analytic NACA 0012 to < 1e-5 c", source: *u_uiuc_coord, tag: estimate}
    side_effect_on_existing_code:
      value: >-
        ucav250/design/oml.py airfoil_coords('naca4415') and ('naca0010') now read the UIUC .dat files written
        here instead of the built-in NACA generator (its fallback runs only when no file exists). The cached
        polars ucav250/data/polars/naca4415_*.json were computed from the analytic shape. If NACA 4415 or 0010
        stay in the design, either load them under an analytic name or delete/rename the two .dat files.
      source: *u_uiuc_coord
      tag: estimate

# -----------------------------------------------------------------------------------------------------
# CANDIDATES (geometry and polars are in the generated block; literature facts here)
# -----------------------------------------------------------------------------------------------------
airfoil_candidates:
  wing:
    - id: naca4415
      name: NACA 4415
      file: ucav250/data/airfoils/naca4415.dat
      uiuc_url: "https://m-selig.ae.illinois.edu/ads/coord/naca4415.dat"
      t_over_c: {value: 0.150, x_over_c: 0.30, source: *u_uiuc_coord, tag: paper}
      notes:
        - {text: "Classic 4-digit section with documented clean and standard-roughness data", source: *u_r824, tag: paper}
        - {text: "NACA 44-series of 12-15 % thickness keep comparatively good cl_max with standard roughness (Report 824: rough 64-series cl_max exceeds rough 24-, 44- and 230-series 'except for the NACA 44-series airfoils of 12 to 15 percent thickness')", source: *u_r824, tag: paper}
        - {text: "cl_max substantially lower than LS(1)-0417 and NLF(1)-0416 (TP-1861 Fig. 36 comparison)", source: *u_tp1861, tag: paper}
        - {text: "Wing section of the RQ-2 Pioneer (comparables.yaml)", source: *u_comparables, tag: paper}
        - {text: "UIUC file deviates from the NACA equations near the LE - use analytic ordinates", source: *u_uiuc_coord, tag: estimate}
    - id: n63415
      name: NACA 63(2)-415
      file: ucav250/data/airfoils/n63415.dat
      uiuc_url: "https://m-selig.ae.illinois.edu/ads/coord/n63415.dat"
      t_over_c: {value: 0.150, x_over_c: 0.35, source: *u_uiuc_coord, tag: paper}
      notes:
        - {text: "6-series laminar section; low-drag range depends on laminar flow; NeuralFoil bucket at Re 1.5e6 n9 is cl -0.06..0.71 and cd at cl 1.1 jumps to 0.0119 (bucket edge)", source: *u_nf_code, tag: estimate}
        - {text: "Report 824: smooth and rough cl_max are essentially equal only for the 6 %-thick 6-series sections - thicker ones lose cl_max with standard roughness; roughness strips more than 0.20c from the LE have little effect", source: *u_r824, tag: paper}
    - id: naca23015
      name: NACA 23015
      file: ucav250/data/airfoils/naca23015.dat
      uiuc_url: "https://m-selig.ae.illinois.edu/ads/coord/naca23015.dat"
      t_over_c: {value: 0.150, x_over_c: 0.30, source: *u_uiuc_coord, tag: paper}
      notes:
        - {text: "Near-zero cm (NeuralFoil -0.003 at cl 0.6) - lowest trim drag of the cambered set", source: *u_nf_code, tag: estimate}
        - {text: "Stall: Report 824 Table II - wing with NACA 23015.6 root / 23009 tip: 'Very abrupt stall, left wing stalling very rapidly, for all conditions'", source: *u_r824, tag: paper}
        - {text: "Gault: 230-series stalls are 'definitely inconsistent' with the ordinate correlation (leading-edge/combined stall despite a large LE ordinate)", source: *u_tn3963, tag: paper}
    - id: nlf416
      name: NASA NLF(1)-0416
      file: ucav250/data/airfoils/nlf416.dat
      uiuc_url: "https://m-selig.ae.illinois.edu/ads/coord/nlf416.dat"
      t_over_c: {value: 0.16, x_over_c: 0.32, source: *u_uiuc_coord, tag: paper}
      notes:
        - {text: "Designed for a light single-engine GA airplane: low drag at cl 0.4 (Re 4e6) and at climb cl 0.5-1.0; cl_max must not depend on laminar flow ('if the leading edge of the wing is contaminated by insect remains ... the cl_max should not decrease')", source: *u_tp1861, tag: paper}
        - {text: "Measured cl_max ~1.69 at Re 3e6; roughness at 0.075c had no significant effect on cl_max at any Re (1-9e6)", source: *u_tp1861, tag: paper}
        - {text: "cm(cl 0) ~ -0.09, alpha_L0 ~ -3.8 deg, both nearly independent of Re", source: *u_tp1861, tag: paper}
        - {text: "Stall: turbulent trailing-edge separation; LE peak does not collapse up to the maximum angle tested (gentle stall)", source: *u_tp1861, tag: paper}
        - {text: "With transition fixed, no higher cruise drag and lower climb drag than comparable turbulent airfoils: 'if laminar flow is not achieved, nothing is lost relative to the NASA low-speed airfoils'", source: *u_tp1861, tag: paper}
    - id: fx63137
      name: Wortmann FX 63-137
      file: ucav250/data/airfoils/fx63137.dat
      uiuc_url: "https://m-selig.ae.illinois.edu/ads/coord/fx63137.dat"
      t_over_c: {value: 0.137, x_over_c: 0.31, source: *u_uiuc_coord, tag: paper}
      notes:
        - {text: "High-lift low-Re section (human-powered aircraft Puffin II / Liverpuffin per UIUC title); cm about -0.21 (NeuralFoil)", source: *u_uiuc_db, tag: paper}
        - {text: "Thin cusped aft section (t/c 1.2 % at x/c 0.9) - poor hinge/flap depth and fragile TE in production composite", source: *u_uiuc_coord, tag: estimate}
    - id: e1210
      name: Eppler E1210
      file: ucav250/data/airfoils/e1210.dat
      uiuc_url: "https://m-selig.ae.illinois.edu/ads/coord/e1210.dat"
      t_over_c: {value: 0.159, x_over_c: 0.22, source: *u_uiuc_coord, tag: paper}
      notes:
        - {text: "Eppler general-aviation section (UIUC title); 5.2 % camber with forward maximum thickness; highest NeuralFoil cl_max of the set (~2.0 at Re 1.5e6) but cd_min ~0.008", source: *u_nf_code, tag: estimate}
        - {text: "No wind-tunnel data located for Re 0.5-3e6; tripped cl_max drops 0.23 at Re 1.5e6 - the largest roughness loss in the set", source: *u_nf_code, tag: estimate}
    - id: sd7062
      name: Selig/Donovan SD7062 (reference)
      file: ucav250/data/airfoils/sd7062.dat
      uiuc_url: "https://m-selig.ae.illinois.edu/ads/coord/sd7062.dat"
      t_over_c: {value: 0.14, x_over_c: 0.27, source: *u_uiuc_coord, tag: paper}
      notes:
        - {text: "Low-Reynolds-number model section (YK-38 wing); NeuralFoil shows good performance at Re 0.8-2.5e6 but no wind-tunnel data above model Re were located", source: *u_uiuc_db, tag: paper}
    - id: naca4412
      name: NACA 4412 (analytic ordinates)
      file: null
      uiuc_url: "https://m-selig.ae.illinois.edu/ads/coord/naca4412.dat"
      t_over_c: {value: 0.12, x_over_c: 0.30, source: *u_r824, tag: paper}
      notes: [{text: "Added as tip partner of NACA 4415; alpha_L0 -4.2 deg and cm -0.10 match NLF(1)-0416 closely (NeuralFoil)", source: *u_nf_code, tag: estimate}]
    - id: naca4418
      name: NACA 4418 (analytic ordinates)
      file: null
      uiuc_url: "https://m-selig.ae.illinois.edu/ads/coord/naca4418.dat"
      t_over_c: {value: 0.18, x_over_c: 0.30, source: *u_r824, tag: paper}
      notes: [{text: "Added as deep-root option; worst tripped drag of the 4-digit set (cd 0.0141 at cl 0.9, Re 1.5e6)", source: *u_nf_code, tag: estimate}]
    - id: ls417
      name: NASA LS(1)-0417 (GA(W)-1)
      file: ucav250/data/airfoils/ls417.dat
      uiuc_url: "https://m-selig.ae.illinois.edu/ads/coord/ls417.dat"
      t_over_c: {value: 0.17, x_over_c: 0.39, source: *u_uiuc_coord, tag: paper}
      notes:
        - {text: "cl_max > 2.0 and L/D at cl 1.0 of 65-85 for Re 2-6e6 (transition fixed)", source: *u_tnd7428, tag: paper}
        - {text: "cm about -0.12 (NeuralFoil); highest box area after NACA 4418", source: *u_nf_code, tag: estimate}
    - id: naca642415
      name: NACA 64(2)-415
      file: ucav250/data/airfoils/naca642415.dat
      uiuc_url: "https://m-selig.ae.illinois.edu/ads/coord/naca642415.dat"
      t_over_c: {value: 0.15, x_over_c: 0.37, source: *u_uiuc_coord, tag: paper}
      notes: [{text: "6-series; Report 824: rough 64-series cl_d 0.4 sections keep higher cl_max than rough 24/230-series (but not than 44-series 12-15 %)", source: *u_r824, tag: paper}]
    - id: nlf0115
      name: NASA NLF(1)-0115
      file: ucav250/data/airfoils/nlf0115.dat
      uiuc_url: "https://m-selig.ae.illinois.edu/ads/coord/nlf0115.dat"
      t_over_c: {value: 0.15, x_over_c: 0.43, source: *u_uiuc_coord, tag: paper}
      notes: [{text: "Low cm (-0.05) NLF section; NeuralFoil drag rises sharply above cl 0.6 (cd 0.0121 at cl 0.9, Re 0.8e6) - unsuited to MALE loiter cl", source: *u_nf_code, tag: estimate}]
    - id: nlf1015
      name: NASA NLF(1)-1015
      file: ucav250/data/airfoils/nlf1015.dat
      uiuc_url: "https://m-selig.ae.illinois.edu/ads/coord/nlf1015.dat"
      t_over_c: {value: 0.15, x_over_c: 0.41, source: *u_uiuc_coord, tag: paper}
      notes:
        - {text: "Designed for a high-altitude long-endurance UAV: 15 %, Re 0.7-2e6, low drag cl 0.4 (dash) to 1.5 (max endurance); LTPT results confirm design except cl_max", source: *u_hale1015, tag: paper}
        - {text: "Best clean endurance figure of the set (NeuralFoil 209 at Re 1.5e6) but worst when tripped (81) and cm -0.19", source: *u_nf_code, tag: estimate}
  tail:
    - id: n0009sm
      name: NACA 0009 (smoothed UIUC ordinates)
      file: ucav250/data/airfoils/n0009sm.dat
      uiuc_url: "https://m-selig.ae.illinois.edu/ads/coord/n0009sm.dat"
      t_over_c: {value: 0.09, x_over_c: 0.31, source: *u_uiuc_coord, tag: paper}
      notes: [{text: "UIUC has no unsmoothed NACA 0009; the smoothed file differs from the equations by < 8e-4 c", source: *u_uiuc_db, tag: paper}]
    - id: naca0010
      name: NACA 0010
      file: ucav250/data/airfoils/naca0010.dat
      uiuc_url: "https://m-selig.ae.illinois.edu/ads/coord/naca0010.dat"
      t_over_c: {value: 0.10, x_over_c: 0.30, source: *u_uiuc_coord, tag: paper}
    - id: n0012
      name: NACA 0012
      file: ucav250/data/airfoils/n0012.dat
      uiuc_url: "https://m-selig.ae.illinois.edu/ads/coord/n0012.dat"
      t_over_c: {value: 0.12, x_over_c: 0.30, source: *u_uiuc_coord, tag: paper}
      notes: [{text: "Report 824 Fig. 33 shows NACA 0012 wind-tunnel and flight drag agreeing within experimental error", source: *u_r824, tag: paper}]
    - id: n63012a
      name: NACA 63-012A (UIUC has no plain 63-012)
      file: ucav250/data/airfoils/n63012a.dat
      uiuc_url: "https://m-selig.ae.illinois.edu/ads/coord/n63012a.dat"
      t_over_c: {value: 0.12, x_over_c: 0.35, source: *u_uiuc_coord, tag: paper}
      notes: [{text: "'A' modification = straight aft surfaces (easy to build) but leading-edge stall type at the tail Re", source: *u_tn3963, tag: paper}]

# -----------------------------------------------------------------------------------------------------
# RECOMMENDATION
# -----------------------------------------------------------------------------------------------------
recommendation:
  wing:
    root:
      airfoil: NASA NLF(1)-0416
      file: ucav250/data/airfoils/nlf416.dat
      t_over_c: {value: 0.16, source: *u_tp1861, tag: paper}
    tip:
      airfoil: NLF(1)-0416 thickness-scaled to 13 % (camber line unchanged, thickness x 0.8125)
      file: ucav250/data/airfoils/nlf416.dat
      how_to_build: "ucav250/design/oml.py resampled('nlf416', thickness_scale=0.8125)"
      t_over_c: {value: 0.13, tag: estimate, source: *u_tp1861, basis: derived section; only the 16 % parent was tunnel-tested}
      fallback: constant NLF(1)-0416 (16 %) root to tip - fully covered by TP-1861 data; costs ~1-2 % wing profile drag (tip region only)
    spanwise_loft: linear in t/c from root to tip; same mean line keeps alpha_L0 and cm constant along the span
    washout_deg: {value: [2.0, 3.0], tag: estimate, source: *u_nf_code, basis: "tip cl_max at Re 0.6-0.8e6 (1.56-1.61, x 0.94 -> 1.47-1.51) is ~0.15 below root cl_max at Re 1.5-2.5e6; geometric washout restores root-first stall with taper 0.5. Confirm with the lifting-line in sizing."}
    reasons:
      spar_depth_and_fuel:
        root_spar_depth_at_x0p30_m: {value: 0.106, tag: estimate, source: *u_comparables, basis: "t/c 0.159 at x/c 0.30 x root chord 0.667 m (S 3.0 m2, b 6.0 m, taper 0.5)"}
        tip_spar_depth_at_x0p30_m: {value: 0.043, tag: estimate, source: *u_comparables, basis: "13 % section x tip chord 0.333 m"}
        box_area_x0p20_x0p65_over_c2: {root: 0.0639, tip: 0.0519, tag: estimate, source: *u_nf_code, basis: generated geometry (PCHIP integration of the outer mould line)}
        oml_box_volume_both_wings_m3: {value: 0.092, inboard_70pct_span: 0.077, tag: estimate, source: *u_comparables, basis: "integral of box area x c^2 over the trapezoidal planform; outer mould line, before skin/spar/rib deductions"}
        comparison: {naca4415_4412_pair_m3: 0.088, naca4418_4412_pair_m3: 0.099, ls417_constant_m3: 0.112, tag: estimate, source: *u_comparables}
        fuel_check: {required_fuel_volume_m3: 0.0446, tag: estimate, source: *u_comparables, basis: "33 kg (comparables fuel fraction 0.22 x 150 kg) / 740 kg/m3 (engine.yaml); needs ~58 % of the inboard-70 % OML box volume as an integral tank, or a fuselage tank"}
      trim_drag:
        cm_c4_at_cl_0p6: {value: -0.104, tripped: -0.096, source: *u_nf_code, tag: estimate}
        comparison: "-0.08..-0.10 for NACA 4415/4412, 63-415, SD7062, E1210; -0.12 LS(1)-0417; -0.19 NLF(1)-1015; -0.21 FX 63-137; ~0 NACA 23015"
        tail_download_difference_vs_fx63137_N: {value: 45, tag: estimate, source: *u_comparables, basis: "delta cm 0.11 x q 551 Pa (30 m/s SL) x S 3.0 m2 x MAC 0.5 m / tail arm 2.0 m (assumed)"}
      stall_behaviour:
        - {text: "Trailing-edge stall with a non-collapsing LE peak (oil-flow and pressure data)", source: *u_tp1861, tag: paper}
        - {text: "Gault ordinate 2.42 % c -> trailing-edge region at Re 1-3e6", source: *u_tn3963, tag: paper}
        - {text: "NeuralFoil post-stall ratio 0.96 (cl 3 deg past cl_max), vs 0.89 for NACA 23015", source: *u_nf_code, tag: estimate}
      roughness_robustness:
        - {text: "cl_max unaffected by roughness at 0.075c (Re 1-9e6) - the stall speed does not depend on a clean LE", source: *u_tp1861, tag: paper}
        - {text: "Tripped endurance figure cl^1.5/cd at Re 1.5e6: NLF(1)-0416 117.6 (best of the set) vs NACA 4415 85.9, 63(2)-415 89.2, LS(1)-0417 86.9, FX 63-137 124.8 (but cm -0.21), NLF(1)-1015 80.6", source: *u_nf_code, tag: estimate}
        - {text: "Tripped cd at cl 1.1, Re 0.8e6 (altitude loiter): NLF(1)-0416 0.0150, NACA 4415 0.0173, NACA 4412 0.0146, 63(2)-415 0.0151, E1210 0.0159", source: *u_nf_code, tag: estimate}
        - {text: "Clean-to-tripped cd ratio at cl 0.6, Re 1.5e6: 1.67 (NACA 4415 1.83, 63(2)-415 1.88, LS(1)-0417 2.09, NLF(1)-1015 2.11)", source: *u_nf_code, tag: estimate}
      key_section_data_Re_1p5e6:
        source: *u_nf_code
        tag: estimate
        clean_n9: {cl_max: 1.714, alpha_cl_max_deg: 15.0, cd_min: 0.0060, cl_at_cd_min: 0.20, drag_bucket_cl: [0.08, 0.49], cd_cl0p6: 0.00683, cd_cl0p9: 0.00755, cd_cl1p1: 0.00839, l_over_d_max: 131.7, endurance_max: 144.5}
        tripped: {cl_max: 1.709, cd_min: 0.0108, cd_cl0p6: 0.01144, cd_cl0p9: 0.01228, cd_cl1p1: 0.01302, l_over_d_max: 95.7, endurance_max: 117.6}
        design_values_after_corrections: {cl_max: 1.61, cd_cl0p9_tripped: 0.0141, tag: estimate, basis: "cl_max x 0.94; tripped cd x 1.15"}
    alternatives:
      documented_turbulent_pair:
        root: NACA 4415 (analytic ordinates)
        tip: NACA 4412 (analytic ordinates)
        why: >-
          Best-documented, simplest to loft; cm and alpha_L0 similar to NLF(1)-0416. NeuralFoil tripped endurance is
          lower (85.9 vs 117.6 at Re 1.5e6) and the box volume ~5 % smaller.
        source: *u_r824
        tag: paper
      laminar_upside_if_surface_can_be_kept_clean:
        airfoil: NLF(1)-1015
        why: designed for exactly this Re and endurance cl, but the largest roughness penalty and cm -0.19
        source: *u_hale1015
        tag: paper
    rejected:
      - {airfoil: NACA 23015, reason: "very abrupt stall (Report 824) despite near-zero cm", source: *u_r824, tag: paper}
      - {airfoil: Wortmann FX 63-137, reason: "cm -0.21 (trim drag, wing torsion) and thin cusped TE unsuited to production composite control surfaces", source: *u_nf_code, tag: estimate}
      - {airfoil: Eppler E1210, reason: "cd_min ~0.008, no validation data, largest roughness cl_max loss", source: *u_nf_code, tag: estimate}
      - {airfoil: "NACA 63(2)-415 / 64(2)-415", reason: "bucket ends near cl 0.7 - drag rises at loiter cl 1.1-1.3; laminar-dependent", source: *u_nf_code, tag: estimate}
      - {airfoil: NLF(1)-0115, reason: "drag rises above cl 0.6 (loiter penalty)", source: *u_nf_code, tag: estimate}
      - {airfoil: LS(1)-0417, reason: "thickest but cm -0.12 and cd rise above cl 0.9 clean; keep as backup if a deeper spar is needed", source: *u_tnd7428, tag: paper}
  tail:
    airfoil: NACA 0012
    file: ucav250/data/airfoils/n0012.dat
    applies_to: horizontal and vertical tail, or V-tail panels
    reasons:
      - {text: "Highest cl_max of the symmetric candidates at tail Re: 1.26 (Re 0.5e6) and 1.34 (Re 0.8e6) vs 1.02-1.27 for 0009/0010/63-012A; clean and tripped values equal", source: *u_nf_code, tag: estimate}
      - {text: "Gentlest stall of the set: post-stall ratio 0.91 at Re 0.5-0.8e6 (0010: 0.68-0.78, 0009: 0.65-0.70, 63-012A: 0.66-0.84); Gault ordinate 1.89 % c = combined/trailing-edge stall at Re ~1e6, the others leading-edge", source: *u_tn3963, tag: paper}
      - {text: "12 % depth gives room for a spar, hinge line and servo in a 0.25-0.35 m chord and better torsional stiffness for flutter margin", source: *u_uiuc_coord, tag: estimate}
      - {text: "Drag cost is small: cd_min 0.0056 vs 0.0050 (0010) at Re 0.8e6; tripped/clean cd_min ratio 1.9-2.3 for all four (0012: 2.0)", source: *u_nf_code, tag: estimate}
      - {text: "UIUC n0012.dat equals the NACA equations; wind-tunnel and flight drag agree (Report 824 Fig. 33)", source: *u_r824, tag: paper}
    alternative: {airfoil: NACA 0010, reason: "~10 % lower cd_min and lighter; accept leading-edge stall type and 5-7 % lower cl_max at Re 0.5-0.8e6", source: *u_nf_code, tag: estimate}
  production_notes:
    - {text: "Specify LE erosion tape/paint on the first 8-10 % chord and design performance on the tripped polars; NLF(1)-0416 loses no cl_max when contaminated", source: *u_tp1861, tag: paper}
    - {text: "Standard roughness (0.011 in grains over 0.08c) is 'considerably more severe than ... usual manufacturing irregularities' but 'considerably less severe than ... ice or mud' - treat it as the bad-day service case", source: *u_r824, tag: paper}
    - {text: "Keep a blunt or finite TE (~0.4 % c) for manufacturing; TP-1861 found a blunt-TE wedge did not change cl_max and only slightly raised cd_min", source: *u_tp1861, tag: paper}
    - {text: "Rain caused stick-fixed nose-down trim changes on NLF airplanes - keep elevator trim authority for a cm shift of ~+0.01 (NeuralFoil clean -0.104 -> tripped -0.096)", source: *u_tp2256, tag: paper}

# -----------------------------------------------------------------------------------------------------
# PROPELLERS
# -----------------------------------------------------------------------------------------------------
propellers:
  engine_reference:
    engine: Limbach L 275 EF (see engine.yaml)
    wot_torque_Nm_vs_rpm:
      rpm: [4000, 4500, 5000, 5500, 6000, 6500, 7000, 7500]
      torque_Nm: [25.3, 25.4, 25.9, 25.6, 25.7, 24.7, 24.0, 23.7]
      source: *u_lim_ds_275ef
      tag: datasheet
      note: read from the datasheet WOT chart (engine.yaml, +/- 0.3 N m)
    regular_flight_rpm: {value: [4000, 6000], source: *u_ust018_p66, tag: paper}
    takeoff_rpm: {value: 6950, source: *u_ust018_p66, tag: paper, note: "take-off 'just below 7000 rpm' for ~17 kW"}
    max_power_W: {value: 18870, rpm: 7500, source: *u_lim_ds_275ef, tag: datasheet}
    propeller_interface:
      value: "prop hub on a brass spool, press fit with keyway, retained by a crank-nose bolt; flange OD, bolt circle and bolt size not legible in public drawings"
      source: *u_ust018_p66
      tag: paper
      action: request the Limbach hub drawing (STEP/DXF) before ordering drilled propellers
  requirement:
    thrust_required_N:
      value: {V25: 106.8, V30: 104.2, V35: 112.8, V40: 128.9, V45: 150.8}
      band_CD0_0p030_0p040: {V30: [95.9, 112.4], V35: [101.5, 124.0], V40: [114.2, 143.6]}
      tag: estimate
      source: *u_comparables
      basis: "D = q S CD0 + W^2/(q S pi e AR), MTOW 150 kg, S 3.0 m2, AR 12, CD0 0.035, e 0.75, ISA sea level"
    tip_speed_guidance: {value: "static helical tip Mach <= ~0.75 (about 255 m/s)", tag: estimate, source: *u_mz_pps, basis: "Mejzlik: simulation accuracy diverges above Mach 0.7; engine.yaml noise guidance ~250 m/s (recommended.propeller.basis)"}
  manufacturers:
    mejzlik:
      company: Mejzlik Propellers s.r.o. (Czech Republic) - carbon props for UAV OEMs and large models; engine-matched UAS props with Sky Power
      source: *u_mz_pps
      tag: manufacturer
      sizes_2_blade_in: {value: "26x8 ... 34x12 incl. 26x12, 26x14 TH, 28x10, 28x12, 29x12 S, 30x10, 30x12, 30x13 EVO, 31x12 EVO, 32x10, 32x12, 32x12 EVO, 32x18, 33x10, 34x12", source: *u_da_mejzlik, tag: vendor}
      label_suffixes: {value: "3B three-blade; N narrow; W wide; S scimitar; TH thin profile; EVO new profile; L/LF lightweight torsion-box", source: *u_da_mejzlik, tag: vendor}
      rotation: {value: "CW and CCW available per size (sheet lists 'CW and CCW' or one hand); CW/CCW defined looking in the flight direction", source: *u_mz_cwccw, tag: manufacturer}
      pusher_rule: {value: "engine CW (facing output shaft) + pusher -> CCW propeller; engine CCW + pusher -> CW propeller; puller uses the same hand as the engine", source: *u_mz_cwccw, tag: manufacturer}
      structural_limit: {value: "safe below tip Mach 1", source: *u_mz_pps, tag: manufacturer}
      price_USD: {value: {"26x12": 198, "28x12": 200, "30x12": 203, "32x12": 223, "32x18": 223, "34x12": 219}, source: *u_da_mejzlik, tag: vendor}
      hub_interface: {value: "drilled to the engine pattern by the supplier or user; centre bore and hub thickness not stated on the sheets", source: *u_mz_pps, tag: manufacturer}
      performance_data: see generated propeller_tables_mejzlik (17 props, 0-50 m/s) and propeller_operating_points
    falcon:
      company: Falcon Propellers (USA) - carbon and beech-wood gas props, 2-, 3- and 5-blade
      source: *u_falcon_chart
      tag: manufacturer
      centre_bore_m: {value: 0.010, applies_to: "gas carbon 2-blade 19-33 in", source: *u_falcon_bore, tag: manufacturer}
      measured_static:
        source: *u_falcon_chart
        tag: manufacturer
        note: static rpm and thrust measured on the named engine; conversion 1 kgf = 9.80665 N
        rows:
          - {prop: "32x12", engine: DA-200, rpm: 5670, thrust_N: 398}
          - {prop: "32x12", engine: DLE-222, rpm: 5820, thrust_N: 417}
          - {prop: "32x10", engine: DA-200, rpm: 6150, thrust_N: 401}
          - {prop: "31x12", engine: DA-200, rpm: 6170, thrust_N: 392}
          - {prop: "30x13", engine: DA-200, rpm: 6250, thrust_N: 410}
          - {prop: "34x12", engine: DLE-222, rpm: 5530, thrust_N: 451}
          - {prop: "30x12", engine: DLE-170, rpm: 6100, thrust_N: 365}
      cross_check: "Falcon measured / Mejzlik-table static thrust at equal size and rpm: mean 0.975, range 0.90-1.11 (generated cross_check_falcon_measured_static)"
    menz:
      company: MENZ (Germany) - 'S' series beech-wood props, distributed by MacGregor (UK)
      source: *u_menz
      tag: vendor
      sizes: {value: "up to 32 in (e.g. 30x12, 32x14, 32x20)", source: *u_menz, tag: vendor}
      centre_bore_m: {value: 0.010, applies_to: "diameter > 20 in", source: *u_menz, tag: vendor}
      mass_kg: {value: null, source: *u_menz, tag: vendor, note: "not published by the distributor; manufacturer site not reachable from this environment"}
      performance_data: none published
    biela:
      company: Biela (Czech Republic) - hand-made carbon/glass props
      source: *u_biela
      tag: vendor
      example_32x18_carbon: {mass_kg: 0.475, centre_bore_m: 0.010, hub_thickness_m: 0.0386, max_rpm: 8000, note: "'approx. 475 g'; hardwood insert at the hub; up to 6000 rpm from 36 in", source: *u_biela, tag: vendor}
      performance_data: none published
    helix:
      company: Helix-Propeller (Germany) - CFRP props for light aircraft, gyrocopters, paramotors and eVTOL/multicopter; UAV props custom
      source: *u_helix
      tag: manufacturer
      note: no catalogue data for 26-34 in direct-drive props at 5000-7500 rpm; the standard range targets geared engines at lower rpm. Request a custom quote if a certified-grade supplier is needed.
  data_quality:
    - {text: "Mejzlik sheets 0096 (32x12 2B) and 0099 (31x12 EVO LF) are excluded: their static and 40 m/s tables are identical to each other (copy error) and 0096 shows physically implausible 30 m/s thrust", source: *u_mz_0096, tag: manufacturer}
    - {text: "Mejzlik flight-speed data are simulated (engine torque measured); accuracy degrades above tip Mach 0.7", source: *u_mz_pps, tag: manufacturer}
    - {text: "Static operating points for the L 275 EF lie above the tabulated rpm for most props (reference engines were 5-22 kW); they use a J-similarity (CT, CQ constant at J = 0) extrapolation of the upper rows and are flagged 'extrapolated_beyond_table'", source: *u_mz_pps, tag: estimate}
  recommendation:
    pusher_primary:
      propeller: Mejzlik 32x18 2B (carbon)
      diameter_m: {value: 0.8128, source: *u_mz_0161, tag: manufacturer}
      pitch_nominal_m: {value: 0.4572, source: *u_mz_0161, tag: manufacturer}
      mass_kg: {value: 0.334, source: *u_mz_0161, tag: manufacturer}
      rotation: {value: "CW and CCW available", source: *u_mz_0161, tag: manufacturer}
      static_thrust_N: {value: 500, rpm: 5790, shaft_power_W: 15560, tip_mach: 0.724, tag: estimate, source: *u_mz_0161, basis: "Mejzlik CT0/CQ0 at 5500 rpm (451 N, 23.15 N m, sheet 0161 re-read) scaled with n^2 to the L 275 EF WOT torque balance; Falcon cross-check suggests 0.90-1.11 x. Corrected from 512 N / 6000 rpm (C-AERO-01): the generated block's cubic CT(J)/CQ(J) fit gives a CQ0 7 % below the tabulated 5500 rpm row, so its static point is not the stated n^2 scaling."}
      static_thrust_N_for_sizing: {value: 460, tag: estimate, source: *u_falcon_chart, basis: "500 N x 0.92 (lower-half of the Falcon/Mejzlik ratio) x ~1.0 installation; use for take-off sizing (corrected from 470 N, C-AERO-01)"}
      wot_thrust_N: {V20: 385, V30: 326, V40: 289, rpm: {V20: 5574, V30: 5443, V40: 5731}, tag: estimate, source: *u_mz_0161, basis: "WOT torque balance; in-flight rpm stays below 5800 (quiet, inside the regular-flight band)"}
      cruise: {V30: {rpm: 3802, shaft_power_W: 3979, efficiency: 0.786}, V35: {rpm: 4174, shaft_power_W: 4853, efficiency: 0.813}, V40: {rpm: 4580, shaft_power_W: 6397, efficiency: 0.806}, tag: estimate, source: *u_mz_0161, basis: "rpm for thrust = estimated drag; isolated-propeller efficiency T V / P from the Mejzlik tables"}
      why: >-
        Highest partial-throttle efficiency of the 17 Mejzlik props (0.79-0.81 at 30-40 m/s, ~5 points above the
        31x12 3B and 32x12 EVO), lowest in-flight rpm and tip speed (Mach 0.48-0.59 in cruise), static WOT
        equilibrium at ~5800 rpm (near the L 275 EF continuous-power point), and the lightest 32 in option.
      caveats:
        - "Loiter at 30 m/s sea level needs ~3800 rpm, just below Limbach's 4000-6000 rpm regular-flight band; at 3000 m the same loiter needs higher rpm (lower density, higher TAS)."
        - "High pitch-to-diameter (0.56) gives the lowest static thrust per kW of the shortlist; take-off run must be checked with ~460 N."
    pusher_alternative:
      propeller: Mejzlik 31x12 3B (carbon)
      diameter_m: {value: 0.7874, source: *u_mz_0164, tag: manufacturer}
      pitch_nominal_m: {value: 0.3048, source: *u_mz_0164, tag: manufacturer}
      mass_kg: {value: 0.412, source: *u_mz_0164, tag: manufacturer}
      rotation: {value: "CW and CCW available", source: *u_mz_0164, tag: manufacturer}
      static_thrust_N: {value: 550, rpm: 5960, tip_mach: 0.722, tag: estimate, source: *u_mz_0164, basis: "WOT torque balance with the L 275 EF, CT0/CQ0 of the top tabulated static row scaled with n^2 (rpm corrected from 6104, thrust unchanged; C-AERO-01)"}
      wot_thrust_N: {V20: 411, V30: 362, V40: 317, rpm: {V20: 5970, V30: 6294, V40: 6774}, tag: estimate, source: *u_mz_0164}
      cruise: {V30: {rpm: 4453, shaft_power_W: 4188, efficiency: 0.746}, V35: {rpm: 4945, shaft_power_W: 5132, efficiency: 0.769}, V40: {rpm: 5477, shaft_power_W: 6848, efficiency: 0.753}, tag: estimate, source: *u_mz_0164}
      why: "+7 % static thrust, 25 mm smaller diameter (tail/ground clearance on rotation), cruise rpm inside the 4000-6000 band; costs ~5 points cruise efficiency and 78 g"
    tractor:
      recommendation: same propellers in the engine's hand (Mejzlik puller rule); with a tractor layout the 32x18 2B remains first choice
      source: *u_mz_cwccw
      tag: manufacturer
    not_recommended:
      - {props: "26-30 in 2-blade (26x12, 26x14 TH, 28x10, 28x12, 30x12, 30x13 EVO, 30.5x13.5 Q)", reason: "underload the L 275 EF: static equilibrium only at >= 7100-7500 rpm with tip Mach 0.76-0.88", source: *u_mz_pps, tag: estimate}
      - {props: "32x10, 33x10, 34x12, 32x12 EVO", reason: "static tip Mach 0.80-0.92 or cruise efficiency <= 0.75", source: *u_mz_pps, tag: estimate}
      - {props: "29x12 3B, 30x13 3B EVO", reason: "static equilibrium ~7100-7500 rpm, tip Mach >= 0.80; 29x12 3B cruise efficiency 0.67-0.69", source: *u_mz_pps, tag: estimate}
    installation_notes:
      - {text: "Isolated-prop efficiencies; for a pusher behind the fuselage apply an installation factor of 0.93-0.97 until measured (wake ingestion, blockage, cyclic blade loading)", tag: estimate, source: *u_mz_pps, basis: "engineering judgement; not from a cited test"}
      - {text: "Keep the prop plane >= 0.1-0.15 D behind the fuselage/cowl trailing edge (engine.yaml pusher note)", tag: estimate, source: *u_engine_yaml, basis: engine.yaml recommended.propeller.pusher.note}
      - {text: "Hobby gas props use a 10 mm centre bore and are drilled to the engine bolt pattern (e.g. DA-200: 6 x M5 on a 34 mm bolt circle); L 275 EF pattern still unknown", source: *u_da200, tag: manufacturer}
      - {text: "Ask Mejzlik for an engine-matched UAS design and a static test report on the L 275 EF (they test thrust, torque and rpm on in-house rigs; Sky Power uses this route)", source: *u_sp_mz, tag: paper}
  comparison_with_engine_yaml_estimate:
    value: "engine.yaml proposed 0.81 m x 0.46 m 2-blade with ~400-480 N static; the Mejzlik 32x18 2B (0.813 x 0.457 m) is that propeller and the tables give 500 N (460 N with the Falcon-based knock-down; corrected from 512/470 N, C-AERO-01)"
    source: *u_mz_0161
    tag: estimate

open_items:
  - Obtain the Limbach L 275 EF hub drawing (flange OD, bolt circle, bolt size, spigot) and crank rotation direction before ordering drilled props.
  - Request a Mejzlik static test report for 32x18 2B and 31x12 3B on the L 275 EF (or an equivalent 16-18 kW dyno), and their forward-flight data at 3000-4500 m.
  - Confirm the NLF(1)-0416 13 % tip derivative with a second method (XFoil or MSES) before the wing loft is frozen.
  - Decide whether NACA 4415/0010 stay as candidates; if not, delete or rename their .dat files so oml.py falls back to its analytic generator (see method.model_and_coordinate_checks.side_effect_on_existing_code).
  - Wind-tunnel or flight drag of the production wing with LE tape is the only way to retire the tripped/clean uncertainty (factor ~1.6-1.7 in section drag).

# -----------------------------------------------------------------------------------------------------
# CORRECTIONS (synthesis cross-check, 2026-10-05; see ucav250/data/research/baseline.yaml)
# Hand-written sections only. The generated block below is NOT edited; it still shows the old static
# points (static_wot_L275EF 512 N / 6001 rpm for '0161') until aero_polars.py is fixed and re-run.
# -----------------------------------------------------------------------------------------------------
corrections:
  - id: C-AERO-01
    date: "2026-10-05"
    location: propellers.recommendation.pusher_primary.static_thrust_N (+ static_thrust_N_for_sizing, caveats, why, comparison_with_engine_yaml_estimate, pusher_alternative.static_thrust_N rpm)
    issue: >-
      The stated method ("CT0/CQ0 at 5500 rpm scaled with n^2") and the number did not agree. Mejzlik sheet 0161
      (re-read): static 451 N and 23.15 N m at 5500 rpm, the top tabulated row. aero_polars.py extrapolates above
      the table with a cubic CT(J)/CQ(J) fit through all speeds, whose CQ(0) is 7 % below that row (CT(0) 5 %
      below), so perf() drops from 451 N to 430 N between 5500 and 5501 rpm and the WOT balance lands at
      6001 rpm / 512 N. Anchoring the n^2 scaling to the 5500 rpm row gives the L 275 EF torque balance at
      5790 rpm, 500 N, 15.56 kW, tip Mach 0.724. Same check for 31x12 3B (sheet 0164): 5960 rpm, 551 N
      (thrust unchanged, rpm was 6104).
    fix: >-
      Hand-written values corrected: 32x18 2B static 500 N at 5790 rpm (sizing value 460 N = 500 x 0.92);
      31x12 3B static rpm 5960. Cruise points (inside the tables) and WOT in-flight points are unchanged; the
      40 m/s and 20 m/s WOT points also use the fit above 5500 rpm and carry the same few-percent uncertainty.
    recommended_code_fix: >-
      In aero_polars.perf(), extrapolate each speed's rows from the nearest tabulated row with constant CT and CQ
      at that row's J (true J-similarity), or blend the fit to match the table at its last row; then re-run
      --update-yaml.
    source: "https://www.mejzlik.eu/files/0161-zanzottera-motor-305hs-mejzlik-32x18-2b.pdf"
    tag: estimate

# >>> BEGIN GENERATED BY aero_polars.py
generated:
  by: ucav250/data/research/aero_polars.py
  date: '2026-10-05'
  tag: estimate
  source: https://github.com/peterdsharpe/NeuralFoil
  method: NeuralFoil large on the aerosandbox Kulfan (CST) fit of the coordinates; alpha -4..16 deg step 0.25 (extended to 22 deg only to locate cl_max and the post-stall
    ratio); cases ['ncrit9', 'ncrit5', 'tripped']; cl_cruise 0.6, cl_loiter 0.9; drag bucket = contiguous cl range with cd <= 1.1 x cd_min; Re keys are chord Reynolds
    numbers; Mach 0.
  cases:
    ncrit9: {n_crit: 9.0, xtr_upper: 1.0, xtr_lower: 1.0}
    ncrit5: {n_crit: 5.0, xtr_upper: 1.0, xtr_lower: 1.0}
    tripped: {n_crit: 9.0, xtr_upper: 0.075, xtr_lower: 0.075}
summary_Re_1.5e6:
  tag: estimate
  source: https://github.com/peterdsharpe/NeuralFoil
  rows:
  - {airfoil: naca4415, group: wing, t_over_c: 0.15, x_t: 0.297, cl_max_n9: 1.656, alpha_clmax_n9: 17.75, cl_max_n5: 1.636, cl_max_trip: 1.562, cd_min_n9: 0.00635,
    cl_cdmin_n9: 0.648, bucket_n9: [0.457, 0.859], cm_cruise_n9: -0.0817, cd_cruise_n9: 0.00644, cd_cruise_n5: 0.00773, cd_cruise_trip: 0.01181, cd_ratio_trip_n9_cruise: 1.83,
    cd_1p1_n9: 0.00824, cd_1p1_trip: 0.01448, ld_max_n9: 133.6, ld_max_trip: 76.7, endurance_n9: 142.9, endurance_trip: 85.9, post_stall_ratio_n9: 0.97, stall_type_gault: trailing-edge}
  - {airfoil: n63415, group: wing, t_over_c: 0.15, x_t: 0.344, cl_max_n9: 1.656, alpha_clmax_n9: 18.0, cl_max_n5: 1.67, cl_max_trip: 1.645, cd_min_n9: 0.00566, cl_cdmin_n9: 0.093,
    bucket_n9: [-0.056, 0.714], cm_cruise_n9: -0.0839, cd_cruise_n9: 0.00593, cd_cruise_n5: 0.00631, cd_cruise_trip: 0.01112, cd_ratio_trip_n9_cruise: 1.88, cd_1p1_n9: 0.0119,
    cd_1p1_trip: 0.01335, ld_max_n9: 127.1, ld_max_trip: 82.7, endurance_n9: 119.8, endurance_trip: 89.2, post_stall_ratio_n9: 0.974, stall_type_gault: trailing-edge}
  - {airfoil: naca23015, group: wing, t_over_c: 0.1501, x_t: 0.296, cl_max_n9: 1.614, alpha_clmax_n9: 16.75, cl_max_n5: 1.541, cl_max_trip: 1.604, cd_min_n9: 0.00621,
    cl_cdmin_n9: 0.104, bucket_n9: [-0.141, 0.383], cm_cruise_n9: -0.0027, cd_cruise_n9: 0.00763, cd_cruise_n5: 0.00804, cd_cruise_trip: 0.01168, cd_ratio_trip_n9_cruise: 1.53,
    cd_1p1_n9: 0.01085, cd_1p1_trip: 0.01361, ld_max_n9: 101.7, ld_max_trip: 85.4, endurance_n9: 112.3, endurance_trip: 98.8, post_stall_ratio_n9: 0.888, stall_type_gault: trailing-edge}
  - {airfoil: nlf416, group: wing, t_over_c: 0.1595, x_t: 0.317, cl_max_n9: 1.714, alpha_clmax_n9: 15.0, cl_max_n5: 1.691, cl_max_trip: 1.709, cd_min_n9: 0.006, cl_cdmin_n9: 0.197,
    bucket_n9: [0.082, 0.492], cm_cruise_n9: -0.1043, cd_cruise_n9: 0.00683, cd_cruise_n5: 0.0069, cd_cruise_trip: 0.01144, cd_ratio_trip_n9_cruise: 1.67, cd_1p1_n9: 0.00839,
    cd_1p1_trip: 0.01302, ld_max_n9: 131.7, ld_max_trip: 95.7, endurance_n9: 144.5, endurance_trip: 117.6, post_stall_ratio_n9: 0.966, stall_type_gault: trailing-edge}
  - {airfoil: fx63137, group: wing, t_over_c: 0.1372, x_t: 0.299, cl_max_n9: 1.882, alpha_clmax_n9: 14.25, cl_max_n5: 1.881, cl_max_trip: 1.887, cd_min_n9: 0.00606,
    cl_cdmin_n9: 0.727, bucket_n9: [0.598, 1.015], cm_cruise_n9: -0.212, cd_cruise_n9: 0.00653, cd_cruise_n5: 0.00736, cd_cruise_trip: 0.01094, cd_ratio_trip_n9_cruise: 1.68,
    cd_1p1_n9: 0.0069, cd_1p1_trip: 0.01277, ld_max_n9: 167.8, ld_max_trip: 98.8, endurance_n9: 196.8, endurance_trip: 124.8, post_stall_ratio_n9: 0.984, stall_type_gault: trailing-edge}
  - {airfoil: e1210, group: wing, t_over_c: 0.1586, x_t: 0.224, cl_max_n9: 1.997, alpha_clmax_n9: 16.75, cl_max_n5: 1.956, cl_max_trip: 1.766, cd_min_n9: 0.00798,
    cl_cdmin_n9: 0.932, bucket_n9: [0.116, 1.162], cm_cruise_n9: -0.0923, cd_cruise_n9: 0.00861, cd_cruise_n5: 0.00891, cd_cruise_trip: 0.0115, cd_ratio_trip_n9_cruise: 1.34,
    cd_1p1_n9: 0.00844, cd_1p1_trip: 0.01369, ld_max_n9: 136.5, ld_max_trip: 87.6, endurance_n9: 169.2, endurance_trip: 106.0, post_stall_ratio_n9: 0.942, stall_type_gault: trailing-edge}
  - {airfoil: sd7062, group: wing, t_over_c: 0.14, x_t: 0.276, cl_max_n9: 1.728, alpha_clmax_n9: 14.5, cl_max_n5: 1.655, cl_max_trip: 1.717, cd_min_n9: 0.00641, cl_cdmin_n9: 0.459,
    bucket_n9: [0.287, 0.845], cm_cruise_n9: -0.0864, cd_cruise_n9: 0.00648, cd_cruise_n5: 0.00745, cd_cruise_trip: 0.01106, cd_ratio_trip_n9_cruise: 1.71, cd_1p1_n9: 0.0082,
    cd_1p1_trip: 0.01292, ld_max_n9: 135.0, ld_max_trip: 94.2, endurance_n9: 153.6, endurance_trip: 114.9, post_stall_ratio_n9: 0.95, stall_type_gault: trailing-edge}
  - {airfoil: naca4412, group: wing, t_over_c: 0.1201, x_t: 0.296, cl_max_n9: 1.713, alpha_clmax_n9: 16.75, cl_max_n5: 1.726, cl_max_trip: 1.703, cd_min_n9: 0.00567,
    cl_cdmin_n9: 0.654, bucket_n9: [0.55, 0.834], cm_cruise_n9: -0.1022, cd_cruise_n9: 0.00583, cd_cruise_n5: 0.00725, cd_cruise_trip: 0.01087, cd_ratio_trip_n9_cruise: 1.86,
    cd_1p1_n9: 0.00795, cd_1p1_trip: 0.01265, ld_max_n9: 141.7, ld_max_trip: 94.1, endurance_n9: 145.2, endurance_trip: 108.0, post_stall_ratio_n9: 0.963, stall_type_gault: trailing-edge}
  - {airfoil: naca4418, group: wing, t_over_c: 0.1801, x_t: 0.298, cl_max_n9: 1.679, alpha_clmax_n9: 17.5, cl_max_n5: 1.661, cl_max_trip: 1.651, cd_min_n9: 0.00739,
    cl_cdmin_n9: 0.767, bucket_n9: [-0.005, 0.978], cm_cruise_n9: -0.0979, cd_cruise_n9: 0.00751, cd_cruise_n5: 0.00829, cd_cruise_trip: 0.01269, cd_ratio_trip_n9_cruise: 1.69,
    cd_1p1_n9: 0.00875, cd_1p1_trip: 0.01569, ld_max_n9: 126.2, ld_max_trip: 70.9, endurance_n9: 138.8, endurance_trip: 79.2, post_stall_ratio_n9: 0.982, stall_type_gault: trailing-edge}
  - {airfoil: ls417, group: wing, t_over_c: 0.1699, x_t: 0.39, cl_max_n9: 1.867, alpha_clmax_n9: 19.5, cl_max_n5: 1.89, cl_max_trip: 1.864, cd_min_n9: 0.00577, cl_cdmin_n9: 0.262,
    bucket_n9: [0.134, 0.751], cm_cruise_n9: -0.1215, cd_cruise_n9: 0.00596, cd_cruise_n5: 0.00647, cd_cruise_trip: 0.01245, cd_ratio_trip_n9_cruise: 2.09, cd_1p1_n9: 0.01234,
    cd_1p1_trip: 0.01453, ld_max_n9: 118.7, ld_max_trip: 77.7, endurance_n9: 104.9, endurance_trip: 86.9, post_stall_ratio_n9: null, stall_type_gault: trailing-edge}
  - {airfoil: naca642415, group: wing, t_over_c: 0.1499, x_t: 0.371, cl_max_n9: 1.661, alpha_clmax_n9: 18.5, cl_max_n5: 1.679, cl_max_trip: 1.652, cd_min_n9: 0.00556,
    cl_cdmin_n9: 0.124, bucket_n9: [0.003, 0.743], cm_cruise_n9: -0.0849, cd_cruise_n9: 0.00589, cd_cruise_n5: 0.00613, cd_cruise_trip: 0.01116, cd_ratio_trip_n9_cruise: 1.89,
    cd_1p1_n9: 0.0125, cd_1p1_trip: 0.01396, ld_max_n9: 128.5, ld_max_trip: 79.6, endurance_n9: 118.8, endurance_trip: 86.2, post_stall_ratio_n9: 0.973, stall_type_gault: trailing-edge}
  - {airfoil: nlf0115, group: wing, t_over_c: 0.1497, x_t: 0.426, cl_max_n9: 1.558, alpha_clmax_n9: 18.25, cl_max_n5: 1.551, cl_max_trip: 1.538, cd_min_n9: 0.00556,
    cl_cdmin_n9: 0.097, bucket_n9: [0.046, 0.574], cm_cruise_n9: -0.0526, cd_cruise_n9: 0.00616, cd_cruise_n5: 0.00813, cd_cruise_trip: 0.01151, cd_ratio_trip_n9_cruise: 1.87,
    cd_1p1_n9: 0.01231, cd_1p1_trip: 0.0137, ld_max_n9: 98.4, ld_max_trip: 80.6, endurance_n9: 94.0, endurance_trip: 87.1, post_stall_ratio_n9: 0.926, stall_type_gault: trailing-edge}
  - {airfoil: nlf1015, group: wing, t_over_c: 0.15, x_t: 0.414, cl_max_n9: 1.634, alpha_clmax_n9: 17.0, cl_max_n5: 1.704, cl_max_trip: 1.631, cd_min_n9: 0.00562,
    cl_cdmin_n9: 0.529, bucket_n9: [0.442, 1.045], cm_cruise_n9: -0.1892, cd_cruise_n9: 0.00566, cd_cruise_n5: 0.006, cd_cruise_trip: 0.01195, cd_ratio_trip_n9_cruise: 2.11,
    cd_1p1_n9: 0.00623, cd_1p1_trip: 0.01535, ld_max_n9: 187.3, ld_max_trip: 71.9, endurance_n9: 208.8, endurance_trip: 80.6, post_stall_ratio_n9: 0.971, stall_type_gault: combined
      leading-/trailing-edge (transitional)}
  - {airfoil: n0009sm, group: tail, t_over_c: 0.0902, x_t: 0.309, cl_max_n9: 1.286, alpha_clmax_n9: 14.25, cl_max_n5: 1.385, cl_max_trip: 1.269, cd_min_n9: 0.00425,
    cl_cdmin_n9: 0.0, bucket_n9: [-0.12, 0.12], cm_cruise_n9: -0.0052, cd_cruise_n9: 0.00843, cd_cruise_n5: 0.00852, cd_cruise_trip: 0.01067, cd_ratio_trip_n9_cruise: 1.27,
    cd_1p1_n9: 0.01602, cd_1p1_trip: 0.01843, ld_max_n9: 76.9, ld_max_trip: 64.2, endurance_n9: 74.1, endurance_trip: 63.2, post_stall_ratio_n9: 0.738, stall_type_gault: leading-edge}
  - {airfoil: naca0010, group: tail, t_over_c: 0.1, x_t: 0.3, cl_max_n9: 1.428, alpha_clmax_n9: 15.5, cl_max_n5: 1.507, cl_max_trip: 1.433, cd_min_n9: 0.00457, cl_cdmin_n9: -0.0,
    bucket_n9: [-0.164, 0.164], cm_cruise_n9: 0.0005, cd_cruise_n9: 0.00838, cd_cruise_n5: 0.00845, cd_cruise_trip: 0.01056, cd_ratio_trip_n9_cruise: 1.26, cd_1p1_n9: 0.01449,
    cd_1p1_trip: 0.01609, ld_max_n9: 79.7, ld_max_trip: 69.1, endurance_n9: 79.6, endurance_trip: 72.4, post_stall_ratio_n9: 0.777, stall_type_gault: leading-edge}
  - {airfoil: n0012, group: tail, t_over_c: 0.12, x_t: 0.3, cl_max_n9: 1.505, alpha_clmax_n9: 16.75, cl_max_n5: 1.547, cl_max_trip: 1.5, cd_min_n9: 0.0052, cl_cdmin_n9: -0.0,
    bucket_n9: [-0.248, 0.248], cm_cruise_n9: 0.004, cd_cruise_n9: 0.00825, cd_cruise_n5: 0.00855, cd_cruise_trip: 0.01062, cd_ratio_trip_n9_cruise: 1.29, cd_1p1_n9: 0.01334,
    cd_1p1_trip: 0.01507, ld_max_n9: 83.4, ld_max_trip: 73.0, endurance_n9: 87.4, endurance_trip: 80.5, post_stall_ratio_n9: 0.827, stall_type_gault: combined leading-/trailing-edge
      (transitional)}
  - {airfoil: n63012a, group: tail, t_over_c: 0.1199, x_t: 0.35, cl_max_n9: 1.338, alpha_clmax_n9: 15.5, cl_max_n5: 1.432, cl_max_trip: 1.337, cd_min_n9: 0.00486,
    cl_cdmin_n9: 0.0, bucket_n9: [-0.31, 0.31], cm_cruise_n9: 0.0033, cd_cruise_n9: 0.00884, cd_cruise_n5: 0.00921, cd_cruise_trip: 0.01109, cd_ratio_trip_n9_cruise: 1.25,
    cd_1p1_n9: 0.01572, cd_1p1_trip: 0.01751, ld_max_n9: 74.7, ld_max_trip: 64.7, endurance_n9: 73.8, endurance_trip: 65.9, post_stall_ratio_n9: 0.847, stall_type_gault: leading-edge}
summary_Re_0.8e6:
  tag: estimate
  source: https://github.com/peterdsharpe/NeuralFoil
  rows:
  - {airfoil: naca4415, group: wing, t_over_c: 0.15, x_t: 0.297, cl_max_n9: 1.551, alpha_clmax_n9: 16.75, cl_max_n5: 1.54, cl_max_trip: 1.484, cd_min_n9: 0.00712,
    cl_cdmin_n9: 0.543, bucket_n9: [0.408, 0.755], cm_cruise_n9: -0.0875, cd_cruise_n9: 0.00719, cd_cruise_n5: 0.00824, cd_cruise_trip: 0.01347, cd_ratio_trip_n9_cruise: 1.87,
    cd_1p1_n9: 0.00965, cd_1p1_trip: 0.01725, ld_max_n9: 114.2, ld_max_trip: 63.8, endurance_n9: 120.8, endurance_trip: 68.7, post_stall_ratio_n9: 0.978, stall_type_gault: trailing-edge}
  - {airfoil: n63415, group: wing, t_over_c: 0.15, x_t: 0.344, cl_max_n9: 1.504, alpha_clmax_n9: 17.25, cl_max_n5: 1.553, cl_max_trip: 1.496, cd_min_n9: 0.00672,
    cl_cdmin_n9: 0.03, bucket_n9: [-0.117, 0.706], cm_cruise_n9: -0.0826, cd_cruise_n9: 0.00718, cd_cruise_n5: 0.00733, cd_cruise_trip: 0.01257, cd_ratio_trip_n9_cruise: 1.75,
    cd_1p1_n9: 0.01308, cd_1p1_trip: 0.0151, ld_max_n9: 113.4, ld_max_trip: 73.0, endurance_n9: 111.3, endurance_trip: 76.6, post_stall_ratio_n9: 0.987, stall_type_gault: trailing-edge}
  - {airfoil: naca23015, group: wing, t_over_c: 0.1501, x_t: 0.296, cl_max_n9: 1.532, alpha_clmax_n9: 16.5, cl_max_n5: 1.517, cl_max_trip: 1.518, cd_min_n9: 0.00668,
    cl_cdmin_n9: 0.049, bucket_n9: [-0.167, 0.262], cm_cruise_n9: -0.0016, cd_cruise_n9: 0.00916, cd_cruise_n5: 0.00927, cd_cruise_trip: 0.01328, cd_ratio_trip_n9_cruise: 1.45,
    cd_1p1_n9: 0.01261, cd_1p1_trip: 0.01596, ld_max_n9: 87.3, ld_max_trip: 71.1, endurance_n9: 94.3, endurance_trip: 80.7, post_stall_ratio_n9: 0.924, stall_type_gault: trailing-edge}
  - {airfoil: nlf416, group: wing, t_over_c: 0.1595, x_t: 0.317, cl_max_n9: 1.64, alpha_clmax_n9: 14.0, cl_max_n5: 1.613, cl_max_trip: 1.635, cd_min_n9: 0.00707,
    cl_cdmin_n9: 0.071, bucket_n9: [-0.012, 0.305], cm_cruise_n9: -0.1008, cd_cruise_n9: 0.00861, cd_cruise_n5: 0.00827, cd_cruise_trip: 0.01297, cd_ratio_trip_n9_cruise: 1.51,
    cd_1p1_n9: 0.01005, cd_1p1_trip: 0.01503, ld_max_n9: 112.3, ld_max_trip: 78.8, endurance_n9: 126.3, endurance_trip: 94.0, post_stall_ratio_n9: 0.962, stall_type_gault: trailing-edge}
  - {airfoil: fx63137, group: wing, t_over_c: 0.1372, x_t: 0.299, cl_max_n9: 1.867, alpha_clmax_n9: 12.75, cl_max_n5: 1.821, cl_max_trip: 1.864, cd_min_n9: 0.00704,
    cl_cdmin_n9: 0.69, bucket_n9: [0.558, 0.974], cm_cruise_n9: -0.2115, cd_cruise_n9: 0.00728, cd_cruise_n5: 0.00819, cd_cruise_trip: 0.01243, cd_ratio_trip_n9_cruise: 1.71,
    cd_1p1_n9: 0.00808, cd_1p1_trip: 0.01455, ld_max_n9: 144.7, ld_max_trip: 83.2, endurance_n9: 173.0, endurance_trip: 102.0, post_stall_ratio_n9: 0.977, stall_type_gault: trailing-edge}
  - {airfoil: e1210, group: wing, t_over_c: 0.1586, x_t: 0.224, cl_max_n9: 1.873, alpha_clmax_n9: 16.25, cl_max_n5: 1.848, cl_max_trip: 1.633, cd_min_n9: 0.00917,
    cl_cdmin_n9: 0.835, bucket_n9: [0.169, 1.088], cm_cruise_n9: -0.0903, cd_cruise_n9: 0.01001, cd_cruise_n5: 0.01024, cd_cruise_trip: 0.01314, cd_ratio_trip_n9_cruise: 1.31,
    cd_1p1_n9: 0.01015, cd_1p1_trip: 0.01589, ld_max_n9: 111.2, ld_max_trip: 72.8, endurance_n9: 133.9, endurance_trip: 84.7, post_stall_ratio_n9: 0.959, stall_type_gault: trailing-edge}
  - {airfoil: sd7062, group: wing, t_over_c: 0.14, x_t: 0.276, cl_max_n9: 1.711, alpha_clmax_n9: 15.25, cl_max_n5: 1.659, cl_max_trip: 1.686, cd_min_n9: 0.00714,
    cl_cdmin_n9: 0.565, bucket_n9: [0.254, 0.808], cm_cruise_n9: -0.0839, cd_cruise_n9: 0.00716, cd_cruise_n5: 0.00817, cd_cruise_trip: 0.01254, cd_ratio_trip_n9_cruise: 1.75,
    cd_1p1_n9: 0.00962, cd_1p1_trip: 0.01494, ld_max_n9: 114.8, ld_max_trip: 78.2, endurance_n9: 129.2, endurance_trip: 91.8, post_stall_ratio_n9: 0.96, stall_type_gault: trailing-edge}
  - {airfoil: naca4412, group: wing, t_over_c: 0.1201, x_t: 0.296, cl_max_n9: 1.594, alpha_clmax_n9: 15.5, cl_max_n5: 1.624, cl_max_trip: 1.59, cd_min_n9: 0.00624,
    cl_cdmin_n9: 0.567, bucket_n9: [0.488, 0.747], cm_cruise_n9: -0.1012, cd_cruise_n9: 0.0063, cd_cruise_n5: 0.00762, cd_cruise_trip: 0.01229, cd_ratio_trip_n9_cruise: 1.95,
    cd_1p1_n9: 0.00896, cd_1p1_trip: 0.01455, ld_max_n9: 123.5, ld_max_trip: 80.2, endurance_n9: 129.4, endurance_trip: 92.1, post_stall_ratio_n9: 0.967, stall_type_gault: trailing-edge}
  - {airfoil: naca4418, group: wing, t_over_c: 0.1801, x_t: 0.298, cl_max_n9: 1.581, alpha_clmax_n9: 16.5, cl_max_n5: 1.563, cl_max_trip: 1.559, cd_min_n9: 0.00826,
    cl_cdmin_n9: 0.669, bucket_n9: [0.027, 0.892], cm_cruise_n9: -0.0956, cd_cruise_n9: 0.0083, cd_cruise_n5: 0.00927, cd_cruise_trip: 0.01445, cd_ratio_trip_n9_cruise: 1.74,
    cd_1p1_n9: 0.01031, cd_1p1_trip: 0.01875, ld_max_n9: 106.9, ld_max_trip: 58.7, endurance_n9: 116.5, endurance_trip: 63.3, post_stall_ratio_n9: 0.985, stall_type_gault: trailing-edge}
  - {airfoil: ls417, group: wing, t_over_c: 0.1699, x_t: 0.39, cl_max_n9: 1.708, alpha_clmax_n9: 18.5, cl_max_n5: 1.757, cl_max_trip: 1.715, cd_min_n9: 0.00719, cl_cdmin_n9: 0.125,
    bucket_n9: [0.029, 0.83], cm_cruise_n9: -0.1194, cd_cruise_n9: 0.00773, cd_cruise_n5: 0.00737, cd_cruise_trip: 0.014, cd_ratio_trip_n9_cruise: 1.81, cd_1p1_n9: 0.01458,
    cd_1p1_trip: 0.01711, ld_max_n9: 106.7, ld_max_trip: 64.9, endurance_n9: 99.9, endurance_trip: 71.0, post_stall_ratio_n9: 0.98, stall_type_gault: trailing-edge}
  - {airfoil: naca642415, group: wing, t_over_c: 0.1499, x_t: 0.371, cl_max_n9: 1.507, alpha_clmax_n9: 17.75, cl_max_n5: 1.56, cl_max_trip: 1.5, cd_min_n9: 0.00665,
    cl_cdmin_n9: 0.031, bucket_n9: [-0.089, 0.676], cm_cruise_n9: -0.0836, cd_cruise_n9: 0.00722, cd_cruise_n5: 0.00724, cd_cruise_trip: 0.01261, cd_ratio_trip_n9_cruise: 1.75,
    cd_1p1_n9: 0.01471, cd_1p1_trip: 0.0161, ld_max_n9: 113.8, ld_max_trip: 70.6, endurance_n9: 109.7, endurance_trip: 72.2, post_stall_ratio_n9: 0.985, stall_type_gault: trailing-edge}
  - {airfoil: nlf0115, group: wing, t_over_c: 0.1497, x_t: 0.426, cl_max_n9: 1.469, alpha_clmax_n9: 17.25, cl_max_n5: 1.47, cl_max_trip: 1.463, cd_min_n9: 0.00684,
    cl_cdmin_n9: 0.043, bucket_n9: [-0.001, 0.622], cm_cruise_n9: -0.0519, cd_cruise_n9: 0.0074, cd_cruise_n5: 0.00827, cd_cruise_trip: 0.01307, cd_ratio_trip_n9_cruise: 1.77,
    cd_1p1_n9: 0.01512, cd_1p1_trip: 0.01663, ld_max_n9: 88.5, ld_max_trip: 66.1, endurance_n9: 76.4, endurance_trip: 70.4, post_stall_ratio_n9: 0.926, stall_type_gault: trailing-edge}
  - {airfoil: nlf1015, group: wing, t_over_c: 0.15, x_t: 0.414, cl_max_n9: 1.513, alpha_clmax_n9: 16.25, cl_max_n5: 1.596, cl_max_trip: 1.513, cd_min_n9: 0.00686,
    cl_cdmin_n9: 0.47, bucket_n9: [0.411, 0.809], cm_cruise_n9: -0.1893, cd_cruise_n9: 0.00707, cd_cruise_n5: 0.007, cd_cruise_trip: 0.0137, cd_ratio_trip_n9_cruise: 1.94,
    cd_1p1_n9: 0.00796, cd_1p1_trip: 0.01835, ld_max_n9: 155.3, ld_max_trip: 60.0, endurance_n9: 178.8, endurance_trip: 64.2, post_stall_ratio_n9: 0.979, stall_type_gault: combined
      leading-/trailing-edge (transitional)}
  - {airfoil: n0009sm, group: tail, t_over_c: 0.0902, x_t: 0.309, cl_max_n9: 1.127, alpha_clmax_n9: 12.25, cl_max_n5: 1.251, cl_max_trip: 1.111, cd_min_n9: 0.00461,
    cl_cdmin_n9: -0.0, bucket_n9: [-0.114, 0.114], cm_cruise_n9: -0.0109, cd_cruise_n9: 0.00969, cd_cruise_n5: 0.00989, cd_cruise_trip: 0.01224, cd_ratio_trip_n9_cruise: 1.26,
    cd_1p1_n9: 0.02508, cd_1p1_trip: 0.02936, ld_max_n9: 64.2, ld_max_trip: 52.7, endurance_n9: 57.3, endurance_trip: 48.4, post_stall_ratio_n9: 0.703, stall_type_gault: leading-edge}
  - {airfoil: naca0010, group: tail, t_over_c: 0.1, x_t: 0.3, cl_max_n9: 1.27, alpha_clmax_n9: 14.0, cl_max_n5: 1.368, cl_max_trip: 1.276, cd_min_n9: 0.00498, cl_cdmin_n9: 0.0,
    bucket_n9: [-0.158, 0.158], cm_cruise_n9: -0.0035, cd_cruise_n9: 0.00971, cd_cruise_n5: 0.00984, cd_cruise_trip: 0.01193, cd_ratio_trip_n9_cruise: 1.23, cd_1p1_n9: 0.01929,
    cd_1p1_trip: 0.02074, ld_max_n9: 66.1, ld_max_trip: 57.1, endurance_n9: 62.0, endurance_trip: 56.1, post_stall_ratio_n9: 0.783, stall_type_gault: leading-edge}
  - {airfoil: n0012, group: tail, t_over_c: 0.12, x_t: 0.3, cl_max_n9: 1.343, alpha_clmax_n9: 15.5, cl_max_n5: 1.417, cl_max_trip: 1.344, cd_min_n9: 0.00556, cl_cdmin_n9: -0.0,
    bucket_n9: [-0.187, 0.187], cm_cruise_n9: -0.0007, cd_cruise_n9: 0.00943, cd_cruise_n5: 0.00986, cd_cruise_trip: 0.01211, cd_ratio_trip_n9_cruise: 1.28, cd_1p1_n9: 0.0166,
    cd_1p1_trip: 0.01825, ld_max_n9: 70.0, ld_max_trip: 60.9, endurance_n9: 69.6, endurance_trip: 63.7, post_stall_ratio_n9: 0.905, stall_type_gault: combined leading-/trailing-edge
      (transitional)}
  - {airfoil: n63012a, group: tail, t_over_c: 0.1199, x_t: 0.35, cl_max_n9: 1.178, alpha_clmax_n9: 13.5, cl_max_n5: 1.293, cl_max_trip: 1.18, cd_min_n9: 0.00572,
    cl_cdmin_n9: 0.0, bucket_n9: [-0.359, 0.359], cm_cruise_n9: 0.004, cd_cruise_n9: 0.01027, cd_cruise_n5: 0.01047, cd_cruise_trip: 0.01253, cd_ratio_trip_n9_cruise: 1.22,
    cd_1p1_n9: 0.02311, cd_1p1_trip: 0.02471, ld_max_n9: 61.6, ld_max_trip: 53.0, endurance_n9: 56.7, endurance_trip: 50.4, post_stall_ratio_n9: 0.84, stall_type_gault: leading-edge}
airfoil_polars:
  naca4415:
    name: NACA 4415
    group: wing
    tag: estimate
    source: https://github.com/peterdsharpe/NeuralFoil
    coordinate_source: uiuc
    file: ucav250/data/airfoils/naca4415.dat
    uiuc_url: https://m-selig.ae.illinois.edu/ads/coord/naca4415.dat
    title: NACA 4415
    why_included: task candidate
    geometry: {t_over_c: 0.15, x_t_max_over_c: 0.297, camber_over_c: 0.0401, x_camber_max_over_c: 0.414, t_at_x0p25_over_c: 0.1488, t_at_x0p30_over_c: 0.15, t_at_x0p65_over_c: 0.1036,
      t_at_x0p90_over_c: 0.0365, te_thickness_over_c: 0.0, area_over_c2: 0.1029, box_area_x0p20_x0p65_over_c2: 0.0613, y_upper_at_x0p0125_percent_c: 2.84, n_points: 97}
    gault_stall_type_Re_1_3e6: trailing-edge
    kulfan_fit_max_dy_over_c: 0.00098
    polars:
      ncrit9:
        Re_0.8e6: {cl_max: 1.551, alpha_cl_max_deg: 16.75, cl_max_beyond_22deg: false, cl_max_within_alpha_m4_16deg: 1.548, cd_min: 0.00712, cl_at_cd_min: 0.543,
          drag_bucket_cl_range: [0.408, 0.755], cl_alpha_per_deg: 0.1193, alpha_zero_lift_deg: -3.7, cm_c4_at_cl_cruise: -0.0875, cm_c4_at_cl_loiter: -0.1024, cd_at_cl_cruise: 0.00719,
          cd_at_cl_loiter: 0.00839, cd_at_cl_1p1: 0.00965, cd_at_cl_1p3: 0.01325, l_over_d_at_cl_cruise: 83.4, l_over_d_at_cl_loiter: 107.3, l_over_d_max: 114.2,
          cl_at_l_over_d_max: 1.073, endurance_cl15_over_cd_max: 120.8, cl_at_endurance_max: 1.16, xtr_upper_at_cl_cruise: 0.541, xtr_lower_at_cl_cruise: 0.895, post_stall_cl_ratio_at_alpha_clmax_plus3deg: 0.978,
          analysis_confidence_min_prestall: 0.945}
        Re_1.5e6: {cl_max: 1.656, alpha_cl_max_deg: 17.75, cl_max_beyond_22deg: false, cl_max_within_alpha_m4_16deg: 1.639, cd_min: 0.00635, cl_at_cd_min: 0.648,
          drag_bucket_cl_range: [0.457, 0.859], cl_alpha_per_deg: 0.1122, alpha_zero_lift_deg: -3.86, cm_c4_at_cl_cruise: -0.0817, cm_c4_at_cl_loiter: -0.0994, cd_at_cl_cruise: 0.00644,
          cd_at_cl_loiter: 0.00715, cd_at_cl_1p1: 0.00824, cd_at_cl_1p3: 0.0111, l_over_d_at_cl_cruise: 93.2, l_over_d_at_cl_loiter: 125.9, l_over_d_max: 133.6, cl_at_l_over_d_max: 1.105,
          endurance_cl15_over_cd_max: 142.9, cl_at_endurance_max: 1.164, xtr_upper_at_cl_cruise: 0.491, xtr_lower_at_cl_cruise: 0.684, post_stall_cl_ratio_at_alpha_clmax_plus3deg: 0.97,
          analysis_confidence_min_prestall: 0.904}
        Re_2.5e6: {cl_max: 1.737, alpha_cl_max_deg: 18.25, cl_max_beyond_22deg: false, cl_max_within_alpha_m4_16deg: 1.702, cd_min: 0.00594, cl_at_cd_min: 0.729,
          drag_bucket_cl_range: [0.232, 0.893], cl_alpha_per_deg: 0.1041, alpha_zero_lift_deg: -4.19, cm_c4_at_cl_cruise: -0.0872, cm_c4_at_cl_loiter: -0.0936, cd_at_cl_cruise: 0.00632,
          cd_at_cl_loiter: 0.00642, cd_at_cl_1p1: 0.00756, cd_at_cl_1p3: 0.00988, l_over_d_at_cl_cruise: 94.9, l_over_d_at_cl_loiter: 140.1, l_over_d_max: 145.7,
          cl_at_l_over_d_max: 1.088, endurance_cl15_over_cd_max: 155.2, cl_at_endurance_max: 1.182, xtr_upper_at_cl_cruise: 0.468, xtr_lower_at_cl_cruise: 0.458,
          post_stall_cl_ratio_at_alpha_clmax_plus3deg: 0.97, analysis_confidence_min_prestall: 0.859}
      ncrit5:
        Re_0.8e6: {cl_max: 1.54, alpha_cl_max_deg: 17.0, cl_max_beyond_22deg: false, cl_max_within_alpha_m4_16deg: 1.535, cd_min: 0.00805, cl_at_cd_min: 0.652, drag_bucket_cl_range: [
            0.07, 0.854], cl_alpha_per_deg: 0.1062, alpha_zero_lift_deg: -3.94, cm_c4_at_cl_cruise: -0.0789, cm_c4_at_cl_loiter: -0.093, cd_at_cl_cruise: 0.00824,
          cd_at_cl_loiter: 0.00892, cd_at_cl_1p1: 0.01049, cd_at_cl_1p3: 0.01569, l_over_d_at_cl_cruise: 72.9, l_over_d_at_cl_loiter: 100.9, l_over_d_max: 105.5,
          cl_at_l_over_d_max: 1.063, endurance_cl15_over_cd_max: 110.1, cl_at_endurance_max: 1.118, xtr_upper_at_cl_cruise: 0.469, xtr_lower_at_cl_cruise: 0.566,
          post_stall_cl_ratio_at_alpha_clmax_plus3deg: 0.976, analysis_confidence_min_prestall: 0.885}
        Re_1.5e6: {cl_max: 1.636, alpha_cl_max_deg: 17.5, cl_max_beyond_22deg: false, cl_max_within_alpha_m4_16deg: 1.619, cd_min: 0.0074, cl_at_cd_min: 0.757, drag_bucket_cl_range: [
            0.015, 0.952], cl_alpha_per_deg: 0.0987, alpha_zero_lift_deg: -4.29, cm_c4_at_cl_cruise: -0.0846, cm_c4_at_cl_loiter: -0.0853, cd_at_cl_cruise: 0.00773,
          cd_at_cl_loiter: 0.00783, cd_at_cl_1p1: 0.00932, cd_at_cl_1p3: 0.01292, l_over_d_at_cl_cruise: 77.6, l_over_d_at_cl_loiter: 115.0, l_over_d_max: 118.9,
          cl_at_l_over_d_max: 1.047, endurance_cl15_over_cd_max: 124.3, cl_at_endurance_max: 1.14, xtr_upper_at_cl_cruise: 0.437, xtr_lower_at_cl_cruise: 0.353, post_stall_cl_ratio_at_alpha_clmax_plus3deg: 0.975,
          analysis_confidence_min_prestall: 0.827}
        Re_2.5e6: {cl_max: 1.708, alpha_cl_max_deg: 18.0, cl_max_beyond_22deg: false, cl_max_within_alpha_m4_16deg: 1.679, cd_min: 0.00704, cl_at_cd_min: 0.382, drag_bucket_cl_range: [
            0.014, 0.933], cl_alpha_per_deg: 0.0994, alpha_zero_lift_deg: -4.34, cm_c4_at_cl_cruise: -0.0869, cm_c4_at_cl_loiter: -0.0759, cd_at_cl_cruise: 0.0072,
          cd_at_cl_loiter: 0.00746, cd_at_cl_1p1: 0.00878, cd_at_cl_1p3: 0.01154, l_over_d_at_cl_cruise: 83.3, l_over_d_at_cl_loiter: 120.7, l_over_d_max: 125.7,
          cl_at_l_over_d_max: 1.045, endurance_cl15_over_cd_max: 133.3, cl_at_endurance_max: 1.182, xtr_upper_at_cl_cruise: 0.402, xtr_lower_at_cl_cruise: 0.292,
          post_stall_cl_ratio_at_alpha_clmax_plus3deg: 0.976, analysis_confidence_min_prestall: 0.779}
      tripped:
        Re_0.8e6: {cl_max: 1.484, alpha_cl_max_deg: 16.5, cl_max_beyond_22deg: false, cl_max_within_alpha_m4_16deg: 1.482, cd_min: 0.01232, cl_at_cd_min: 0.009, drag_bucket_cl_range: [
            -0.042, 0.601], cl_alpha_per_deg: 0.0966, alpha_zero_lift_deg: -3.71, cm_c4_at_cl_cruise: -0.0679, cm_c4_at_cl_loiter: -0.0539, cd_at_cl_cruise: 0.01347,
          cd_at_cl_loiter: 0.0151, cd_at_cl_1p1: 0.01725, cd_at_cl_1p3: 0.02199, l_over_d_at_cl_cruise: 44.5, l_over_d_at_cl_loiter: 59.6, l_over_d_max: 63.8, cl_at_l_over_d_max: 1.097,
          endurance_cl15_over_cd_max: 68.7, cl_at_endurance_max: 1.205, xtr_upper_at_cl_cruise: 0.071, xtr_lower_at_cl_cruise: 0.067, post_stall_cl_ratio_at_alpha_clmax_plus3deg: 0.98,
          analysis_confidence_min_prestall: 0.963}
        Re_1.5e6: {cl_max: 1.562, alpha_cl_max_deg: 17.75, cl_max_beyond_22deg: false, cl_max_within_alpha_m4_16deg: 1.545, cd_min: 0.01083, cl_at_cd_min: -0.008,
          drag_bucket_cl_range: [-0.034, 0.621], cl_alpha_per_deg: 0.0983, alpha_zero_lift_deg: -3.81, cm_c4_at_cl_cruise: -0.072, cm_c4_at_cl_loiter: -0.0596, cd_at_cl_cruise: 0.01181,
          cd_at_cl_loiter: 0.01303, cd_at_cl_1p1: 0.01448, cd_at_cl_1p3: 0.01726, l_over_d_at_cl_cruise: 50.8, l_over_d_at_cl_loiter: 69.1, l_over_d_max: 76.7, cl_at_l_over_d_max: 1.186,
          endurance_cl15_over_cd_max: 85.9, cl_at_endurance_max: 1.314, xtr_upper_at_cl_cruise: 0.071, xtr_lower_at_cl_cruise: 0.071, post_stall_cl_ratio_at_alpha_clmax_plus3deg: 0.979,
          analysis_confidence_min_prestall: 0.942}
        Re_2.5e6: {cl_max: 1.632, alpha_cl_max_deg: 18.5, cl_max_beyond_22deg: false, cl_max_within_alpha_m4_16deg: 1.593, cd_min: 0.00984, cl_at_cd_min: -0.001,
          drag_bucket_cl_range: [-0.027, 0.636], cl_alpha_per_deg: 0.0996, alpha_zero_lift_deg: -3.88, cm_c4_at_cl_cruise: -0.0753, cm_c4_at_cl_loiter: -0.0642, cd_at_cl_cruise: 0.01068,
          cd_at_cl_loiter: 0.01167, cd_at_cl_1p1: 0.01279, cd_at_cl_1p3: 0.01467, l_over_d_at_cl_cruise: 56.2, l_over_d_at_cl_loiter: 77.1, l_over_d_max: 88.7, cl_at_l_over_d_max: 1.271,
          endurance_cl15_over_cd_max: 101.8, cl_at_endurance_max: 1.345, xtr_upper_at_cl_cruise: 0.071, xtr_lower_at_cl_cruise: 0.074, post_stall_cl_ratio_at_alpha_clmax_plus3deg: 0.975,
          analysis_confidence_min_prestall: 0.898}
    model_size_check_Re_1.5e6_ncrit9:
      cl_max: {large: 1.656, xlarge: 1.647}
      cd_min: {large: 0.00635, xlarge: 0.00626}
      cm_c4_at_cl_cruise: {large: -0.0817, xlarge: -0.0827}
      l_over_d_max: {large: 133.6, xlarge: 134.7}
  n63415:
    name: NACA 63(2)-415
    group: wing
    tag: estimate
    source: https://github.com/peterdsharpe/NeuralFoil
    coordinate_source: uiuc
    file: ucav250/data/airfoils/n63415.dat
    uiuc_url: https://m-selig.ae.illinois.edu/ads/coord/n63415.dat
    title: NACA 63-415 AIRFOIL
    why_included: task candidate
    geometry: {t_over_c: 0.15, x_t_max_over_c: 0.344, camber_over_c: 0.0221, x_camber_max_over_c: 0.509, t_at_x0p25_over_c: 0.1432, t_at_x0p30_over_c: 0.1485, t_at_x0p65_over_c: 0.0944,
      t_at_x0p90_over_c: 0.0171, te_thickness_over_c: 0.0, area_over_c2: 0.0938, box_area_x0p20_x0p65_over_c2: 0.0605, y_upper_at_x0p0125_percent_c: 2.29, n_points: 51}
    gault_stall_type_Re_1_3e6: trailing-edge
    kulfan_fit_max_dy_over_c: 0.00042
    polars:
      ncrit9:
        Re_0.8e6: {cl_max: 1.504, alpha_cl_max_deg: 17.25, cl_max_beyond_22deg: false, cl_max_within_alpha_m4_16deg: 1.498, cd_min: 0.00672, cl_at_cd_min: 0.03, drag_bucket_cl_range: [
            -0.117, 0.706], cl_alpha_per_deg: 0.1174, alpha_zero_lift_deg: -3.01, cm_c4_at_cl_cruise: -0.0826, cm_c4_at_cl_loiter: -0.0848, cd_at_cl_cruise: 0.00718,
          cd_at_cl_loiter: 0.00803, cd_at_cl_1p1: 0.01308, cd_at_cl_1p3: 0.01988, l_over_d_at_cl_cruise: 83.6, l_over_d_at_cl_loiter: 112.0, l_over_d_max: 113.4,
          cl_at_l_over_d_max: 0.957, endurance_cl15_over_cd_max: 111.3, cl_at_endurance_max: 0.982, xtr_upper_at_cl_cruise: 0.573, xtr_lower_at_cl_cruise: 0.676,
          post_stall_cl_ratio_at_alpha_clmax_plus3deg: 0.987, analysis_confidence_min_prestall: 0.947}
        Re_1.5e6: {cl_max: 1.656, alpha_cl_max_deg: 18.0, cl_max_beyond_22deg: false, cl_max_within_alpha_m4_16deg: 1.635, cd_min: 0.00566, cl_at_cd_min: 0.093, drag_bucket_cl_range: [
            -0.056, 0.714], cl_alpha_per_deg: 0.1181, alpha_zero_lift_deg: -3.05, cm_c4_at_cl_cruise: -0.0839, cm_c4_at_cl_loiter: -0.0862, cd_at_cl_cruise: 0.00593,
          cd_at_cl_loiter: 0.00714, cd_at_cl_1p1: 0.0119, cd_at_cl_1p3: 0.01512, l_over_d_at_cl_cruise: 101.1, l_over_d_at_cl_loiter: 126.1, l_over_d_max: 127.1,
          cl_at_l_over_d_max: 0.856, endurance_cl15_over_cd_max: 119.8, cl_at_endurance_max: 0.909, xtr_upper_at_cl_cruise: 0.539, xtr_lower_at_cl_cruise: 0.633,
          post_stall_cl_ratio_at_alpha_clmax_plus3deg: 0.974, analysis_confidence_min_prestall: 0.938}
        Re_2.5e6: {cl_max: 1.755, alpha_cl_max_deg: 18.5, cl_max_beyond_22deg: false, cl_max_within_alpha_m4_16deg: 1.718, cd_min: 0.00507, cl_at_cd_min: 0.216, drag_bucket_cl_range: [
            0.006, 0.69], cl_alpha_per_deg: 0.1178, alpha_zero_lift_deg: -3.09, cm_c4_at_cl_cruise: -0.0849, cm_c4_at_cl_loiter: -0.0859, cd_at_cl_cruise: 0.0053,
          cd_at_cl_loiter: 0.0072, cd_at_cl_1p1: 0.01085, cd_at_cl_1p3: 0.01317, l_over_d_at_cl_cruise: 113.3, l_over_d_at_cl_loiter: 125.0, l_over_d_max: 133.5,
          cl_at_l_over_d_max: 0.803, endurance_cl15_over_cd_max: 121.4, cl_at_endurance_max: 0.857, xtr_upper_at_cl_cruise: 0.508, xtr_lower_at_cl_cruise: 0.602,
          post_stall_cl_ratio_at_alpha_clmax_plus3deg: 0.974, analysis_confidence_min_prestall: 0.936}
      ncrit5:
        Re_0.8e6: {cl_max: 1.553, alpha_cl_max_deg: 17.75, cl_max_beyond_22deg: false, cl_max_within_alpha_m4_16deg: 1.542, cd_min: 0.00696, cl_at_cd_min: 0.142,
          drag_bucket_cl_range: [-0.035, 0.704], cl_alpha_per_deg: 0.1177, alpha_zero_lift_deg: -2.97, cm_c4_at_cl_cruise: -0.0818, cm_c4_at_cl_loiter: -0.0824, cd_at_cl_cruise: 0.00733,
          cd_at_cl_loiter: 0.00932, cd_at_cl_1p1: 0.01436, cd_at_cl_1p3: 0.01913, l_over_d_at_cl_cruise: 81.9, l_over_d_at_cl_loiter: 96.6, l_over_d_max: 100.4, cl_at_l_over_d_max: 0.842,
          endurance_cl15_over_cd_max: 92.7, cl_at_endurance_max: 0.867, xtr_upper_at_cl_cruise: 0.521, xtr_lower_at_cl_cruise: 0.619, post_stall_cl_ratio_at_alpha_clmax_plus3deg: 0.979,
          analysis_confidence_min_prestall: 0.949}
        Re_1.5e6: {cl_max: 1.67, alpha_cl_max_deg: 18.25, cl_max_beyond_22deg: false, cl_max_within_alpha_m4_16deg: 1.645, cd_min: 0.00597, cl_at_cd_min: 0.238, drag_bucket_cl_range: [
            0.059, 0.652], cl_alpha_per_deg: 0.1171, alpha_zero_lift_deg: -3.05, cm_c4_at_cl_cruise: -0.0833, cm_c4_at_cl_loiter: -0.0825, cd_at_cl_cruise: 0.00631,
          cd_at_cl_loiter: 0.00952, cd_at_cl_1p1: 0.01245, cd_at_cl_1p3: 0.01529, l_over_d_at_cl_cruise: 95.1, l_over_d_at_cl_loiter: 94.5, l_over_d_max: 107.4, cl_at_l_over_d_max: 0.764,
          endurance_cl15_over_cd_max: 96.9, cl_at_endurance_max: 1.275, xtr_upper_at_cl_cruise: 0.484, xtr_lower_at_cl_cruise: 0.582, post_stall_cl_ratio_at_alpha_clmax_plus3deg: 0.977,
          analysis_confidence_min_prestall: 0.947}
        Re_2.5e6: {cl_max: 1.736, alpha_cl_max_deg: 18.0, cl_max_beyond_22deg: false, cl_max_within_alpha_m4_16deg: 1.711, cd_min: 0.0054, cl_at_cd_min: 0.273, drag_bucket_cl_range: [
            0.122, 0.626], cl_alpha_per_deg: 0.1161, alpha_zero_lift_deg: -3.11, cm_c4_at_cl_cruise: -0.0844, cm_c4_at_cl_loiter: -0.0831, cd_at_cl_cruise: 0.00583,
          cd_at_cl_loiter: 0.00936, cd_at_cl_1p1: 0.01125, cd_at_cl_1p3: 0.01341, l_over_d_at_cl_cruise: 103.0, l_over_d_at_cl_loiter: 96.2, l_over_d_max: 109.7,
          cl_at_l_over_d_max: 0.71, endurance_cl15_over_cd_max: 111.4, cl_at_endurance_max: 1.366, xtr_upper_at_cl_cruise: 0.45, xtr_lower_at_cl_cruise: 0.552, post_stall_cl_ratio_at_alpha_clmax_plus3deg: 0.978,
          analysis_confidence_min_prestall: 0.949}
      tripped:
        Re_0.8e6: {cl_max: 1.496, alpha_cl_max_deg: 18.0, cl_max_beyond_22deg: false, cl_max_within_alpha_m4_16deg: 1.486, cd_min: 0.01177, cl_at_cd_min: 0.026, drag_bucket_cl_range: [
            -0.146, 0.711], cl_alpha_per_deg: 0.114, alpha_zero_lift_deg: -2.74, cm_c4_at_cl_cruise: -0.0742, cm_c4_at_cl_loiter: -0.0747, cd_at_cl_cruise: 0.01257,
          cd_at_cl_loiter: 0.01366, cd_at_cl_1p1: 0.0151, cd_at_cl_1p3: 0.02185, l_over_d_at_cl_cruise: 47.7, l_over_d_at_cl_loiter: 65.9, l_over_d_max: 73.0, cl_at_l_over_d_max: 1.086,
          endurance_cl15_over_cd_max: 76.6, cl_at_endurance_max: 1.109, xtr_upper_at_cl_cruise: 0.08, xtr_lower_at_cl_cruise: 0.078, post_stall_cl_ratio_at_alpha_clmax_plus3deg: 0.991,
          analysis_confidence_min_prestall: 0.922}
        Re_1.5e6: {cl_max: 1.645, alpha_cl_max_deg: 18.5, cl_max_beyond_22deg: false, cl_max_within_alpha_m4_16deg: 1.619, cd_min: 0.01042, cl_at_cd_min: 0.005, drag_bucket_cl_range: [
            -0.14, 0.724], cl_alpha_per_deg: 0.1148, alpha_zero_lift_deg: -2.81, cm_c4_at_cl_cruise: -0.0764, cm_c4_at_cl_loiter: -0.0774, cd_at_cl_cruise: 0.01112,
          cd_at_cl_loiter: 0.01202, cd_at_cl_1p1: 0.01335, cd_at_cl_1p3: 0.01664, l_over_d_at_cl_cruise: 53.9, l_over_d_at_cl_loiter: 74.9, l_over_d_max: 82.7, cl_at_l_over_d_max: 1.079,
          endurance_cl15_over_cd_max: 89.2, cl_at_endurance_max: 1.278, xtr_upper_at_cl_cruise: 0.081, xtr_lower_at_cl_cruise: 0.078, post_stall_cl_ratio_at_alpha_clmax_plus3deg: 0.974,
          analysis_confidence_min_prestall: 0.919}
        Re_2.5e6: {cl_max: 1.745, alpha_cl_max_deg: 19.0, cl_max_beyond_22deg: false, cl_max_within_alpha_m4_16deg: 1.702, cd_min: 0.00947, cl_at_cd_min: -0.106,
          drag_bucket_cl_range: [-0.136, 0.704], cl_alpha_per_deg: 0.1152, alpha_zero_lift_deg: -2.86, cm_c4_at_cl_cruise: -0.0779, cm_c4_at_cl_loiter: -0.0792, cd_at_cl_cruise: 0.01012,
          cd_at_cl_loiter: 0.01091, cd_at_cl_1p1: 0.01231, cd_at_cl_1p3: 0.01442, l_over_d_at_cl_cruise: 59.3, l_over_d_at_cl_loiter: 82.5, l_over_d_max: 90.4, cl_at_l_over_d_max: 1.259,
          endurance_cl15_over_cd_max: 104.1, cl_at_endurance_max: 1.39, xtr_upper_at_cl_cruise: 0.08, xtr_lower_at_cl_cruise: 0.078, post_stall_cl_ratio_at_alpha_clmax_plus3deg: 0.97,
          analysis_confidence_min_prestall: 0.913}
    model_size_check_Re_1.5e6_ncrit9:
      cl_max: {large: 1.656, xlarge: 1.648}
      cd_min: {large: 0.00566, xlarge: 0.00565}
      cm_c4_at_cl_cruise: {large: -0.0839, xlarge: -0.0836}
      l_over_d_max: {large: 127.1, xlarge: 126.0}
  naca23015:
    name: NACA 23015
    group: wing
    tag: estimate
    source: https://github.com/peterdsharpe/NeuralFoil
    coordinate_source: uiuc
    file: ucav250/data/airfoils/naca23015.dat
    uiuc_url: https://m-selig.ae.illinois.edu/ads/coord/naca23015.dat
    title: NACA 23015
    why_included: task candidate
    geometry: {t_over_c: 0.1501, x_t_max_over_c: 0.296, camber_over_c: 0.0184, x_camber_max_over_c: 0.141, t_at_x0p25_over_c: 0.1486, t_at_x0p30_over_c: 0.1501, t_at_x0p65_over_c: 0.1034,
      t_at_x0p90_over_c: 0.0363, te_thickness_over_c: 0.0032, area_over_c2: 0.1028, box_area_x0p20_x0p65_over_c2: 0.0612, y_upper_at_x0p0125_percent_c: 3.34, n_points: 35}
    gault_stall_type_Re_1_3e6: trailing-edge
    kulfan_fit_max_dy_over_c: 0.00545
    polars:
      ncrit9:
        Re_0.8e6: {cl_max: 1.532, alpha_cl_max_deg: 16.5, cl_max_beyond_22deg: false, cl_max_within_alpha_m4_16deg: 1.527, cd_min: 0.00668, cl_at_cd_min: 0.049, drag_bucket_cl_range: [
            -0.167, 0.262], cl_alpha_per_deg: 0.1072, alpha_zero_lift_deg: -1.2, cm_c4_at_cl_cruise: -0.0016, cm_c4_at_cl_loiter: -0.0117, cd_at_cl_cruise: 0.00916,
          cd_at_cl_loiter: 0.01107, cd_at_cl_1p1: 0.01261, cd_at_cl_1p3: 0.01615, l_over_d_at_cl_cruise: 65.5, l_over_d_at_cl_loiter: 81.3, l_over_d_max: 87.3, cl_at_l_over_d_max: 1.123,
          endurance_cl15_over_cd_max: 94.3, cl_at_endurance_max: 1.202, xtr_upper_at_cl_cruise: 0.253, xtr_lower_at_cl_cruise: 0.963, post_stall_cl_ratio_at_alpha_clmax_plus3deg: 0.924,
          analysis_confidence_min_prestall: 0.957}
        Re_1.5e6: {cl_max: 1.614, alpha_cl_max_deg: 16.75, cl_max_beyond_22deg: false, cl_max_within_alpha_m4_16deg: 1.604, cd_min: 0.00621, cl_at_cd_min: 0.104,
          drag_bucket_cl_range: [-0.141, 0.383], cl_alpha_per_deg: 0.1105, alpha_zero_lift_deg: -1.2, cm_c4_at_cl_cruise: -0.0027, cm_c4_at_cl_loiter: -0.0058, cd_at_cl_cruise: 0.00763,
          cd_at_cl_loiter: 0.00934, cd_at_cl_1p1: 0.01085, cd_at_cl_1p3: 0.01321, l_over_d_at_cl_cruise: 78.7, l_over_d_at_cl_loiter: 96.4, l_over_d_max: 101.7, cl_at_l_over_d_max: 1.147,
          endurance_cl15_over_cd_max: 112.3, cl_at_endurance_max: 1.288, xtr_upper_at_cl_cruise: 0.223, xtr_lower_at_cl_cruise: 0.934, post_stall_cl_ratio_at_alpha_clmax_plus3deg: 0.888,
          analysis_confidence_min_prestall: 0.943}
        Re_2.5e6: {cl_max: 1.599, alpha_cl_max_deg: 16.5, cl_max_beyond_22deg: false, cl_max_within_alpha_m4_16deg: 1.597, cd_min: 0.00603, cl_at_cd_min: 0.218, drag_bucket_cl_range: [
            -0.115, 0.53], cl_alpha_per_deg: 0.1129, alpha_zero_lift_deg: -1.19, cm_c4_at_cl_cruise: -0.0068, cm_c4_at_cl_loiter: -0.0047, cd_at_cl_cruise: 0.00685,
          cd_at_cl_loiter: 0.00823, cd_at_cl_1p1: 0.00981, cd_at_cl_1p3: 0.01189, l_over_d_at_cl_cruise: 87.6, l_over_d_at_cl_loiter: 109.3, l_over_d_max: 112.2,
          cl_at_l_over_d_max: 1.081, endurance_cl15_over_cd_max: 125.0, cl_at_endurance_max: 1.345, xtr_upper_at_cl_cruise: 0.207, xtr_lower_at_cl_cruise: 0.883,
          post_stall_cl_ratio_at_alpha_clmax_plus3deg: 0.884, analysis_confidence_min_prestall: 0.939}
      ncrit5:
        Re_0.8e6: {cl_max: 1.517, alpha_cl_max_deg: 16.25, cl_max_beyond_22deg: false, cl_max_within_alpha_m4_16deg: 1.517, cd_min: 0.00788, cl_at_cd_min: 0.019,
          drag_bucket_cl_range: [-0.138, 0.455], cl_alpha_per_deg: 0.1087, alpha_zero_lift_deg: -1.18, cm_c4_at_cl_cruise: -0.0012, cm_c4_at_cl_loiter: -0.0042, cd_at_cl_cruise: 0.00927,
          cd_at_cl_loiter: 0.01125, cd_at_cl_1p1: 0.0133, cd_at_cl_1p3: 0.01695, l_over_d_at_cl_cruise: 64.7, l_over_d_at_cl_loiter: 80.0, l_over_d_max: 82.8, cl_at_l_over_d_max: 1.069,
          endurance_cl15_over_cd_max: 89.0, cl_at_endurance_max: 1.208, xtr_upper_at_cl_cruise: 0.206, xtr_lower_at_cl_cruise: 0.909, post_stall_cl_ratio_at_alpha_clmax_plus3deg: 0.897,
          analysis_confidence_min_prestall: 0.955}
        Re_1.5e6: {cl_max: 1.541, alpha_cl_max_deg: 16.0, cl_max_beyond_22deg: false, cl_max_within_alpha_m4_16deg: 1.541, cd_min: 0.00735, cl_at_cd_min: 0.075, drag_bucket_cl_range: [
            -0.086, 0.606], cl_alpha_per_deg: 0.1115, alpha_zero_lift_deg: -1.18, cm_c4_at_cl_cruise: -0.0062, cm_c4_at_cl_loiter: -0.0036, cd_at_cl_cruise: 0.00804,
          cd_at_cl_loiter: 0.00958, cd_at_cl_1p1: 0.01151, cd_at_cl_1p3: 0.01419, l_over_d_at_cl_cruise: 74.6, l_over_d_at_cl_loiter: 93.9, l_over_d_max: 95.8, cl_at_l_over_d_max: 1.04,
          endurance_cl15_over_cd_max: 104.5, cl_at_endurance_max: 1.292, xtr_upper_at_cl_cruise: 0.189, xtr_lower_at_cl_cruise: 0.83, post_stall_cl_ratio_at_alpha_clmax_plus3deg: 0.88,
          analysis_confidence_min_prestall: 0.951}
        Re_2.5e6: {cl_max: 1.553, alpha_cl_max_deg: 16.25, cl_max_beyond_22deg: false, cl_max_within_alpha_m4_16deg: 1.552, cd_min: 0.00694, cl_at_cd_min: 0.134,
          drag_bucket_cl_range: [-0.005, 0.67], cl_alpha_per_deg: 0.1123, alpha_zero_lift_deg: -1.21, cm_c4_at_cl_cruise: -0.0081, cm_c4_at_cl_loiter: -0.0066, cd_at_cl_cruise: 0.00737,
          cd_at_cl_loiter: 0.00868, cd_at_cl_1p1: 0.01037, cd_at_cl_1p3: 0.01308, l_over_d_at_cl_cruise: 81.4, l_over_d_at_cl_loiter: 103.6, l_over_d_max: 106.2,
          cl_at_l_over_d_max: 1.048, endurance_cl15_over_cd_max: 114.3, cl_at_endurance_max: 1.228, xtr_upper_at_cl_cruise: 0.176, xtr_lower_at_cl_cruise: 0.761,
          post_stall_cl_ratio_at_alpha_clmax_plus3deg: 0.882, analysis_confidence_min_prestall: 0.949}
      tripped:
        Re_0.8e6: {cl_max: 1.518, alpha_cl_max_deg: 16.25, cl_max_beyond_22deg: false, cl_max_within_alpha_m4_16deg: 1.517, cd_min: 0.01211, cl_at_cd_min: -0.065,
          drag_bucket_cl_range: [-0.316, 0.606], cl_alpha_per_deg: 0.1121, alpha_zero_lift_deg: -1.18, cm_c4_at_cl_cruise: -0.006, cm_c4_at_cl_loiter: -0.0044, cd_at_cl_cruise: 0.01328,
          cd_at_cl_loiter: 0.01455, cd_at_cl_1p1: 0.01596, cd_at_cl_1p3: 0.01839, l_over_d_at_cl_cruise: 45.2, l_over_d_at_cl_loiter: 61.9, l_over_d_max: 71.1, cl_at_l_over_d_max: 1.259,
          endurance_cl15_over_cd_max: 80.7, cl_at_endurance_max: 1.318, xtr_upper_at_cl_cruise: 0.089, xtr_lower_at_cl_cruise: 0.071, post_stall_cl_ratio_at_alpha_clmax_plus3deg: 0.926,
          analysis_confidence_min_prestall: 0.961}
        Re_1.5e6: {cl_max: 1.604, alpha_cl_max_deg: 16.5, cl_max_beyond_22deg: false, cl_max_within_alpha_m4_16deg: 1.598, cd_min: 0.01075, cl_at_cd_min: -0.149,
          drag_bucket_cl_range: [-0.319, 0.641], cl_alpha_per_deg: 0.1132, alpha_zero_lift_deg: -1.19, cm_c4_at_cl_cruise: -0.0073, cm_c4_at_cl_loiter: -0.0071, cd_at_cl_cruise: 0.01168,
          cd_at_cl_loiter: 0.01262, cd_at_cl_1p1: 0.01361, cd_at_cl_1p3: 0.01523, l_over_d_at_cl_cruise: 51.4, l_over_d_at_cl_loiter: 71.3, l_over_d_max: 85.4, cl_at_l_over_d_max: 1.294,
          endurance_cl15_over_cd_max: 98.8, cl_at_endurance_max: 1.379, xtr_upper_at_cl_cruise: 0.087, xtr_lower_at_cl_cruise: 0.072, post_stall_cl_ratio_at_alpha_clmax_plus3deg: 0.888,
          analysis_confidence_min_prestall: 0.959}
        Re_2.5e6: {cl_max: 1.597, alpha_cl_max_deg: 16.25, cl_max_beyond_22deg: false, cl_max_within_alpha_m4_16deg: 1.597, cd_min: 0.0098, cl_at_cd_min: -0.178,
          drag_bucket_cl_range: [-0.319, 0.674], cl_alpha_per_deg: 0.1139, alpha_zero_lift_deg: -1.19, cm_c4_at_cl_cruise: -0.0081, cm_c4_at_cl_loiter: -0.0085, cd_at_cl_cruise: 0.01059,
          cd_at_cl_loiter: 0.01136, cd_at_cl_1p1: 0.01215, cd_at_cl_1p3: 0.0136, l_over_d_at_cl_cruise: 56.7, l_over_d_at_cl_loiter: 79.2, l_over_d_max: 95.6, cl_at_l_over_d_max: 1.29,
          endurance_cl15_over_cd_max: 111.0, cl_at_endurance_max: 1.382, xtr_upper_at_cl_cruise: 0.083, xtr_lower_at_cl_cruise: 0.072, post_stall_cl_ratio_at_alpha_clmax_plus3deg: 0.884,
          analysis_confidence_min_prestall: 0.933}
    model_size_check_Re_1.5e6_ncrit9:
      cl_max: {large: 1.614, xlarge: 1.623}
      cd_min: {large: 0.00621, xlarge: 0.00618}
      cm_c4_at_cl_cruise: {large: -0.0027, xlarge: -0.0038}
      l_over_d_max: {large: 101.7, xlarge: 102.7}
  nlf416:
    name: NASA NLF(1)-0416
    group: wing
    tag: estimate
    source: https://github.com/peterdsharpe/NeuralFoil
    coordinate_source: uiuc
    file: ucav250/data/airfoils/nlf416.dat
    uiuc_url: https://m-selig.ae.illinois.edu/ads/coord/nlf416.dat
    title: NASA/LANGLEY NLF(1)-0416 AIRFOIL
    why_included: task candidate
    geometry: {t_over_c: 0.1595, x_t_max_over_c: 0.317, camber_over_c: 0.0245, x_camber_max_over_c: 0.301, t_at_x0p25_over_c: 0.1559, t_at_x0p30_over_c: 0.1594, t_at_x0p65_over_c: 0.0958,
      t_at_x0p90_over_c: 0.0176, te_thickness_over_c: 0.0, area_over_c2: 0.0993, box_area_x0p20_x0p65_over_c2: 0.0639, y_upper_at_x0p0125_percent_c: 2.42, n_points: 62}
    gault_stall_type_Re_1_3e6: trailing-edge
    kulfan_fit_max_dy_over_c: 0.00073
    polars:
      ncrit9:
        Re_0.8e6: {cl_max: 1.64, alpha_cl_max_deg: 14.0, cl_max_beyond_22deg: false, cl_max_within_alpha_m4_16deg: 1.64, cd_min: 0.00707, cl_at_cd_min: 0.071, drag_bucket_cl_range: [
            -0.012, 0.305], cl_alpha_per_deg: 0.1153, alpha_zero_lift_deg: -3.89, cm_c4_at_cl_cruise: -0.1008, cm_c4_at_cl_loiter: -0.1017, cd_at_cl_cruise: 0.00861,
          cd_at_cl_loiter: 0.0093, cd_at_cl_1p1: 0.01005, cd_at_cl_1p3: 0.01174, l_over_d_at_cl_cruise: 69.7, l_over_d_at_cl_loiter: 96.7, l_over_d_max: 112.3, cl_at_l_over_d_max: 1.233,
          endurance_cl15_over_cd_max: 126.3, cl_at_endurance_max: 1.307, xtr_upper_at_cl_cruise: 0.475, xtr_lower_at_cl_cruise: 0.666, post_stall_cl_ratio_at_alpha_clmax_plus3deg: 0.962,
          analysis_confidence_min_prestall: 0.935}
        Re_1.5e6: {cl_max: 1.714, alpha_cl_max_deg: 15.0, cl_max_beyond_22deg: false, cl_max_within_alpha_m4_16deg: 1.714, cd_min: 0.006, cl_at_cd_min: 0.197, drag_bucket_cl_range: [
            0.082, 0.492], cl_alpha_per_deg: 0.1168, alpha_zero_lift_deg: -3.95, cm_c4_at_cl_cruise: -0.1043, cm_c4_at_cl_loiter: -0.1057, cd_at_cl_cruise: 0.00683,
          cd_at_cl_loiter: 0.00755, cd_at_cl_1p1: 0.00839, cd_at_cl_1p3: 0.01027, l_over_d_at_cl_cruise: 87.9, l_over_d_at_cl_loiter: 119.3, l_over_d_max: 131.7,
          cl_at_l_over_d_max: 1.148, endurance_cl15_over_cd_max: 144.5, cl_at_endurance_max: 1.276, xtr_upper_at_cl_cruise: 0.453, xtr_lower_at_cl_cruise: 0.645,
          post_stall_cl_ratio_at_alpha_clmax_plus3deg: 0.966, analysis_confidence_min_prestall: 0.933}
        Re_2.5e6: {cl_max: 1.776, alpha_cl_max_deg: 16.0, cl_max_beyond_22deg: false, cl_max_within_alpha_m4_16deg: 1.776, cd_min: 0.00541, cl_at_cd_min: 0.294, drag_bucket_cl_range: [
            0.148, 0.59], cl_alpha_per_deg: 0.1175, alpha_zero_lift_deg: -4.01, cm_c4_at_cl_cruise: -0.1065, cm_c4_at_cl_loiter: -0.1081, cd_at_cl_cruise: 0.00594,
          cd_at_cl_loiter: 0.00668, cd_at_cl_1p1: 0.00766, cd_at_cl_1p3: 0.00945, l_over_d_at_cl_cruise: 101.0, l_over_d_at_cl_loiter: 134.7, l_over_d_max: 143.6,
          cl_at_l_over_d_max: 1.104, endurance_cl15_over_cd_max: 157.5, cl_at_endurance_max: 1.388, xtr_upper_at_cl_cruise: 0.431, xtr_lower_at_cl_cruise: 0.629,
          post_stall_cl_ratio_at_alpha_clmax_plus3deg: 0.966, analysis_confidence_min_prestall: 0.937}
      ncrit5:
        Re_0.8e6: {cl_max: 1.613, alpha_cl_max_deg: 14.25, cl_max_beyond_22deg: false, cl_max_within_alpha_m4_16deg: 1.613, cd_min: 0.00744, cl_at_cd_min: 0.213,
          drag_bucket_cl_range: [0.097, 0.537], cl_alpha_per_deg: 0.1162, alpha_zero_lift_deg: -3.86, cm_c4_at_cl_cruise: -0.1011, cm_c4_at_cl_loiter: -0.1023, cd_at_cl_cruise: 0.00827,
          cd_at_cl_loiter: 0.00921, cd_at_cl_1p1: 0.01043, cd_at_cl_1p3: 0.01291, l_over_d_at_cl_cruise: 72.5, l_over_d_at_cl_loiter: 97.7, l_over_d_max: 105.5, cl_at_l_over_d_max: 1.124,
          endurance_cl15_over_cd_max: 114.9, cl_at_endurance_max: 1.295, xtr_upper_at_cl_cruise: 0.439, xtr_lower_at_cl_cruise: 0.641, post_stall_cl_ratio_at_alpha_clmax_plus3deg: 0.972,
          analysis_confidence_min_prestall: 0.942}
        Re_1.5e6: {cl_max: 1.691, alpha_cl_max_deg: 15.5, cl_max_beyond_22deg: false, cl_max_within_alpha_m4_16deg: 1.691, cd_min: 0.00644, cl_at_cd_min: 0.342, drag_bucket_cl_range: [
            0.196, 0.667], cl_alpha_per_deg: 0.1169, alpha_zero_lift_deg: -3.94, cm_c4_at_cl_cruise: -0.1042, cm_c4_at_cl_loiter: -0.1055, cd_at_cl_cruise: 0.0069,
          cd_at_cl_loiter: 0.00788, cd_at_cl_1p1: 0.00925, cd_at_cl_1p3: 0.0113, l_over_d_at_cl_cruise: 87.0, l_over_d_at_cl_loiter: 114.2, l_over_d_max: 119.1, cl_at_l_over_d_max: 1.059,
          endurance_cl15_over_cd_max: 131.5, cl_at_endurance_max: 1.339, xtr_upper_at_cl_cruise: 0.409, xtr_lower_at_cl_cruise: 0.625, post_stall_cl_ratio_at_alpha_clmax_plus3deg: 0.97,
          analysis_confidence_min_prestall: 0.952}
        Re_2.5e6: {cl_max: 1.762, alpha_cl_max_deg: 16.0, cl_max_beyond_22deg: false, cl_max_within_alpha_m4_16deg: 1.762, cd_min: 0.00589, cl_at_cd_min: 0.44, drag_bucket_cl_range: [
            0.264, 0.704], cl_alpha_per_deg: 0.1165, alpha_zero_lift_deg: -4.02, cm_c4_at_cl_cruise: -0.1063, cm_c4_at_cl_loiter: -0.1072, cd_at_cl_cruise: 0.00616,
          cd_at_cl_loiter: 0.00724, cd_at_cl_1p1: 0.00858, cd_at_cl_1p3: 0.01036, l_over_d_at_cl_cruise: 97.5, l_over_d_at_cl_loiter: 124.2, l_over_d_max: 128.2,
          cl_at_l_over_d_max: 1.12, endurance_cl15_over_cd_max: 143.2, cl_at_endurance_max: 1.328, xtr_upper_at_cl_cruise: 0.384, xtr_lower_at_cl_cruise: 0.61, post_stall_cl_ratio_at_alpha_clmax_plus3deg: 0.971,
          analysis_confidence_min_prestall: 0.942}
      tripped:
        Re_0.8e6: {cl_max: 1.635, alpha_cl_max_deg: 14.25, cl_max_beyond_22deg: false, cl_max_within_alpha_m4_16deg: 1.635, cd_min: 0.01223, cl_at_cd_min: 0.125,
          drag_bucket_cl_range: [-0.049, 0.746], cl_alpha_per_deg: 0.1125, alpha_zero_lift_deg: -3.64, cm_c4_at_cl_cruise: -0.0921, cm_c4_at_cl_loiter: -0.0922, cd_at_cl_cruise: 0.01297,
          cd_at_cl_loiter: 0.01403, cd_at_cl_1p1: 0.01503, cd_at_cl_1p3: 0.01659, l_over_d_at_cl_cruise: 46.3, l_over_d_at_cl_loiter: 64.1, l_over_d_max: 78.8, cl_at_l_over_d_max: 1.361,
          endurance_cl15_over_cd_max: 94.0, cl_at_endurance_max: 1.463, xtr_upper_at_cl_cruise: 0.074, xtr_lower_at_cl_cruise: 0.078, post_stall_cl_ratio_at_alpha_clmax_plus3deg: 0.964,
          analysis_confidence_min_prestall: 0.947}
        Re_1.5e6: {cl_max: 1.709, alpha_cl_max_deg: 15.25, cl_max_beyond_22deg: false, cl_max_within_alpha_m4_16deg: 1.709, cd_min: 0.01083, cl_at_cd_min: 0.137,
          drag_bucket_cl_range: [-0.037, 0.764], cl_alpha_per_deg: 0.1135, alpha_zero_lift_deg: -3.73, cm_c4_at_cl_cruise: -0.0955, cm_c4_at_cl_loiter: -0.0964, cd_at_cl_cruise: 0.01144,
          cd_at_cl_loiter: 0.01228, cd_at_cl_1p1: 0.01302, cd_at_cl_1p3: 0.01406, l_over_d_at_cl_cruise: 52.5, l_over_d_at_cl_loiter: 73.3, l_over_d_max: 95.7, cl_at_l_over_d_max: 1.47,
          endurance_cl15_over_cd_max: 117.6, cl_at_endurance_max: 1.534, xtr_upper_at_cl_cruise: 0.075, xtr_lower_at_cl_cruise: 0.08, post_stall_cl_ratio_at_alpha_clmax_plus3deg: 0.962,
          analysis_confidence_min_prestall: 0.921}
        Re_2.5e6: {cl_max: 1.766, alpha_cl_max_deg: 16.0, cl_max_beyond_22deg: false, cl_max_within_alpha_m4_16deg: 1.766, cd_min: 0.00986, cl_at_cd_min: 0.117, drag_bucket_cl_range: [
            -0.028, 0.776], cl_alpha_per_deg: 0.1142, alpha_zero_lift_deg: -3.8, cm_c4_at_cl_cruise: -0.098, cm_c4_at_cl_loiter: -0.0992, cd_at_cl_cruise: 0.01039,
          cd_at_cl_loiter: 0.0111, cd_at_cl_1p1: 0.01172, cd_at_cl_1p3: 0.01253, l_over_d_at_cl_cruise: 57.8, l_over_d_at_cl_loiter: 81.1, l_over_d_max: 109.4, cl_at_l_over_d_max: 1.499,
          endurance_cl15_over_cd_max: 134.5, cl_at_endurance_max: 1.522, xtr_upper_at_cl_cruise: 0.075, xtr_lower_at_cl_cruise: 0.082, post_stall_cl_ratio_at_alpha_clmax_plus3deg: 0.967,
          analysis_confidence_min_prestall: 0.877}
    model_size_check_Re_1.5e6_ncrit9:
      cl_max: {large: 1.714, xlarge: 1.706}
      cd_min: {large: 0.006, xlarge: 0.00602}
      cm_c4_at_cl_cruise: {large: -0.1043, xlarge: -0.1047}
      l_over_d_max: {large: 131.7, xlarge: 130.3}
  fx63137:
    name: Wortmann FX 63-137
    group: wing
    tag: estimate
    source: https://github.com/peterdsharpe/NeuralFoil
    coordinate_source: uiuc
    file: ucav250/data/airfoils/fx63137.dat
    uiuc_url: https://m-selig.ae.illinois.edu/ads/coord/fx63137.dat
    title: WORTMANN FX 63-137 AIRFOIL
    why_included: task candidate
    geometry: {t_over_c: 0.1372, x_t_max_over_c: 0.299, camber_over_c: 0.0597, x_camber_max_over_c: 0.551, t_at_x0p25_over_c: 0.1356, t_at_x0p30_over_c: 0.1372, t_at_x0p65_over_c: 0.0741,
      t_at_x0p90_over_c: 0.0121, te_thickness_over_c: -0.0, area_over_c2: 0.0832, box_area_x0p20_x0p65_over_c2: 0.0532, y_upper_at_x0p0125_percent_c: 3.13, n_points: 97}
    gault_stall_type_Re_1_3e6: trailing-edge
    kulfan_fit_max_dy_over_c: 0.00082
    polars:
      ncrit9:
        Re_0.8e6: {cl_max: 1.867, alpha_cl_max_deg: 12.75, cl_max_beyond_22deg: false, cl_max_within_alpha_m4_16deg: 1.867, cd_min: 0.00704, cl_at_cd_min: 0.69, drag_bucket_cl_range: [
            0.558, 0.974], cl_alpha_per_deg: 0.1107, alpha_zero_lift_deg: -8.53, cm_c4_at_cl_cruise: -0.2115, cm_c4_at_cl_loiter: -0.2141, cd_at_cl_cruise: 0.00728,
          cd_at_cl_loiter: 0.00757, cd_at_cl_1p1: 0.00808, cd_at_cl_1p3: 0.00901, l_over_d_at_cl_cruise: 82.4, l_over_d_at_cl_loiter: 118.9, l_over_d_max: 144.7,
          cl_at_l_over_d_max: 1.357, endurance_cl15_over_cd_max: 173.0, cl_at_endurance_max: 1.484, xtr_upper_at_cl_cruise: 0.72, xtr_lower_at_cl_cruise: 0.285, post_stall_cl_ratio_at_alpha_clmax_plus3deg: 0.977,
          analysis_confidence_min_prestall: 0.952}
        Re_1.5e6: {cl_max: 1.882, alpha_cl_max_deg: 14.25, cl_max_beyond_22deg: false, cl_max_within_alpha_m4_16deg: 1.882, cd_min: 0.00606, cl_at_cd_min: 0.727,
          drag_bucket_cl_range: [0.598, 1.015], cl_alpha_per_deg: 0.1121, alpha_zero_lift_deg: -8.54, cm_c4_at_cl_cruise: -0.212, cm_c4_at_cl_loiter: -0.2164, cd_at_cl_cruise: 0.00653,
          cd_at_cl_loiter: 0.00638, cd_at_cl_1p1: 0.0069, cd_at_cl_1p3: 0.00775, l_over_d_at_cl_cruise: 91.8, l_over_d_at_cl_loiter: 141.1, l_over_d_max: 167.8, cl_at_l_over_d_max: 1.32,
          endurance_cl15_over_cd_max: 196.8, cl_at_endurance_max: 1.425, xtr_upper_at_cl_cruise: 0.688, xtr_lower_at_cl_cruise: 0.188, post_stall_cl_ratio_at_alpha_clmax_plus3deg: 0.984,
          analysis_confidence_min_prestall: 0.935}
        Re_2.5e6: {cl_max: 1.939, alpha_cl_max_deg: 15.0, cl_max_beyond_22deg: false, cl_max_within_alpha_m4_16deg: 1.939, cd_min: 0.00556, cl_at_cd_min: 0.794, drag_bucket_cl_range: [
            0.635, 1.026], cl_alpha_per_deg: 0.1128, alpha_zero_lift_deg: -8.57, cm_c4_at_cl_cruise: -0.2124, cm_c4_at_cl_loiter: -0.2183, cd_at_cl_cruise: 0.00615,
          cd_at_cl_loiter: 0.00571, cd_at_cl_1p1: 0.00627, cd_at_cl_1p3: 0.00714, l_over_d_at_cl_cruise: 97.5, l_over_d_at_cl_loiter: 157.6, l_over_d_max: 182.3,
          cl_at_l_over_d_max: 1.276, endurance_cl15_over_cd_max: 209.9, cl_at_endurance_max: 1.383, xtr_upper_at_cl_cruise: 0.658, xtr_lower_at_cl_cruise: 0.117,
          post_stall_cl_ratio_at_alpha_clmax_plus3deg: 0.979, analysis_confidence_min_prestall: 0.913}
      ncrit5:
        Re_0.8e6: {cl_max: 1.821, alpha_cl_max_deg: 13.0, cl_max_beyond_22deg: false, cl_max_within_alpha_m4_16deg: 1.821, cd_min: 0.00759, cl_at_cd_min: 0.765, drag_bucket_cl_range: [
            0.576, 1.022], cl_alpha_per_deg: 0.1111, alpha_zero_lift_deg: -8.41, cm_c4_at_cl_cruise: -0.2069, cm_c4_at_cl_loiter: -0.2118, cd_at_cl_cruise: 0.00819,
          cd_at_cl_loiter: 0.00793, cd_at_cl_1p1: 0.00865, cd_at_cl_1p3: 0.00977, l_over_d_at_cl_cruise: 73.3, l_over_d_at_cl_loiter: 113.5, l_over_d_max: 133.0,
          cl_at_l_over_d_max: 1.293, endurance_cl15_over_cd_max: 154.8, cl_at_endurance_max: 1.395, xtr_upper_at_cl_cruise: 0.662, xtr_lower_at_cl_cruise: 0.153,
          post_stall_cl_ratio_at_alpha_clmax_plus3deg: 0.986, analysis_confidence_min_prestall: 0.958}
        Re_1.5e6: {cl_max: 1.881, alpha_cl_max_deg: 14.75, cl_max_beyond_22deg: false, cl_max_within_alpha_m4_16deg: 1.881, cd_min: 0.00675, cl_at_cd_min: 0.805,
          drag_bucket_cl_range: [0.587, 1.036], cl_alpha_per_deg: 0.1121, alpha_zero_lift_deg: -8.44, cm_c4_at_cl_cruise: -0.2082, cm_c4_at_cl_loiter: -0.2143, cd_at_cl_cruise: 0.00736,
          cd_at_cl_loiter: 0.00688, cd_at_cl_1p1: 0.00762, cd_at_cl_1p3: 0.0088, l_over_d_at_cl_cruise: 81.5, l_over_d_at_cl_loiter: 130.8, l_over_d_max: 148.3, cl_at_l_over_d_max: 1.255,
          endurance_cl15_over_cd_max: 169.9, cl_at_endurance_max: 1.361, xtr_upper_at_cl_cruise: 0.623, xtr_lower_at_cl_cruise: 0.086, post_stall_cl_ratio_at_alpha_clmax_plus3deg: 0.981,
          analysis_confidence_min_prestall: 0.939}
        Re_2.5e6: {cl_max: 1.947, alpha_cl_max_deg: 15.25, cl_max_beyond_22deg: false, cl_max_within_alpha_m4_16deg: 1.947, cd_min: 0.00635, cl_at_cd_min: 0.842,
          drag_bucket_cl_range: [0.472, 1.072], cl_alpha_per_deg: 0.1126, alpha_zero_lift_deg: -8.47, cm_c4_at_cl_cruise: -0.2098, cm_c4_at_cl_loiter: -0.2159, cd_at_cl_cruise: 0.00678,
          cd_at_cl_loiter: 0.00639, cd_at_cl_1p1: 0.00708, cd_at_cl_1p3: 0.00836, l_over_d_at_cl_cruise: 88.5, l_over_d_at_cl_loiter: 140.9, l_over_d_max: 157.2,
          cl_at_l_over_d_max: 1.21, endurance_cl15_over_cd_max: 178.2, cl_at_endurance_max: 1.37, xtr_upper_at_cl_cruise: 0.587, xtr_lower_at_cl_cruise: 0.058, post_stall_cl_ratio_at_alpha_clmax_plus3deg: 0.98,
          analysis_confidence_min_prestall: 0.92}
      tripped:
        Re_0.8e6: {cl_max: 1.864, alpha_cl_max_deg: 13.5, cl_max_beyond_22deg: false, cl_max_within_alpha_m4_16deg: 1.864, cd_min: 0.01213, cl_at_cd_min: 0.462, drag_bucket_cl_range: [
            0.401, 0.838], cl_alpha_per_deg: 0.109, alpha_zero_lift_deg: -7.92, cm_c4_at_cl_cruise: -0.197, cm_c4_at_cl_loiter: -0.1982, cd_at_cl_cruise: 0.01243,
          cd_at_cl_loiter: 0.01351, cd_at_cl_1p1: 0.01455, cd_at_cl_1p3: 0.01596, l_over_d_at_cl_cruise: 48.3, l_over_d_at_cl_loiter: 66.6, l_over_d_max: 83.2, cl_at_l_over_d_max: 1.453,
          endurance_cl15_over_cd_max: 102.0, cl_at_endurance_max: 1.556, xtr_upper_at_cl_cruise: 0.067, xtr_lower_at_cl_cruise: 0.089, post_stall_cl_ratio_at_alpha_clmax_plus3deg: 0.974,
          analysis_confidence_min_prestall: 0.958}
        Re_1.5e6: {cl_max: 1.887, alpha_cl_max_deg: 14.25, cl_max_beyond_22deg: false, cl_max_within_alpha_m4_16deg: 1.887, cd_min: 0.01069, cl_at_cd_min: 0.481,
          drag_bucket_cl_range: [0.42, 0.831], cl_alpha_per_deg: 0.1106, alpha_zero_lift_deg: -8.01, cm_c4_at_cl_cruise: -0.201, cm_c4_at_cl_loiter: -0.2025, cd_at_cl_cruise: 0.01094,
          cd_at_cl_loiter: 0.01194, cd_at_cl_1p1: 0.01277, cd_at_cl_1p3: 0.0138, l_over_d_at_cl_cruise: 54.9, l_over_d_at_cl_loiter: 75.4, l_over_d_max: 98.8, cl_at_l_over_d_max: 1.537,
          endurance_cl15_over_cd_max: 124.8, cl_at_endurance_max: 1.662, xtr_upper_at_cl_cruise: 0.068, xtr_lower_at_cl_cruise: 0.091, post_stall_cl_ratio_at_alpha_clmax_plus3deg: 0.983,
          analysis_confidence_min_prestall: 0.941}
        Re_2.5e6: {cl_max: 1.941, alpha_cl_max_deg: 15.0, cl_max_beyond_22deg: false, cl_max_within_alpha_m4_16deg: 1.941, cd_min: 0.00978, cl_at_cd_min: 0.494, drag_bucket_cl_range: [
            0.433, 0.845], cl_alpha_per_deg: 0.1117, alpha_zero_lift_deg: -8.06, cm_c4_at_cl_cruise: -0.2038, cm_c4_at_cl_loiter: -0.2054, cd_at_cl_cruise: 0.00994,
          cd_at_cl_loiter: 0.01089, cd_at_cl_1p1: 0.01158, cd_at_cl_1p3: 0.01239, l_over_d_at_cl_cruise: 60.4, l_over_d_at_cl_loiter: 82.7, l_over_d_max: 112.1, cl_at_l_over_d_max: 1.613,
          endurance_cl15_over_cd_max: 144.9, cl_at_endurance_max: 1.699, xtr_upper_at_cl_cruise: 0.068, xtr_lower_at_cl_cruise: 0.089, post_stall_cl_ratio_at_alpha_clmax_plus3deg: 0.978,
          analysis_confidence_min_prestall: 0.92}
    model_size_check_Re_1.5e6_ncrit9:
      cl_max: {large: 1.882, xlarge: 1.873}
      cd_min: {large: 0.00606, xlarge: 0.00616}
      cm_c4_at_cl_cruise: {large: -0.212, xlarge: -0.211}
      l_over_d_max: {large: 167.8, xlarge: 164.1}
  e1210:
    name: Eppler E1210
    group: wing
    tag: estimate
    source: https://github.com/peterdsharpe/NeuralFoil
    coordinate_source: uiuc
    file: ucav250/data/airfoils/e1210.dat
    uiuc_url: https://m-selig.ae.illinois.edu/ads/coord/e1210.dat
    title: EPPLER 1210 AIRFOIL
    why_included: task candidate
    geometry: {t_over_c: 0.1586, x_t_max_over_c: 0.224, camber_over_c: 0.052, x_camber_max_over_c: 0.34, t_at_x0p25_over_c: 0.1577, t_at_x0p30_over_c: 0.1536, t_at_x0p65_over_c: 0.0786,
      t_at_x0p90_over_c: 0.0206, te_thickness_over_c: -0.0, area_over_c2: 0.0958, box_area_x0p20_x0p65_over_c2: 0.0575, y_upper_at_x0p0125_percent_c: 3.46, n_points: 61}
    gault_stall_type_Re_1_3e6: trailing-edge
    kulfan_fit_max_dy_over_c: 0.00039
    polars:
      ncrit9:
        Re_0.8e6: {cl_max: 1.873, alpha_cl_max_deg: 16.25, cl_max_beyond_22deg: false, cl_max_within_alpha_m4_16deg: 1.872, cd_min: 0.00917, cl_at_cd_min: 0.835,
          drag_bucket_cl_range: [0.169, 1.088], cl_alpha_per_deg: 0.1123, alpha_zero_lift_deg: -4.74, cm_c4_at_cl_cruise: -0.0903, cm_c4_at_cl_loiter: -0.0881, cd_at_cl_cruise: 0.01001,
          cd_at_cl_loiter: 0.00926, cd_at_cl_1p1: 0.01015, cd_at_cl_1p3: 0.01169, l_over_d_at_cl_cruise: 60.0, l_over_d_at_cl_loiter: 97.1, l_over_d_max: 111.2, cl_at_l_over_d_max: 1.315,
          endurance_cl15_over_cd_max: 133.9, cl_at_endurance_max: 1.547, xtr_upper_at_cl_cruise: 0.371, xtr_lower_at_cl_cruise: 0.233, post_stall_cl_ratio_at_alpha_clmax_plus3deg: 0.959,
          analysis_confidence_min_prestall: 0.953}
        Re_1.5e6: {cl_max: 1.997, alpha_cl_max_deg: 16.75, cl_max_beyond_22deg: false, cl_max_within_alpha_m4_16deg: 1.986, cd_min: 0.00798, cl_at_cd_min: 0.932,
          drag_bucket_cl_range: [0.116, 1.162], cl_alpha_per_deg: 0.1126, alpha_zero_lift_deg: -4.82, cm_c4_at_cl_cruise: -0.0923, cm_c4_at_cl_loiter: -0.0877, cd_at_cl_cruise: 0.00861,
          cd_at_cl_loiter: 0.00804, cd_at_cl_1p1: 0.00844, cd_at_cl_1p3: 0.00956, l_over_d_at_cl_cruise: 69.7, l_over_d_at_cl_loiter: 111.9, l_over_d_max: 136.5,
          cl_at_l_over_d_max: 1.388, endurance_cl15_over_cd_max: 169.2, cl_at_endurance_max: 1.652, xtr_upper_at_cl_cruise: 0.344, xtr_lower_at_cl_cruise: 0.199,
          post_stall_cl_ratio_at_alpha_clmax_plus3deg: 0.942, analysis_confidence_min_prestall: 0.917}
        Re_2.5e6: {cl_max: 2.085, alpha_cl_max_deg: 17.25, cl_max_beyond_22deg: false, cl_max_within_alpha_m4_16deg: 2.058, cd_min: 0.00735, cl_at_cd_min: 1.025,
          drag_bucket_cl_range: [0.089, 1.231], cl_alpha_per_deg: 0.1131, alpha_zero_lift_deg: -4.86, cm_c4_at_cl_cruise: -0.0935, cm_c4_at_cl_loiter: -0.0912, cd_at_cl_cruise: 0.00774,
          cd_at_cl_loiter: 0.00778, cd_at_cl_1p1: 0.0075, cd_at_cl_1p3: 0.00838, l_over_d_at_cl_cruise: 77.5, l_over_d_at_cl_loiter: 115.7, l_over_d_max: 156.4, cl_at_l_over_d_max: 1.431,
          endurance_cl15_over_cd_max: 197.1, cl_at_endurance_max: 1.7, xtr_upper_at_cl_cruise: 0.324, xtr_lower_at_cl_cruise: 0.176, post_stall_cl_ratio_at_alpha_clmax_plus3deg: 0.925,
          analysis_confidence_min_prestall: 0.884}
      ncrit5:
        Re_0.8e6: {cl_max: 1.848, alpha_cl_max_deg: 15.75, cl_max_beyond_22deg: false, cl_max_within_alpha_m4_16deg: 1.848, cd_min: 0.00994, cl_at_cd_min: 0.97, drag_bucket_cl_range: [
            0.08, 1.165], cl_alpha_per_deg: 0.1109, alpha_zero_lift_deg: -4.78, cm_c4_at_cl_cruise: -0.0895, cm_c4_at_cl_loiter: -0.0845, cd_at_cl_cruise: 0.01024,
          cd_at_cl_loiter: 0.0101, cd_at_cl_1p1: 0.01043, cd_at_cl_1p3: 0.01181, l_over_d_at_cl_cruise: 58.6, l_over_d_at_cl_loiter: 89.1, l_over_d_max: 110.2, cl_at_l_over_d_max: 1.336,
          endurance_cl15_over_cd_max: 132.5, cl_at_endurance_max: 1.521, xtr_upper_at_cl_cruise: 0.329, xtr_lower_at_cl_cruise: 0.182, post_stall_cl_ratio_at_alpha_clmax_plus3deg: 0.95,
          analysis_confidence_min_prestall: 0.894}
        Re_1.5e6: {cl_max: 1.956, alpha_cl_max_deg: 16.25, cl_max_beyond_22deg: false, cl_max_within_alpha_m4_16deg: 1.955, cd_min: 0.00885, cl_at_cd_min: 0.455,
          drag_bucket_cl_range: [0.082, 1.265], cl_alpha_per_deg: 0.1127, alpha_zero_lift_deg: -4.79, cm_c4_at_cl_cruise: -0.0915, cm_c4_at_cl_loiter: -0.0897, cd_at_cl_cruise: 0.00891,
          cd_at_cl_loiter: 0.00937, cd_at_cl_1p1: 0.00895, cd_at_cl_1p3: 0.00989, l_over_d_at_cl_cruise: 67.3, l_over_d_at_cl_loiter: 96.0, l_over_d_max: 132.2, cl_at_l_over_d_max: 1.387,
          endurance_cl15_over_cd_max: 163.1, cl_at_endurance_max: 1.623, xtr_upper_at_cl_cruise: 0.305, xtr_lower_at_cl_cruise: 0.151, post_stall_cl_ratio_at_alpha_clmax_plus3deg: 0.933,
          analysis_confidence_min_prestall: 0.847}
        Re_2.5e6: {cl_max: 2.022, alpha_cl_max_deg: 16.5, cl_max_beyond_22deg: false, cl_max_within_alpha_m4_16deg: 2.017, cd_min: 0.00804, cl_at_cd_min: 0.462, drag_bucket_cl_range: [
            0.084, 1.306], cl_alpha_per_deg: 0.1136, alpha_zero_lift_deg: -4.82, cm_c4_at_cl_cruise: -0.0927, cm_c4_at_cl_loiter: -0.0913, cd_at_cl_cruise: 0.00809,
          cd_at_cl_loiter: 0.00855, cd_at_cl_1p1: 0.00845, cd_at_cl_1p3: 0.00881, l_over_d_at_cl_cruise: 74.2, l_over_d_at_cl_loiter: 105.2, l_over_d_max: 149.6,
          cl_at_l_over_d_max: 1.433, endurance_cl15_over_cd_max: 188.1, cl_at_endurance_max: 1.694, xtr_upper_at_cl_cruise: 0.29, xtr_lower_at_cl_cruise: 0.126, post_stall_cl_ratio_at_alpha_clmax_plus3deg: 0.922,
          analysis_confidence_min_prestall: 0.814}
      tripped:
        Re_0.8e6: {cl_max: 1.633, alpha_cl_max_deg: 15.0, cl_max_beyond_22deg: false, cl_max_within_alpha_m4_16deg: 1.633, cd_min: 0.01228, cl_at_cd_min: 0.173, drag_bucket_cl_range: [
            0.061, 0.669], cl_alpha_per_deg: 0.1088, alpha_zero_lift_deg: -4.63, cm_c4_at_cl_cruise: -0.0846, cm_c4_at_cl_loiter: -0.0805, cd_at_cl_cruise: 0.01314,
          cd_at_cl_loiter: 0.01454, cd_at_cl_1p1: 0.01589, cd_at_cl_1p3: 0.01786, l_over_d_at_cl_cruise: 45.7, l_over_d_at_cl_loiter: 61.9, l_over_d_max: 72.8, cl_at_l_over_d_max: 1.322,
          endurance_cl15_over_cd_max: 84.7, cl_at_endurance_max: 1.379, xtr_upper_at_cl_cruise: 0.078, xtr_lower_at_cl_cruise: 0.076, post_stall_cl_ratio_at_alpha_clmax_plus3deg: 0.984,
          analysis_confidence_min_prestall: 0.971}
        Re_1.5e6: {cl_max: 1.766, alpha_cl_max_deg: 15.75, cl_max_beyond_22deg: false, cl_max_within_alpha_m4_16deg: 1.766, cd_min: 0.01071, cl_at_cd_min: 0.151,
          drag_bucket_cl_range: [0.066, 0.682], cl_alpha_per_deg: 0.1101, alpha_zero_lift_deg: -4.69, cm_c4_at_cl_cruise: -0.0869, cm_c4_at_cl_loiter: -0.0835, cd_at_cl_cruise: 0.0115,
          cd_at_cl_loiter: 0.01265, cd_at_cl_1p1: 0.01369, cd_at_cl_1p3: 0.01506, l_over_d_at_cl_cruise: 52.2, l_over_d_at_cl_loiter: 71.1, l_over_d_max: 87.6, cl_at_l_over_d_max: 1.423,
          endurance_cl15_over_cd_max: 106.0, cl_at_endurance_max: 1.5, xtr_upper_at_cl_cruise: 0.078, xtr_lower_at_cl_cruise: 0.076, post_stall_cl_ratio_at_alpha_clmax_plus3deg: 0.967,
          analysis_confidence_min_prestall: 0.971}
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
