ahmet6141/Drone-controller/(commit log)

2026-10-02 Faz 0 (1/2): mimari, avuca iniş ve takip tasarımı, bütçe hesaplayıcısı
    - docs: gereksinimler, sistem mimarisi, avuca iniş tasarımı (FMEA, temas
    algılama, iptal mantığı), hedef takip tasarımı, yol haritası ve test planı
    - config/mission: davranış (avuca iniş, takip, gimbal) ve güvenlik sınırları
    - config/companion: mavlink-router ve netplan (Jetson) ayarları
    - tools/budget_calc.py: AUW, T/W (batarya akım sınırı dahil), hover gücü/süresi,
    MPC_THR_HOVER başlangıcı ve THR_MDL_FAC tahmini
    - tests/test_configs.py: hesaplayıcı ve konfigürasyon tutarlılık testleri
    Donanım profilleri, PX4/ArduPilot parametreleri ve YZ model seçimleri
    güncel araştırm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
2026-10-02 Faz 0 (2/2): güncel araştırma, donanım seviyeleri, PX4/ArduPilot ve YZ konfigürasyonları
    Araştırma (2 Ekim 2026 itibarıyla doğrulanmış kaynaklarla):
    - docs/02: gövde, itki (F90 ölçülmüş itki verisi), batarya, Jetson Orin/Thor,
    2026 taşıyıcı kartları, FC/ESC/akış/GNSS, kamera/ToF/stereo, linkler, tedarik riskleri
    - docs/03: YOLO26, RF-DETR, takip (BoT-SORT/OSNet, SOT), el/jest hattı (HaGRIDv2,
    MediaPipe), derinlik, cuVSLAM, edge VLM'ler ve lisans stratejisi (AGPL vs Apache)
    - docs/07: PX4 v1.17 profesyonel hover ayar rehberi ve kabul uçuşları
    - docs/08: yeni SHT-İHA (30.07.2026) madde bazında özet ve tasarım etkileri
    - docs/05: güvenlik bulgularıyla gün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
    [10-airframe-dc7.params, 20-position-control.params, 30-failsafe.params, 40-companion-io.params, dc7-copter-4.7.param, indoor-vio.params, outdoor-gnss.params]
2026-10-02 Ekonomik yaklaşım: Raspberry Pi kameraları, kendi gimbalımız, uygun fiyatlı sensörler
    - docs/10: Pi kameraları (resmi özellikler), kendi tasarımımız 2 eksen fırçasız gimbal
    (STorM32, tasarım kuralları, FFC yolu, parazit uyarısı), uygun fiyatlı lazer/akış/mesafe
    sensörleri (PX4 v1.17 / ArduPilot 4.7.1 sürücü desteği referanstan doğrulandı), 8×8 ToF'un
    çalışma prensibi ve geometrisi, drone boyutu (7 inç, ≈ 43 × 43 cm)
    - Seviye A artık "Ekonomik (Raspberry Pi)": Pi 5 + AI HAT+ 2 (Hailo-10H), Camera Module 3 +
    CM3 Wide, MTF-01, VL53L8CX → 1456 g, ≈ 20 dk hover, ≈ $1.480
    - Seviye B/C: Pi kamera (IMX219) + kendi gimbal; Pi kameraları için 22 pi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
    [10-airframe-dc7.params]
2026-10-02 Sensör kataloğu: alternatifler ve PX4/ArduPilot uyumluluk matrisi
    - config/sensors/catalog.yaml: 9 görev için 26 sensör seçeneği (akış, lazer
    irtifa, baş üstü, avuç ToF, termal doğrulama, engel, GNSS, pusula, Remote ID);
    her biri için arayüz, kütle, fiyat (doğrulanmış/doğrulanmamış), PX4 v1.17 ve
    ArduPilot 4.7.1 sürücü parametreleri, companion köprüsü (PX4 DDS girişleri)
    - tools/sensor_matrix.py: katalog doğrulaması (parametre adı, enum, seri port,
    SERIALn_PROTOCOL, seviye seçimi ↔ donanım profili), uyumluluk genişliği sayımı
    ve görev bazında Markdown tabloları
    - tools/validate_params.py: tek değer denetimi px4_value_errors /
    ap_value_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
2026-10-02 Bütçe kesinti senaryoları: 13 senaryo, 3 paket
    - config/budget/scenarios.yaml: Seviye A üzerine yamalar (Pi 5 4GB, AI HAT+
    26/13 TOPS, Pixhawk 6C Mini / Matek H743, servo tilt, Wi-Fi Ar-Ge linki,
    ESP32 Remote ID, kendi baskımız, GNSS, kumanda, batarya); her biri risk,
    kapsam (kalıcı / Ar-Ge), etki ve kaynakla
    - tools/scenarios.py: yamaları uygular (adjust/replace/remove, tekil eşleşme
    zorunlu, dışlayan senaryolar), budget_calc ile AUW, hover, T/W ve limitleri
    yeniden hesaplar; paketler: önerilen −$275, MVP −$543, en düşük −$694
    - tests/test_scenarios.py: limitler, güvenlik bileşenlerinin korunması,
    önerilen paketin düşük risk/kalıcı olması, hata d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
    [tier-a-ekonomik.yaml]
2026-10-02 Parametrik 3B modeller (CadQuery): koruma, avuç tutamağı, 2 eksen gimbal, üst katlar
    - cad/params.py: tüm ölçüler tek yerde (gövde, pervane, koruma, tutamak,
    kamera, gimbal, üst katlar, malzeme yoğunlukları)
    - cad/layout.py (yalnızca PyYAML): YAML kütlelerinden ağırlık merkezi,
    CG'yi ortalayan batarya konumu, devrilme açısı; gimbal/akış/yukarı ToF/aşağı
    kamera görüş alanı kontrolleri → gimbal yazılım sınırı +15°
    - cad/prop_guard.py: halka + ≤10 mm ağ (tablada desteksiz) ve X biçimli motor
    bağlantısı; 4 takım 97,6 g PA-CF (bütçe 110 g), ağ alan oranı %20
    - cad/palm_grip.py: pencereli tüp, 45° pahlı basamak, sensör tablası (tabanda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
    [battery_plate.stl, companion_tray.stl, gimbal_boom.stl, gimbal_cradle.stl, gimbal_roll_arm.stl, gimbal_top.stl, grip_bumper.stl, grip_sensor_mount.stl]
2026-10-02 Yazılım öncesi hazırlık: docs/11, itki standı aracı, Remote ID, README
    - docs/11-yazilim-oncesi-hazirlik.md: sensör alternatifleri, bütçe kesinti
    senaryoları ve paketleri, sensör uyumluluğunun genişliği (FC yerel sürücüleri,
    DroneCAN/MAVLink, ROS 2 → PX4 DDS köprüsü), 3B model yaklaşımı ve CAD araçları,
    modellerin yakaladığı tasarım sorunları, 12 maddelik hazırlık listesi
    - tools/thrust_stand.py: itki standı CSV → thrust_curve bloğu, THR_MDL_FAC,
    verim, korumalı/serbest ölçümden installation_factor, profile uygulanmış bütçe;
    şablon config/hardware/thrust/ornek-f90-hq7x4x3.csv (vekil eğriyi birebir üretir)
    - PX4 base/30-failsafe: COM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
    [30-failsafe.params, ornek-f90-hq7x4x3.csv]
2026-10-02 v1 prototip iyileştirmeleri: radyuslar, çan ağzı, tutamak beli, kabuk, titreşim analizi
    - Pervane koruması: dışa açılan yuvarlak kenarlı çan ağzı (rijit, güvenli kenar),
    direklerde konik ayak (gerilme yığılması); ağ 10 mm'ye indirildi (temsili kanat
    kesitleriyle kök boşluğu 2,5 mm — yeni yerleşim kuralı)
    - Avuç tutamağı: ergonomik bel, yuvarlak köşeli pencereler, avuca değen kenarı
    tam yuvarlak TPU tampon
    - Gimbal: radyuslu L kesitler, köşebentli üst parça, gövdeye geniş cıvata
    açıklıklı taşıyıcı kol (8 mm kaburga, cad/analysis.py ile seçildi)
    - İsteğe bağlı havalandırmalı companion kabuğu
    - cad/analysis.py: sönümleyici yalı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
    [companion_shell.stl, gimbal_boom.stl, gimbal_cradle.stl, gimbal_roll_arm.stl, gimbal_top.stl, grip_bumper.stl, grip_tube.stl, guard_mount.stl]
2026-10-03 v2 bütünleşik gövde: DJI tarzı, seri üretime uygun tasarım + Blender render hattı
    - cad/v2: kalıplanabilir kabuklar (üst kabuk, taşıyıcı alt kabuk, burun başlığı), tek kalıptan
    4 özdeş kol–kanal modülü (PA6-GF30, çan ağızlı kanal, bal peteği ızgara, radyal kaburgalar),
    burun başlığının altında gimbal + kamera başlığı, avuç ayağı, kuyruktan takılan akıllı batarya
    - layout_v2: bileşen yerleşimi, ağırlık merkezi için batarya konumu çözümü, 10 yerleşim kuralı
    - analysis_v2: kol titreşimi (Stodola), kesit taraması (22×34 mm kök: 216–327 Hz), düşme
    - build_v2: 20 CAD kontrolü (çakışma, gimbal hareket aralığı, en alçak n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
    [arm_duct.stl, battery_shell.stl, bottom_tub.stl, nose_cover.stl, pod.stl, pod_tip.stl, top_shell.stl]
2026-10-03 v2: pervane üstü koruma, motor çanı eteği, kısa avuç ayağı ve sensör camı
    - Üst ızgara (PC, çıkarılabilir, tek kalıp ×4): ≤ 10 mm bal peteği, göbekte somun kapağı,
    6 ayak + 3 geçme tırnak, ≈ 4 mm yan hava girişi; kanada 5,4 mm, somuna 3,8 mm
    - Motor çanı eteği (alt ızgaradan yuvaya, yarıklı): dönen çan yandan da kapalı
    - Tam kapalı pervane → ayak kuralı 120 → 100 mm (docs/05 H1); ayak 49 → 26 mm, Ø74 silindir,
    gimbal 10 mm yukarı (en alçak nokta hâlâ ayak), avuçta devrilme 20° → 27,8°
    - Sensörler tabandan 22 mm, IR geçirgen camın arkasında; görüş açısı, ölü bölge ve Pi/batarya
    boşluğu kontrolleri; kol kökü 35 mm (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
    [arm_duct.stl, battery_shell.stl, bottom_tub.stl, nose_cover.stl, pod.stl, pod_tip.stl, sensor_window.stl, top_grille.stl]
2026-10-03 v2: gimbal burnun ortasında, sarkmıyor — dışta pitch, içte roll; ağızlı iki yarım burun
    - cad/v2/gimbal_v2.py (yeni): kamera kapsülü (başlık + beşik + eş eksenli roll motoru + U çerçeve)
    burun yanakları arasında pitch ekseninde döner; pitch motoru sağ, 685 rulman sol yanakta; sönümlü
    U taşıyıcı burun perdesine 4 sönümleyiciyle bağlı. Pitch ekseni kapsülün ağırlık merkezinde
    (kartın 10,0 mm arkası), roll grubu optik eksende (0,02 mm): karşı ağırlık yok.
    - Burun: kamera ağzı (süpürme 22,1 mm + ≥ 2 mm pay), siyah astar (2K), motor/pim geçişleri;
    iki yarım (ayrım = pitch ekseni, z = −9), alt yarıda 1,2 mm perde + cıvata pulları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
    [battery_shell.stl, bottom_tub.stl, camera_housing.stl, gimbal_bracket.stl, gimbal_cradle.stl, gimbal_frame.stl, nose_chin.stl, nose_cover.stl]
2026-10-03 v2 gövde: tek parça okunan açık palet, bal peteği havalandırma, ayrım çizgileri, ürün ayrıntıları
    - CMF: açık gri kol–kanal modülleri + beyaz-gri gövde (tek ürün), grafit ızgara/ayak/batarya,
    siyah vurgular (ağız astarı, kanopi vizörü); turuncu yalnızca güvenlik vurgusu.
    - Havalandırma: kanopide 2K parlak siyah vizör (ToF penceresi + bal peteği çıkış), tabanda iki çukur
    bal peteği emiş paneli; yan yarıklar kalktı → alt kalıpta kayar maça yok.
    - Kamera ağzı: üst köşeler R4, kenarda pah (kalıplanmış dudak).
    - Ayrım çizgileri: gövde, burun yarıları, burun ve batarya ek yerlerinde 0,8 × 0,4 mm kanal.
    - Ayrıntılar: kanopide "DC7" (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
    [battery_shell.stl, bottom_tub.stl, nose_chin.stl, nose_cover.stl, pod.stl, top_shell.stl]
2026-10-03 docs/12: Türkiye'de maliyet (TL) bölümü, avuç ayağı kısa cevabı, güncel sayılar
    - §5.3 Türkiye'de maliyet (3 Ekim 2026, 1 USD = 49,14 TL): vergisiz kur çevirisi,
    AB (%30) / AB dışı (%60) götürü vergili sipariş ve yurt içi perakende senaryoları;
    en pahalı kalemler, yetenek kaybı olmadan ucuzlatma ve kalıpların TL karşılığı.
    EVT → DVT → PVT bölümü §5.4 oldu.
    - Kısa cevaplara "Alttaki yuvarlak kısım ne işe yarıyor?" ve "Türkiye'de kaça mal olur?"
    - Güncel değerler: avuçta devrilme 27,4°, prototip seti ≈ 468 cm³ (473 ↔ 588 g),
    §10'daki MJF seti fiyatı §5.2 ile aynı (≈ $270).
    - tier-a-entegre: Pi + AI HAT+ 2 fiyat dayanağı te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
2026-10-03 Seviye A port planı (ARK FPV) ve Pi Zero 2 W değerlendirmesi
    - config/px4/README.md: ARK FPV seri port planı. Kartta 4 çift yönlü UART var
    (GPS1, RC, TELEM1, TELEM2); TELEM3/TELEM4 yalnız RX. MTF-01 yalnızca veri
    gönderdiği için TELEM4'e (MAV_1_CONFIG=104) bağlanır. Remote ID'ye seri port
    kalmadığından CAN'e (DroneCAN) alınır. Kaynak: PX4 v1.17 kart tanımı, ArduPilot
    ARK FPV sayfası, PX4 Remote ID belgesi.
    - base/40-companion-io.params: Seviye A'da UAVCAN_ENABLE Remote ID için kalır;
    eskimiş SIYI A8 mini gimbal yorumu güncellendi (kendi gimbalımız, STorM32).
    - sensors/catalog.yaml: MTF-01 ve Remote ID notlarına ARK FPV port durumu.
    - docs/02: companion t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
    [40-companion-io.params]
2026-10-04 ucav: YELKOVAN YK-38 — benzinli, UCAV görünümlü İHA projesi (ilk sürüm, kod)
    Yeni alt proje: ucav/. Tasarım paneli (3 konsept, 3 jüri, sentez, bağımsız
    doğrulama) sonucu YK-38: 3,80 m açıklık, 2,475 m boy, DLE-20 itici, oklu
    U-kuyruk, elektrikli üçlü iniş takımı, EO/IR çene tareti; MTOW 11,7 kg.
    Silah/mühimmat entegrasyonu kapsam dışı.
    - spec.yaml (tek doğruluk kaynağı), params.py, airfoils.py (UIUC SD7062/SD7032),
    sizing.py (150 kontrol)
    - Blender (bpy 4.5): airframe, gear, rig (U_Root kontrol paneli + sürücüler),
    animation (showcase, mechanisms), materials (standart/taktik), studio, render,
    printprep (bed'e sığan kapalı STL segmentleri + rapor),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
2026-10-04 ucav: YK-38 ilk sürüm çıktıları (render, animasyon önizlemesi, STL, raporlar)
    - out/render: 13 render (standart, taktik, stüdyo)
    - out/anim: showcase.mp4 ve mechanisms.mp4 (960×540 önizleme)
    - out/stl: 256 mm tabla için 55 benzersiz parça (89 adet, ≈3,6 kg), hepsi kapalı katı
    - print_report.md/json, print_220x220x250 raporu, sizing.md
    İyileştirme turu sürüyor; çıktılar yenilenecek.
    Claude-Session: https://claude.ai/code/session_01Y4cGX2WtdBeJsbfiaZJyLG
    [aileron_1.stl, aileron_2.stl, aileron_3.stl, aileron_4.stl, cowl_cheek_L.stl, cowl_cheek_R.stl, cowl_top.stl, door_L_1.stl]
2026-10-04 ucav: iyileştirme turu ara kaydı (geometri ve görünüm düzeltmeleri; animasyon sürüyor)
    - Geometri: motor ters (silindir aşağı) → arka gövde kamburu kalktı; karın altında
    gömme NACA girişi; iniş takımı kapakları ve kuyular yeniden yapıldı (pan + çerçeve,
    menteşe, contalar); burun takımı geriye + iz; stabilize kirişi uyumu; düz longeronlar;
    hücum kenarı aşınma şeridi; 29 stencil işareti; motor zarfı kontrolleri.
    - Görünüm: taktik şema gerçekten koyu gri; kuyu/kapak içleri astar rengi (parlama yok);
    taret halkaları artık parlamıyor; panel çizgileri, servo kapakları; stüdyo ışığı ve
    ortografik yan görünüş.
    - Animasyon/rig düz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
    [airframe.py, animation.py, gear.py, materials.py, params.py, render.py, rig.py]
2026-10-04 ucav: YK-38 iyileştirme turu 2 — rig/animasyon, baskı, entegrasyon, yeni çıktılar
    - Rig: 8 kumanda bağlantısı (boynuz, servo kolu, itme çubuğu), status_led, birim
    parent-inverse, pervane diski; 58 basit ifade sürücüsü.
    - Animasyon: showcase 21 s (kurulum çekimi + kanatçık/flap/kuyruk yakın planları,
    takım ≈2,8 m'de toplanıyor), mechanisms 16 s döngü (bakım sehpası).
    - Baskı: menteşe pimleri, delik toleransları + kupon, yük yolu parçaları (kanat kutusu,
    takım yatakları, motor halkası), ısı kuralı, tabla desteği sınıflaması, kaporta
    kalıbı; 65 benzersiz STL / 104 parça, 4,06 kg, ≈292 h; hepsi kapalı ve sığıyor.
    - Entegrasyon: spec t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
    [aileron_1.stl, aileron_2.stl, aileron_3.stl, aileron_4.stl, cowl_cheek_L.stl, cowl_cheek_R.stl, cowl_top.stl, door_L_1.stl]
2026-10-04 ucav: YK-38 tur 3 — kaporta/motor, susturucu, baskı kütlesi, görünüm düzeltmeleri
    - R01 kaporta: 1,6 mm PA-CF kabuk, açık Ø92 arka flanş, gerçek panjur ve çene
    yarıkları; çıkış alanı 40,3 cm² (NACA girişi 21,7 cm², oran 1,86); koyu boşluk
    yalnız render ağı (U_Cowl_Cavity); motor bölmesi açıklığı 3B kontrol (≥ 5,3 mm).
    - R05 susturucu çıkışı stabilize/irtifa dümeninden 74,9 mm uzakta (Al kalkanlı).
    - Baskı: basılı gövde 3,457 kg (önceki 4,06); ince duvar kırpıntıları giderildi;
    ısı kuralı artık ihlalde çalıştırmayı durduruyor; parça-parça montaj çakışması 0.
    - Kapaklar dönüş dudaklı ve ince dişli; taret yakası 24 f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
    [aileron_1.stl, aileron_2.stl, aileron_3.stl, aileron_4.stl, cowl_cheek_L.stl, cowl_cheek_R.stl, cowl_top.stl, door_L_1.stl]
2026-10-04 ucav: hazır yk38.blend/.glb, --gpu seçeneği, yarım mechanisms önizlemesi
    - out/yk38.blend (Blender 4.5 LTS, zstd, 24,9 MB): rig, iki klip, klip seçici,
    baskı parçaları koleksiyonu; out/yk38.glb (9,7 MB) görüntüleyiciler için.
    .gitignore yalnız bu iki dosyaya izin verir.
    - build.py --gpu: Cycles'ı ekran kartında çalıştırır (OptiX → CUDA → HIP → Metal →
    oneAPI); bulamazsa CPU. studio.enable_gpu() + configure_cycles sahne işaretine
    uyar; 2 yeni test.
    - anim/mechanisms.mp4: render yarıda kesildi, 384 karenin ilk 300'ü (12,5 s);
    README yerelde GPU ile render adımlarını anlatıyor.
    - 214 test OK, sizing 163/163.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
2026-10-04 ucav: son inceleme düzeltmeleri — arayüz render'ı, Blender 5, egzoz geçişi, STL temizliği, kapak payı
    - yk38.blend arayüzden render'a hazır: hareket bulanıklığı, 1280×720 %100, 24 örnek, H.264 MP4;
    stüdyo ortamı ayrı koleksiyonda (UCAV_Env_Studyo + SW_Studyo); klip seçici klibin ortamını,
    pozlamasını, yer dolgusunu, kare aralığını ve çıktı önekini kurar
    - pervane pişirme betiği Blender 5'in katmanlı aksiyon API'siyle de çalışır (iki yol test edildi)
    - egzoz borusu sol yanaktan Ø24,4 mm delikle (6 mm radyal boşluk) ve ısıya dayanıklı geçiş
    halkasıyla geçer (BOM); ısı kuralı 3: hiçbir parça boruya 5 mm'den yakın değil
    - STL dışa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
    [aileron_1.stl, aileron_2.stl, aileron_3.stl, aileron_4.stl, cowl_cheek_L.stl, cowl_cheek_R.stl, cowl_top.stl, door_L_1.stl]
2026-10-05 ucav250: YK-250 çerçevesi — geometri çekirdeği, parça kaydı, denetimler, kütle, BOM, GA çizimi, montaj kılavuzu, Blender kurulumu
    - core/geom.py: kapalı ağ üreticileri (extrude, revolve, loft, kabuk), manifold3d boolean'ları, kütle özellikleri, ışınla et ölçümü
    - core/parts.py: Part/Joint/Fastener/Registry sözleşmesi, ayna parça, hareket dizileri
    - analysis/checks.py: ağ, durağan ve taramalı girişim, açıklık, kalınlık, kenar mesafesi/adım, bağlantı grafiği
    - analysis/mass.py, outputs/{bom,drawings,assembly_guide}.py, blender/build.py (sürücüler, patlatılmış görünüm, Workbench önizleme)
    - ARCHITECTURE.md modül sözleşmesi; setup_env.sh (Mesa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
2026-10-05 ucav250: OML değerlendiricileri (süperelips gövde, profilli taşıyıcı yüzeyler) ve ortak menteşe/servo/bağlantı üreticileri
    - design/oml.py: istasyon tablosundan gövde yüzeyi (yuvarlak burun/kuyruk kapanışı), panel ızgarası ve dış normal; Selig/NACA profiller, sonlu firar kenarı, diedral/V-kuyruk/dikey kesitler, OAK (MAC)
    - design/actuation.py: çatallı menteşe braketi, dil braketi, pim, servo gövdesi, kol, kumanda boynuzu, rot başlı itme çubuğu, dört çubuk kinematiği
    - geom: manifold3d dizileri kopyalanarak aktarılır; ortak köşeli değme yanlış pozitifleri ayıklanır; birleşimlerde bindirme kuralı
    - testler: OML ve tahrik üreticileri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
2026-10-05 ucav250: bağlantı elemanı üreticisi (ISO 4762/7380/4017, pul, nyloc, somun plakası, insert, çeyrek tur) ve yapısal el hesabı kütüphanesi
    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
2026-10-05 ucav250: aero/performance and stability hand-calc libraries, engine research data
    aerolib: ISA, skin friction/form factors, Oswald (Nita-Scholz, Raymer),
    lift slope, piston power lapse, propeller efficiency, Breguet, field length.
    stablib: tail volumes, V-tail projection, downwash, fuselage Cm_alpha,
    neutral point, static margin, directional derivatives.
    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
    [engine.yaml]
2026-10-05 ucav250: fuselage stations accept optional top_frac (asymmetric chined sections)
    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
2026-10-05 ucav250: structural generators (ribs, region lofts, round-nose control surfaces with cove, bulkheads, ring frames, skin panels); fix twist sign
    LiftingSurface gains span-coordinate access (loop_at/frame_at/chord_at) that
    is exact on the ruled loft, so ribs and skins fit the OML. Positive twist now
    means leading edge up (more incidence) as documented.
    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
    [oml.py, structgen.py]
2026-10-05 ucav250: research data — comparable UAVs (statistics and recommended ranges)
    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
2026-10-05 ucav250: research data — standards, aero (airfoils, polars, propeller), components, materials
    Intermediate commit while the research synthesis is still running.
    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
2026-10-05 ucav250: research phase complete — baseline synthesis and Turkish research report (docs/01_arastirma.md)
    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
2026-10-05 ucav250: concept study 'endurance' (MALE pusher, V-tail, AR 15) — calc, 3-view, notes
    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
2026-10-05 ucav250: joint helpers (bolt/bolt_through/pin/quarter_turn) with lazy hole cutting; geometry-based edge-distance and pierce checks
    - Part.holes / add_hole: cutters subtracted lazily from the base mesh; mirror_part
    copies holes and keeps fastener grip/washer flags (were dropped before).
    - joints.py: ISO preferred lengths, grip from a measured stack, nyloc/nutplate/
    flush potted insert/tapped/quarter-turn, holes in every clamped part.
    - checks.check_fasteners: edge distance measured on the mesh when no outline is
    given, and a 'fastener_miss' violation when a fastener does not pierce a part.
    - geom.ray_hits + wall_thickness_samples use the per-ray manifold3d API (the batch
    call never wo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
2026-10-05 ucav250: --modules/--focus filters for checks and Blender previews; producer module pattern in the contract
    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
2026-10-05 ucav250: concept study 'identity' — work in progress (agent still running)
    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
2026-10-05 ucav250: conventional reference concepts (identity, production complete; blended partial) — superseded by the v2 design-direction study
    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
2026-10-05 ucav250: v2 design-direction study — MANTA (BWB), OK (canard pusher), HALKA (box wing), HANCER (chined body + ducted fan); Workbench renders and preliminary numbers
    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
2026-10-08 ucav250: HANCER sizing v1 — spec.yaml, sizing.py, doc 02, figures (WIP: verifier findings partly applied; R-02 endurance currently 9.59 h < 10 h)
    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
2026-10-09 ucav250: HANCER sizing — three fix/verify rounds (F1-F19, V1, V2 findings); WIP before the payload-endurance requirement decision
    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
    [components.yaml, spec.yaml]
2026-10-09 ucav250: HANCER sizing closed — payload-endurance requirement decision (design payload derived, 18 kg >= 10 h; 20 kg >= 9.5 h), V3/V4 findings fixed; 61/61 requirements, 96 tests
    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
    [spec.yaml]
2026-10-09 ucav250: layout phase WIP — spec.layout interfaces, layout_check.py (60/60), builder scripts rescued from scratch after a container restart
    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
2026-10-09 ucav250: layout + structures phase WIP — layout, structures, fix round 1 done; fix round 2 interrupted by a container restart
    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
    [b_assembly.py, b_chassis.py, b_common.py, b_loads.py, b_mech.py, b_shell.py, b_stations.py, b_systems.py]
2026-10-09 ucav250: automatic WIP checkpoint (layout + structures fix loop running)
    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
    [b_chassis.py, b_stations.py, b_systems.py, spec.yaml]
2026-10-10 ucav250: layout + structures phase closed — spec.layout interfaces (99/99 layout checks), structures hand calcs (300 margins >= 0), 62/62 requirements, 195 tests; docs 03/04
    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
2026-10-10 ucav250: checks — declared contacts must physically touch; attachment graph uses only real links (fasteners, touching contacts/parents)
    Closes the loophole the chassis verifier found: contacts or parents that do not
    exist in the geometry whitelisted overlaps and faked load paths.
    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
2026-10-10 ucav250: WIP checkpoint (chassis fix in progress)
    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
    [chassis.py]
2026-10-10 ucav250: WIP checkpoint (wing/tail detailed design in progress; chassis fix verified)
    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
    [tail.py, wing.py]
2026-10-10 ucav250: WIP checkpoint (wing/tail producers in progress before container restart)
    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
2026-11-13 ucav250: WIP checkpoint (gear/systems producers in progress)
    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
2026-11-13 ucav250: WIP checkpoint (systems/payload producers and gear mechanism study in progress)
    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
2026-11-13 ucav250: WIP checkpoint (gear mechanism study in progress)
    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
2026-11-13 ucav250: WIP checkpoint (gear mechanisms, systems, payload in progress before restart)
    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
2026-11-13 ucav250: WIP checkpoint (payload producer, gear mechanisms and systems in progress)
    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
